merlinwwu/voltra-i-ref-3d/downloads/interference_report.md

# VOLTRA I 独立参考设计 — 干涉 / 运动 / 强度校核报告（CAD-v03，DOC-VER-05）

> 独立参考设计，非原厂数据；尺寸未经实测。设计载荷 F = 785 N（80 kgf），R = 25 mm，T = 19.62 N·m。

## 1. 静态干涉（网格预筛 + BRep 布尔求交）

- 零件 93，包围盒相交对 413，命中 0，其中意外 **0**。
- 螺钉杆部按底孔径建模，螺纹不计干涉；螺旋件（卷筒、绳、蜗杆）只做网格级，阈值 5 mm³。

## 2. 运动包络（摆座 + 导线臂 + 蜗轮扇形绕摆轴旋转；卷筒转角）

- 工况：摆座 θ=-41.9°、摆座 θ=-30.0°、摆座 θ=-15.0°、摆座 θ=+0.0°、摆座 θ=+15.0°、摆座 θ=+30.0°、摆座 θ=+41.9°、摆座越程 θ=-44.4°（限位触发后 1°）、摆座越程 θ=+44.4°（限位触发后 1°）、卷筒转角 60°、卷筒转角 120°、卷筒转角 180°、卷筒转角 240°、卷筒转角 300°
- 接触 2 处，意外 **0** 处。
  - 摆座越程 θ=-44.4°（限位触发后 1°）：EXIT-SWV-01 / LW-LIMIT-01 0.73 mm³ — 限位凸块压入开关（触发后再越程 1°，开关模型为含杠杆的包络）
  - 摆座越程 θ=+44.4°（限位触发后 1°）：EXIT-SWV-01 / LW-LIMIT-01 0.73 mm³ — 限位凸块压入开关（触发后再越程 1°，开关模型为含杠杆的包络）

## 3. 摆动排线运动学（lw_swing.json）

- 卷筒 R25，槽距 3.2，21 圈；工作 16.55 圈；摆轴 XO -2.82 / YO 46；臂长 Rs 38.98
- 传动 z35→z24（惰轮）→z21，i = 1.6667；蜗杆 m0.8 z1=1 d1=16（q=20）左旋，λ 2.862°；蜗轮 z120，a = 56；卷筒每转 5.000°；θ ±41.38°
- 同步误差最大 0.716 mm；偏角名义 1.15°，最坏 1.69°（恒定传动比下的正弦误差，不随行程累积；最坏值含对轮/绳间隙 0.3 mm）

| 卷筒圈 | 蜗杆圈 | θ (°) | 对轮 x | 槽 x | 误差 mm | 偏角 ° | 最坏 ° |
|---|---|---|---|---|---|---|---|
| 0 | 0.0 | -41.38 | -28.58 | -29.3 | 0.716 | 1.147 | 1.627 |
| 1 | 1.667 | -36.38 | -25.94 | -26.1 | 0.163 | 0.278 | 0.789 |
| 2 | 3.333 | -31.38 | -23.11 | -22.9 | -0.214 | 0.386 | 0.928 |
| 3 | 5.0 | -26.38 | -20.14 | -19.7 | -0.436 | 0.831 | 1.402 |
| 4 | 6.667 | -21.38 | -17.03 | -16.5 | -0.527 | 1.052 | 1.65 |
| 5 | 8.333 | -16.38 | -13.81 | -13.3 | -0.509 | 1.057 | 1.68 |
| 6 | 10.0 | -11.38 | -10.51 | -10.1 | -0.408 | 0.873 | 1.514 |
| 7 | 11.667 | -6.38 | -7.15 | -6.9 | -0.248 | 0.542 | 1.196 |
| 8 | 13.333 | -1.38 | -3.76 | -3.7 | -0.056 | 0.122 | 0.783 |
| 9 | 15.0 | 3.62 | -0.36 | -0.5 | 0.144 | 0.317 | 0.975 |
| 10 | 16.667 | 8.62 | 3.02 | 2.7 | 0.325 | 0.705 | 1.354 |
| 11 | 18.333 | 13.62 | 6.36 | 5.9 | 0.462 | 0.977 | 1.61 |
| 12 | 20.0 | 18.62 | 9.63 | 9.1 | 0.529 | 1.08 | 1.692 |
| 13 | 21.667 | 23.62 | 12.80 | 12.3 | 0.501 | 0.98 | 1.567 |
| 14 | 23.333 | 28.62 | 15.85 | 15.5 | 0.354 | 0.66 | 1.218 |
| 15 | 25.0 | 33.62 | 18.77 | 18.7 | 0.066 | 0.116 | 0.644 |
| 16 | 26.667 | 38.62 | 21.51 | 21.9 | -0.387 | 0.643 | 1.14 |
| 16.552 | 27.587 | 41.38 | 22.95 | 23.667 | -0.716 | 1.147 | 1.627 |

## 4. 强度 / 寿命 / 公差（strength.json）

FAIL = 0

| 组 | 项目 | 值 | 单位 | 许用 / 要求 | 结论 |
|---|---|---|---|---|---|
| 使用谱 | 卷筒平均转速 | 191.0 | rpm |  | — |
| 使用谱 | 10 年运动小时 | 1825.0 | h |  | — |
| 使用谱 | 10 年卷筒转数需求 | 20.913 | ×10⁶ 转 |  | — |
| 轴承 | BRG-01 最大径向力（出绳点 x=22.1） | 544.6 | N |  | — |
| 轴承 | BRG-03 最大径向力（出绳点 x=-30.9） | 624.7 | N |  | — |
| 轴承 | BRG-01 静载安全系数 s0 | 5.968 | - | ≥ 2 | ✅ |
| 轴承 | BRG-01 L10（P = 0.5·R01） | 12800.8 | ×10⁶ 转 | 需求 21×10⁶ | ✅ |
| 轴承 | 摆座下 6201 径向 Fr / 轴向 Fa=F | 847.2 | N |  | — |
| 轴承 | 摆座下 6201 s0 = C0/P0（C0 3.1 kN 按样本核对） | 3.441 | - | ≥ 2（摆动低速） | ✅ |
| 轴承 | 摆座上 6201 径向 Fr | 1529.9 | N |  | — |
| 轴承 | 摆座上 6201 s0 | 2.026 | - | ≥ 2 | ✅ |
| 轴承 | 蜗杆 626（固定端）轴向 Fa = Ft2 | 421.4 | N | ≤ 0.5·C0 = 475 | ✅ |
| 轴承 | 蜗杆 626 s0 = C0/(0.5·Fa)（C0 0.95 kN 按样本核对） | 4.509 | - | ≥ 2 | ✅ |
| 轴承 | 蜗杆 HK0608（浮动端）径向 | 103.6 | N | C0≈2.3 kN（按样本核对） | ✅ |
| 轴承 | 导向对轮 HK0608 径向 2F·sin(θm/2)；s0 | 4.146 | - | ≥ 1.5 | ✅ |
| 轴承 | 中心转向轮 HK0608 径向 √2·F；s0 | 2.072 | - | ≥ 1.5 | ✅ |
| 卷筒 | 单层缠绕接触压力 p = F/(R·p) | 9.812 | MPa |  | — |
| 卷筒 | 筒壁切向压应力（厚壁筒，Ø47/Ø36） | 47.483 | MPa | 6061-T6 σ0.2 240 → [σ] 120 | ✅ |
| 卷筒 | 卷筒弯曲应力（Ø47/Ø36） | 2.7 | MPa | < 80 | ✅ |
| 卷筒 | 锚固点残余张力 F·e^(−μ·2π·3)（μ=0.1） | 119.2 | N | 压线块 M3 预紧 ~2.6 kN × μ0.2 × 2 面 | ✅ |
| 轴 | MOT-SHAFT-01 花键根部等效应力 | 65.082 | MPa | 42CrMo4 调质 [σ]疲劳 120 | ✅ |
| 轴 | DIN 5480 W17×1.25×12 齿面压强（l 25，ψ 0.75） | 9.924 | MPa | [p] 30 | ✅ |
| 轴 | PIN-DRUM-01 剪切（4×Ø3，PCD32，全扭矩） | 43.381 | MPa | [τ] 80 | ✅ |
| 轴 | 转子毂 6×M4 摩擦传扭能力 | 64.26 | N·m | ≥ MF0095056 峰值 51 | ✅ |
| 排线 | 蜗杆导程角 λ（m0.8 z1 d1 16） | 2.862 | ° | < φ' 3.046°（μ0.05） | ✅ |
| 排线 | 静止自锁（μs ≥ 0.08）反驱效率 | -0.7 | - | < 0 自锁 | ✅ |
| 排线 | 蜗轮最大扭矩 T2（θ=θm，F 满载） | 20.228 | N·m |  | — |
| 排线 | 蜗轮齿根剪应力 τF ≈ Ft2/(b2·m)·0.75（DIN 3996 简化） | 39.507 | MPa | CuSn12 τFlim 92 / SF 1.5 = 61 | ✅ |
| 排线 | 蜗轮齿面 σHm（p*m=1，E_red 147 GPa） | 165.7 | MPa | CuSn12 σHlim 425 / SF 1.3 = 327 | ✅ |
| 排线 | 蜗杆驱动扭矩 | 0.349 | N·m |  | — |
| 排线 | 卷筒附加阻力矩（占 T） | 2.963 | % | < 8% | ✅ |
| 排线 | 正齿 m0.8 z35 Lewis（b4，Ft 42 N） | 35.078 | MPa | 40Cr 调质 [σF] 200 | ✅ |
| 排线 | 正齿 m0.8 z24 Lewis（b4，Ft 42 N） | 38.173 | MPa | 40Cr 调质 [σF] 200 | ✅ |
| 排线 | 正齿 m0.8 z21 Lewis（b4，Ft 42 N） | 39.33 | MPa | 40Cr 调质 [σF] 200 | ✅ |
| 排线 | 蜗杆挠度（等效 Ø10，跨 59.8） | 0.006 | mm | ≤ 0.01·m = 0.008 | ✅ |
| 排线 | 惰轮烧结铜套 pv（Ø5×4，1.2 kW 转速） | 0.926 | MPa·m/s | ≤ 1.8 | ✅ |
| 排线 | PIN-LWG-01 Ø1.5 弹性销双剪 | 34.635 | MPa | [τ] 300 | ✅ |
| 排线 | 同步误差（全行程最大） | 0.716 | mm | < 1.0 | ✅ |
| 排线 | 偏角（名义 / 最坏含 0.3 间隙） | 1.693 | ° | ≤ 2° | ✅ |
| 出线 | EXIT-PIN-01 Ø12 悬臂根部弯曲 | 115.9 | MPa | 42CrMo4 调质 [σ] 250 | ✅ |
| 出线 | LW-BRIDGE-01 7075 20×12 等效应力（外拉 F + 力矩） | 64.635 | MPa | 7075-T6 [σ] 150 | ✅ |
| 出线 | 桥架 Z 向挠度 | 0.079 | mm | < 0.2 | ✅ |
| 出线 | 蜗杆副中心距受载变化（桥架 + 销） | 0.036 | mm | < 侧隙 0.08 | ✅ |
| 出线 | LW-PIN-01 Ø6 悬臂弯曲（臂 4.5，2F·sin(θ/2)） | 117.7 | MPa | GCr15 淬硬 [σ] 400 | ✅ |
| 出线 | EXIT-AXL-01 Ø6 弯曲（跨 11.5，√2F） | 150.5 | MPa | GCr15 淬硬 [σ] 400 | ✅ |
| 出线 | 摆座毂底挡肩剪切（Ø27×0.8，外拉 F） | 11.568 | MPa | 7075-T6 [τ] 120 | ✅ |
| 出线 | 桥架 M4 ×2 + 销 单颗拉力（外拉 F 分配 0.6） | 471.0 | N | M4 10.9 保证载荷 7.8 kN | ✅ |
| 出线 | 蜗杆箱 2×M3 剪力（Ft2 轴向） | 210.7 | N | M3 8.8 + 定位销 | ✅ |
| 绳 | 卷筒 D/d | 16.667 | - |  | — |
| 绳 | 导向对轮 D/d | 4.333 | - |  | — |
| 绳 | 中心转向轮 D/d | 4.867 | - |  | — |
| 绳 | 安全系数（MBL 9 kN 典型 × 0.65 / F） | 7.452 | - | ≥ 5 | ✅ |
| 电机 | T = F·r（+20% 余量） | 23.55 | N·m | MF0095056 峰值降额 38.25 | ✅ |
| 电机 | 满力电流 / 铜损 | 57.721 | A |  | — |
| 电机 | 绕组温度（严格口径） | 98.292 | °C | ≤ 130（F 级降额） | ✅ |
| 电机 | 1 m/s / 1.2 kW 转速 | 382.0 | rpm |  | — |
| 公差 | 蜗杆副中心距 56 链（框架/MOT-HSG 销定位 ±0.02×2 + 桥架 ±0.02 + 箱 ±0.01） | 0.07 | mm | RSS ≈ 0.035；装配后测侧隙 0.05–0.12 | ✅ |
| 公差 | 卷筒+轴热伸长（ΔT 40 K） | 0.099 | mm | BRG-03 浮动 −1/+0.5 | ✅ |
