merlinwwu/voltra-i-ref-3d/downloads/docs/gap-list.md

# VOLTRA I 参考设计 CAD-v03 —— 可加工 / 可装配 / 可工作 缺口清单（gap-list）

版本：DOC-VER-05 / CAD-v03 · 2026-10-20（Asia/Shanghai）
用户决定更新：2026-10-23 · D2–D8 全收 A（见 §0）

状态说明：✅ 已在 v03 中解决 · ◐ 已按假设值处理，需要实测或供应商数据确认 · ⛔ 需要用户决定

数据来源：
- `site/downloads/strength.json`：58 项校核，FAIL 0；
- `out/interference.json`：93 个零件，包围盒相交 413 对，干涉 0（齿轮啮合、花键等设计接触都低于网格阈值）；
- `out/motion_check.json`：14 个工况（摆座 ±41.9°/±30°/±15°/0°、越程 ±44.4°、卷筒 5 个转角），接触 2 处（都是越程 1° 后压入限位开关，属预期），意外 0；
- `out/lw_swing.json`（摆动排线运动学）、`out/motor_check.json`（电机复核）、`docs/patent-review.md`。

标"假设"的数值都没有经过实测，不是原厂数据。v02 版本备份：`gap-list_v02.md`。

## §0 用户决定（D）和未知项（U）

| # | 事项 | 现状（v03） | 选项 / 状态 |
|---|---|---|---|
| **D1** | 排线方式 | ✅ **已定（用户，2026-10-20）**：自锁蜗杆 + 摆动蜗轮扇形，按 CN122233236A 摆动式。用户的理由是出线口到卷筒接触点的距离基本不变。卷筒 R20 → **R25** 单层，撤回滑动小车和 Tr10×2 丝杠。 | 已关闭 |
| **D2** | 出线罩凸出包络 4.5 mm | ✅ **已定（用户，2026-10-23）**：接受凸出 4.5 mm（EXIT-UNI-01 Ø23 罩环 + 喇叭口） | 已关闭 · A |
| **D3** | 机外出绳 | ✅ **已定（用户，2026-10-23）**：保持固定抛光不锈钢喇叭口 | 已关闭 · A |
| **D4** | 断电抱死 | ✅ **已定（用户，2026-10-23）**：不加失电制动器；蜗杆自锁只锁摆座，不锁卷筒 | 已关闭 · A |
| **D5** | 角度传感 | ✅ **已定（用户，2026-10-23）**：卷筒磁编码（单圈绝对 + 软件多圈）；摆座磁环 + 霍尔作冗余 | 已关闭 · A |
| **D6** | 电池电流 | ✅ **已定（用户，2026-10-23）**：按 1.2 kW / 每组 ≤ 60 s；1.2 kW 时约 46.7 A，BAT-CONN ≥ 50 A | 已关闭 · A |
| **D7** | 卷筒半径和电机组合 | ✅ **已定（用户，2026-10-23）**：保持 R25 + MF0095056（偏角最坏 1.69°，严格口径 98 °C；已建模）。不采用 R23 + 044 | 已关闭 · A |
| **D8** | 运行中的自锁 | ✅ **已定（用户，2026-10-23）**：接受 μ ≥ 0.05 自锁条件（λ 2.86°）；不因跑合后 μ 可能下降而改 d1 | 已关闭 · A |
| 转向轮 Ø26 | 中心转向轮 D/d 4.9 | 槽底 Ø14.6，**暂按现状** | ⛔ 待定：加大到 Ø26 时 D/d 为 8.7，摆座叉板要加大约 6 mm（v02 估算），与 D2 联动 |
| **U1** | 未公开的 US 19/xxx 申请 | 无法审查 | 公开后补审 |
| **U2** | 供应商数据 | 绳 MBL 9 kN 是典型值；HK0608 / 626 / 6201 的 C0 需按样本核对；MOD-UNK-01 的功能和尺寸未知（v03 为桥架让位，暂减薄到 z −31..−11） | 拿到样本后重新计算 |
| **U3** | Dock 立柱几何 | 假设值 | 需要实测 |
| **U4（新）** | 霍尔 IC 和微动开关型号 | LW-HALL-01、LW-LIMIT-01 都是占位 | 需要选型（超小型微动开关，行程 ≥ 1 mm） |

## §1 材料、工艺、配合、形位公差、粗糙度 ✅
- 自制件都有 A3 图纸：`site/downloads/drawings/<ID>.pdf/.dxf`，合订本 `VOLTRA-I-REF_工程图_合订_CAD-v03.pdf`（40 张）。v03 新增或重画的图：LW-WORM-01、LW-WHEEL-01、LW-ARM-01、LW-BOX-01、LW-BRIDGE-01、EXIT-SWV-01、EXIT-PIN-01、LW-GEAR-01、LW-IDL-01、LW-IDL-PIN-01、LW-ROL-01、LW-PIN-01、EXIT-SHV-01、EXIT-AXL-01、LW-SPC-01、EXIT-BASE-01、EXIT-GUIDE-01、EXIT-UNI-01、DRUM-01、DRUM-HUB-01、MOT-HSG-01。
- 新增主要配合（设计值）：

| 位置 | 配合 |
|---|---|
| 蜗杆副 | m0.8 z1/z120（扇形 ±47°），a = 56 ±0.03，8 级（DIN 3974），侧隙 0.05–0.12 |
| 蜗杆轴颈 | 左端 Ø6 h5（HK0608，淬硬 ≥ 58 HRC）；右端 Ø6 k5（626） |
| 626 座 | Ø19 通孔 H7，两侧 DIN 472-19 |
| 摆轴销 | Ø12 p6（桥架）/ k5（2×6201） |
| 摆座毂 | Ø32 K6，底部挡肩 Ø27 |
| 对轮销 | Ø6 p6（臂）/ h5（滚针） |
| 惰轮 | 销 Ø5 p6 压入电机壳；衬套 Ø5 F7 / Ø8 s7 |

- 材料：
  - 蜗杆：20CrMnTi 渗碳淬火 58–62 HRC，齿面磨削；
  - 蜗轮扇形：CuSn12；
  - 摆座 / 导线臂 / 桥架：7075-T6；
  - 蜗杆箱：6061-T6，两轴承孔一次装夹加工；
  - 对轮：440C；
  - 其余同 v02。

## §2 紧固件 ✅
v02 的条目保留（M5 中心螺钉、转子毂 6×M4、贯穿螺栓、BRG-03-HSG、底板、左端盖、压线块），v03 新增：

| 部位 | 规格 | 扭矩 | 备注 |
|---|---|---|---|
| 蜗杆箱 · 隔板侧 | 2×M3×12 ISO 10642 + Ø3 销 | 1.1 N·m | 旋合 6 |
| 蜗杆箱 · 电机壳侧 | 2×M3×8 ISO 4762 + 243 胶 | 1.1 N·m | ◐ 电机壳端壁 4 mm，钢丝螺套需要局部凸台 4.5 |
| 导线臂 → 摆座 | 4×M3 ISO 10642 + 243 胶 | 1.2 N·m | — |
| 蜗轮扇形 → 导线臂 | 4×M3×6 ISO 10642 + 243 胶 | 1.0 N·m | 钢丝螺套 |
| 桥架 | M4×14 + Ø3 销 / Ø6 止口销 | 2.6 N·m | 外拉 F 分配后单颗约 471 N ≪ 7.8 kN |
| 齿轮横销 | Ø1.5×10 ISO 8752 | — | τ 35 MPa |

清单见 `BOM_VOLTRA-I-REF_CAD-v03.csv`。

## §3 挡圈和密封 ✅
v03 新增的挡圈：
- DIN 472-19 ×2：626 外圈两侧；
- DIN 471-6：z21 齿轮；
- DIN 471-12：摆轴销顶；
- DIN 6799：对轮销和转向轮轴。

撤回的挡圈：丝杠 6000 的 472-26 / 471-10，以及 61804 的 471-20 / 472-32。密封同 v02。

## §4 绳路 ◐
- 绳路：卷筒顶点 z = R = 25 → 沿 +Y 进入两只导向对轮（Ø13，间隙 3.3）→ 在内侧对轮上转过 θ → 沿导线臂到中心转向轮（槽底 Ø14.6）→ 转 90° 沿摆轴上行 → 喇叭口 → 绳头。
- 出线口到卷筒接触点的距离基本不变：摆座绕出线口轴线转动。
- D/d：
  - 卷筒 16.7（v02 为 13.3）；
  - 导向对轮 4.3：包角 ≤ θ，最大 41°，满载径向 555 N；
  - 中心转向轮 4.9：包角 90°，满载。
  - 结论：能工作，但中心转向轮是主要疲劳点，绳定为可换件。可选项见 §0 的"转向轮 Ø26"。
- 喇叭口：喉部 Ø5，出口 R ≥ 6，Ra0.1。

## §5 排线同步、自锁、端部 ✅
- 运动链：卷筒 1 转 → z35 → z24（惰轮）→ z21 → 蜗杆 1.667 转 → 蜗轮 z120 → 摆角 5.000° → 对轮横向位置 x = XO + Rs·sin θ（Rs 38.98）。
- 行程：16.55 个工作圈，θ 从 −41.38° 到 +41.38°。全放出对应 −41.4°，全收绳对应 +41.4°。
- 同步误差：全行程最大 0.716 mm，为正弦误差，不累积。偏角名义 1.15°，最坏 1.69°（含 0.3 mm 间隙），满足 ≤ 2°。
- 自锁：λ 2.862° < φ'（μ0.05 时 3.046°），正向效率 0.48，静止时反驱效率 < 0。运行中的风险见 D8。
- 端部：
  - 两只限位开关在 ±43.4° 触发（工作 ±41.4°）；
  - 软件按卷筒编码器和霍尔摆角做双重限位；
  - 绳的两端（全收和全放）本身就限定了卷筒转角，所以正常情况下摆座不会超程。
- 侧隙和中心距：a = 56 由隔板、电机壳和桥架的销定位链保证，RSS 约 ±0.035。满载时桥架和摆轴销变形会让中心距变化约 0.036 mm，小于侧隙 0.08。

## §6 绳端锚固 ✅
同 v02。3 圈死圈，锚固点张力 119 N。

## §7 装配顺序和工具通道 ✅
详见 `docs/assembly-sequence.md`（v03）。要点：
- 惰轮销要在卷筒之前压入；
- 卷筒推入花键时，z35 沿轴向进入和惰轮的啮合；
- 定相：全放出 ↔ θ = −41.4°，蜗杆箱最后沿 −Z 落入，惰轮相位误差 ≤ 0.07°；
- 装好后测侧隙。

## §8 布线和散热 ◐
- 新增 LW-HALL-01 和 2×LW-LIMIT-01 的线束，沿桥架下表面走到 PCB 仓。
- 电机改为 MF0095056（叠长 55.2）后，铜损从 1744 W 降到 1070 W（满力），RMS 绕组温升按严格口径为 98 °C。
- 其余同 v02。◐ 没有做 CFD。

## §9 制动电阻、电池 Dock、把手和绳头 ◐
同 v02。

## §10 壳体分型和拔模 ✅
同 v02。v03 增加两处让位：
- 上下壳前壁内侧，626 座处有 R11.6 局部沉台，深 0.9；
- 电机壳端面有 Ø11 深 1.6 的蜗杆轴端沉孔。

## §11 公差链 ✅
- 卷筒挡边间隙、热伸长：同 v02。
- 蜗杆副中心距链：见 §5。
- 摆角定相：惰轮相位误差最多半齿，对应 ≤ 0.07°。

## §12 寿命和强度（摘自 strength.json）✅

| 项 | 结果 | 许用 / 要求 |
|---|---|---|
| BRG-01 | s0 5.97 | — |
| 摆座下 6201 | s0 3.44 | — |
| 摆座上 6201 | s0 2.03 | ≥ 2 |
| 626 | 轴向 421 N，s0 4.5 | — |
| 导向对轮 HK0608 | s0 4.1 | ◐ C0 待按样本核对 |
| 中心转向轮 HK0608 | s0 2.07 | ◐ C0 待按样本核对 |
| 蜗轮齿根 τF | 39.5 MPa | 61 |
| 蜗轮齿面 σHm | 166 MPa | 327 |
| 正齿轮 Lewis 应力 | 35–39 MPa | 200 |
| 蜗杆挠度 | 0.006 mm | 0.008 |
| 惰轮衬套 pv | 0.93 | 1.8 |
| 摆轴销 Ø12 | 116 MPa | 250 |
| 桥架 | 65 MPa | 150 |
| 桥架挠度 | 0.079 mm | — |
| 对轮销 | 118 MPa | — |
| 转向轮轴 | 151 MPa | 400 |
| 花键 | 9.9 MPa | — |
| 轴 | 65 MPa | — |
| 传扭销 Ø3 | 43 MPa | 80 |
| 卷筒筒壁 | 47 MPa | 120 |
| 绳 | SF 7.45 | ◐ MBL 待供应商确认 |
| 电机 MF0095056 | 23.55 N·m（+20%） | 峰值降额 38.25 |

## §13 质量
- 整机 6.41 kg，不含绳头；官方为 5.8 kg；v02 为 6.02 kg。
- 增加的部分：
  - 电机 044 → 056：+0.39 kg；
  - 卷筒加大到 R25；
  - 蜗杆箱、摆座、6201、蜗轮扇形等。
- 减重方向：
  - MOT-HSG 和 HSG-END-R 改为压铸，约 −0.2 kg；
  - 蜗轮扇形腹板进一步开窗；
  - D7-B（R23 + 044，约 −0.4 kg）已于 2026-10-23 否决，不采用。

## §14 v03 相对 v02 的修改
1. 排线：滑动小车 → 自锁蜗杆 + 摆动蜗轮扇形（D1）。删除 LW-SCREW / LW-NUT / LW-CAR / LW-ROD / LW-END-L 等零件，新增 LW-WORM / LW-WHEEL / LW-ARM / LW-BOX / LW-IDL / LW-HALL / LW-MAG 等。
2. 卷筒 R20 → R25，21 圈；传扭销 Ø4 → Ø3（PCD32，避让惰轮销头）。
3. 电机 MF0095044 → MF0095056（叠长 43.2 → 55.2），MOT-HSG 绕组腔加长。
4. 摆座：v02 的 61804 + 6000（经底板支承）改为桥架上的悬臂摆轴销 + 2×6201 紧贴。外拉力 F 不再经过底板。
5. 改为 6201：起初用的 2×6001 跨距只有 9，s0 只有 1.4，不满足。
6. 惰轮 z24：原本蜗杆轴齿轮会顶到前壁，所以加惰轮，并保证 z21 ≤ 21。
7. 蜗杆 d1 13 → 16：把自锁门槛从 μ 0.058 降到 μ 0.05。
8. 贯穿螺栓 (30, 40) → (57, 40)，为蜗轮扫掠让位。
9. 限位凸块改朝卷筒侧，桥架局部加宽，避开壳体内壁。
10. 壳体和电机壳增加局部让位（§10）。
11. 蜗轮扇形原来按实心扇形建模（165 g），改为齿圈 + 腹板 + 减重窗（约 47 g）。
12. 运动包络检查发现扇形扫到底板螺钉凸台：扇形 ±50° 改为 ±47°（在 ±43.4° 限位处，啮合区仍有约 1 齿余量），上面两颗底板螺钉外移到 (−52.5, 51) / (35.5, 51)。
13. 工程图：改用紧包围盒，修正非回转件高度尺寸显示错误（v02 图上非回转件的高度尺寸数值错误，例如 DOCK-HOOK-01 高 8 显示成 4000），所有图纸已重出。
