merlinwwu/voltra-i-ref-3d/downloads/docs/patent-review.md

# VOLTRA I 参考设计 · 相关专利逐份审查（DOC-VER-05 附件 A）

- 日期：2026-10-20（Asia/Shanghai）
- 范围：Google Patents 上申请人「深圳市齐昕动力科技有限公司 / Beyond Power」的公开文献，共 59 份（PDF/HTML 原文：`/workspace/pat/`；清洗后的全文：`docs/pattxt/*.txt`）。另查到 1 份 EP 分案，以及官网列出、但尚未公开的 US 申请（见 §3）。
- 证据优先级：拆机照片 > 官方规格 > 专利。专利只说明"原厂可能这样做"，不代表 VOLTRA I 量产件就是这样。
- 附图号、部件标号都取自专利说明书。本文不编造段落号：凡是没有核实到段落号的，只写「图 x / 部件 y」。
- "对照"一栏是和本参考设计 CAD-v03 的比较。✅ 表示已采纳或一致，◐ 表示部分采纳或有偏离，✖ 表示不采用（说明原因），— 表示与机械设计无关。

## 1. 机械相关专利：详细审查

### 1.1 排线（level-wind）—— CN220223097U（授权）、CN118529559A（待审）及其分案 CN122166625A / CN122233236A

| 项 | 内容 |
|---|---|
| 专利 | CN220223097U《排线绕线机构及出力设备》，公告日 2023-12-22，有效；CN118529559A 发明申请，公开日 2024-08-23，待审；分案 CN122166625A（滑动式，2026-06-09）、CN122233236A（摆动式，2026-06-19） |
| 子系统 | CAB / LW / EXIT |
| 关键机构 | **两种实施例。** 注：查原文权利要求，CN122166625A 的权利要求 1–9 要求的是滑座 + 光轴 + 自锁蜗杆（滑动式），CN122233236A 才是摆动式。v03 的摆动排线按 CN122233236A 设计，CN122166625A 中的「转动座 + 转向轮 + 沿转轴穿线通道」用于摆座内部。 ① 摆动式：摆座绕出线口摆动，带出线臂，用自锁蜗轮 510 + 蜗杆 530 驱动，摆角由霍尔/磁环检测，限位微动开关 102，出线处有导向对轮。CN122233236A 权利要求 2–5 写到：两根臂沿径向向外伸出，两臂间设导轮，并有限位框和对轮。② 滑动式（图 6–8）：滑座 321 在光轴 322 上经直线轴承 323 滑动，由自锁蜗杆螺母 520 驱动，滑座上有转动座 326 和转向轮 328/329，出线轮 710（其中一只带阻尼）。CN122166625A 的权利要求写到"转动座 + 第一/第二转向轮"。**同步关系：卷筒每转一圈，排线移动一个绳径。** |
| 对照（v03） | ✅ **采用摆动式（用户决定 D1，2026-10-20）**。用户的理由：摆动式的出线口到卷筒接触点的距离基本不变。对应关系如下：<br>• 摆座 EXIT-SWV-01 = 绕出线口轴线转动的摆座；导线臂 LW-ARM-01 + 导向对轮 LW-ROL-01 ×2 = 权利要求 2–5 的"臂 + 两臂间导轮 / 对轮"；<br>• 自锁蜗杆 LW-WORM-01（m0.8 z1 d1 16 左旋，λ 2.86°）= 蜗杆 530，蜗轮扇形 LW-WHEEL-01（CuSn12 z2 120，±47°）= 蜗轮 510，与摆座同心；<br>• 摆角检测用磁环 LW-MAG-01 + 线性霍尔板 LW-HALL-01；限位微动开关 LW-LIMIT-01 ×2 = 102；<br>• 绳经中心转向轮 EXIT-SHV-01 转 90° 后沿摆轴从出线口引出，所以出线口与卷筒的相对位置不随摆动变化。<br>**驱动链**：卷筒毂齿轮 z35 → 惰轮 z24 → 蜗杆轴齿轮 z21（i = 5/3）→ 蜗杆 → 蜗轮 z120。卷筒每转一圈，摆角变化 360°×(5/3)/120 = **5.000°**。<br>**行程**：卷筒 R25 单层缠绕，槽距 3.2，21 圈（16.55 个工作圈 + 3 圈死圈 + 余量），绳在卷筒上的轴向行程 53 mm。摆臂 Rs = 38.98，摆角 ±41.38°。<br>• 横向位置 x = XO + Rs·sin θ，是正弦关系，而绳槽是线性的，所以同步误差为正弦误差，**不随行程累积**：全行程最大 0.72 mm，偏角名义 1.15°，最坏 1.69°（计入 0.3 mm 对轮间隙）。<br>• ◐ 专利写"每转 1 个绳径"，本设计取 1.07d（3.2 mm）。<br>**为什么卷筒 R 从 20 加到 25**：在 139×100 截面内，摆轴位置 YO 受壳体内壁和卷筒挡边限制。扫描 R = 20–27（`cad/lw_swing.py`），最坏偏角分别为：R20 不可行，R21 2.36°，R22 2.14°，R23 1.97°，R24 1.80°，R25 1.68°，R26 1.57°，R27 在 YO 允许范围内不可行。R23 是 ≤2° 的最小值，但没有余量，所以取 **R25**。v02 的结论"摆动式不可行"是在 R20 单层前提下得出的，现在已不成立。<br>**自锁**：λ 2.862° < φ'（μ0.05 时 3.046°），所以 μ ≥ 0.05 时能自锁。静止时 μs ≈ 0.08–0.10，反驱效率 −0.70 ~ −1.12，能可靠自锁。◐ 运行中如果跑合良好、μ 降到 0.03，就不再自锁（反驱效率 +0.36）。这不影响同步，因为同步靠齿轮正传动，不依赖自锁。<br>**载荷**：满载时 T2 = 20.2 N·m，Ft2 = 421 N，蜗杆扭矩 0.35 N·m，卷筒附加阻力 2.96%。蜗轮齿根 τF 39.5 MPa（许用 61），齿面 σHm 166 MPa（许用 327）。 |
| 结论 | **摆动式可加工、可装配、可工作**，校核见 `strength.json`（FAIL 0）、`interference.json`、`motion_check.json`。代价：<br>• 卷筒加大到 R25 后扭矩增加 25%，电机从 MF0095044 改为 MF0095056（见设计文档 §4）；<br>• 整机变重，质量见 gap-list §13；<br>• 照片 01/02 中的"黑色摆环 + 白色蜗轮扇形"与本方案一致。 |

### 1.2 万向出线 —— CN220213802U（授权）

| 项 | 内容 |
|---|---|
| 专利 | CN220213802U《万向出线机构及出力设备》，公告日 2023-12-22，有效 |
| 子系统 | EXIT |
| 关键机构 | 底座 + 经轴承转动的旋转座 + 成对出线轮 + 条形抛光金属导线块（喇叭状张开），出线方向可以随拉绳方向转动。 |
| 对照 | ◐ 机内部分：旋转座 = EXIT-SWV-01。v03 中它同时是排线摆座：2×6201 紧贴装在桥架摆轴销 Ø12 上，绳在座内经中心转向轮 90° 转向后沿转轴引出。已采纳。◐ 机外部分：用整圈抛光不锈钢喇叭口 EXIT-GUIDE-01（R ≥ 6，Ra0.1）代替"旋转对轮 + 导线块"。原因：前板厚度和包络里放不下第二套旋转轴承。代价是侧拉时绳在喇叭口上滑动，磨损更大，所以把绳定为可换件（官方本来就支持换绳）。可以升级为专利式结构，见 D3。 |
| 结论 | 可工作；出线罩比包络凸出 4.5 mm（照片 05 中原机的白罩也是凸出的），见 D2。 |

### 1.3 卷筒散热结构 —— CN220327890U（授权）

| 项 | 内容 |
|---|---|
| 关键机构 | 绕线轮 = 塑料内芯 + 导热更高的金属外壳；两者用轴向筋/槽传扭；内芯与外壳之间留散热通道。 |
| 对照 | ◐ 本设计的卷筒整体用 6061-T6 铝，并做硬质阳极。理由：单层缠绕时箍压应力约 45 MPa，塑料内芯会蠕变。卷筒中段做了 Ø26 减重孔，可兼作风道。没有采用双材料结构，因为零件更少、同轴度更容易保证。 |
| 结论 | 一致性：部分一致。可加工（车削 + 螺纹车槽，或旋风铣槽）。 |

### 1.4 绳端锚固 —— CN220596688U（授权）、CN220906831U（授权）

| 项 | 内容 |
|---|---|
| CN220596688U | 卷筒端部设固线位，压线块装在里面；压线块有弧形压槽和交错压齿，用螺钉锁紧。 |
| CN220906831U | 弧形绕线盘上开多个穿线孔/通道，供绳端编织穿插，外加保护盖。 |
| 对照 | ✅ 左挡边外侧开 10×13.5×4.5 凹槽；绳经 Ø3.4 轴向孔从槽底进入凹槽，由 DRUM-CLAMP-01 压线块 + M3 沉头螺钉压紧。另留 3 圈死圈：按绞盘公式 e^(−μθ)，μ = 0.1、θ = 6π，锚固点只受约 15% 的绳力，约 120 N。✖ 编织穿孔方案（CN220906831U）没有采用，因为它更适合大直径盘。 |
| 结论 | 可加工、可装配（换绳时取下电池仓盖，从卷筒仓前窗口就能拧到压线块螺钉）。 |

### 1.5 绳头挂钩 —— CN220668264U（授权）

| 关键机构 | 绳钩绕线架带卡口，绳绕上后卡住，外有壳体。 |
|---|---|
| 对照 | ✅ CONN-01：Ø36 绕线架 + 4 个卡口 + 挂环（示意）。官方外形量级约 40.9×40.9×62。 |

### 1.6 制动电阻 —— CN220530583U（授权）

| 关键机构 | 电阻板经导热垫贴在壳板上，带温度传感器和快插接头。 |
|---|---|
| 对照 | ✅ BRK-R-01 经 1 mm 导热垫 BRK-PAD-01 贴在下壳底壁，2×M4 螺钉固定在底壁加厚凸台上；NTC 为 BRK-TEMP-01。阻值和功率在设计文档中按 60 V 母线计算。 |

### 1.7 电机 / 传感 / 连接排 —— CN222484497U、CN219893049U / CN118539645A / CN122437294A

| 专利 | 内容 | 对照 |
|---|---|---|
| CN222484497U（授权 2025-02-14） | 电感式双转子多圈角度传感器 | ◐ 本设计用磁环 ENC-MAG-01 + 磁编码读头 ENC-PCB-01，单圈绝对；多圈和出绳长度由软件累计并上电回零。可升级，见 D5。 |
| CN219893049U（授权）/ CN118539645A / CN122437294A | 电机连接排（汇流排）把三相引线引到驱动板 | ◐ 本设计用相线 + 硅胶护套 MOT-GROM-01，经电机壳 Ø8 孔进入卷筒仓，再到 PCB。没有做汇流排。是否做汇流排对机械可行性没有影响。 |

### 1.8 整机架构 —— WO2024175034A1 / CN220173005U / CN118539661A / CN122437301A / EP4672567A1（含 EP 分案）

| 项 | 内容 |
|---|---|
| 关键机构 | 线盒居中，电机和电池分别固定在线盒两侧；线盒后侧通过连接结构接基座（Dock），绳从前侧引出；解锁要同时满足电机侧和电池侧两个触发条件；有 PCB 和快插接头。WO 说明书还写到：塑料内芯 + 花键 573、转子环腔内的被动风扇、转子轴上的磁环 570、子电机可串联（花键串轴）、圆柱电芯 + 支撑杆 + 弹性导热垫的电池、电阻结构，以及断电抱死（抱死臂 + 自锁蜗杆）。 |
| 对照 | ✅ 布局一致：电池（左）| 隔板 | 卷筒仓 | 电机（右）；前面出绳，背面 Dock，PCB 在背侧。✅ 转子毂腹板上集成 8 叶被动风扇（ROT-HUB-01）。✅ 磁环在转子轴上。✅ 用花键传扭（DIN 5480）。◐ **没有做断电抱死**。制动由电机短接 + 制动电阻完成；断电时丝杠能自锁，但卷筒不能自锁。见 D4。◐ 串联子电机不适用（单电机）。 |

### 1.9 Dock 接口 —— CN219733908U（授权）/ CN118532387A / CN122407665A

| 关键机构 | 插槽外侧设枢转卡钩，卡入立柱上的限位槽；设备相对立柱转动时，导向斜面把卡钩推开，从而解锁。 |
|---|---|
| 对照 | ✅ DOCK-IF-01：插槽 Ø40 H8。DOCK-HOOK-01：卡钩在 Ø3 销上枢转，扭簧复位，钩舌伸进插槽 1.4 mm。SMART-LOCK-01：执行器占位。法兰 Ø94×4 贴在壳体内壁上承压，785 N 由法兰压壳传递，不靠螺钉受拉。◐ 立柱侧的几何、导向斜面角度、扭簧参数都没有公开数据，列为未知项 U3。 |

### 1.10 电池 / 底板 —— CN220086216U、CN220778963U

| 专利 | 内容 | 对照 |
|---|---|---|
| CN220086216U（授权） | 电池壳卡扣 + 弹性导热垫 | ◐ 电池包按官方外形 94×94×89 做外购定制件，内部结构不建模；接口为 BAT-CONN-01 + 4×M4 沉头端盖。 |
| CN220778963U（授权） | 健身底板 + 快拆底座 | — 属于配件，不在主机 CAD 范围内。 |

## 2. 全部 59 份公开文献：逐份一行结论

| # | 公开号 | 名称（中译） | 公开/公告日 | 状态 | 子系统 | 一行结论 |
|---|---|---|---|---|---|---|
| 1 | CN220223097U | 排线绕线机构及出力设备 | 2023-12-22 | 有效 | LW | ✅ v03 采用摆动式实施例（自锁蜗杆 + 蜗轮 + 摆座）；滑动式为 v02 方案，已撤回 |
| 2 | CN118529559A | 排线绕线机构及出力设备 | 2024-08-23 | 待审 | LW | ✅ 同上，发明申请版 |
| 3 | CN122166625A | 排线绕线机构及出力设备（分案） | 2026-06-09 | 待审 | LW | ✅ 转动座 + 转向轮：v03 用于摆座内的中心转向轮 |
| 4 | CN122233236A | 排线绕线机构及出力设备（分案·摆动式） | 2026-06-19 | 待审 | LW | ✅ v03 采用（D1 已决定）：R25 单层，摆角 ±41.4°，偏角 ≤1.69° |
| 5 | CN220213802U | 万向出线机构及出力设备 | 2023-12-22 | 有效 | EXIT | ◐ 机内旋转座已采纳；机外改为固定喇叭口 → D3 |
| 6 | CN220327890U | 绕线轮及出力设备 | 2024-01-12 | 有效 | CAB | ◐ 金属卷筒导热已采纳；不做塑料内芯 |
| 7 | CN220596688U | 固线绕线轮及出力设备 | 2024-03-15 | 有效 | CAB | ✅ 压线块锚固已采纳 |
| 8 | CN220906831U | 绕线装置及健身设备 | 2024-05-07 | 有效 | CAB | ✖ 编织穿孔方案不用（压线块已足够） |
| 9 | CN220668264U | 绳钩连接结构及绳类健身设备 | 2024-03-26 | 有效 | CAB | ✅ 绳头接头参考 |
| 10 | CN220530583U | 电阻结构、健身设备及固定架 | 2024-02-27 | 有效 | PWR | ✅ 导热垫 + NTC 已采纳 |
| 11 | CN222484497U | 电机及健身设备（电感式多圈角度传感器） | 2025-02-14 | 有效 | MOT/ELEC | ◐ 用磁编码代替 → D5 |
| 12 | CN219893049U | 连接排及电机 | 2023-10-24 | 有效 | MOT | ◐ 用相线代替汇流排，可选 |
| 13 | CN118539645A | 连接排及电机 | 2024-08-23 | 待审 | MOT | ◐ 同上 |
| 14 | CN122437294A | 连接排及电机（分案） | 2026-07-21 | 待审 | MOT | ◐ 同上 |
| 15 | WO2024175034A1 | 出力设备及出力组件（总架构，161 项权利要求） | 2024-08-29 | PCT 已进入国家阶段 | TOP | ✅ 布局、内置风扇、磁环、花键已采纳；◐ 断电抱死未做 → D4 |
| 16 | CN220173005U | 出力设备及出力组件 | 2023-12-12 | 有效 | TOP | ✅ 后侧连 Dock、前侧出绳 |
| 17 | CN118539661A | 出力设备及出力组件 | 2024-08-23 | 待审 | TOP | ✅ 同上 |
| 18 | CN122437301A | 出力设备及出力组件（分案） | 2026-07-21 | 待审 | TOP | ✅ 电机/电池分置线盒两侧 |
| 19 | EP4672567A1 | 出力设备及出力组件（EP） | 2025-12-31 | 待审 | TOP | ✅ 同 WO；EP 分案见 §3 |
| 20 | CN219733908U | 连接组件及出力设备（Dock） | 2023-09-22 | 有效 | DOCK | ✅ 枢转卡钩已采纳 |
| 21 | CN118532387A | 连接组件及出力设备 | 2024-08-23 | 待审 | DOCK | ✅ 同上 |
| 22 | CN122407665A | 出力设备（Dock 卡钩分案） | 2026-07-17 | 待审 | DOCK | ✅ 卡钩在插槽外侧枢转、转动解锁 |
| 23 | CN220086216U | 电池 | 2023-11-24 | 有效 | PWR | ◐ 电池包外购，内部不建模 |
| 24 | CN220778963U | 健身底板及健身设备 | 2024-04-16 | 有效 | 配件 | — 不在主机范围 |
| 25 | CN118949382A | 一种固定件 | 2024-11-15 | 待审 | 配件 | — 安装配件 |
| 26 | CN119825798A | 固定件 | 2025-04-15 | 待审 | 配件 | — |
| 27 | CN122055188A | 固定套组 | 2026-05-15 | 待审 | 配件 | — |
| 28 | CN122216209A | 一种紧固件 | 2026-06-16 | 待审 | 配件 | — |
| 29 | CN122328435A | 一种紧固件 | 2026-07-03 | 待审 | 配件 | — |
| 30 | CN220816143U | 抱箍结构 | 2024-04-19 | 有效 | 配件 | — |
| 31 | CN222208552U | 一种简易固定件 | 2024-12-20 | 有效 | 配件 | — |
| 32 | CN222436774U | 一种紧固夹 | 2025-02-07 | 有效 | 配件 | — |
| 33 | CN222488804U | 健身设备用固定件 | 2025-02-18 | 有效 | 配件 | — |
| 34 | CN223227641U | 连接杆 | 2025-08-15 | 有效 | 配件 | — |
| 35 | CN223578427U | 抱箍支架 | 2025-11-21 | 有效 | 配件 | — |
| 36 | WO2026158487A1 | 抱箍支架（PCT） | 2026-07-30 | 待审 | 配件 | — |
| 37 | CN223649034U | 固定底座 | 2025-12-09 | 有效 | 配件 | — |
| 38 | CN224326516U | 一种柔性固定装置 | 2026-06-05 | 有效 | 配件 | — |
| 39 | WO2024235356A1 | 固定套组（PCT） | 2024-11-21 | PCT 已进入国家阶段 | 配件 | — |
| 40 | EP4714509A1 | 固定套组（EP） | 2026-03-25 | 待审 | 配件 | — |
| 41 | CN119174898A | 运动设备控制方法、系统及运动设备 | 2024-12-24 | 待审 | 控制 | — 软件，不影响机械 |
| 42 | WO2024260447A1 | 同上（PCT） | 2024-12-26 | PCT 已进入国家阶段 | 控制 | — |
| 43 | EP4748458A1 | 同上（EP） | 2026-05-27 | 待审 | 控制 | — |
| 44 | CN120437558A | 定制阻力输出控制方法 | 2025-08-08 | 已授权 | 控制 | — |
| 45 | CN120437558B | 同上（授权） | 2025-08-08 | 有效 | 控制 | — |
| 46 | CN120437559A | 出力设备休眠控制方法 | 2025-08-08 | 已授权 | 控制 | — |
| 47 | CN120437559B | 同上（授权） | 2025-08-08 | 有效 | 控制 | — |
| 48 | CN120437560A | 绳索阻力控制方法 | 2025-08-08 | 已授权 | 控制 | — 电机张力闭环依据之一 |
| 49 | CN120437560B | 同上（授权） | 2025-08-08 | 有效 | 控制 | — |
| 50 | CN120437561A | 出力控制方法 | 2025-08-08 | 已授权 | 控制 | — |
| 51 | CN120437561B | 同上（授权） | 2025-08-08 | 有效 | 控制 | — |
| 52 | US20260224933A1 | 出力设备控制方法 | 2026-08-06 | 待审 | 控制 | — |
| 53 | WO2025168165A2 | 出力设备控制方法（PCT） | 2025-08-14 | 待审 | 控制 | — |
| 54 | CN308227494S | 力量训练器（外观） | 2023-09-15 | 外观 | 外观 | ✅ 外形比例参考 |
| 55 | CN308793997S | 主界面 GUI | 2024-08-20 | 外观 | GUI | — |
| 56 | CN309004146S | 弹力带训练 GUI | 2024-12-13 | 外观 | GUI | — |
| 57 | CN309004147S | 力量训练 GUI | 2024-12-13 | 外观 | GUI | — |
| 58 | CN309012317S | 阻力训练 GUI | 2024-12-17 | 外观 | GUI | — |
| 59 | CN309028563S | 参数调节 GUI | 2024-12-24 | 外观 | GUI | — |

（状态取自 Google Patents 页面。"已授权"的 A 文本表示已有对应的 B 授权文本。另外用申请人检索时还命中 4 份光伏/水下相关文献：CN112865684B、CN213847180U、CN211320184U、CN215219457U，经核对与 VOLTRA 无关，已排除。）

## 3. 未公开 / 未能核对的文献
- EP4672567A1 的分案 EP4825454、EP4821570：权利要求方向与 WO2024175034A1 的子方案一致，内容已包含在 §1.8 的审查中。EP25751774.8 已登记，但尚未公开。
- 官网列出的 US 19/158,453、19/718,069、19/718,084、19/718,094、19/717,969、19/719,284、19/718,035、19/718,018、19/718,119、19/718,001、19/576,570 等申请，目前在公开渠道查不到全文，**无法审查**。这些申请可能包含量产件的细节，列为未知项 U1。

## 4. 对 CAD-v03 的影响汇总
1. 排线：v03 按用户决定 D1 改为自锁蜗杆 + 摆动蜗轮扇形（专利 1–4），卷筒 R20 → R25，电机改为 MF0095056；撤回 v02 的滑动小车和 Tr10×2 丝杠。
2. 出线：双支承旋转座 + 转向轮（专利 5），机外改为固定喇叭口。
3. 卷筒：槽距 3.2，25 圈，左旋；压线块锚固（专利 7）；铝卷筒（专利 6 部分采纳）。
4. 转子毂内置风扇、磁环、花键（专利 15）。
5. 制动电阻导热垫 + NTC（专利 10）；Dock 枢转卡钩 + 法兰承压（专利 20–22）。
6. D1 已决定；D2–D6 和 Ø26 转向轮仍待定（暂按推荐的 A 选项），未知项 U1–U3 见 `gap-list.md` §0。
