merlinwwu/voltra-i-ref-3d/downloads/drawings/ASSY-01-A.png

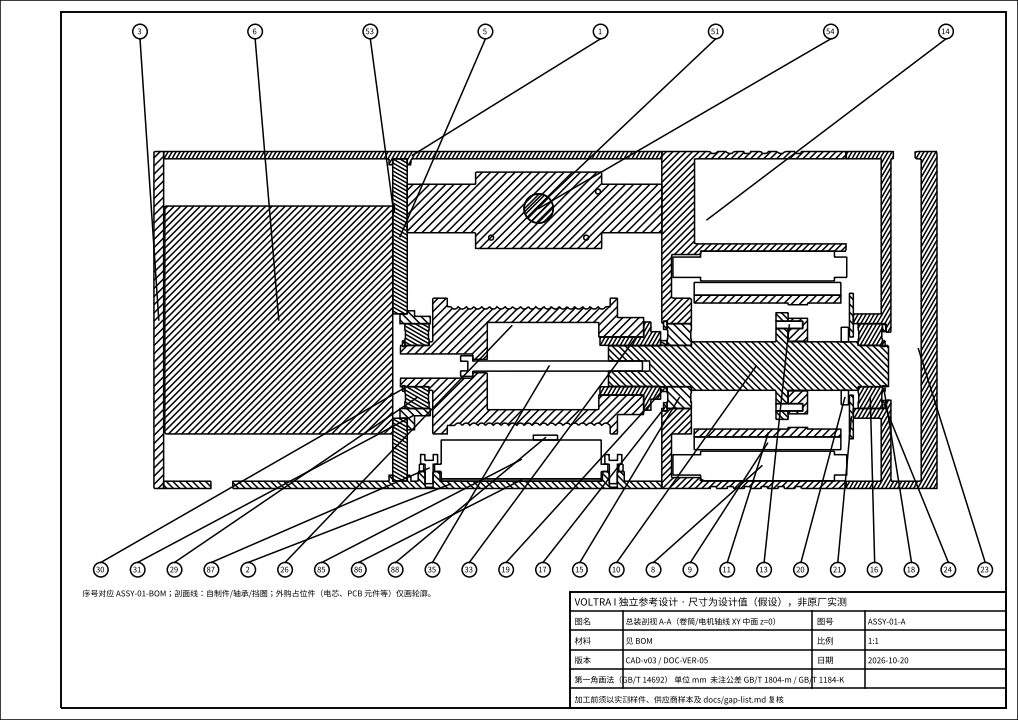
downloads/drawings/ASSY-01-A.png
