merlinwwu/voltra-i-ref-3d/downloads/drawings/ASSY-01-B.png

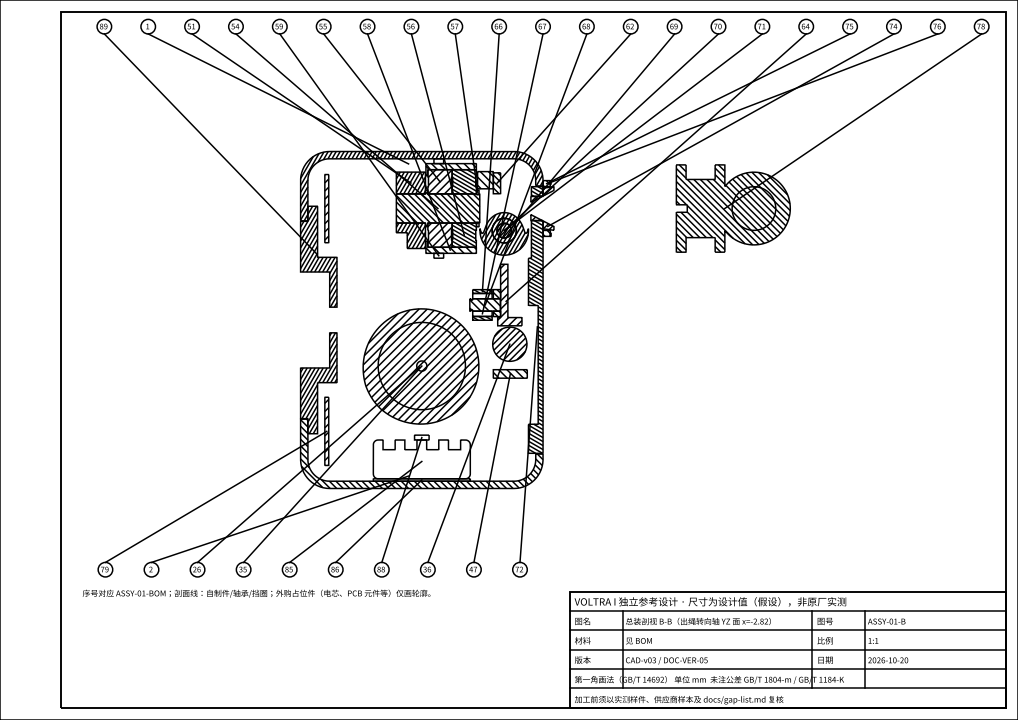
downloads/drawings/ASSY-01-B.png
