merlinwwu/voltra-i-ref-3d/downloads/drawings/BRG-03-HSG.png

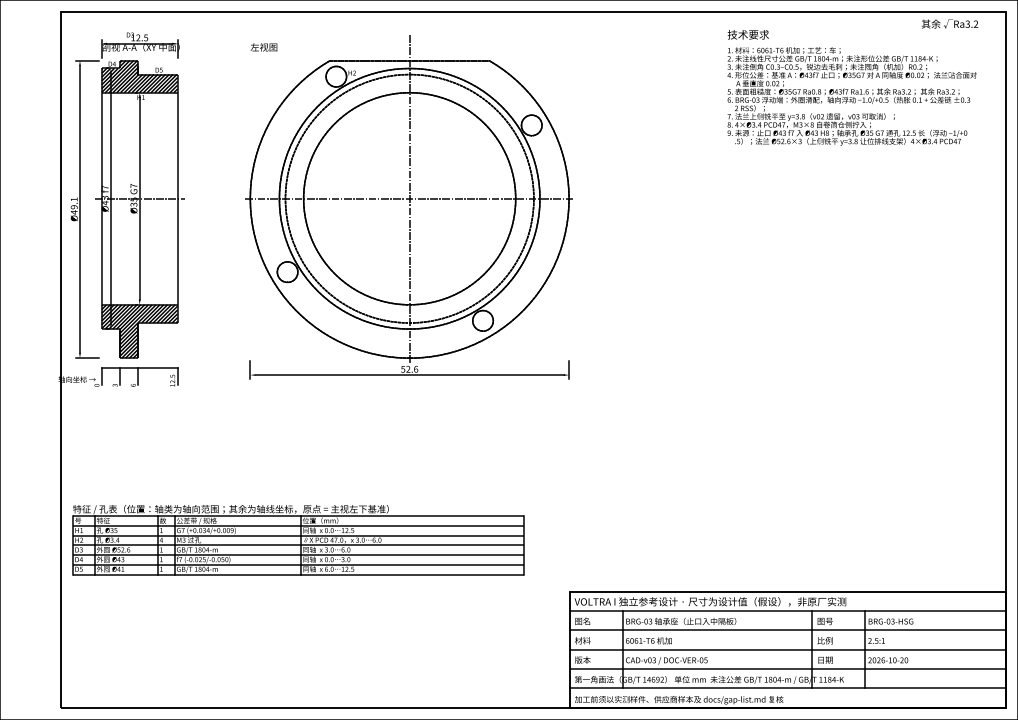
downloads/drawings/BRG-03-HSG.png
