merlinwwu/voltra-i-ref-3d/downloads/drawings/CONN-01.png

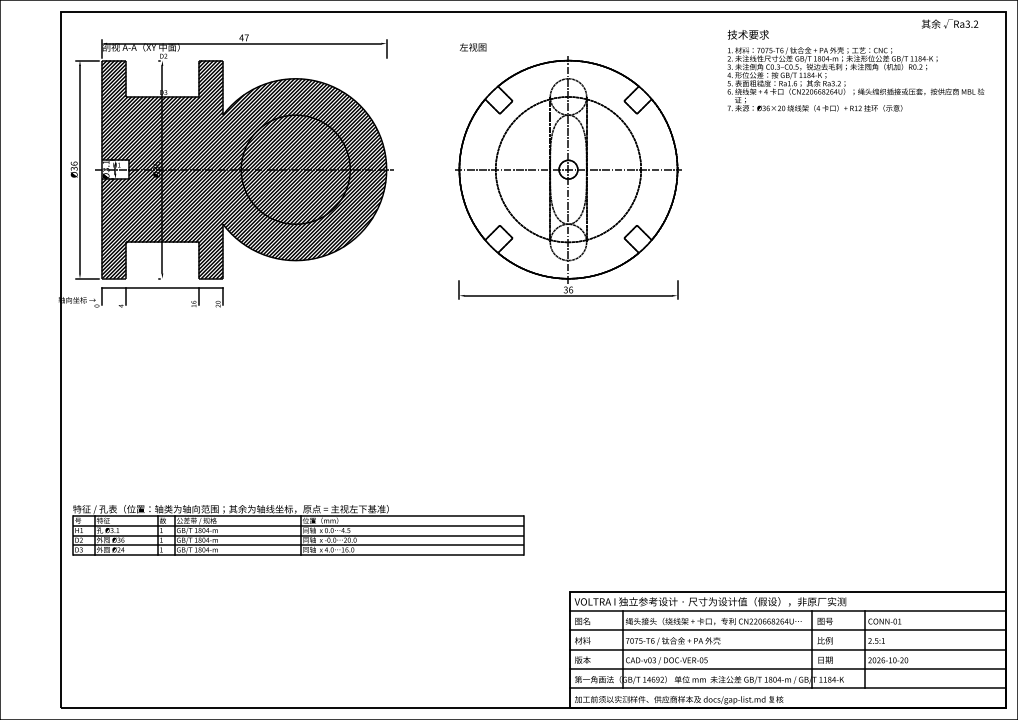
downloads/drawings/CONN-01.png
