merlinwwu/voltra-i-ref-3d/downloads/drawings/DOCK-HOOK-01.png

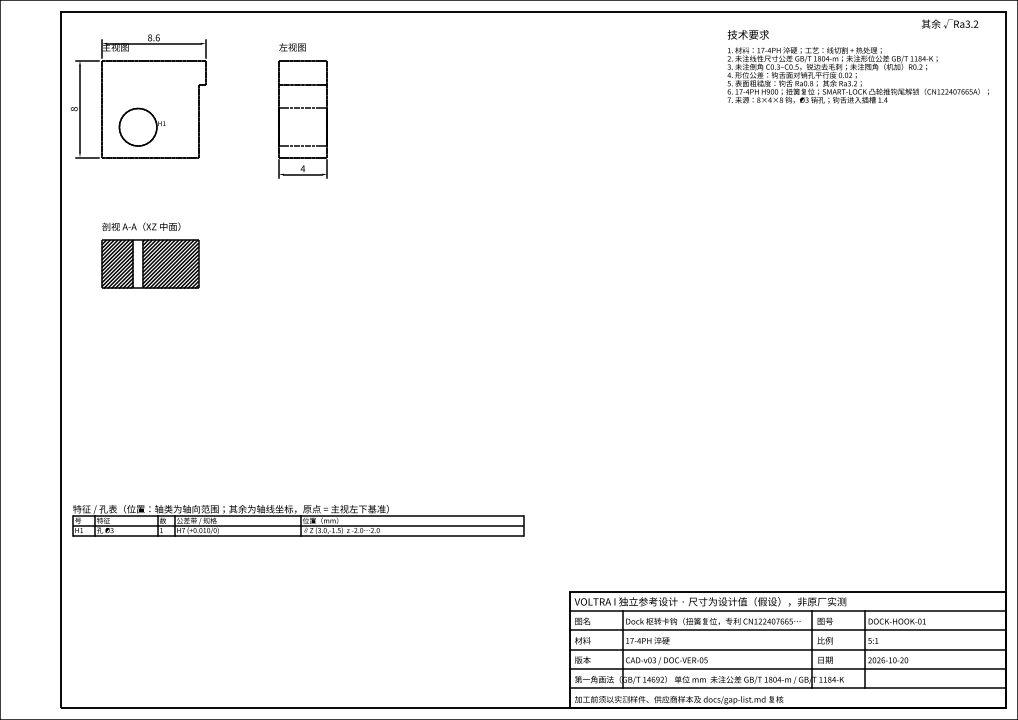
downloads/drawings/DOCK-HOOK-01.png
