merlinwwu/voltra-i-ref-3d/downloads/drawings/DOCK-IF-01.png

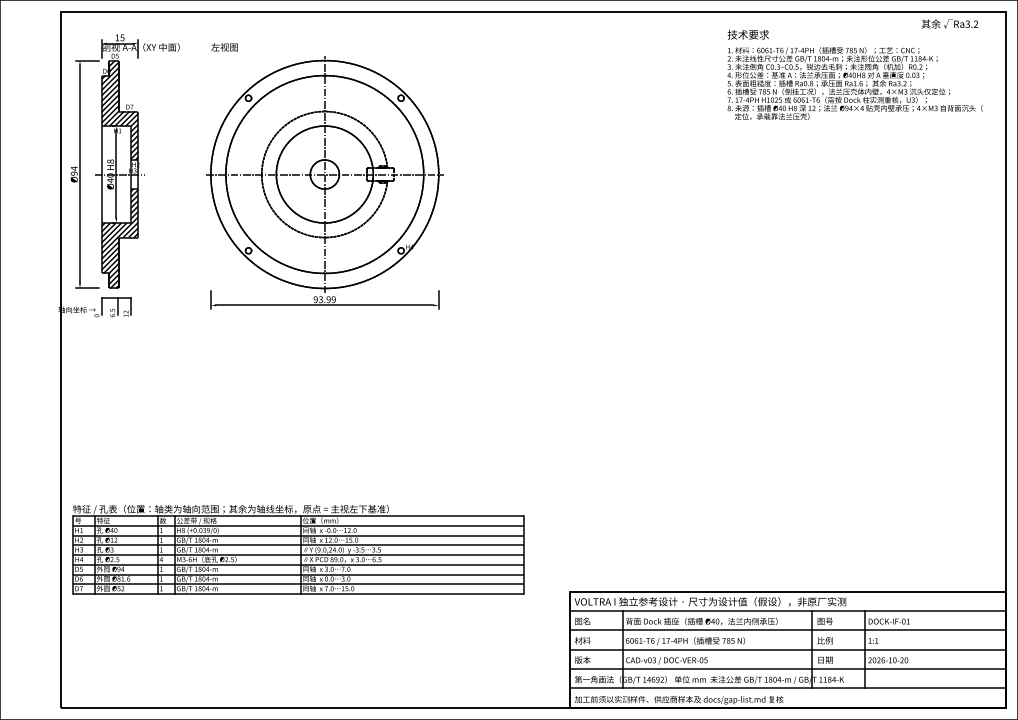
downloads/drawings/DOCK-IF-01.png
