merlinwwu/voltra-i-ref-3d/downloads/drawings/DRUM-01.png

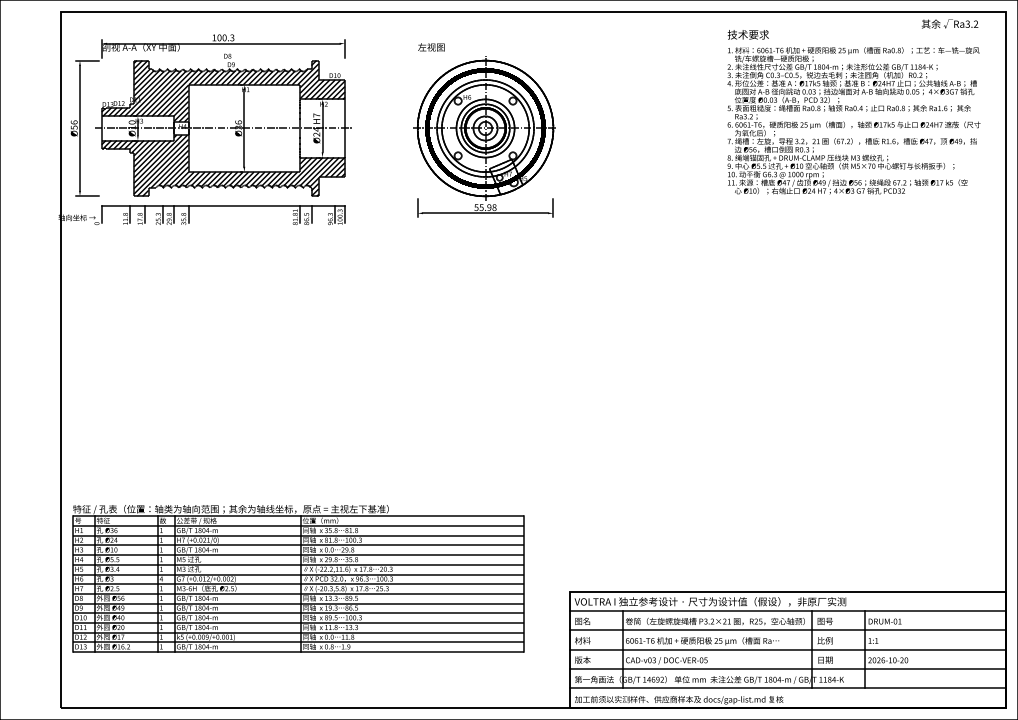
downloads/drawings/DRUM-01.png
