merlinwwu/voltra-i-ref-3d/downloads/drawings/DRUM-CLAMP-01.png

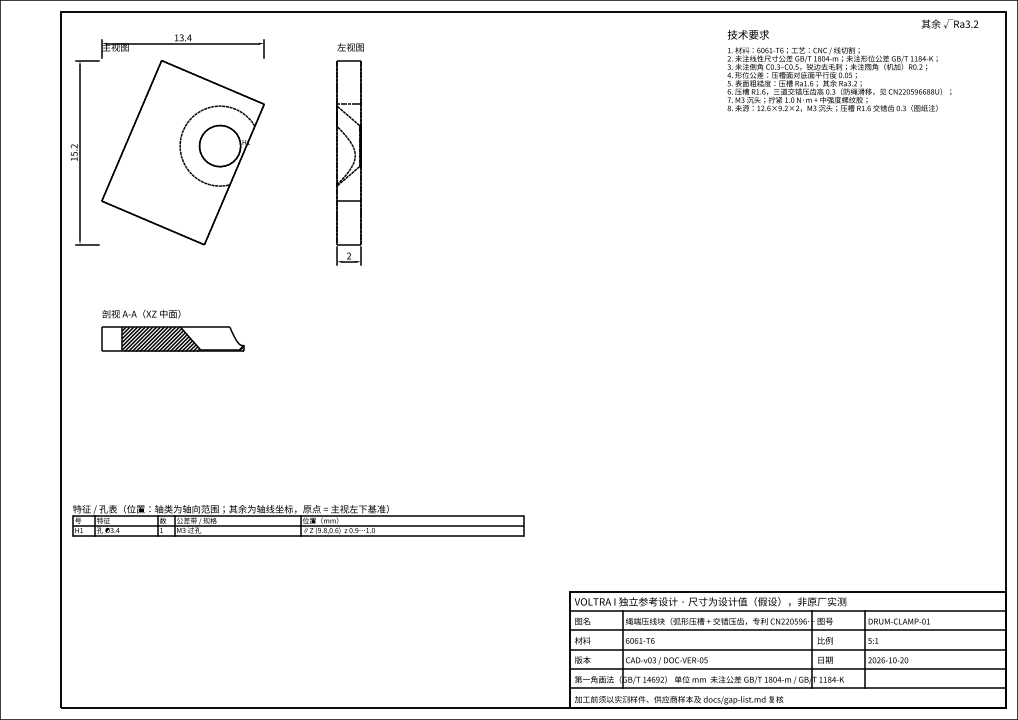
downloads/drawings/DRUM-CLAMP-01.png
