merlinwwu/voltra-i-ref-3d/downloads/drawings/DRUM-HUB-01.png

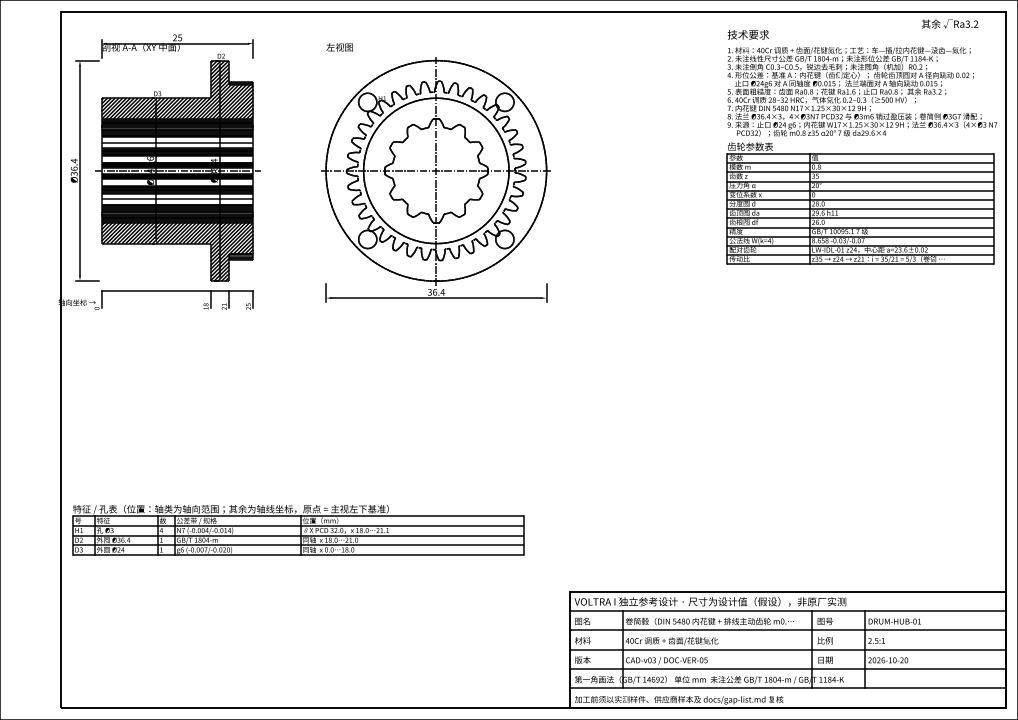
downloads/drawings/DRUM-HUB-01.png
