merlinwwu/voltra-i-ref-3d/downloads/drawings/EXIT-AXL-01.png

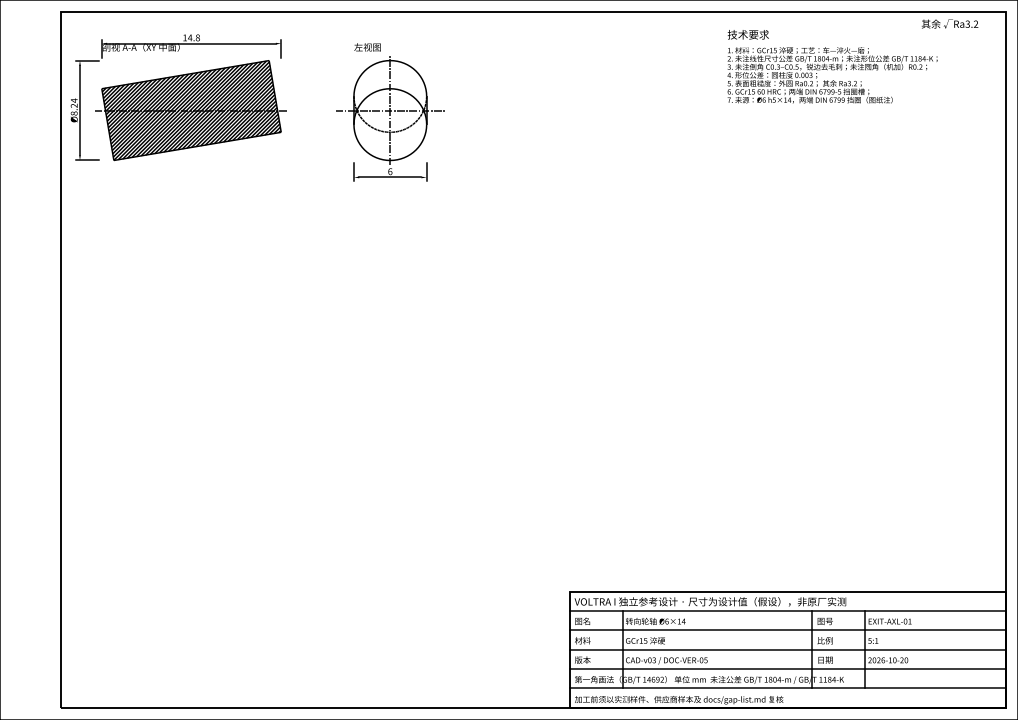
downloads/drawings/EXIT-AXL-01.png
