merlinwwu/voltra-i-ref-3d/downloads/drawings/EXIT-BASE-01.png

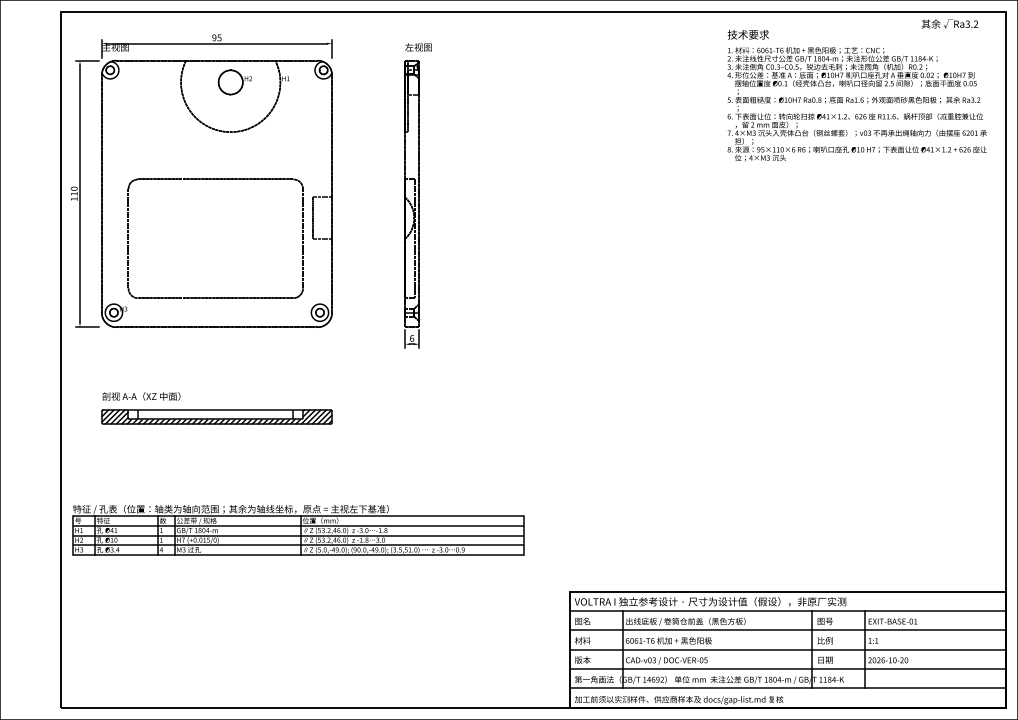
downloads/drawings/EXIT-BASE-01.png
