merlinwwu/voltra-i-ref-3d/downloads/drawings/EXIT-PIN-01.png

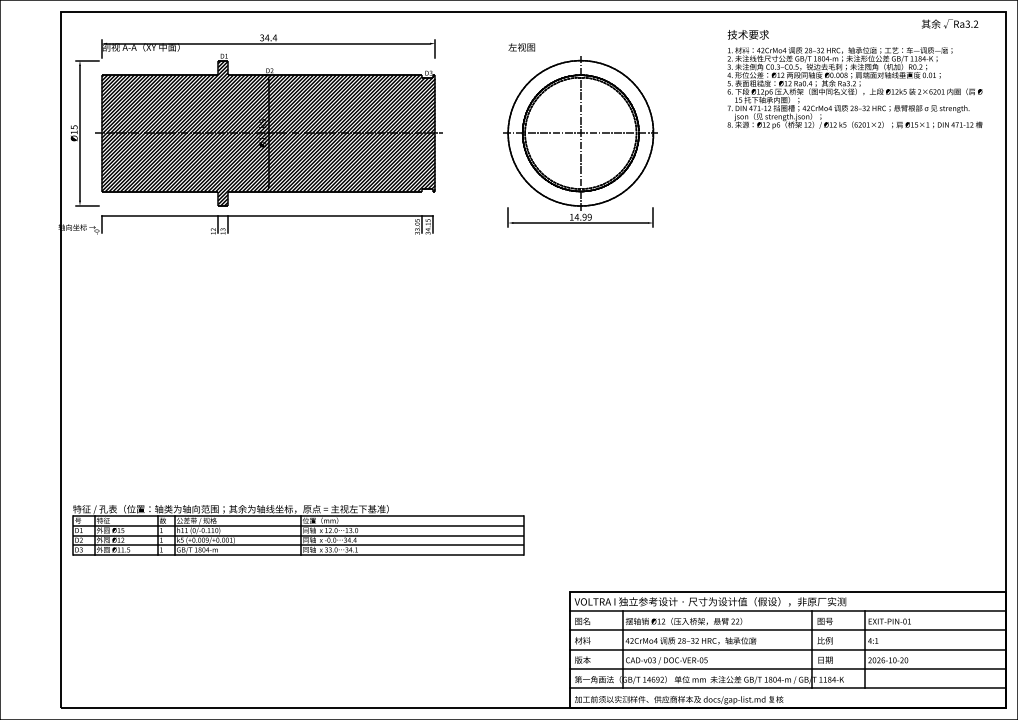
downloads/drawings/EXIT-PIN-01.png
