merlinwwu/voltra-i-ref-3d/downloads/drawings/EXIT-SHV-01.png

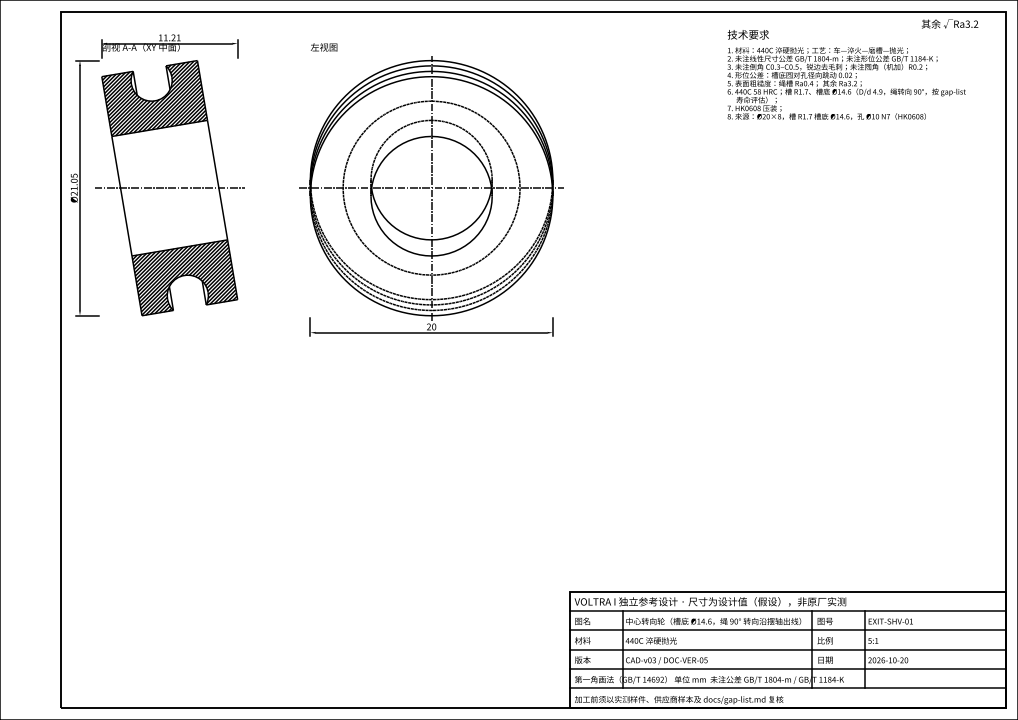
downloads/drawings/EXIT-SHV-01.png
