merlinwwu/voltra-i-ref-3d/downloads/drawings/EXIT-SWV-01.png

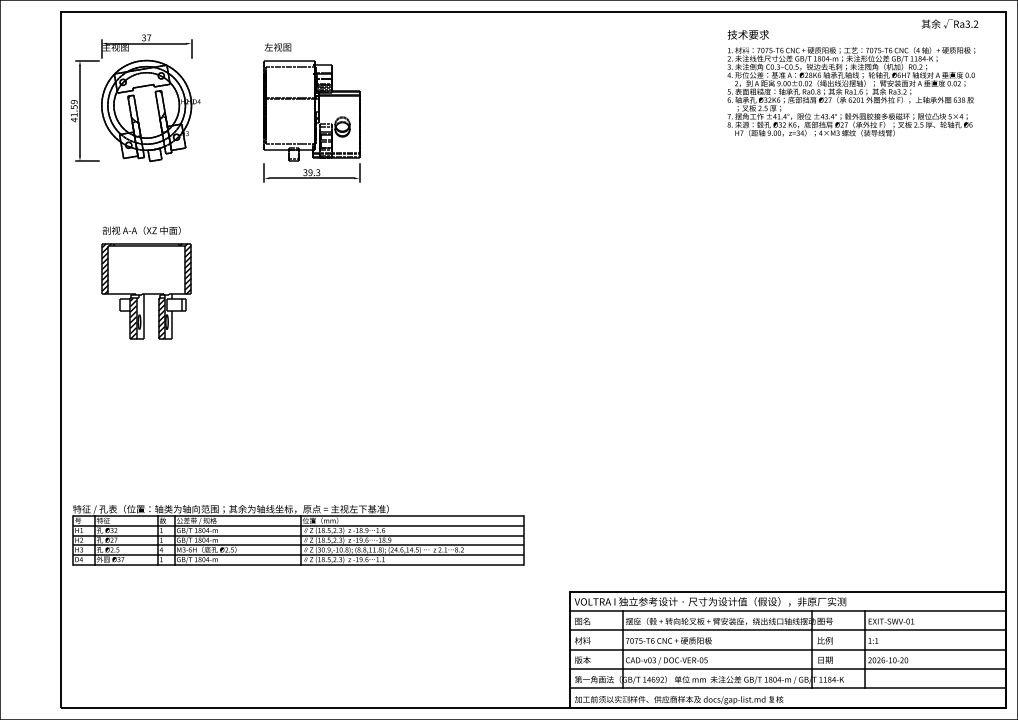
downloads/drawings/EXIT-SWV-01.png
