merlinwwu/voltra-i-ref-3d/downloads/drawings/EXIT-UNI-01.png

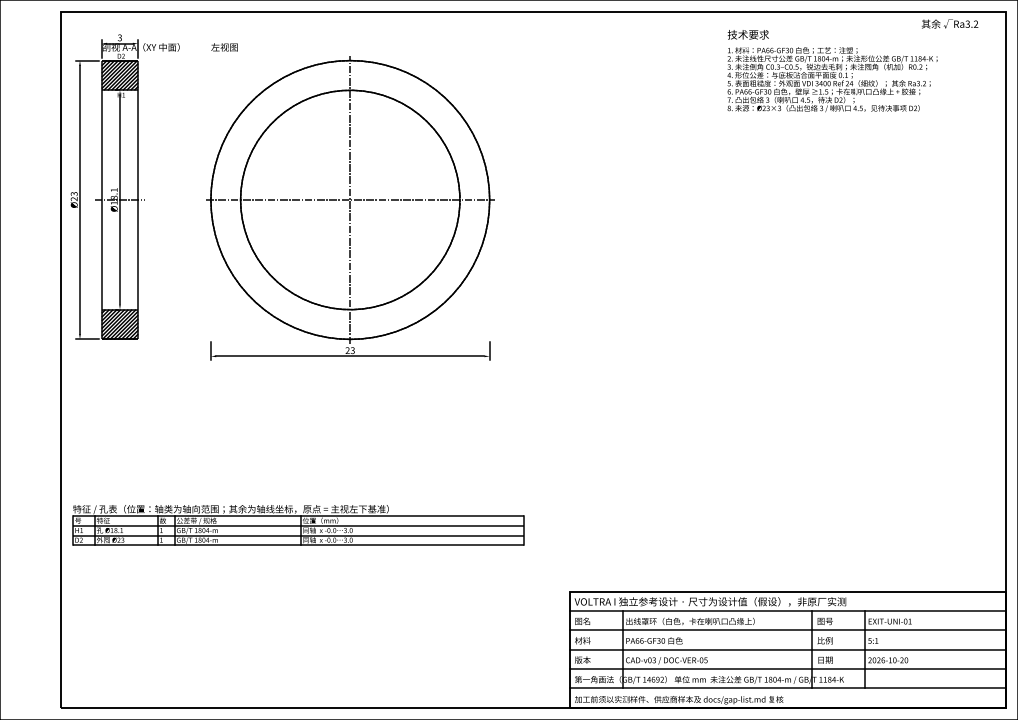
downloads/drawings/EXIT-UNI-01.png
