merlinwwu/voltra-i-ref-3d/downloads/drawings/HSG-END-L-01.png

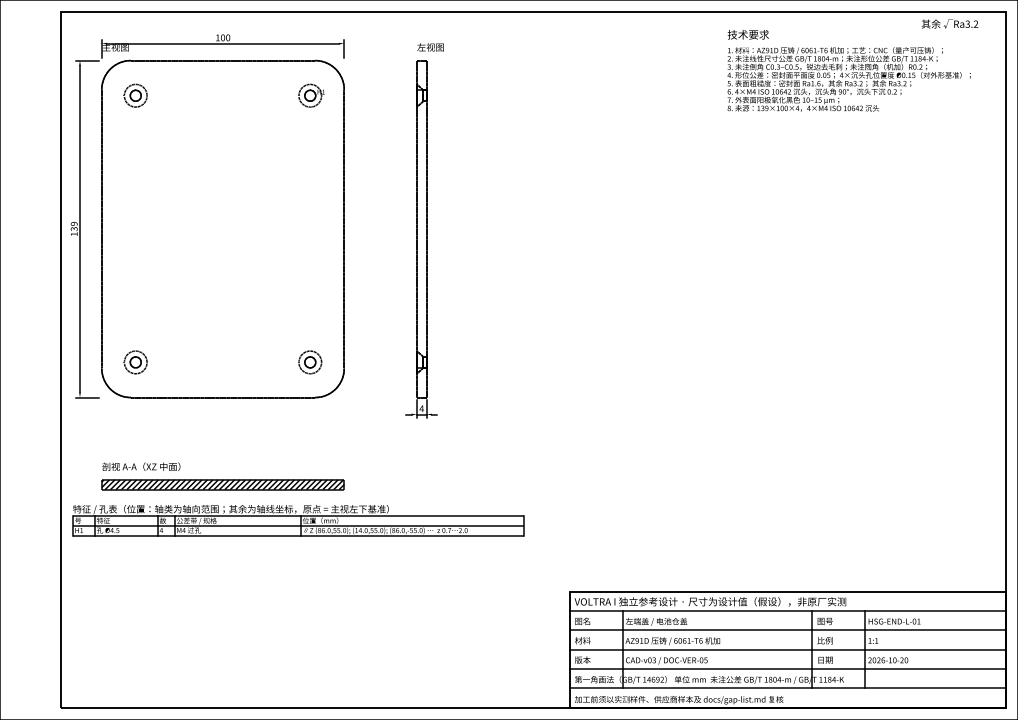
downloads/drawings/HSG-END-L-01.png
