merlinwwu/voltra-i-ref-3d/downloads/drawings/HSG-FRAME-01.png

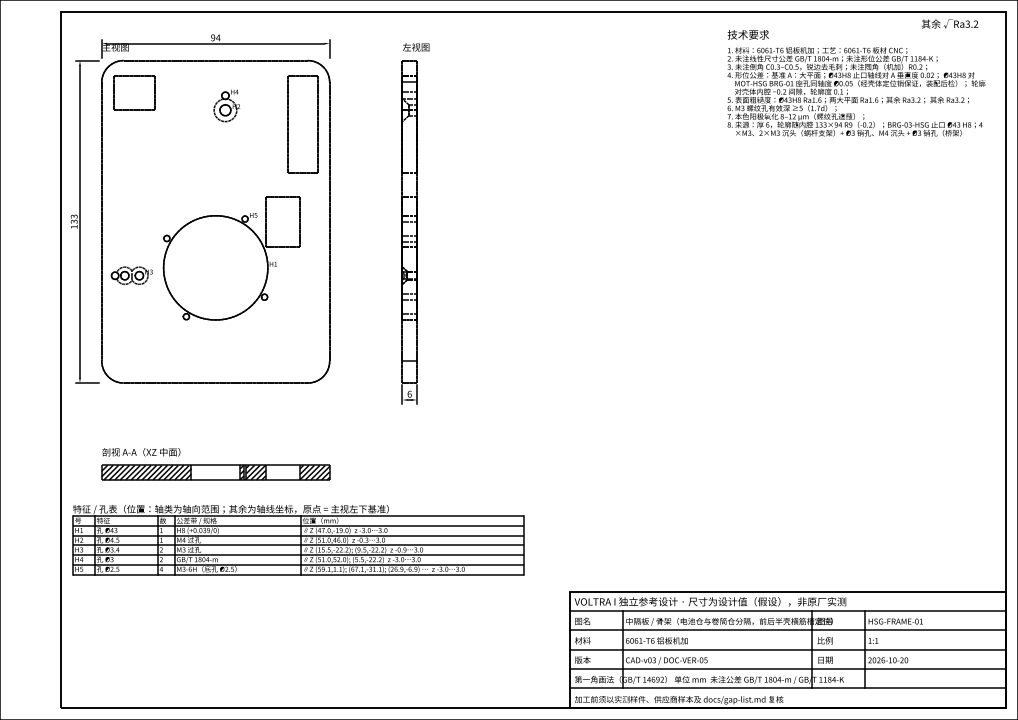
downloads/drawings/HSG-FRAME-01.png
