merlinwwu/voltra-i-ref-3d/downloads/drawings/HSG-MAIN-01-LWR.png

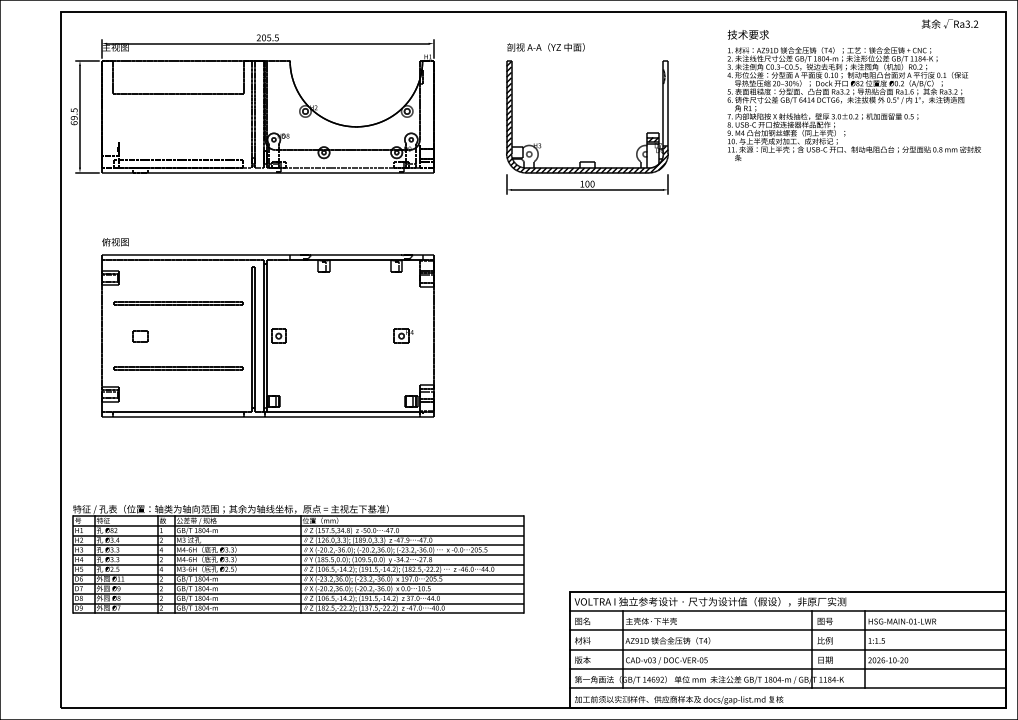
downloads/drawings/HSG-MAIN-01-LWR.png
