merlinwwu/voltra-i-ref-3d/downloads/drawings/HSG-MAIN-01-UPR.png

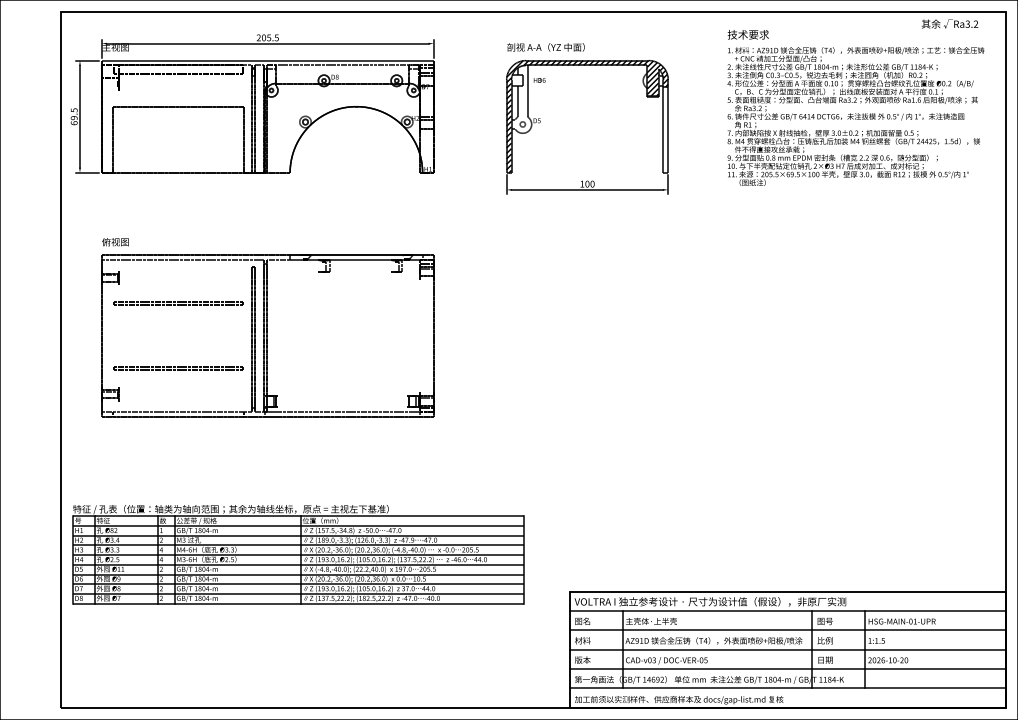
downloads/drawings/HSG-MAIN-01-UPR.png
