merlinwwu/voltra-i-ref-3d/downloads/drawings/LW-ARM-01.png

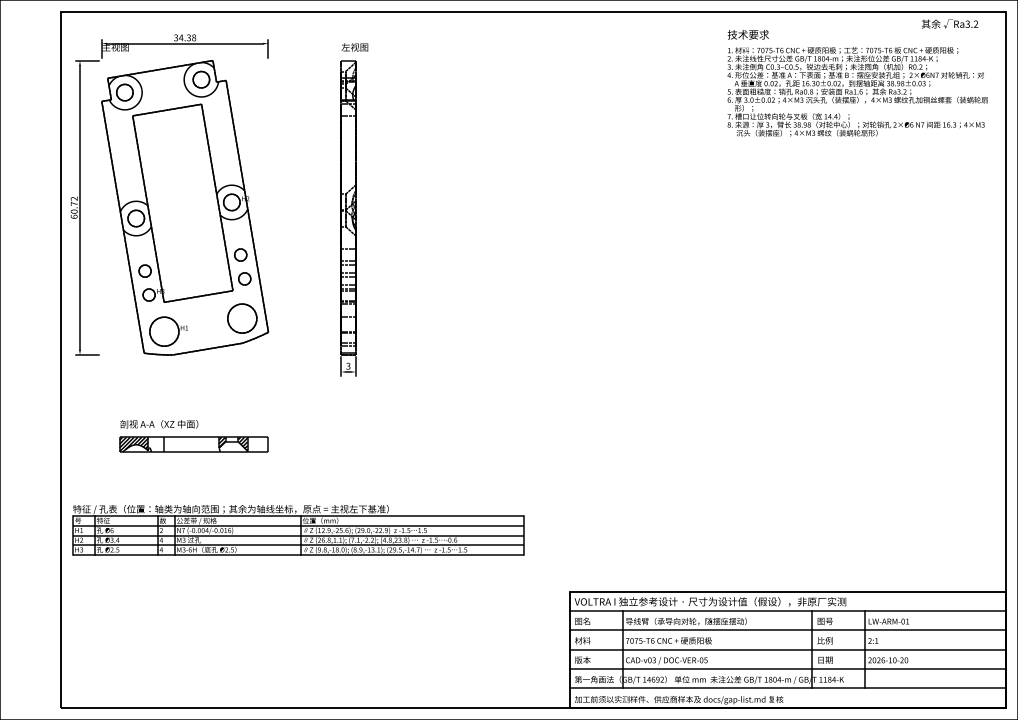
downloads/drawings/LW-ARM-01.png
