merlinwwu/voltra-i-ref-3d/downloads/drawings/LW-BOX-01.png

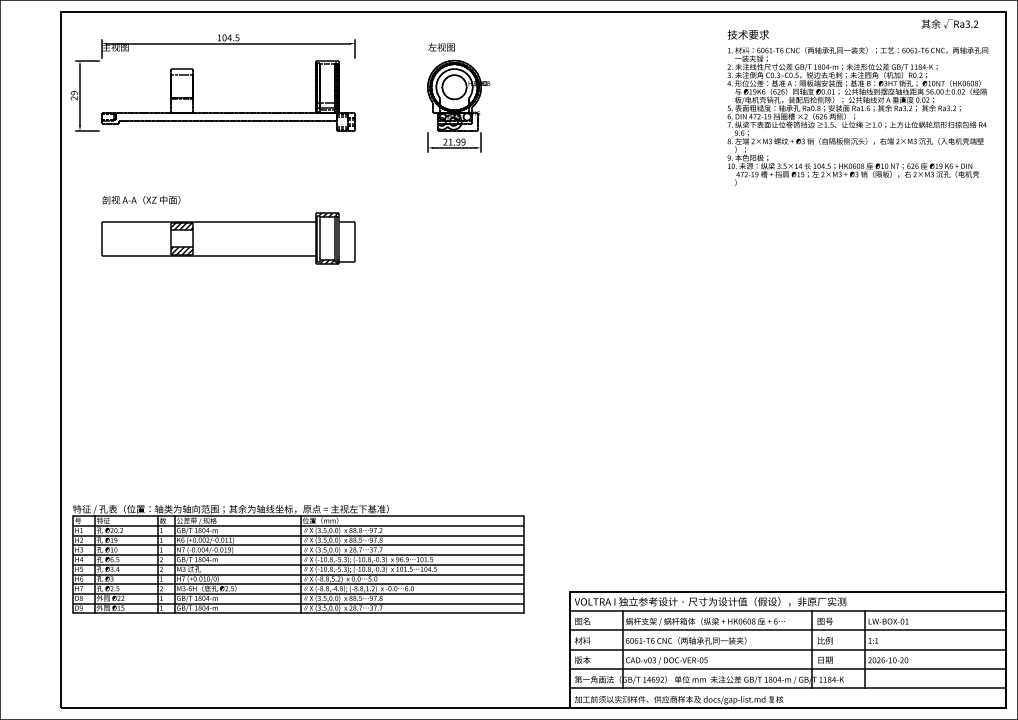
downloads/drawings/LW-BOX-01.png
