merlinwwu/voltra-i-ref-3d/downloads/drawings/LW-BRIDGE-01.png

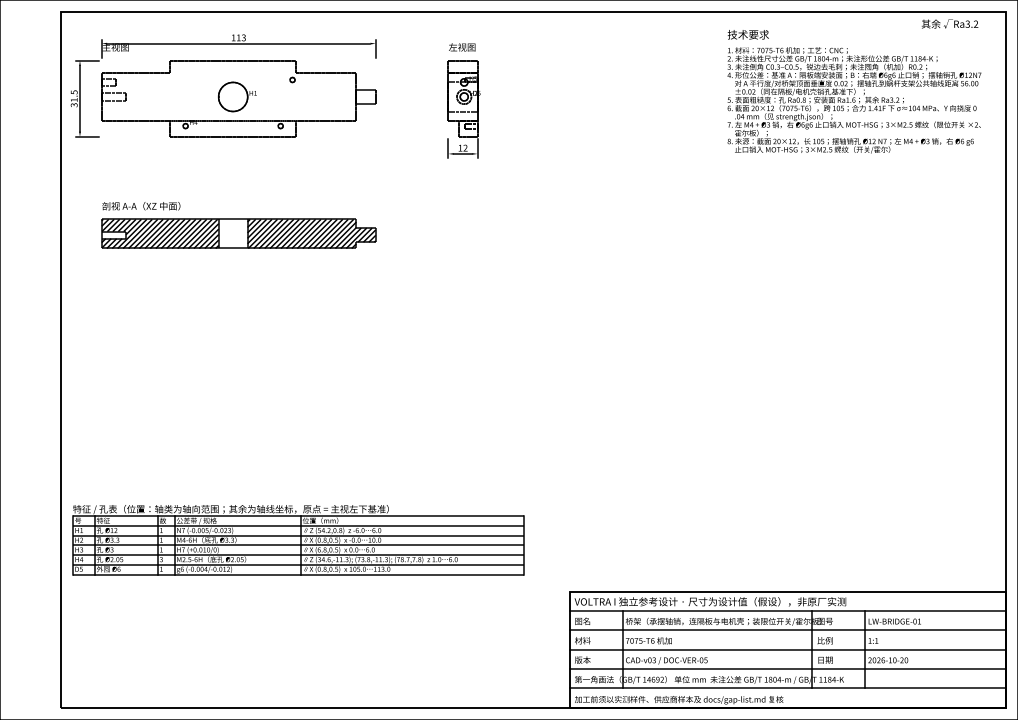
downloads/drawings/LW-BRIDGE-01.png
