merlinwwu/voltra-i-ref-3d/downloads/drawings/LW-GEAR-01.png

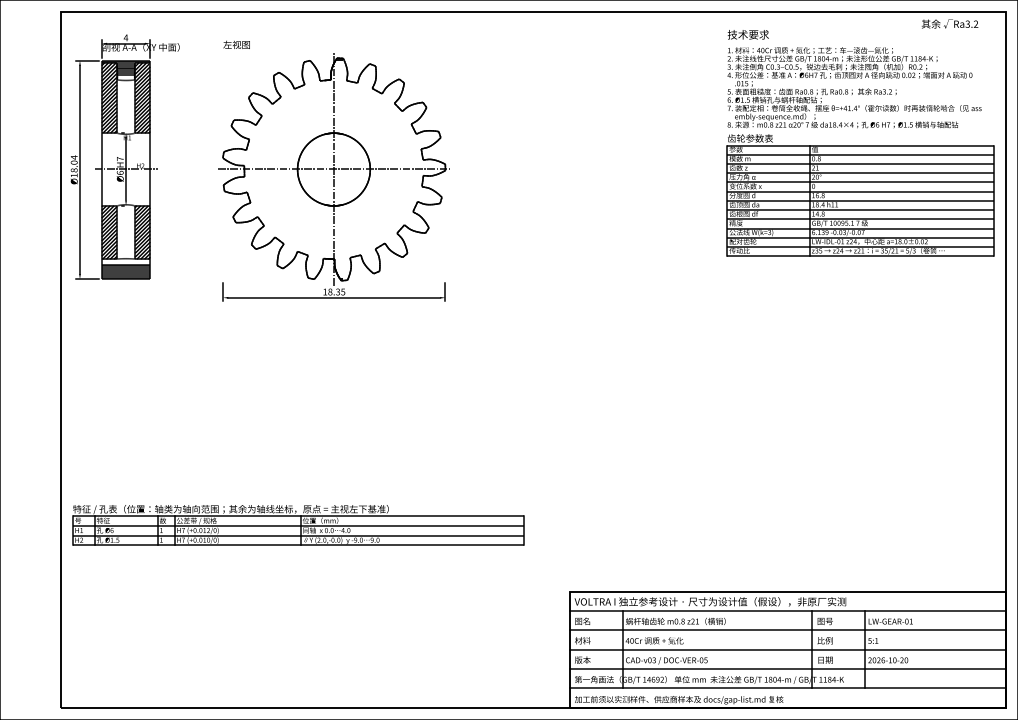
downloads/drawings/LW-GEAR-01.png
