merlinwwu/voltra-i-ref-3d/downloads/drawings/LW-IDL-PIN-01.png

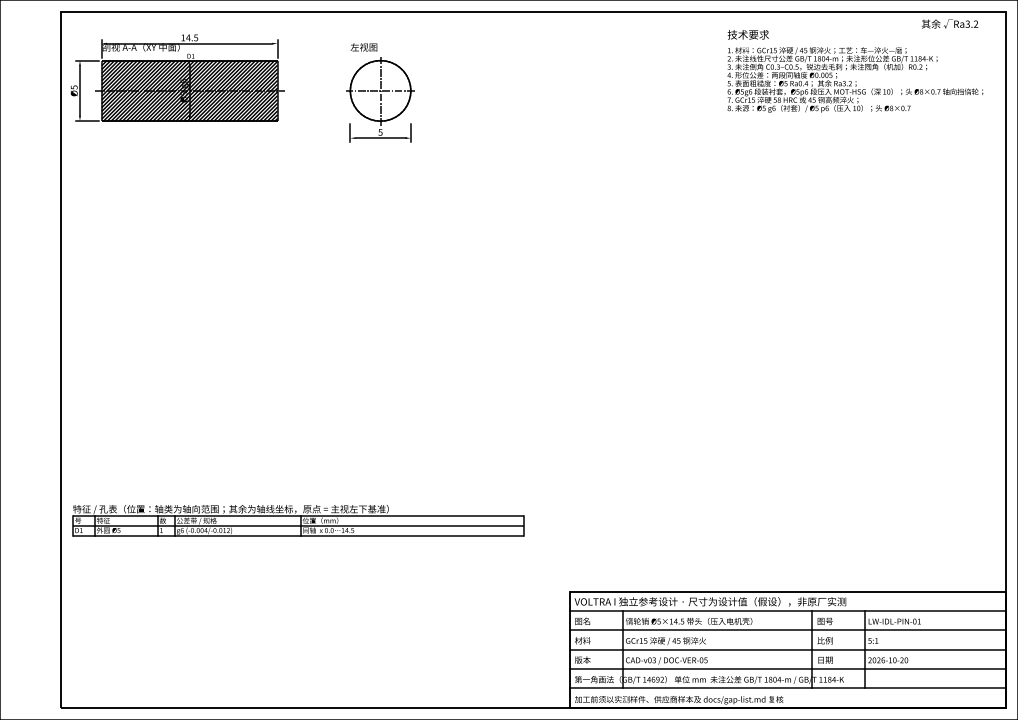
downloads/drawings/LW-IDL-PIN-01.png
