merlinwwu/voltra-i-ref-3d/downloads/drawings/LW-PIN-01.png

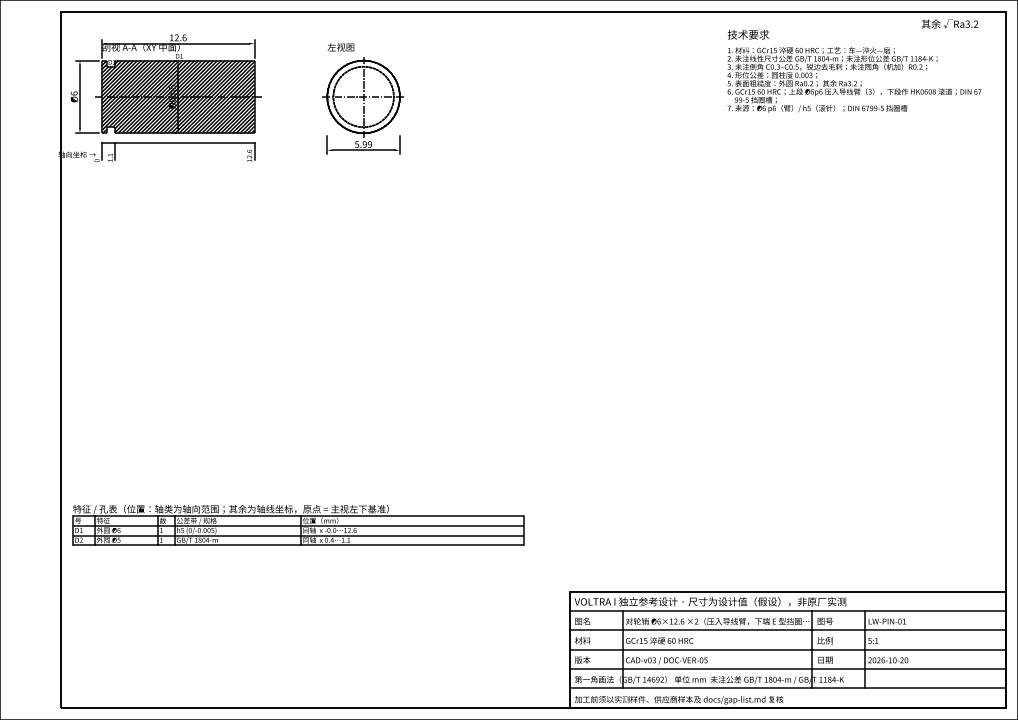
downloads/drawings/LW-PIN-01.png
