merlinwwu/voltra-i-ref-3d/downloads/drawings/LW-ROL-01.png

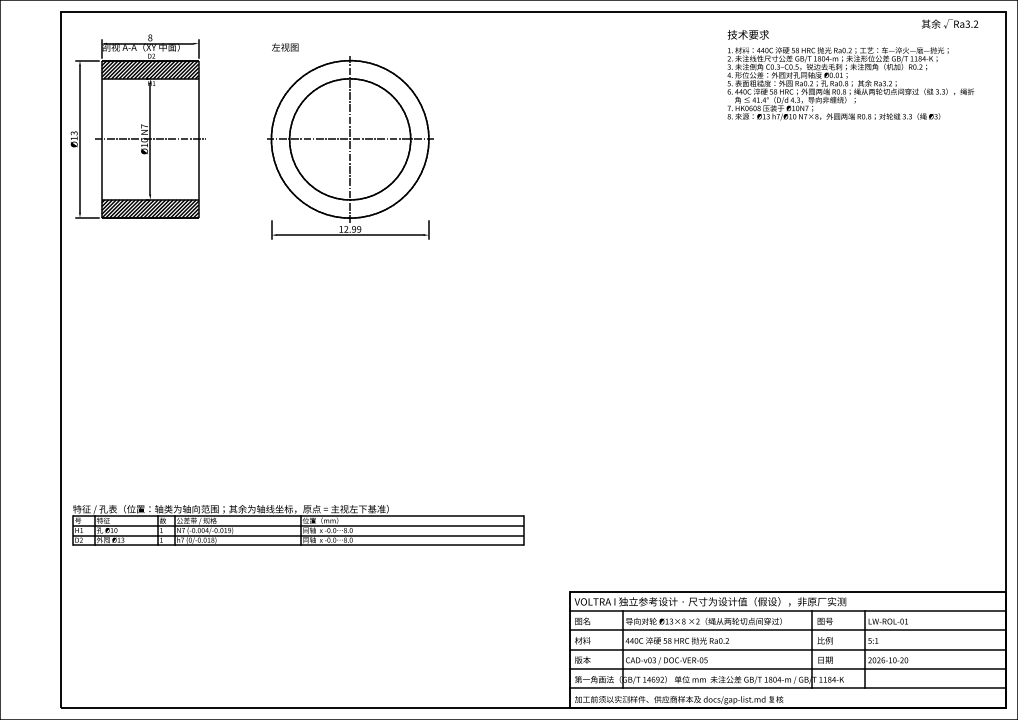
downloads/drawings/LW-ROL-01.png
