merlinwwu/voltra-i-ref-3d/downloads/drawings/LW-SPC-01.png

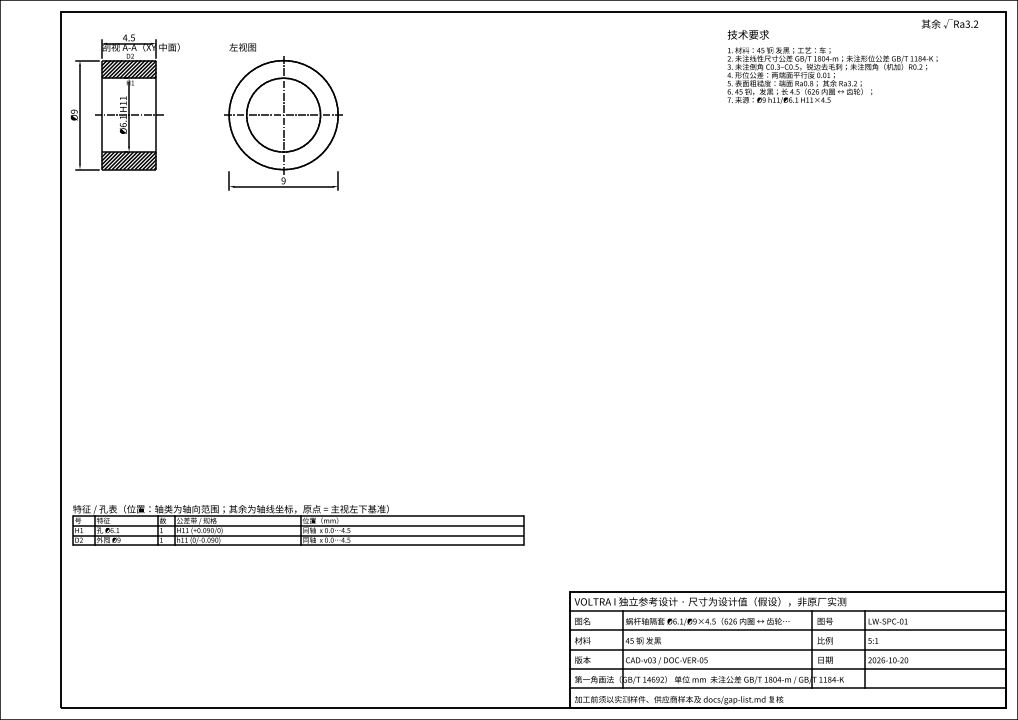
downloads/drawings/LW-SPC-01.png
