merlinwwu/voltra-i-ref-3d/downloads/drawings/LW-WHEEL-01.png

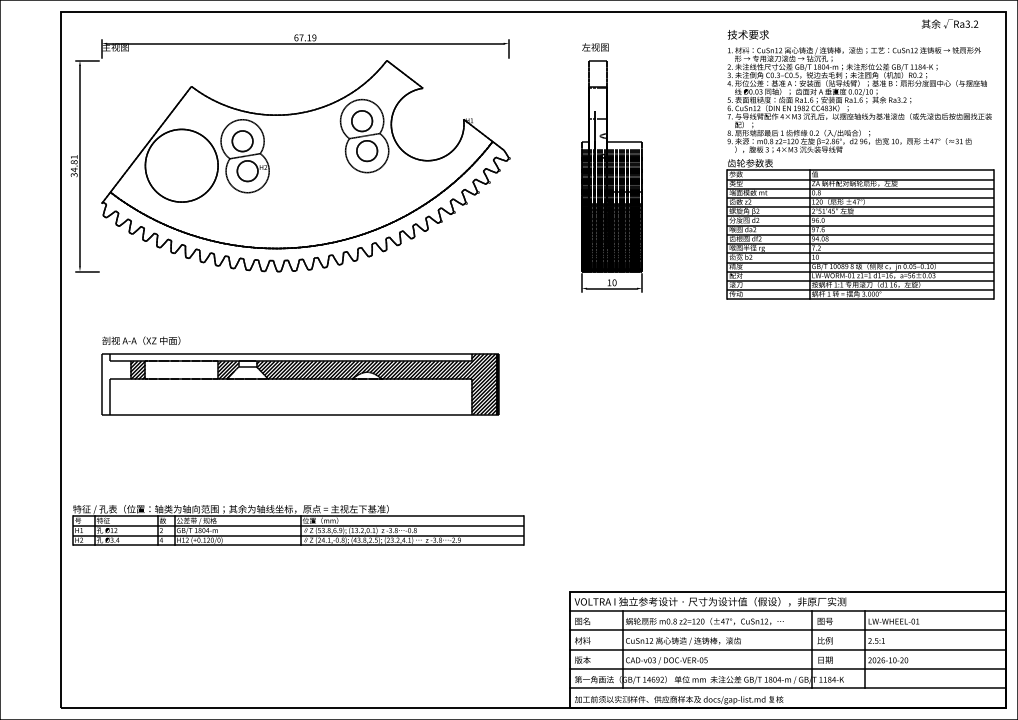
downloads/drawings/LW-WHEEL-01.png
