merlinwwu/voltra-i-ref-3d/downloads/drawings/LW-WORM-01.png

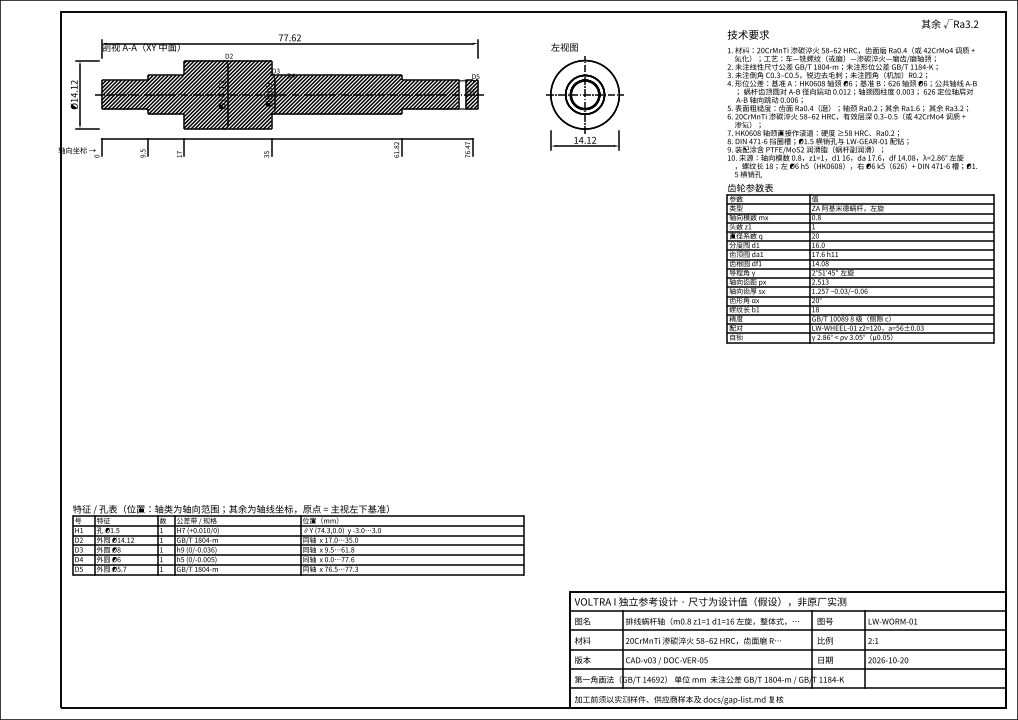
downloads/drawings/LW-WORM-01.png
