merlinwwu/voltra-i-ref-3d/downloads/drawings/MOT-HSG-01.png

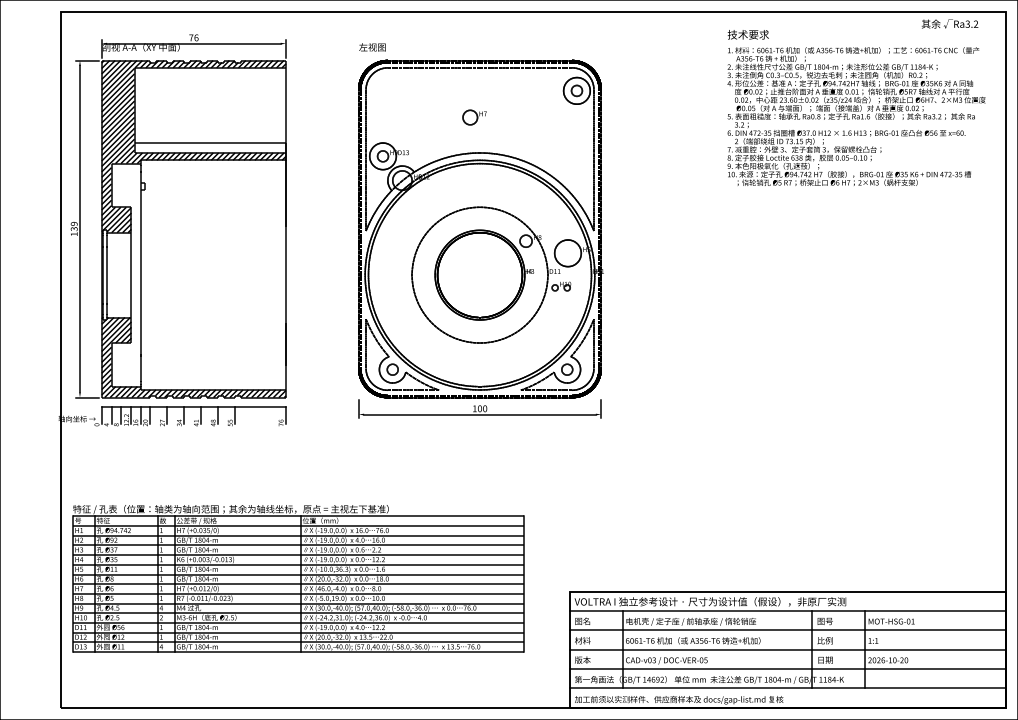
downloads/drawings/MOT-HSG-01.png
