merlinwwu/voltra-i-ref-3d/downloads/drawings/MOT-SHAFT-01.png

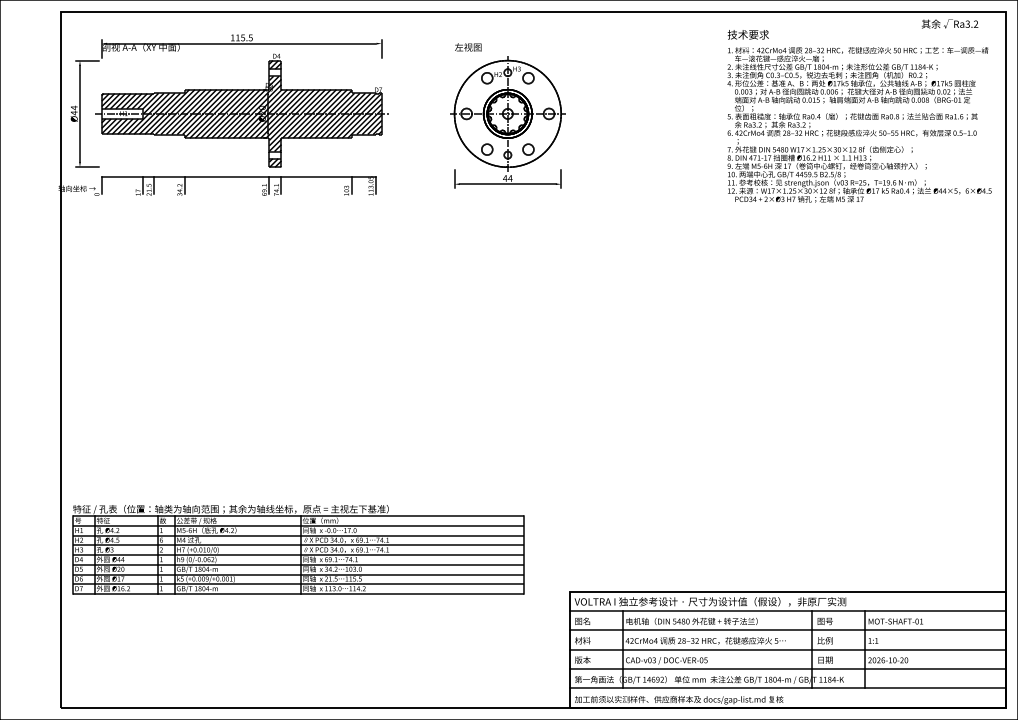
downloads/drawings/MOT-SHAFT-01.png
