merlinwwu/voltra-i-ref-3d/downloads/drawings/PCB-HS-01.png

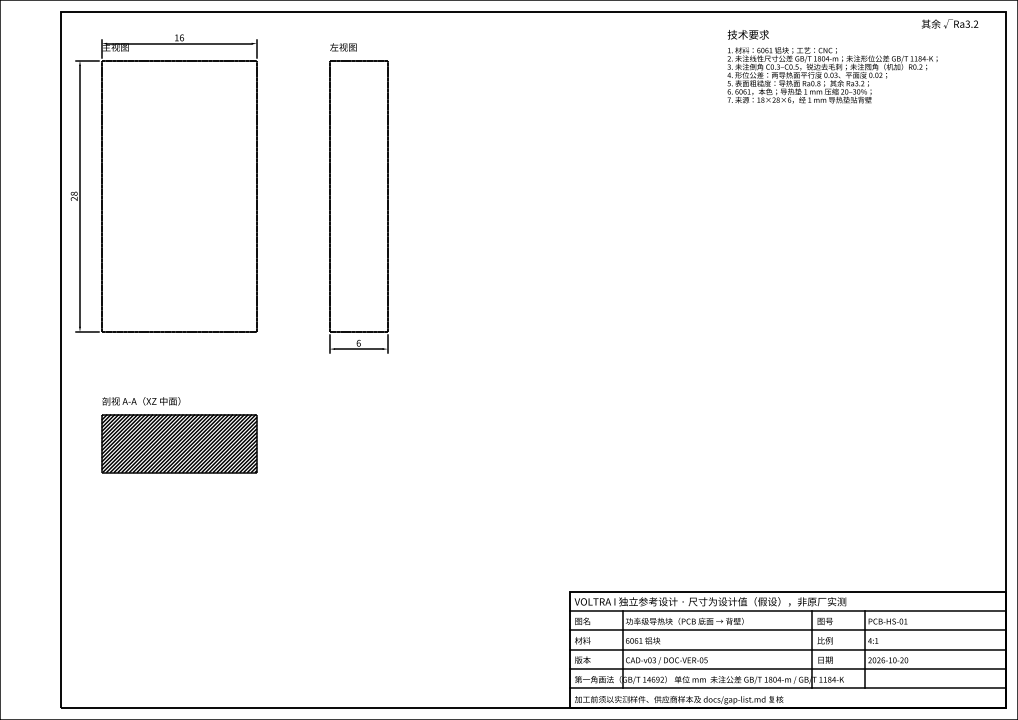
downloads/drawings/PCB-HS-01.png
