merlinwwu/voltra-i-ref-3d/downloads/drawings/ROT-HUB-01.png

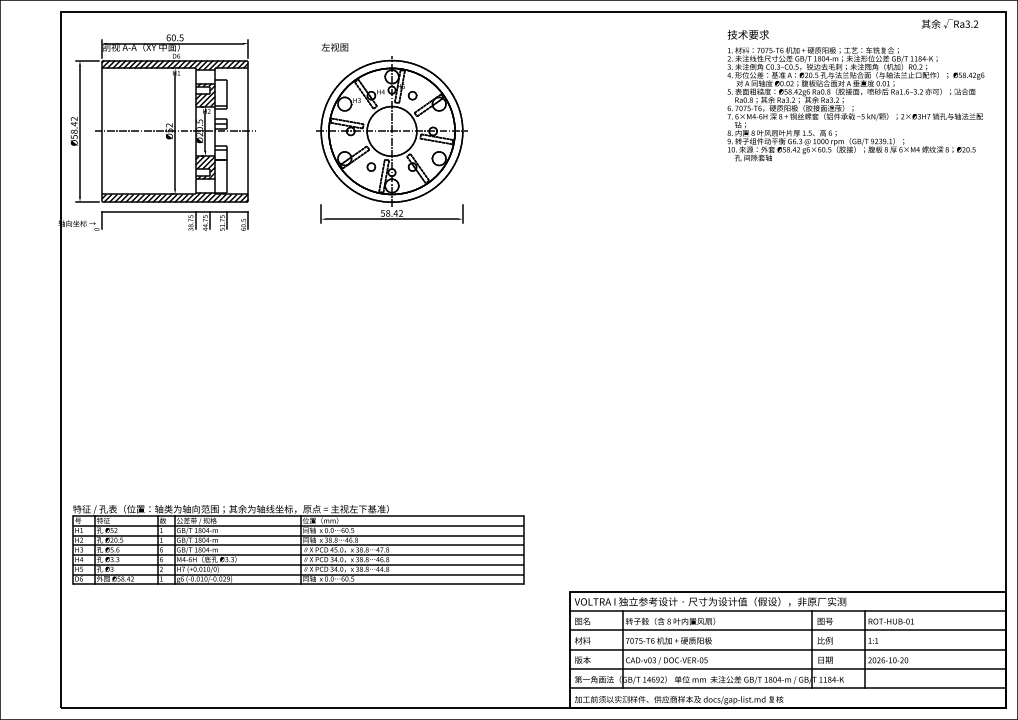
downloads/drawings/ROT-HUB-01.png
