merlinwwu/voltra-i-ref-3d/downloads/drawings/SPC-BRG01.png

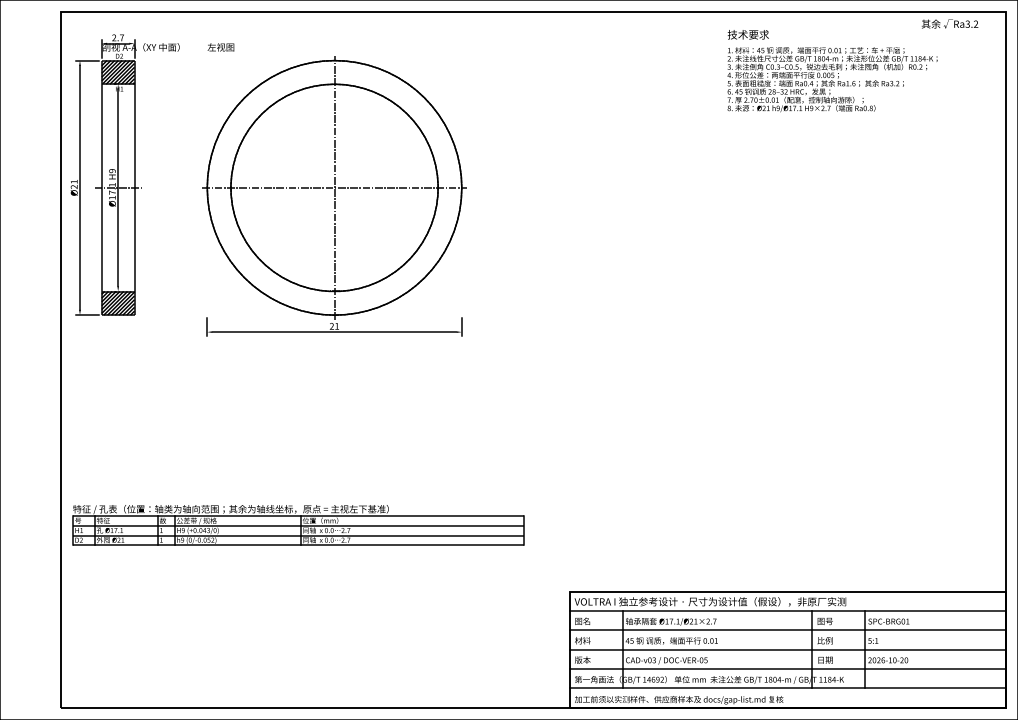
downloads/drawings/SPC-BRG01.png
