merlinwwu/voltra-i-ref-3d/downloads/BOM_VOLTRA-I-REF_CAD-v03.csv

ID | 名称 | 数量 | 上级装配 | 子系统 | 材料建议 | 自制/外购 | 来源等级 | 标准/规格 | 关键尺寸 | 估算质量 g（单件合计） | 质量来源
HSG-MAIN-01-UPR | 主壳体·上半壳 | 1 | HSG-MAIN-01 | 壳体 | AZ91D 镁合金压铸（T4），外表面喷砂+阳极/喷涂 | 自制 | 官方外形+假设 |  | 205.5×69.5×100 半壳，壁厚 3.0，截面 R12；拔模 外 0.5°/内 1°（图纸注） | 207.5 | 体积×密度
HSG-MAIN-01-LWR | 主壳体·下半壳 | 1 | HSG-MAIN-01 | 壳体 | AZ91D 镁合金压铸（T4） | 自制 | 官方外形+假设 |  | 同上半壳；含 USB-C 开口、制动电阻凸台；分型面贴 0.8 mm 密封胶条 | 215.3 | 体积×密度
HSG-END-L-01 | 左端盖 / 电池仓盖 | 1 | TOP-ASSY-01 | 壳体 | AZ91D 压铸 / 6061-T6 机加 | 自制 | 视频（4 颗内六角）+假设 |  | 139×100×4，4×M4 ISO 10642 沉头 | 98.8 | 体积×密度
SCR-END-L-01 | 电池仓盖螺钉 M4×12 ISO 10642 沉头内六角 ×4 | 4 | HSG-END-L-01 | 紧固件/挡圈/销 | 10.9 级钢 镀锌镍 | 外购 | 标准件 | ISO 10642 | M4×12，拧紧 2.6 N·m（Mg 螺纹，限扭），旋合 8 = 2d | 5.3 | 体积×密度
HSG-FRAME-01 | 中隔板 / 骨架（电池仓与卷筒仓分隔，前后半壳横筋槽定位） | 1 | TOP-ASSY-01 | 壳体 | 6061-T6 铝板机加 | 自制 | 假设 |  | 厚 6，轮廓随内腔 133×94 R9（-0.2）；BRG-03-HSG 止口 Ø43 H8；4×M3、2×M3 沉头（蜗杆支架）+ Ø3 销孔、M4 沉头 + Ø3 销孔（桥架） | 160.1 | 体积×密度
BAT-MOD-01 | 可换电池包（57.6 V / 1.7 Ah / 97.9 Wh） | 1 | TOP-ASSY-01 | 电源 | 圆柱电芯 16S1P + PC/ABS 外壳 + 支撑杆 + 弹性导热垫（专利 WO2024175034A1） | 外购（定制） | 官方 |  | 94×94×89（官方外形）；电芯型号未定 | 800.0 | 假设（16 颗圆柱电芯 + 外壳）
BAT-CONN-01 | 电池快插连接器（主机侧） | 1 | HSG-FRAME-01 | 电源 | PA66-GF + 铜合金镀银 | 外购 | 官方（快插）+假设（型号） |  | 20×13.5 外形占位，≥50 A 连续（按 47 A 峰值） | 4.9 | 体积×密度
MOT-STAT-01 | 无框定子（基准：Allied MF0095056，48 V 绕组） | 1 | MOT-ASSY-01 | 电机 | 硅钢叠片 + 铜绕组 | 外购 | 官方（Allied 数据表） |  | Ø94.742×55.2，端部绕组 Ø89.92/Ø73.15、高 11.43/5.08；胶接于 MOT-HSG（Loctite 638 类） | 1350.1 | 官方（MF0095056 套件 1.76 kg 按体积分摊）
ROT-01 | 内转子（SPM 磁钢 + 轭） | 1 | MOT-ASSY-01 | 电机 | 钕铁硼 + 钢轭 | 外购 | 官方（长度/内径） |  | Ø58.42 内孔 ×60.5 | 409.9 | 官方（MF0095056 套件 1.76 kg 按体积分摊）
MOT-SHAFT-01 | 电机轴（DIN 5480 外花键 + 转子法兰） | 1 | MOT-ASSY-01 | 电机 | 42CrMo4 调质 28–32 HRC，花键感应淬火 50 HRC | 自制 | 假设 |  | W17×1.25×30×12 8f；轴承位 Ø17 k5 Ra0.4；法兰 Ø44×5，6×Ø4.5 PCD34 + 2×Ø3 H7 销孔；左端 M5 深 17 | 287.5 | 体积×密度
ROT-HUB-01 | 转子毂（含 8 叶内置风扇） | 1 | MOT-ASSY-01 | 电机 | 7075-T6 机加 + 硬质阳极 | 自制 | 官方（转子内孔）+专利（内置风扇）+假设 |  | 外套 Ø58.42 g6×60.5（胶接）；腹板 8 厚 6×M4 螺纹深 8；Ø20.5 孔 间隙套轴 | 127.8 | 体积×密度
SCR-HUB-01 | 转子毂螺钉 M4×12 ISO 4762 ×6 | 6 | MOT-ASSY-01 | 紧固件/挡圈/销 | 12.9 级 + 螺纹胶 243 | 外购 | 标准件 | ISO 4762 | M4×12，3.0 N·m（铝内螺纹限扭），预紧 ~5 kN/颗 | 11.2 | 体积×密度
PIN-HUB-01 | 定位销 Ø3 m6×11 ISO 8734 ×2 | 2 | MOT-ASSY-01 | 紧固件/挡圈/销 | 淬硬钢 | 外购 | 标准件 | ISO 8734 | Ø3 m6×11 | 1.2 | 体积×密度
MOT-HSG-01 | 电机壳 / 定子座 / 前轴承座 / 惰轮销座 | 1 | MOT-ASSY-01 | 电机 | 6061-T6 机加（或 A356-T6 铸造+机加） | 自制 | 假设 |  | 定子孔 Ø94.742 H7（胶接），BRG-01 座 Ø35 K6 + DIN 472-35 槽；惰轮销孔 Ø5 R7；桥架止口 Ø6 H7；2×M3（蜗杆支架） | 728.7 | 体积×密度
BRG-01 | 电机前轴承 6003-2RSH（固定端） | 1 | MOT-ASSY-01 | 电机 | GCr15 | 外购 | 标准件 | ISO 15 | 17×35×10，C 6.37 kN，C0 3.25 kN | 42.4 | 体积×密度
BRG-02 | 电机后轴承 6003-2RSH（浮动端，波形弹簧预紧） | 1 | MOT-ASSY-01 | 电机 | GCr15 | 外购 | 标准件 | ISO 15 | 17×35×10，外圈 Ø35 H7 滑动 | 42.4 | 体积×密度
CLP-BRG01 | 孔用挡圈 DIN 472-35×1.5 | 1 | MOT-ASSY-01 | 紧固件/挡圈/销 | 弹簧钢 | 外购 | 标准件 | DIN 472 | DIN 472 35×1.5 | 4.2 | 体积×密度
CLP-BRG02 | 轴用挡圈 DIN 471-17×1 | 1 | MOT-ASSY-01 | 紧固件/挡圈/销 | 弹簧钢 | 外购 | 标准件 | DIN 471 | DIN 471 17×1 | 1.0 | 体积×密度
SPC-BRG01 | 轴承隔套 Ø17.1/Ø21×2.7 | 1 | MOT-ASSY-01 | 电机 | 45 钢 调质，端面平行 0.01 | 自制 | 假设 |  | Ø21 h9/Ø17.1 H9×2.7（端面 Ra0.8） | 2.5 | 体积×密度
ENC-MAG-01 | 编码器磁环（径向充磁，轴上胶接） | 1 | MOT-ASSY-01 | 电子 | NdFeB 粘结 | 外购 | 专利（WO2024175034A1 磁环 570） |  | Ø32/Ø20×3 | 8.8 | 体积×密度
ENC-PCB-01 | 编码器读头板（磁编码 IC） | 1 | MOT-ASSY-01 | 电子 | FR-4 | 自制 | 假设 |  | Ø60/Ø24×1.6，3×M2 固定于端盖腹板 | 7.0 | 体积×密度
MOT-GROM-01 | 相线护套（硅胶） | 1 | MOT-ASSY-01 | 电子 | VMQ 60A | 外购 | 假设 |  | Ø8/Ø5×4 | 0.1 | 体积×密度
HSG-END-R-01 | 右端盖（BRG-02 座、U 型把手、出风格栅） | 1 | TOP-ASSY-01 | 壳体 | 6061-T6 机加（或 A356 铸造） | 自制 | 视频+假设 |  | BRG-02 座 Ø35 H7 + 波形弹簧腔，把手开口 12.5×97（贯穿），4×Ø4.5 贯穿螺栓孔 | 490.2 | 体积×密度
WSPR-BRG02 | 波形弹簧 Ø35×Ø28（预载 40–80 N） | 1 | MOT-ASSY-01 | 电机 | 弹簧钢 / 不锈钢 | 外购 | 标准件（规格待定） |  | 外径 ≤34.8，自由高 ~2，工作高 1.4 | 3.5 | 体积×密度
BOLT-TIE-01 | 贯穿螺栓 M4×102 ×4（定制长度，ISO 4762 头型） | 4 | HSG-END-R-01 | 紧固件/挡圈/销 | 10.9 级 镀锌镍 | 外购（定制） | 视频（数量）+假设 | ISO 4762 头型/定制长度 | M4×102，端盖把手开口内 L 型扳手操作；旋入主壳凸台 7.5（1.9d）；2.5 N·m | 31.6 | 体积×密度
DRUM-01 | 卷筒（左旋螺旋绳槽 P3.2×21 圈，R25，空心轴颈） | 1 | CAB-ASSY-01 | 卷筒与绳 | 6061-T6 机加 + 硬质阳极 25 µm（槽面 Ra0.8） | 自制 | 假设+专利（CN220327890U 金属外壳导热） |  | 槽底 Ø47 / 齿顶 Ø49 / 挡边 Ø56；绕绳段 67.2；轴颈 Ø17 k5（空心 Ø10）；右端止口 Ø24 H7；4×Ø3 G7 销孔 PCD32 | 272.0 | 体积×密度
DRUM-CLAMP-01 | 绳端压线块（弧形压槽 + 交错压齿，专利 CN220596688U） | 1 | DRUM-01 | 卷筒与绳 | 6061-T6 | 自制 | 专利 CN220596688U |  | 12.6×9.2×2，M3 沉头；压槽 R1.6 交错齿 0.3（图纸注） | 0.5 | 体积×密度
SCR-CLAMP-01 | 压线块螺钉 M3×10 ISO 10642 | 1 | DRUM-01 | 紧固件/挡圈/销 | 10.9 级 + 螺纹胶 243 | 外购 | 标准件 | ISO 10642 | M3×10，1.0 N·m | 0.6 | 体积×密度
BRG-03 | 卷筒远端轴承 6003-2RSH（浮动端 −1/+0.5） | 1 | CAB-ASSY-01 | 卷筒与绳 | GCr15 | 外购 | 标准件 | ISO 15 | 17×35×10，外圈 Ø35 G7 滑动 | 42.4 | 体积×密度
CLP-BRG03 | 轴用挡圈 DIN 471-17×1（卷筒轴颈） | 1 | CAB-ASSY-01 | 紧固件/挡圈/销 | 弹簧钢 | 外购 | 标准件 | DIN 471 | DIN 471 17×1 | 1.0 | 体积×密度
BRG-03-HSG | BRG-03 轴承座（止口入中隔板） | 1 | CAB-ASSY-01 | 卷筒与绳 | 6061-T6 机加 | 自制 | 假设 |  | 止口 Ø43 f7 入 Ø43 H8；轴承孔 Ø35 G7 通孔 12.5 长（浮动 −1/+0.5）；法兰 Ø52.6×3（上侧铣平 y=3.8 让位排线支架）4×Ø3.4 PCD47 | 19.3 | 体积×密度
SCR-BRG03-01 | BRG-03-HSG 螺钉 M3×8 ISO 4762 ×4 | 4 | CAB-ASSY-01 | 紧固件/挡圈/销 | 8.8 级 镀锌 | 外购 | 标准件 | ISO 4762 | M3×8，旋入隔板 5（1.7d），1.1 N·m | 3.2 | 体积×密度
DRUM-HUB-01 | 卷筒毂（DIN 5480 内花键 + 排线主动齿轮 m0.8 z35） | 1 | CAB-ASSY-01 | 卷筒与绳 | 40Cr 调质 + 齿面/花键氮化 | 自制 | 假设 |  | 止口 Ø24 g6；内花键 W17×1.25×30×12 9H；法兰 Ø36.4×3（4×Ø3 N7 PCD32）；齿轮 m0.8 z35 α20° 7 级 da29.6×4 | 68.5 | 体积×密度
PIN-DRUM-01 | 传扭销 Ø3 m6×7 ISO 8734 ×4 | 4 | CAB-ASSY-01 | 紧固件/挡圈/销 | 淬硬钢 | 外购 | 标准件 | ISO 8734 | Ø3 m6×7（毂法兰过盈 / 卷筒 G7 滑配） | 1.6 | 体积×密度
SCR-DRUM-01 | 卷筒中心螺钉 M5×70 ISO 4762 | 1 | CAB-ASSY-01 | 紧固件/挡圈/销 | 12.9 级 + 螺纹胶 243 | 外购 | 标准件 | ISO 4762 | M5×70 + ISO 7092 小垫圈 Ø9（未建模），5.5 N·m，预紧 ~7.9 kN（铝支承面压强 ≤200 MPa）；经空心轴颈 Ø10 用 4 mm 长柄扳手 | 9.5 | 体积×密度
LW-WORM-01 | 排线蜗杆轴（m0.8 z1=1 d1=16 左旋，整体式，自锁） | 1 | LW-01 | 排线 | 20CrMnTi 渗碳淬火 58–62 HRC，齿面磨 Ra0.4（或 42CrMo4 调质 + 氮化） | 自制 | 专利 CN122233236A（蜗杆由卷筒驱动）+假设 |  | 轴向模数 0.8，z1=1，d1 16，da 17.6，df 14.08，λ=2.86° 左旋，螺纹长 18；左 Ø6 h5（HK0608），右 Ø6 k5（626）+ DIN 471-6 槽；Ø1.5 横销孔 | 41.2 | 体积×密度
LW-GEAR-01 | 蜗杆轴齿轮 m0.8 z21（横销） | 1 | LW-01 | 排线 | 40Cr 调质 + 氮化 | 自制 | 假设 |  | m0.8 z21 α20° 7 级 da18.4×4；孔 Ø6 H7；Ø1.5 横销与轴配钻 | 5.7 | 体积×密度
PIN-LWG-01 | 齿轮横销 Ø1.5×10 ISO 8752 弹性销 | 1 | LW-01 | 紧固件/挡圈/销 | 弹簧钢 | 外购 | 标准件 | ISO 8752 | Ø1.5×10 | 0.1 | 体积×密度
CLP-LW-02 | 轴用挡圈 DIN 471-6×0.7（蜗杆轴右端） | 1 | LW-01 | 紧固件/挡圈/销 | 弹簧钢 | 外购 | 标准件 | DIN 471 | DIN 471 6 | 0.2 | 体积×密度
LW-SPC-01 | 蜗杆轴隔套 Ø6.1/Ø9×4.5（626 内圈 ↔ 齿轮） | 1 | LW-01 | 排线 | 45 钢 发黑 | 自制 | 假设 |  | Ø9 h11/Ø6.1 H11×4.5 | 1.2 | 体积×密度
LW-BRG-01 | 蜗杆固定端轴承 626-2RS（承蜗杆轴向力） | 1 | LW-01 | 排线 | GCr15 | 外购 | 标准件 | ISO 15 | 6×19×6，C 2.34 / C0 0.95 kN（按样本核对） | 8.7 | 体积×密度
CLP-LW-01 | 孔用挡圈 DIN 472-19×1 ×2（626 外圈两侧） | 2 | LW-01 | 紧固件/挡圈/销 | 弹簧钢 | 外购 | 标准件 | DIN 472 | DIN 472 19 ×2 | 2.1 | 体积×密度
LW-NDL-01 | 蜗杆浮动端滚针轴承 HK0608 | 1 | LW-01 | 排线 | GCr15 | 外购 | 标准件 | ISO 3245 | 6×10×8（轴颈 Ø6 h5 淬硬 ≥58 HRC） | 1.9 | 体积×密度
LW-IDL-01 | 惰轮 m0.8 z24（压装含油衬套） | 1 | LW-01 | 排线 | 40Cr 调质 + 氮化（或 POM-C 降噪，待试验） | 自制 | 假设 |  | m0.8 z24 α20° 7 级 da20.8×4；孔 Ø8 H7 压装衬套 | 7.3 | 体积×密度
LW-IDL-BUSH-01 | 惰轮衬套 Ø5/Ø8×4（烧结青铜含油） | 1 | LW-01 | 排线 | 烧结青铜含油 CuSn10 | 外购 | 标准件（规格） |  | Ø5 F7/Ø8 s7 ×4 | 0.9 | 体积×密度
LW-IDL-PIN-01 | 惰轮销 Ø5×14.5 带头（压入电机壳） | 1 | LW-01 | 排线 | GCr15 淬硬 / 45 钢淬火 | 自制 | 假设 |  | Ø5 g6（衬套）/ Ø5 p6（压入 10）；头 Ø8×0.7 | 2.5 | 体积×密度
LW-BOX-01 | 蜗杆支架 / 蜗杆箱体（纵梁 + HK0608 座 + 626 座，隔板 ↔ 电机壳） | 1 | LW-01 | 排线 | 6061-T6 CNC（两轴承孔同一装夹） | 自制 | 假设 |  | 纵梁 3.5×14 长 104.5；HK0608 座 Ø10 N7；626 座 Ø19 K6 + DIN 472-19 槽 + 挡肩 Ø15；左 2×M3 + Ø3 销（隔板），右 2×M3 沉孔（电机壳） | 20.5 | 体积×密度
SCR-LWB-01 | 蜗杆支架螺钉（隔板侧）M3×12 ISO 10642 ×2 | 2 | LW-01 | 紧固件/挡圈/销 | 8.8 级 | 外购 | 标准件 | ISO 10642 | M3×12，旋合 6（2d），1.1 N·m | 1.3 | 体积×密度
SCR-LWB-02 | 蜗杆支架螺钉（电机壳侧）M3×8 ISO 4762 ×2 | 2 | LW-01 | 紧固件/挡圈/销 | 8.8 级 + 螺纹胶 243 | 外购 | 标准件 | ISO 4762 | M3×8，旋入电机壳端壁 4（钢丝螺套 1.5d 需壁厚 4.5 → 端壁局部凸台，见图） | 1.6 | 体积×密度
PIN-LWB-01 | Ø3×8 定位销（蜗杆支架 ↔ 隔板） | 1 | LW-01 | 紧固件/挡圈/销 | 淬硬钢 | 外购 | 标准件 | ISO 8734 | Ø3 m6×8 | 0.4 | 体积×密度
LW-BRIDGE-01 | 桥架（承摆轴销，连隔板与电机壳；装限位开关/霍尔板） | 1 | LW-01 | 排线 | 7075-T6 机加 | 自制 | 假设 |  | 截面 20×12，长 105；摆轴销孔 Ø12 N7；左 M4 + Ø3 销，右 Ø6 g6 止口销入 MOT-HSG；3×M2.5 螺纹（开关/霍尔） | 79.8 | 体积×密度
PIN-BRG-01 | Ø3×10 定位销（桥架 ↔ 隔板） | 1 | LW-01 | 紧固件/挡圈/销 | 淬硬钢 | 外购 | 标准件 | ISO 8734 | Ø3 m6×10 | 0.5 | 体积×密度
SCR-BRIDGE-01 | 桥架螺钉 M4×14 ISO 10642 | 1 | LW-01 | 紧固件/挡圈/销 | 10.9 级 | 外购 | 标准件 | ISO 10642 | M4×14，2.6 N·m | 1.4 | 体积×密度
EXIT-PIN-01 | 摆轴销 Ø12（压入桥架，悬臂 22） | 1 | LW-01 | 排线 | 42CrMo4 调质 28–32 HRC，轴承位磨 | 自制 | 假设 |  | Ø12 p6（桥架 12）/ Ø12 k5（6201×2）；肩 Ø15×1；DIN 471-12 槽 | 31.0 | 体积×密度
EXIT-BRG-02 | 摆座下轴承 6201-2RS（承外拉轴向力 F + 径向） | 1 | LW-01 | 排线 | GCr15 | 外购 | 标准件 | ISO 15 | 12×32×10，C 6.89 / C0 3.1 kN（按样本核对）；Fa = F | 39.9 | 体积×密度
EXIT-BRG-01 | 摆座上轴承 6201-2RS（径向） | 1 | LW-01 | 排线 | GCr15 | 外购 | 标准件 | ISO 15 | 12×32×10；外圈 K6 + 638 胶 | 39.9 | 体积×密度
CLP-EXIT-01 | 轴用挡圈 DIN 471-12×1（摆轴销顶） | 1 | LW-01 | 紧固件/挡圈/销 | 弹簧钢 | 外购 | 标准件 | DIN 471 | DIN 471 12 | 0.6 | 体积×密度
EXIT-SWV-01 | 摆座（毂 + 转向轮叉板 + 臂安装座，绕出线口轴线摆动 ±41.4°） | 1 | LW-01 | 排线 | 7075-T6 CNC + 硬质阳极 | 自制 | 专利 CN122233236A（摆座绕出线口转动）+假设 |  | 毂孔 Ø32 K6，底部挡肩 Ø27（承外拉 F）；叉板 2.5 厚、轮轴孔 Ø6 H7（距轴 9.00，z=34）；4×M3 螺纹（装导线臂） | 26.1 | 体积×密度
LW-MAG-01 | 摆角磁环（多极，胶接于摆座毂外圆） | 1 | EXIT-SWV-01 | 电子 | 粘结 NdFeB 多极充磁 | 外购 | 专利 CN122233236A（霍尔 + 磁环检测摆角） |  | Ø41/Ø37×4 | 5.9 | 体积×密度
LW-HALL-01 | 摆角霍尔传感器板（线性霍尔 ×2，正交，型号待定） | 1 | LW-BRIDGE-01 | 电子 | FR-4 + 霍尔 IC | 自制 | 专利 CN122233236A |  | 12×9×1.6 立装 + 支脚，M2.5 固定于桥架 | 0.4 | 体积×密度
LW-LIMIT-01 | 摆角极限微动开关 ×2（含支架，限位凸块触发） | 2 | LW-BRIDGE-01 | 排线 | 外购 | 外购 | 专利 CN122233236A（限位开关） |  | 超小型微动 + 支架 6×4×15 占位；触发 |θ| = 43.4°（工作 ±41.4°） | 1.5 | 体积×密度
LW-ARM-01 | 导线臂（承导向对轮，随摆座摆动） | 1 | EXIT-SWV-01 | 排线 | 7075-T6 CNC + 硬质阳极 | 自制 | 专利 CN122233236A（导线臂 + 导向对轮） |  | 厚 3，臂长 38.98（对轮中心）；对轮销孔 2×Ø6 N7 间距 16.3；4×M3 沉头（装摆座）；4×M3 螺纹（装蜗轮扇形） | 6.4 | 体积×密度
SCR-LWA-01 | 导线臂螺钉 M3 ISO 10642 ×4（M3×8 ×2 + M3×6 ×2） | 4 | EXIT-SWV-01 | 紧固件/挡圈/销 | 10.9 级 + 螺纹胶 243 | 外购 | 标准件 | ISO 10642 | M3，1.2 N·m | 1.9 | 体积×密度
LW-WHEEL-01 | 蜗轮扇形 m0.8 z2=120（±47°，CuSn12，与摆座同心） | 1 | EXIT-SWV-01 | 排线 | CuSn12 离心铸造 / 连铸棒，滚齿 | 自制 | 专利 CN122233236A（自锁蜗轮与摆座同心）+假设 |  | m0.8 z2=120 左旋 β=2.86°，d2 96，齿宽 10，扇形 ±47°（≈31 齿），腹板 3；4×M3 沉头装导线臂 | 41.7 | 体积×密度
SCR-LWW-01 | 蜗轮扇形螺钉 M3×6 ISO 10642 ×4 | 4 | EXIT-SWV-01 | 紧固件/挡圈/销 | 10.9 级 + 螺纹胶 243 | 外购 | 标准件 | ISO 10642 | M3×6，1.0 N·m（旋入导线臂 3 + 钢丝螺套） | 1.7 | 体积×密度
LW-ROL-01 | 导向对轮 Ø13×8 ×2（绳从两轮切点间穿过） | 2 | LW-ARM-01 | 排线 | 440C 淬硬 58 HRC 抛光 Ra0.2 | 自制 | 专利 CN122233236A（导向对轮） |  | Ø13 h7/Ø10 N7×8，外圆两端 R0.8；对轮缝 3.3（绳 Ø3） | 6.8 | 体积×密度
LW-NDL-02 | 对轮滚针轴承 HK0608 ×2 | 2 | LW-ARM-01 | 排线 | GCr15 | 外购 | 标准件 | ISO 3245 | 6×10×8 | 3.8 | 体积×密度
LW-PIN-01 | 对轮销 Ø6×12.6 ×2（压入导线臂，下端 E 型挡圈） | 2 | LW-ARM-01 | 排线 | GCr15 淬硬 60 HRC | 自制 | 假设 |  | Ø6 p6（臂）/ h5（滚针）；DIN 6799-5 挡圈槽 | 5.5 | 体积×密度
EXIT-SHV-01 | 中心转向轮（槽底 Ø14.6，绳 90° 转向沿摆轴出线） | 1 | EXIT-SWV-01 | 排线 | 440C 淬硬抛光 | 自制 | 专利 CN122233236A（绳沿出线口轴线引出）+假设 |  | Ø20×8，槽 R1.7 槽底 Ø14.6，孔 Ø10 N7（HK0608） | 11.5 | 体积×密度
EXIT-NDL-01 | 转向轮滚针轴承 HK0608 | 1 | EXIT-SWV-01 | 排线 | GCr15 | 外购 | 标准件 | ISO 3245 | 6×10×8 | 1.9 | 体积×密度
EXIT-AXL-01 | 转向轮轴 Ø6×14 | 1 | EXIT-SWV-01 | 排线 | GCr15 淬硬 | 自制 | 假设 |  | Ø6 h5×14，两端 DIN 6799 挡圈（图纸注） | 3.1 | 体积×密度
EXIT-BASE-01 | 出线底板 / 卷筒仓前盖（黑色方板） | 1 | EXIT-ASSY-01 | 出线口 | 6061-T6 机加 + 黑色阳极 | 自制 | 照片（黑色方板 4 螺钉）+假设 |  | 95×110×6 R6；喇叭口座孔 Ø10 H7；下表面让位 Ø41×1.2 + 626 座让位；4×M3 沉头 | 124.7 | 体积×密度
SCR-EXIT-01 | 底板螺钉 M3×10 ISO 10642 ×4（入壳体凸台钢丝螺套） | 4 | EXIT-ASSY-01 | 紧固件/挡圈/销 | 10.9 级 黑色 | 外购 | 标准件（照片为十字盘头，此处改沉头以不超包络） | ISO 10642 | M3×10，1.1 N·m | 2.4 | 体积×密度
EXIT-GUIDE-01 | 抛光喇叭口导绳嘴（压入底板，360° 出绳） | 1 | EXIT-ASSY-01 | 出线口 | 304 不锈钢 抛光 Ra0.1 | 自制 | 专利 CN220213802U（抛光金属导线块）改为整圈喇叭口 |  | 喉部 Ø5，出口 Ø15，凸缘 Ø17；Ø10 p6 压入底板 | 5.2 | 体积×密度
EXIT-UNI-01 | 出线罩环（白色，卡在喇叭口凸缘上） | 1 | EXIT-ASSY-01 | 出线口 | PA66-GF30 白色 | 自制 | 照片（白色罩） |  | Ø23×3（凸出包络 3 / 喇叭口 4.5，见待决事项 D2） | 0.6 | 体积×密度
LBL-SAFETY-01 | 橙色安全提示环 | 1 | EXIT-UNI-01 | 出线口 | PET 标签 | 外购 | 照片 |  | 环形标签 Ø23/Ø20×0.3 | 0.0 | 体积×密度
CABLE-01 | 训练绳 Ø3×2.6 m（图示出绳 1.0 m） | 1 | CAB-ASSY-01 | 卷筒与绳 | UHMWPE（SK78）12 股编织 + 涂层（材质未确认） | 外购（可换件） | 官方（可换）+照片 |  | Ø3.0；图示缠绕 13.19 圈（含死圈 3），摆角 θ=9.55°；MBL 典型 ~9 kN（按供应商核对） | 14.1 | 体积×密度
CONN-01 | 绳头接头（绕线架 + 卡口，专利 CN220668264U） | 1 | CABLE-01 | 卷筒与绳 | 7075-T6 / 钛合金 + PA 外壳 | 自制 | 专利 CN220668264U+官方外形量级 |  | Ø36×20 绕线架（4 卡口）+ R12 挂环（示意） | 41.4 | 体积×密度
PCB-MAIN-01 | 主控/驱动板（三相逆变 + 斩波 + MCU；元件示意） | 1 | HSG-MAIN-01 | 电子 | FR-4 4 层 2 oz | 自制 | 推测 |  | 88×120×1.6，Dock 让位孔 Ø64；MOSFET 下表面经 TIM 贴背壁 | 35.6 | 体积×密度
PCB-HS-01 | 功率级导热块（PCB 底面 → 背壁） | 1 | PCB-MAIN-01 | 电子 | 6061 铝块 | 自制 | 专利（导热传热）+假设 |  | 18×28×6，经 1 mm 导热垫贴背壁 | 7.3 | 体积×密度
PCB-TIM-01 | 导热垫 1 mm | 1 | PCB-MAIN-01 | 电子 | 硅胶导热垫 6 W/m·K | 外购 | 假设 |  | 18×28×1 | 1.3 | 体积×密度
SCR-PCB-01 | PCB 螺钉 M3×6 ISO 7380 ×4 | 4 | PCB-MAIN-01 | 紧固件/挡圈/销 | 8.8 级 | 外购 | 标准件 | ISO 7380 | M3×6，0.6 N·m | 2.1 | 体积×密度
LCD-01 | 4 寸 LCD 显示屏模组 | 1 | HSG-MAIN-01 | 电子 | TFT + 盖板玻璃 | 外购 | 视频+照片 |  | 86.5×67×4（外形假设） | 58.0 | 体积×密度
MOD-UNK-01 | 卷筒旁黑色模块（照片「SES2」，用途未知，占位） | 1 | HSG-MAIN-01 | 电子 | 未知 | — | 照片·待确认 |  | 30×30×20 占位（v03 为桥架让位减薄，尺寸待实测） | 21.6 | 体积×密度
BRK-R-01 | 制动电阻（铝壳，经导热垫贴下壳，专利 CN220530583U） | 1 | HSG-MAIN-01 | 电源 | 铝壳厚膜 / 绕线电阻 | 外购 | 专利 CN220530583U+推测 |  | 66×16×40 外形占位；阻值按母线 60 V 斩波计算（见设计文档） | 130.1 | 体积×密度
BRK-PAD-01 | 制动电阻导热垫 1 mm | 1 | BRK-R-01 | 电源 | 硅胶导热垫 | 外购 | 专利 CN220530583U |  | 70×40×1 | 7.9 | 体积×密度
SCR-BRK-01 | 制动电阻螺钉 M4×8 ISO 4762 ×2 | 2 | BRK-R-01 | 紧固件/挡圈/销 | 8.8 级 | 外购 | 标准件 | ISO 4762 | M4×8，2.0 N·m | 3.2 | 体积×密度
BRK-TEMP-01 | 制动电阻 NTC | 1 | BRK-R-01 | 电源 | NTC 10k | 外购 | 专利 CN220530583U（温度传感器） |  | 10×2×6 占位 | 0.6 | 体积×密度
DOCK-IF-01 | 背面 Dock 插座（插槽 Ø40，法兰内侧承压） | 1 | HSG-MAIN-01 | 对接 | 6061-T6 / 17-4PH（插槽受 785 N） | 自制 | 专利 CN122407665A + 视频 |  | 插槽 Ø40 H8 深 12；法兰 Ø94×4 贴壳内壁承压；4×M3 自背面沉头（定位，承载靠法兰压壳） | 120.1 | 体积×密度
DOCK-HOOK-01 | Dock 枢转卡钩（扭簧复位，专利 CN122407665A） | 1 | DOCK-IF-01 | 对接 | 17-4PH 淬硬 | 自制 | 专利 CN122407665A |  | 8×4×8 钩，Ø3 销孔；钩舌进入插槽 1.4 | 1.8 | 体积×密度
DOCK-PIN-01 | 卡钩销 Ø3×6 | 1 | DOCK-IF-01 | 紧固件/挡圈/销 | 淬硬钢 | 外购 | 标准件 | ISO 8734 | Ø3×6（法兰槽内） | 0.3 | 体积×密度
SMART-LOCK-01 | Dock 自动锁止执行器（N20 电机 + 凸轮，占位） | 1 | DOCK-IF-01 | 对接 | 外购 | 外购 | 官方（功能）+假设 |  | 11×16×8.4 占位；凸轮推卡钩尾 | 4.4 | 体积×密度
SCR-DOCK-01 | Dock 法兰螺钉 M3×6 ISO 10642 ×4 | 4 | DOCK-IF-01 | 紧固件/挡圈/销 | 10.9 级 黑色 | 外购 | 标准件 | ISO 10642 | M3×6，1.0 N·m | 1.8 | 体积×密度
（装配体/功能组，不单独建模）
TOP-ASSY-01 | 装配体 / 功能组
HSG-MAIN-01（= -UPR + -LWR） | 装配体 / 功能组
MOT-ASSY-01 | 装配体 / 功能组
CAB-ASSY-01 | 装配体 / 功能组
LW-01 | 装配体 / 功能组
EXIT-ASSY-01 | 装配体 / 功能组
DOCK-ASSY-01 | 装配体 / 功能组
BMS-01 | 电池管理板（在 BAT-MOD-01 内，未建模） | 1 | BAT-MOD-01 | 电源 | — | 外购（定制） | 推测
注：独立参考设计，非原厂数据；尺寸未经实测；标准件为本参考设计选型，不是原机零件型号。
