merlinwwu/voltra-i-ref-3d/downloads/drawings/ASSY-01-BOM-2.png

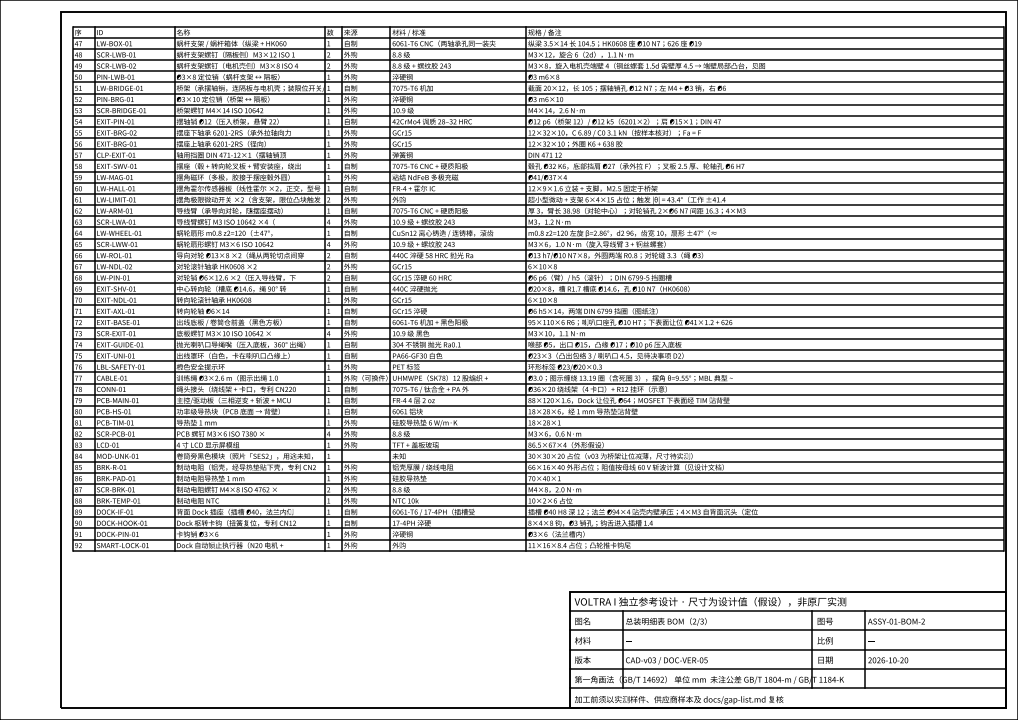
downloads/drawings/ASSY-01-BOM-2.png
