merlinwwu/voltra-i-ref-3d/downloads/drawings/ASSY-01-BOM-3.png

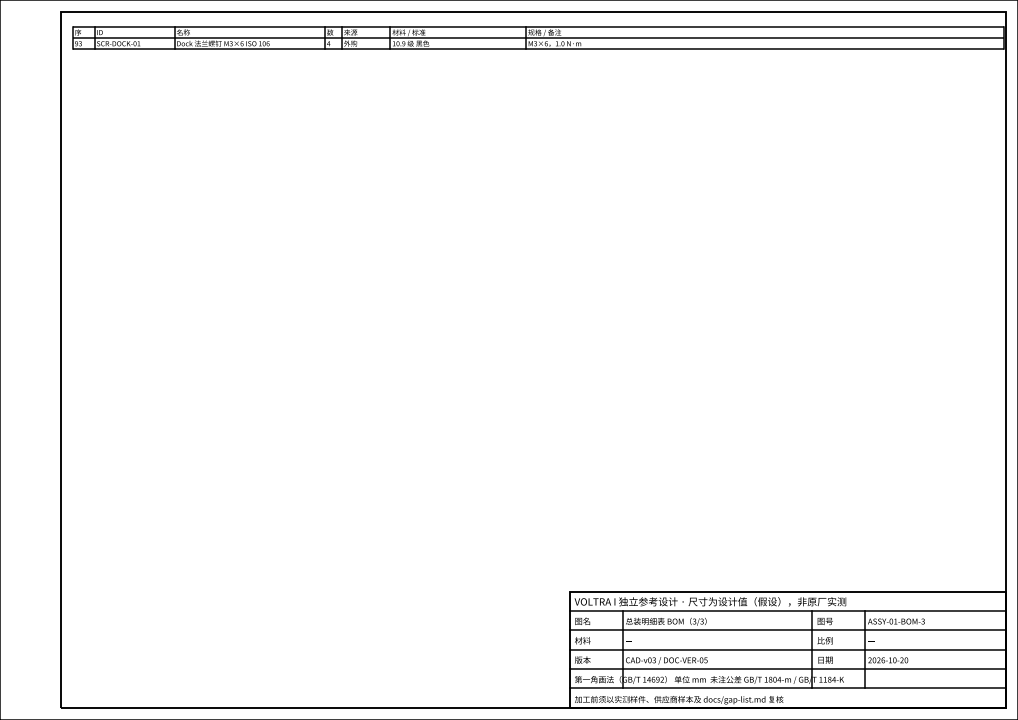
downloads/drawings/ASSY-01-BOM-3.png
