merlinwwu/voltra-i-ref-3d/downloads/step/TOP-ASSY-01.step

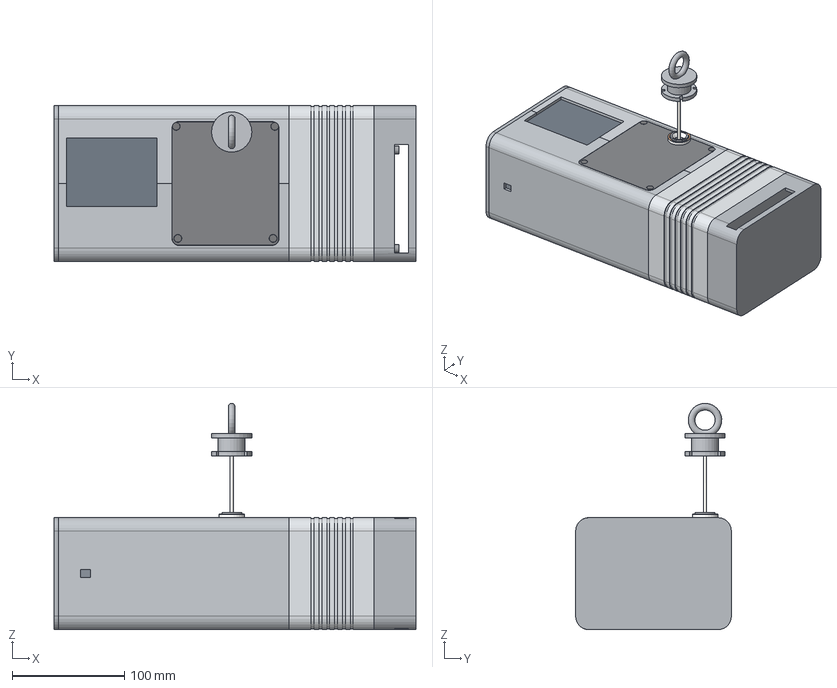
[picture p41: CAD file, 2026-10-20]
downloads/step/TOP-ASSY-01.step
323.0 x 139.0 x 202.0 mm
HSG-END-L-01
SCR-END-L-01
HSG-FRAME-01
BAT-MOD-01
HSG-END-R-01
BOLT-TIE-01
DRUM-01
DRUM-CLAMP-01
SCR-CLAMP-01
BRG-03
CLP-BRG03
BRG-03-HSG
SCR-BRG03-01
DRUM-HUB-01
PIN-DRUM-01
SCR-DRUM-01
CABLE-01
CONN-01
EXIT-BASE-01
SCR-EXIT-01
EXIT-GUIDE-01
EXIT-UNI-01
LBL-SAFETY-01
LW-WORM-01
LW-GEAR-01
PIN-LWG-01
CLP-LW-02
LW-SPC-01
LW-BRG-01
CLP-LW-01
LW-NDL-01
LW-IDL-01
LW-IDL-BUSH-01
LW-IDL-PIN-01
LW-BOX-01
SCR-LWB-01
SCR-LWB-02
PIN-LWB-01
LW-BRIDGE-01
PIN-BRG-01
SCR-BRIDGE-01
EXIT-PIN-01
EXIT-BRG-02
EXIT-BRG-01
CLP-EXIT-01
EXIT-SWV-01
LW-MAG-01
LW-HALL-01
LW-LIMIT-01
LW-ARM-01
SCR-LWA-01
LW-WHEEL-01
SCR-LWW-01
LW-ROL-01
LW-NDL-02
LW-PIN-01
EXIT-SHV-01
EXIT-NDL-01
EXIT-AXL-01
MOT-STAT-01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
