merlinwwu/voltra-i-ref-3d/downloads/drawings/ASSY-01-B.dxf

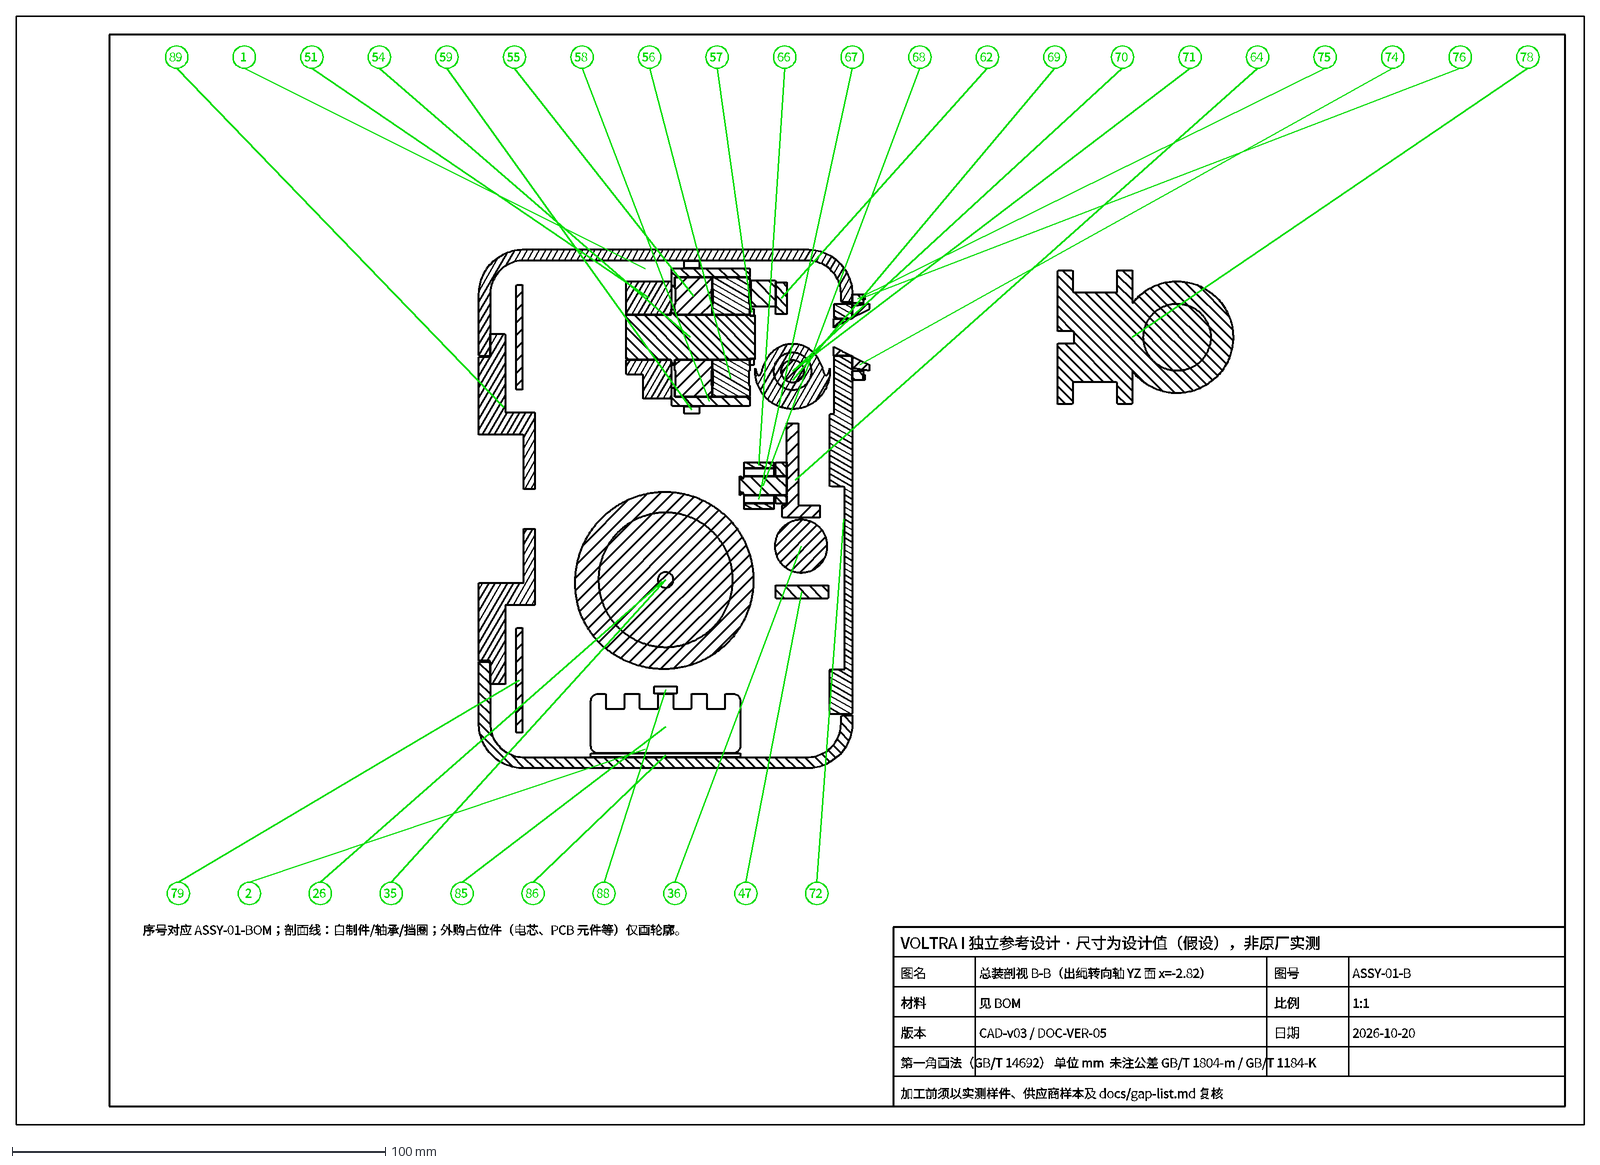
[picture p42: CAD file, 2026-10-20]
downloads/drawings/ASSY-01-B.dxf
89
1
51
54
59
55
58
56
57
66
67
68
62
69
70
71
64
75
74
76
78
79
2
26
35
85
86
88
36
47
72
序号对应 ASSY-01-BOM；剖面线：自制件/轴承/挡圈；外购占位件（电芯、PCB 元件等）仅画轮廓。
VOLTRA I 独立参考设计 · 尺寸为设计值（假设），非原厂实测
图名
总装剖视 B-B（出绳转向轴 YZ 面 x=-2.82）
图号
ASSY-01-B
材料
见 BOM
比例
1:1
版本
CAD-v03 / DOC-VER-05
日期
2026-10-20
第一角画法（GB/T 14692） 单位 mm 未注公差 GB/T 1804-m / GB/T 1184-K
加工前须以实测样件、供应商样本及 docs/gap-list.md 复核
