merlinwwu/voltra-i-ref-3d/downloads/drawings/ASSY-01-A.dxf

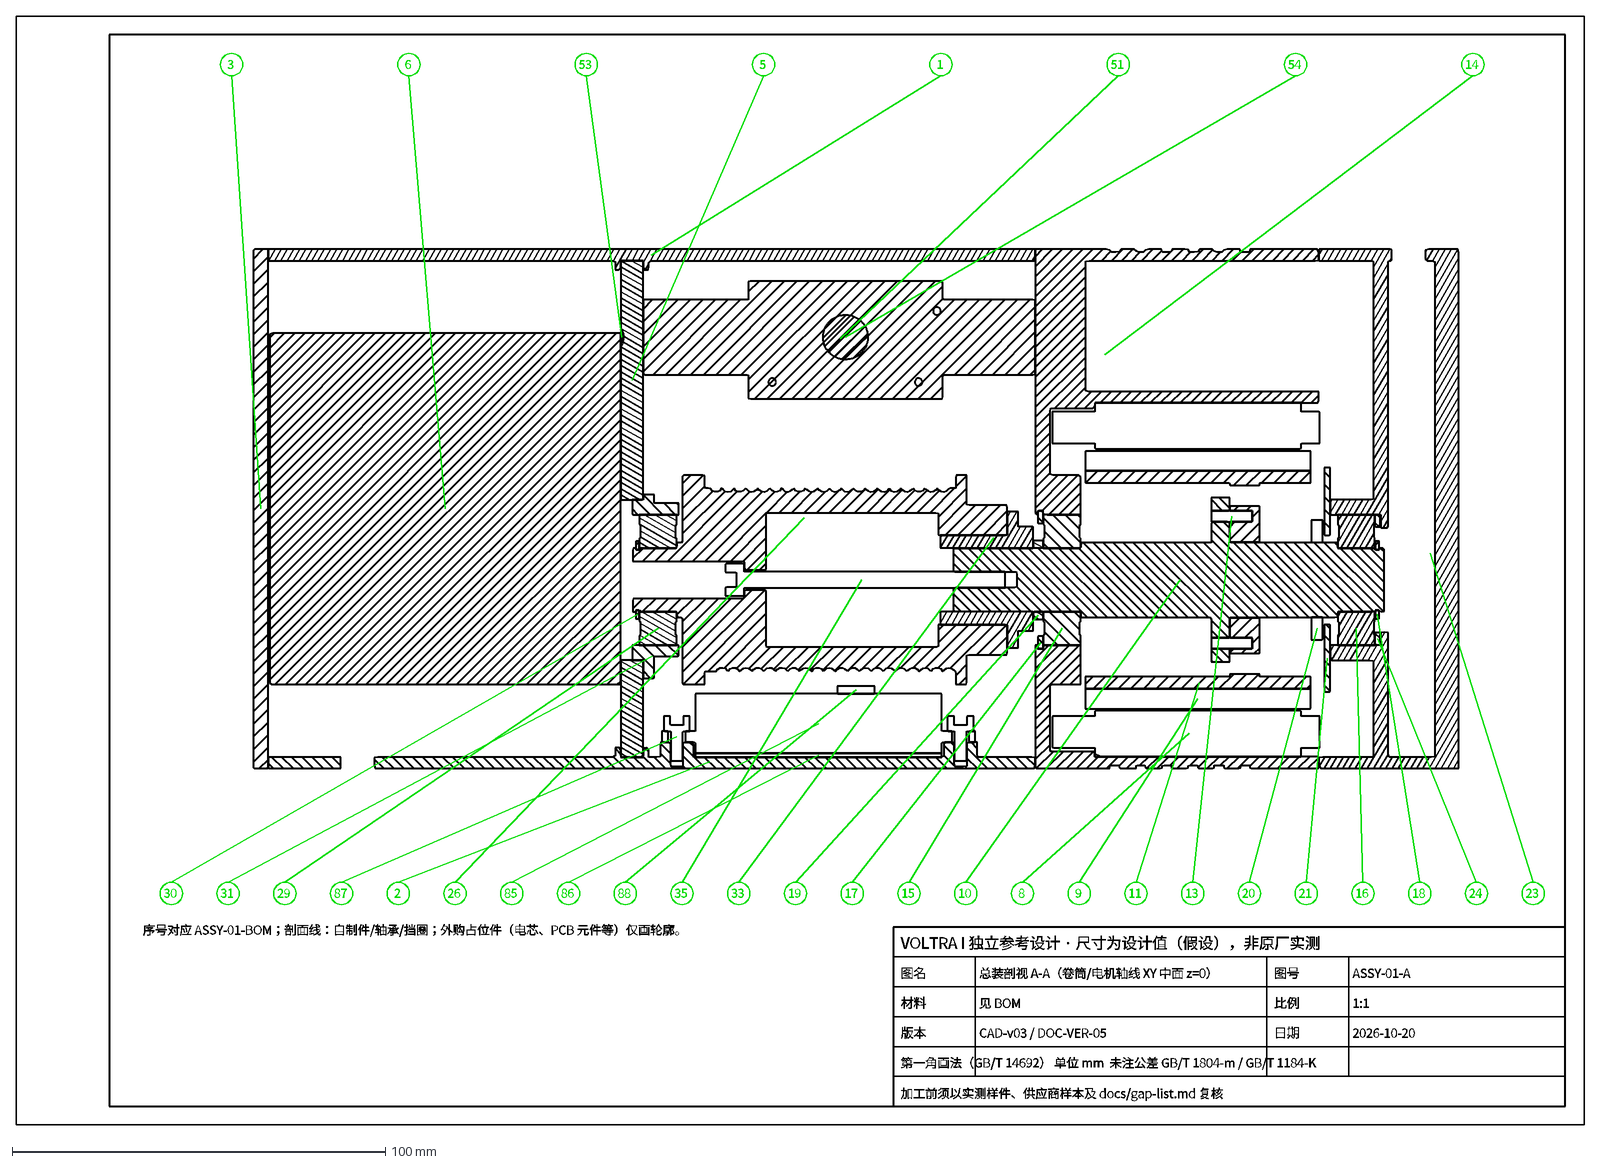
[picture p43: CAD file, 2026-10-20]
downloads/drawings/ASSY-01-A.dxf
3
6
53
5
1
51
54
14
30
31
29
87
2
26
85
86
88
35
33
19
17
15
10
8
9
11
13
20
21
16
18
24
23
序号对应 ASSY-01-BOM；剖面线：自制件/轴承/挡圈；外购占位件（电芯、PCB 元件等）仅画轮廓。
VOLTRA I 独立参考设计 · 尺寸为设计值（假设），非原厂实测
图名
总装剖视 A-A（卷筒/电机轴线 XY 中面 z=0）
图号
ASSY-01-A
材料
见 BOM
比例
1:1
版本
CAD-v03 / DOC-VER-05
日期
2026-10-20
第一角画法（GB/T 14692） 单位 mm 未注公差 GB/T 1804-m / GB/T 1184-K
加工前须以实测样件、供应商样本及 docs/gap-list.md 复核
