merlinwwu/voltra-i-ref-3d/downloads/drawings/ASSY-01-BOM-1.dxf

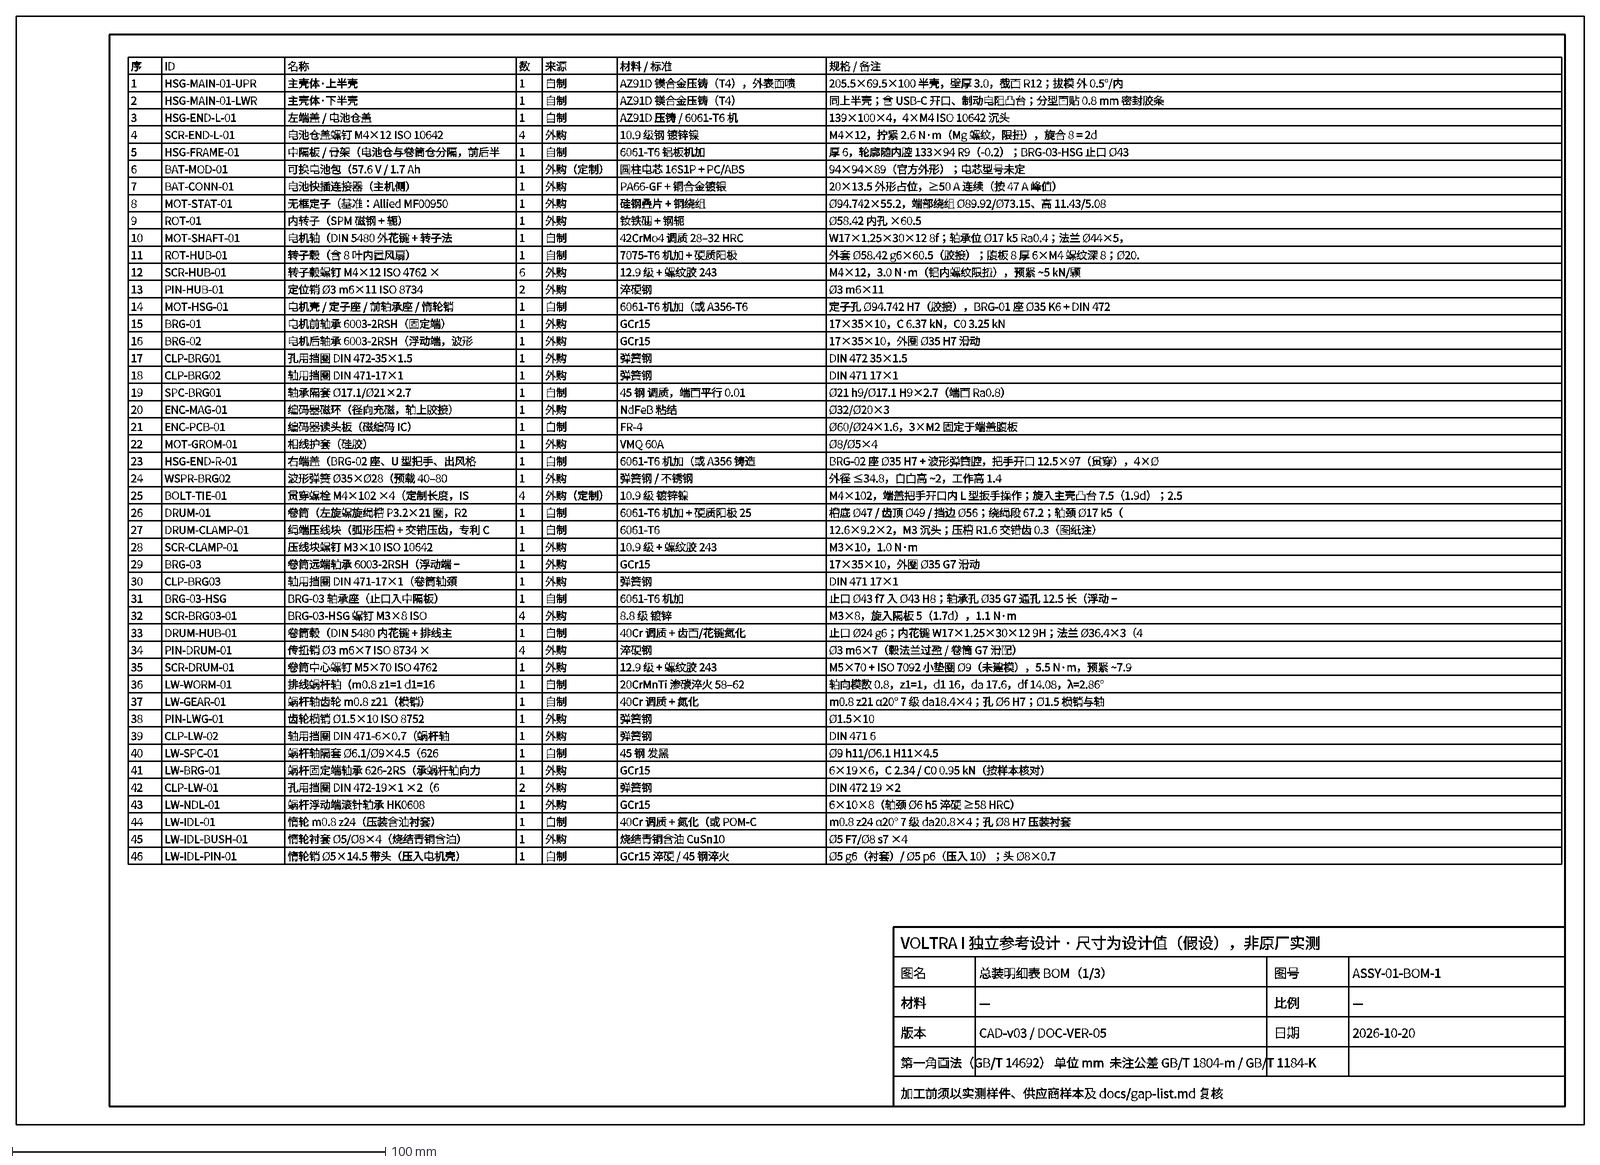
[picture p44: CAD file, 2026-10-20]
downloads/drawings/ASSY-01-BOM-1.dxf
序
ID
名称
数
来源
材料 / 标准
规格 / 备注
1
HSG-MAIN-01-UPR
主壳体·上半壳
自制
AZ91D 镁合金压铸（T4），外表面喷
205.5×69.5×100 半壳，壁厚 3.0，截面 R12；拔模 外 0.5°/内
2
HSG-MAIN-01-LWR
主壳体·下半壳
AZ91D 镁合金压铸（T4）
同上半壳；含 USB-C 开口、制动电阻凸台；分型面贴 0.8 mm 密封胶条
3
HSG-END-L-01
左端盖 / 电池仓盖
AZ91D 压铸 / 6061-T6 机
139×100×4，4×M4 ISO 10642 沉头
4
SCR-END-L-01
电池仓盖螺钉 M4×12 ISO 10642
外购
10.9 级钢 镀锌镍
M4×12，拧紧 2.6 N·m（Mg 螺纹，限扭），旋合 8 = 2d
5
HSG-FRAME-01
中隔板 / 骨架（电池仓与卷筒仓分隔，前后半
6061-T6 铝板机加
厚 6，轮廓随内腔 133×94 R9（-0.2）；BRG-03-HSG 止口 Ø43
6
BAT-MOD-01
可换电池包（57.6 V / 1.7 Ah
外购（定制）
圆柱电芯 16S1P + PC/ABS
94×94×89（官方外形）；电芯型号未定
7
BAT-CONN-01
电池快插连接器（主机侧）
PA66-GF + 铜合金镀银
20×13.5 外形占位，≥50 A 连续（按 47 A 峰值）
8
MOT-STAT-01
无框定子（基准：Allied MF00950
硅钢叠片 + 铜绕组
Ø94.742×55.2，端部绕组 Ø89.92/Ø73.15、高 11.43/5.08
9
ROT-01
内转子（SPM 磁钢 + 轭）
钕铁硼 + 钢轭
Ø58.42 内孔 ×60.5
10
MOT-SHAFT-01
电机轴（DIN 5480 外花键 + 转子法
42CrMo4 调质 28–32 HRC
W17×1.25×30×12 8f；轴承位 Ø17 k5 Ra0.4；法兰 Ø44×5，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
