merlinwwu/voltra-i-ref-3d/downloads/drawings/ASSY-01-BOM-2.dxf

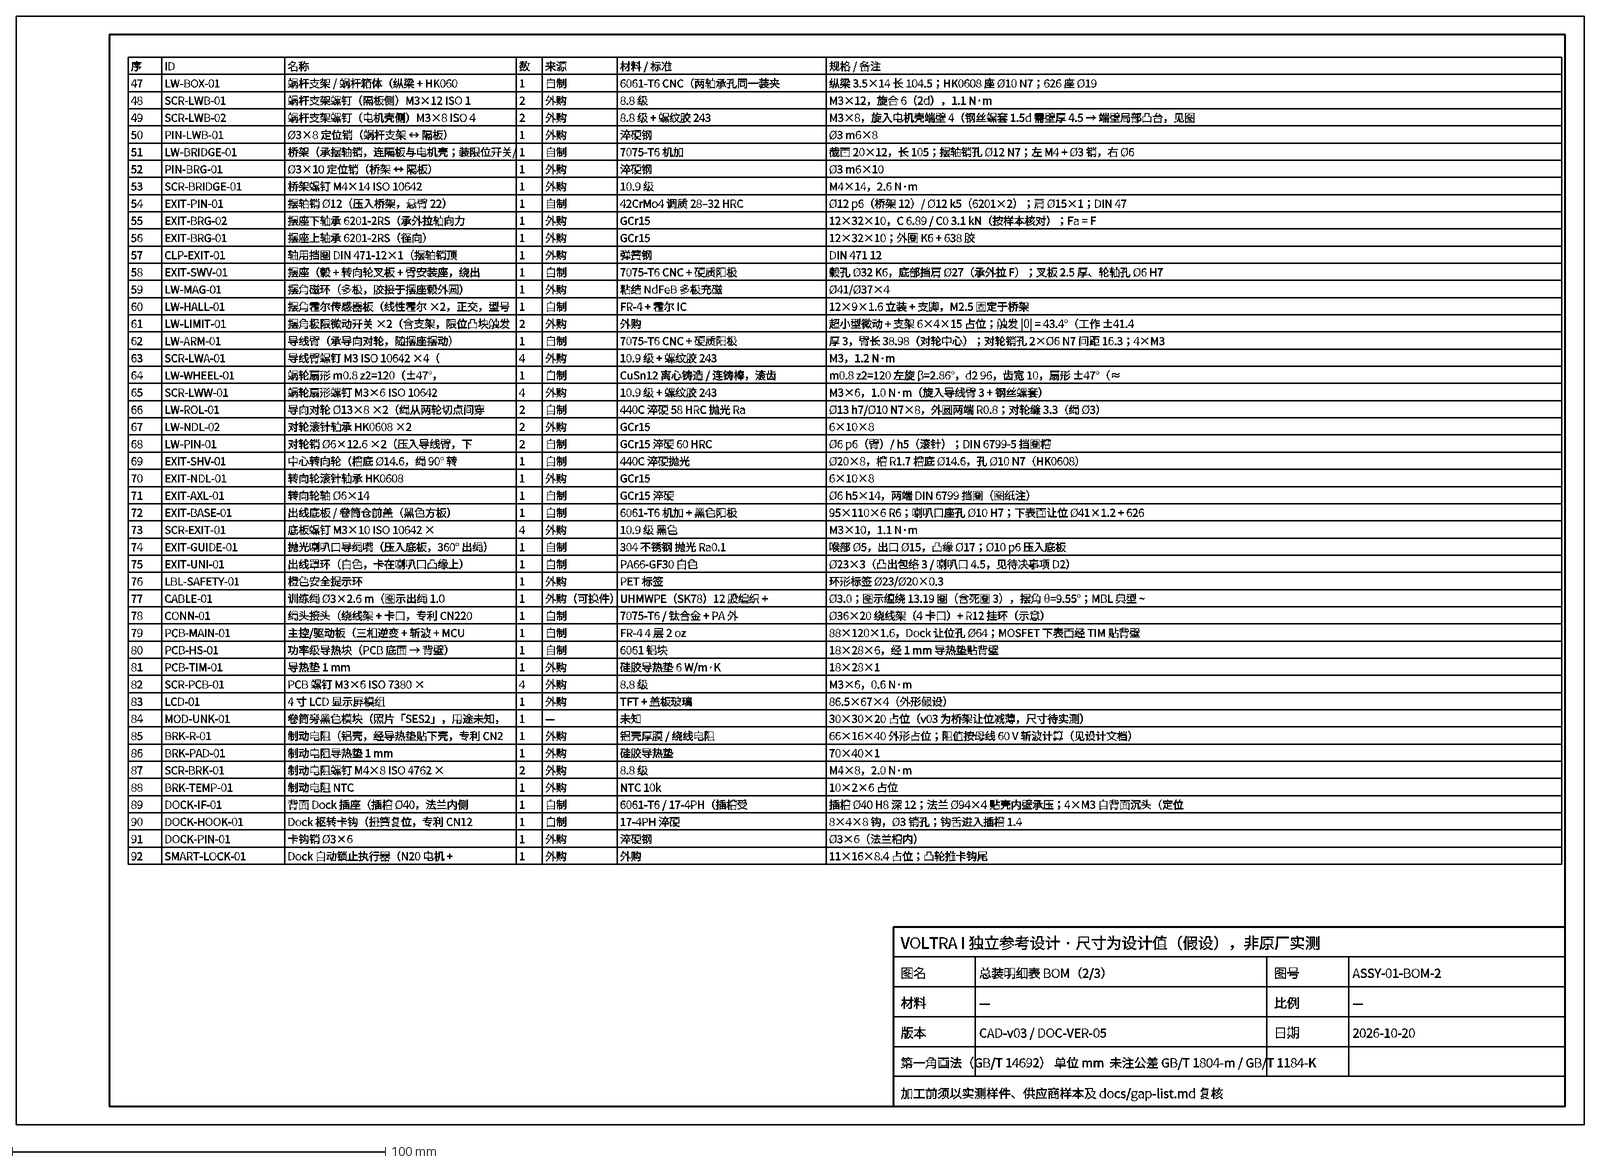
[picture p45: CAD file, 2026-10-20]
downloads/drawings/ASSY-01-BOM-2.dxf
序
ID
名称
数
来源
材料 / 标准
规格 / 备注
47
LW-BOX-01
蜗杆支架 / 蜗杆箱体（纵梁 + HK060
1
自制
6061-T6 CNC（两轴承孔同一装夹
纵梁 3.5×14 长 104.5；HK0608 座 Ø10 N7；626 座 Ø19
48
SCR-LWB-01
蜗杆支架螺钉（隔板侧）M3×12 ISO 1
2
外购
8.8 级
M3×12，旋合 6（2d），1.1 N·m
49
SCR-LWB-02
蜗杆支架螺钉（电机壳侧）M3×8 ISO 4
8.8 级 + 螺纹胶 243
M3×8，旋入电机壳端壁 4（钢丝螺套 1.5d 需壁厚 4.5 → 端壁局部凸台，见图
50
PIN-LWB-01
Ø3×8 定位销（蜗杆支架 ↔ 隔板）
淬硬钢
Ø3 m6×8
51
LW-BRIDGE-01
桥架（承摆轴销，连隔板与电机壳；装限位开关/
7075-T6 机加
截面 20×12，长 105；摆轴销孔 Ø12 N7；左 M4 + Ø3 销，右 Ø6
52
PIN-BRG-01
Ø3×10 定位销（桥架 ↔ 隔板）
Ø3 m6×10
53
SCR-BRIDGE-01
桥架螺钉 M4×14 ISO 10642
10.9 级
M4×14，2.6 N·m
54
EXIT-PIN-01
摆轴销 Ø12（压入桥架，悬臂 22）
42CrMo4 调质 28–32 HRC
Ø12 p6（桥架 12）/ Ø12 k5（6201×2）；肩 Ø15×1；DIN 47
55
EXIT-BRG-02
摆座下轴承 6201-2RS（承外拉轴向力
GCr15
12×32×10，C 6.89 / C0 3.1 kN（按样本核对）；Fa = F
56
EXIT-BRG-01
摆座上轴承 6201-2RS（径向）
12×32×10；外圈 K6 + 638 胶
57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
