merlinwwu/voltra-i-ref-3d/downloads/drawings/HSG-MAIN-01-LWR.dxf

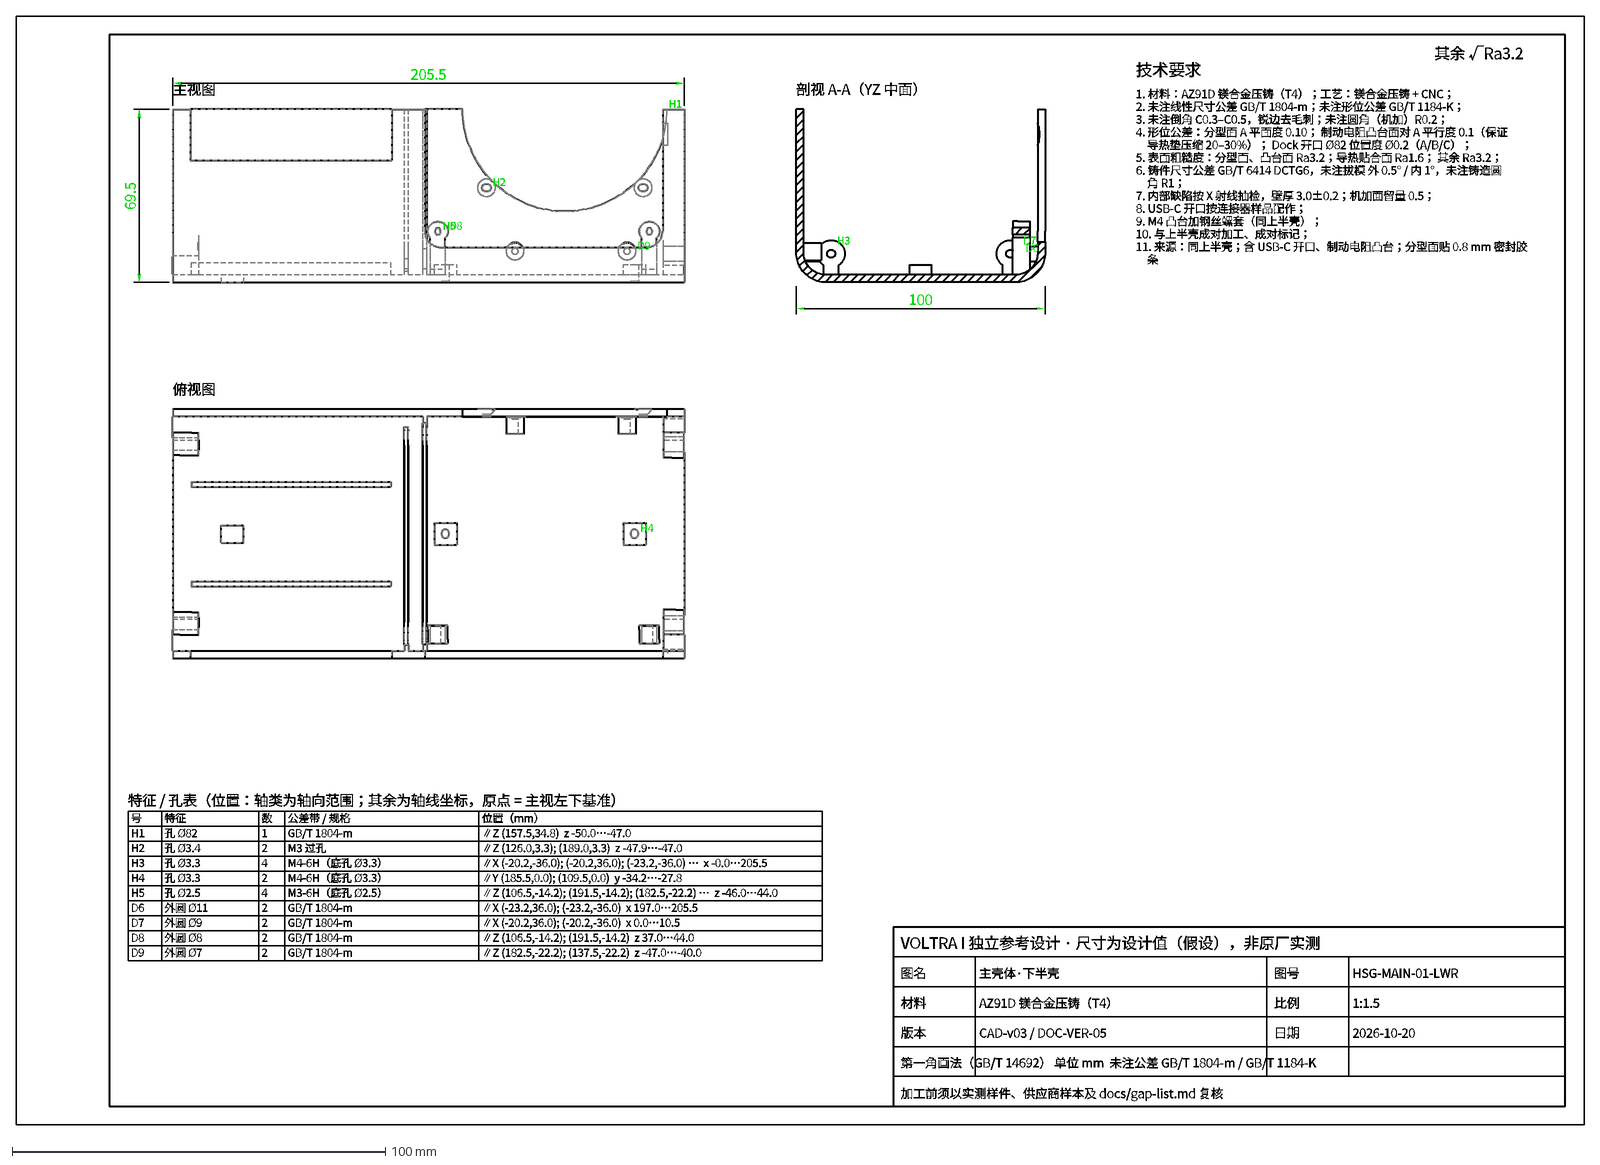
[picture p46: CAD file, 2026-10-20]
downloads/drawings/HSG-MAIN-01-LWR.dxf
主视图
剖视 A-A（YZ 中面）
俯视图
205.5
69.5
100
H1
H2
H3
H4
H5
D6
D7
D8
D9
特征 / 孔表（位置：轴类为轴向范围；其余为轴线坐标，原点 = 主视左下基准）
号
特征
数
公差带 / 规格
位置（mm）
孔 Ø82
1
GB/T 1804-m
∥Z (157.5,34.8) z -50.0…-47.0
孔 Ø3.4
2
M3 过孔
∥Z (126.0,3.3); (189.0,3.3) z -47.9…-47.0
孔 Ø3.3
4
M4-6H（底孔 Ø3.3）
∥X (-20.2,-36.0); (-20.2,36.0); (-23.2,-36.0) … x -0.0…205.5
∥Y (185.5,0.0); (109.5,0.0) y -34.2…-27.8
孔 Ø2.5
M3-6H（底孔 Ø2.5）
∥Z (106.5,-14.2); (191.5,-14.2); (182.5,-22.2) … z -46.0…44.0
外圆 Ø11
∥X (-23.2,36.0); (-23.2,-36.0) x 197.0…205.5
外圆 Ø9
∥X (-20.2,36.0); (-20.2,-36.0) x 0.0…10.5
外圆 Ø8
∥Z (106.5,-14.2); (191.5,-14.2) z 37.0…44.0
外圆 Ø7
∥Z (182.5,-22.2); (137.5,-22.2) z -47.0…-40.0
技术要求
1. 材料：AZ91D 镁合金压铸（T4）；工艺：镁合金压铸 + CNC；
2. 未注线性尺寸公差 GB/T 1804-m；未注形位公差 GB/T 1184-K；
3. 未注倒角 C0.3–C0.5，锐边去毛刺；未注圆角（机加）R0.2；
4. 形位公差：分型面 A 平面度 0.10； 制动电阻凸台面对 A 平行度 0.1（保证
导热垫压缩 20–30%）； Dock 开口 Ø82 位置度 Ø0.2（A/B/C）；
5. 表面粗糙度：分型面、凸台面 Ra3.2；导热贴合面 Ra1.6； 其余 Ra3.2；
6. 铸件尺寸公差 GB/T 6414 DCTG6，未注拔模 外 0.5° / 内 1°，未注铸造圆
角 R1；
7. 内部缺陷按 X 射线抽检，壁厚 3.0±0.2；机加面留量 0.5；
8. USB-C 开口按连接器样品配作；
9. M4 凸台加钢丝螺套（同上半壳）；
10. 与上半壳成对加工、成对标记；
11. 来源：同上半壳；含 USB-C 开口、制动电阻凸台；分型面贴 0.8 mm 密封胶
条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
