merlinwwu/voltra-i-ref-3d/downloads/drawings/ASSY-01-BOM-3.dxf

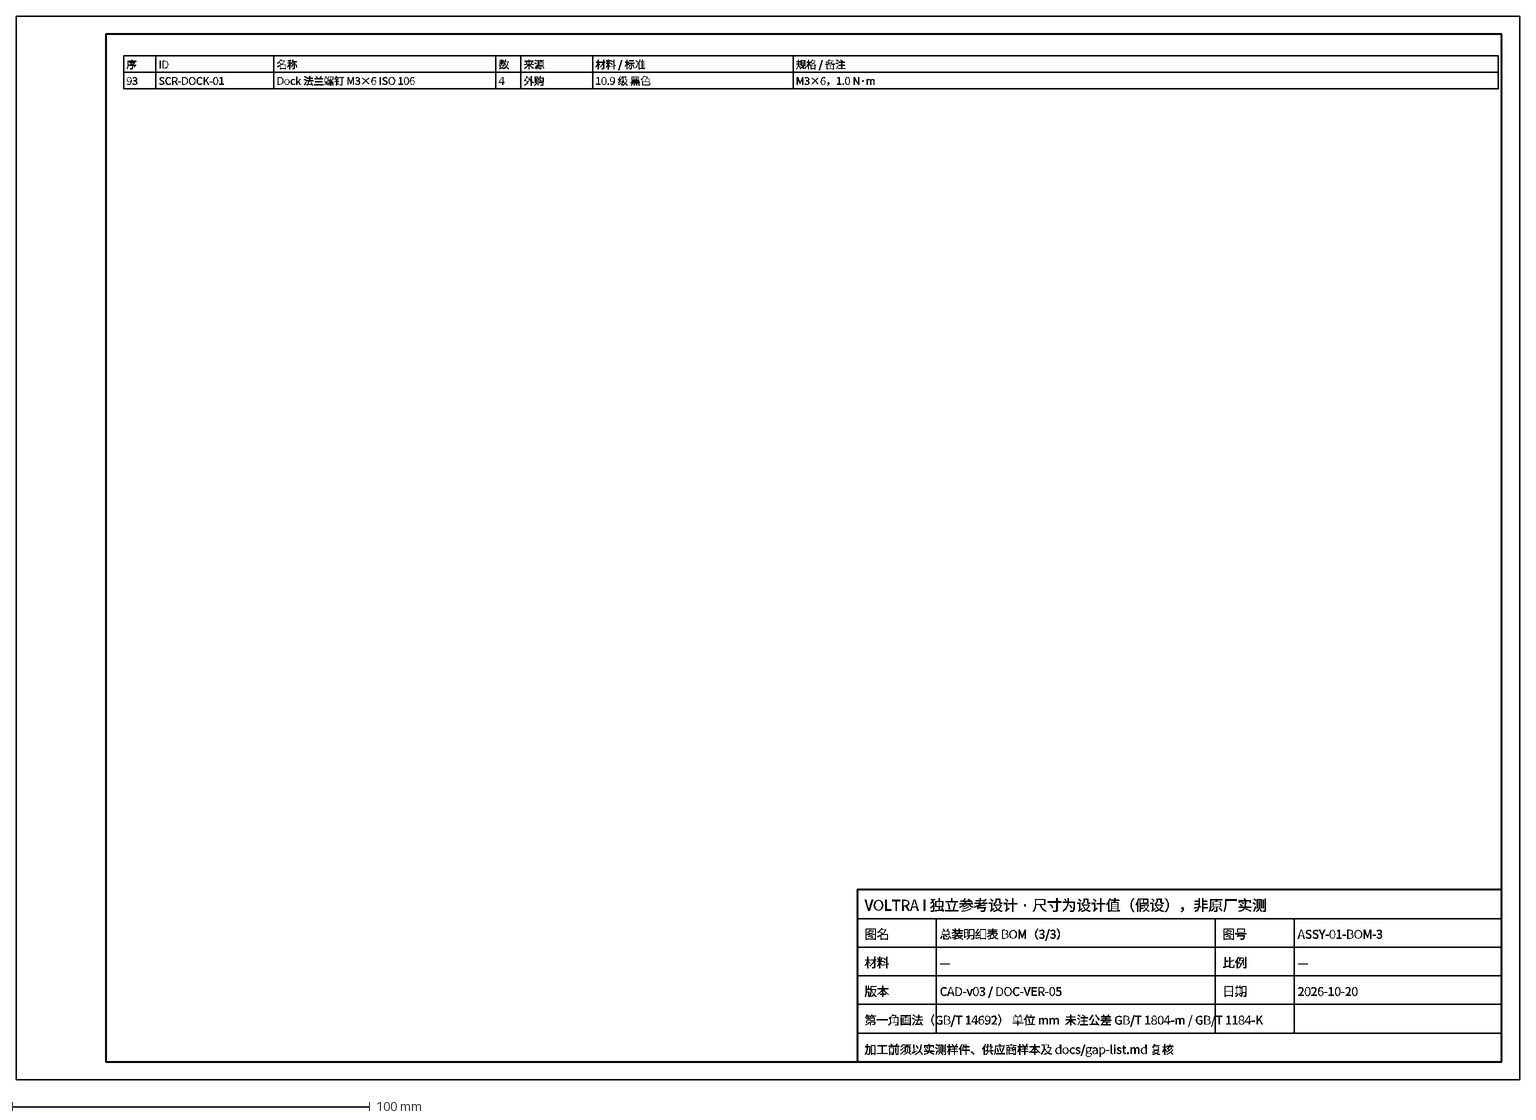
[picture p47: CAD file, 2026-10-20]
downloads/drawings/ASSY-01-BOM-3.dxf
序
ID
名称
数
来源
材料 / 标准
规格 / 备注
93
SCR-DOCK-01
Dock 法兰螺钉 M3×6 ISO 106
4
外购
10.9 级 黑色
M3×6，1.0 N·m
VOLTRA I 独立参考设计 · 尺寸为设计值（假设），非原厂实测
图名
总装明细表 BOM（3/3）
图号
ASSY-01-BOM-3
材料
—
比例
版本
CAD-v03 / DOC-VER-05
日期
2026-10-20
第一角画法（GB/T 14692） 单位 mm 未注公差 GB/T 1804-m / GB/T 1184-K
加工前须以实测样件、供应商样本及 docs/gap-list.md 复核
