merlinwwu/voltra-i-ref-3d/downloads/step/HSG-MAIN-01-UPR.step

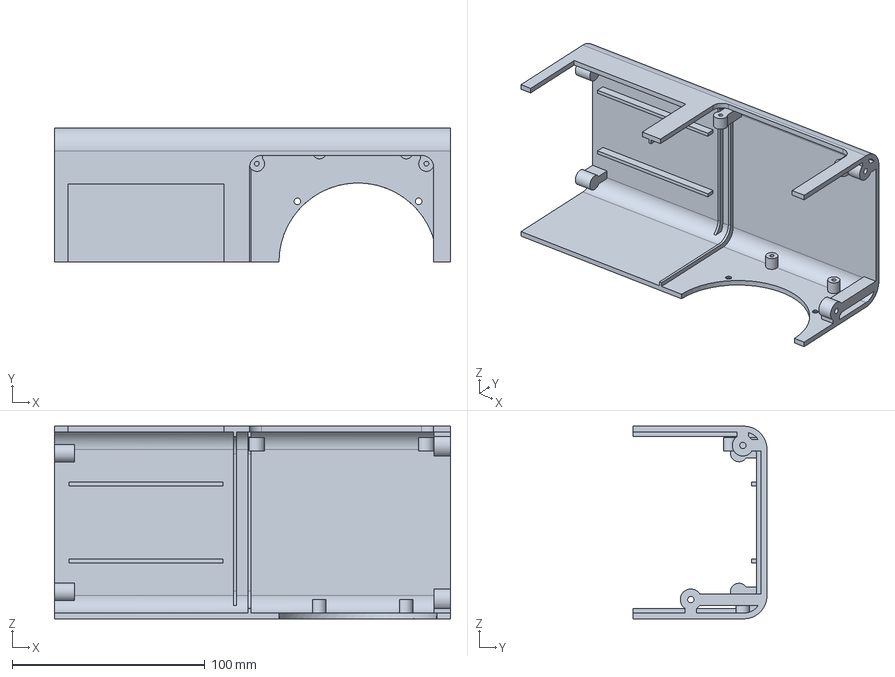
[picture p48: CAD file, 2026-10-20]
downloads/step/HSG-MAIN-01-UPR.step
205.5 x 69.5 x 100.0 mm
