merlinwwu/voltra-i-ref-3d/downloads/step/PCB-MAIN-01.step

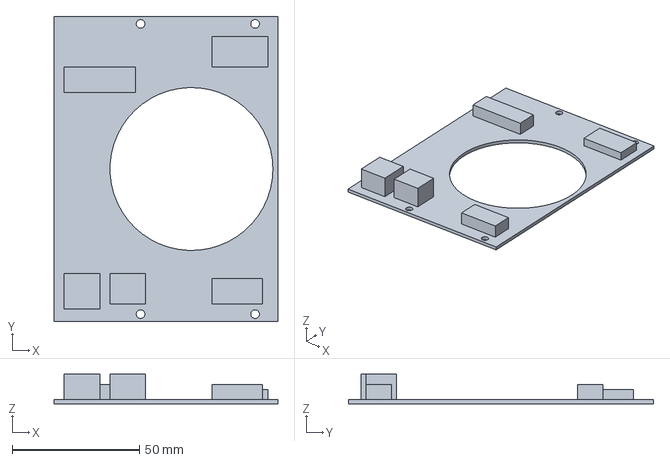
[picture p49: CAD file, 2026-10-20]
downloads/step/PCB-MAIN-01.step
88.0 x 120.0 x 11.6 mm
