merlinwwu/voltra-i-ref-3d/downloads/step/HSG-MAIN-01-LWR.step

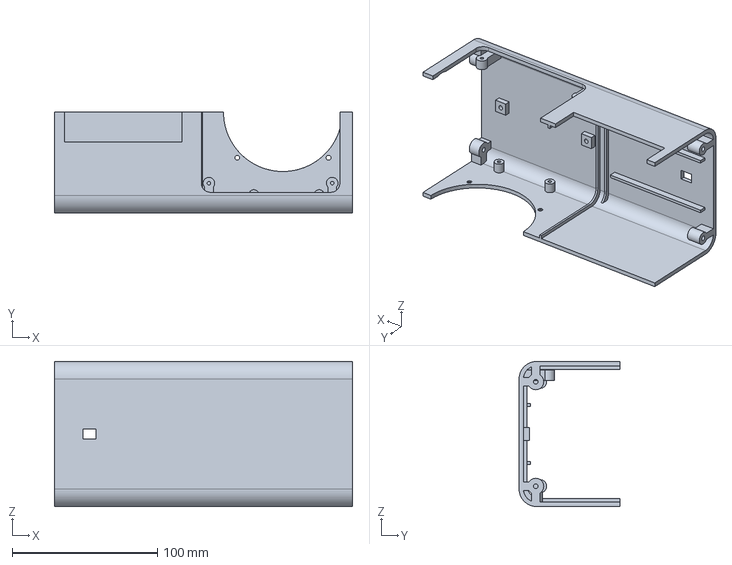
[picture p50: CAD file, 2026-10-20]
downloads/step/HSG-MAIN-01-LWR.step
205.5 x 69.5 x 100.0 mm
