merlinwwu/voltra-i-ref-3d/downloads/drawings/DOCK-IF-01.dxf

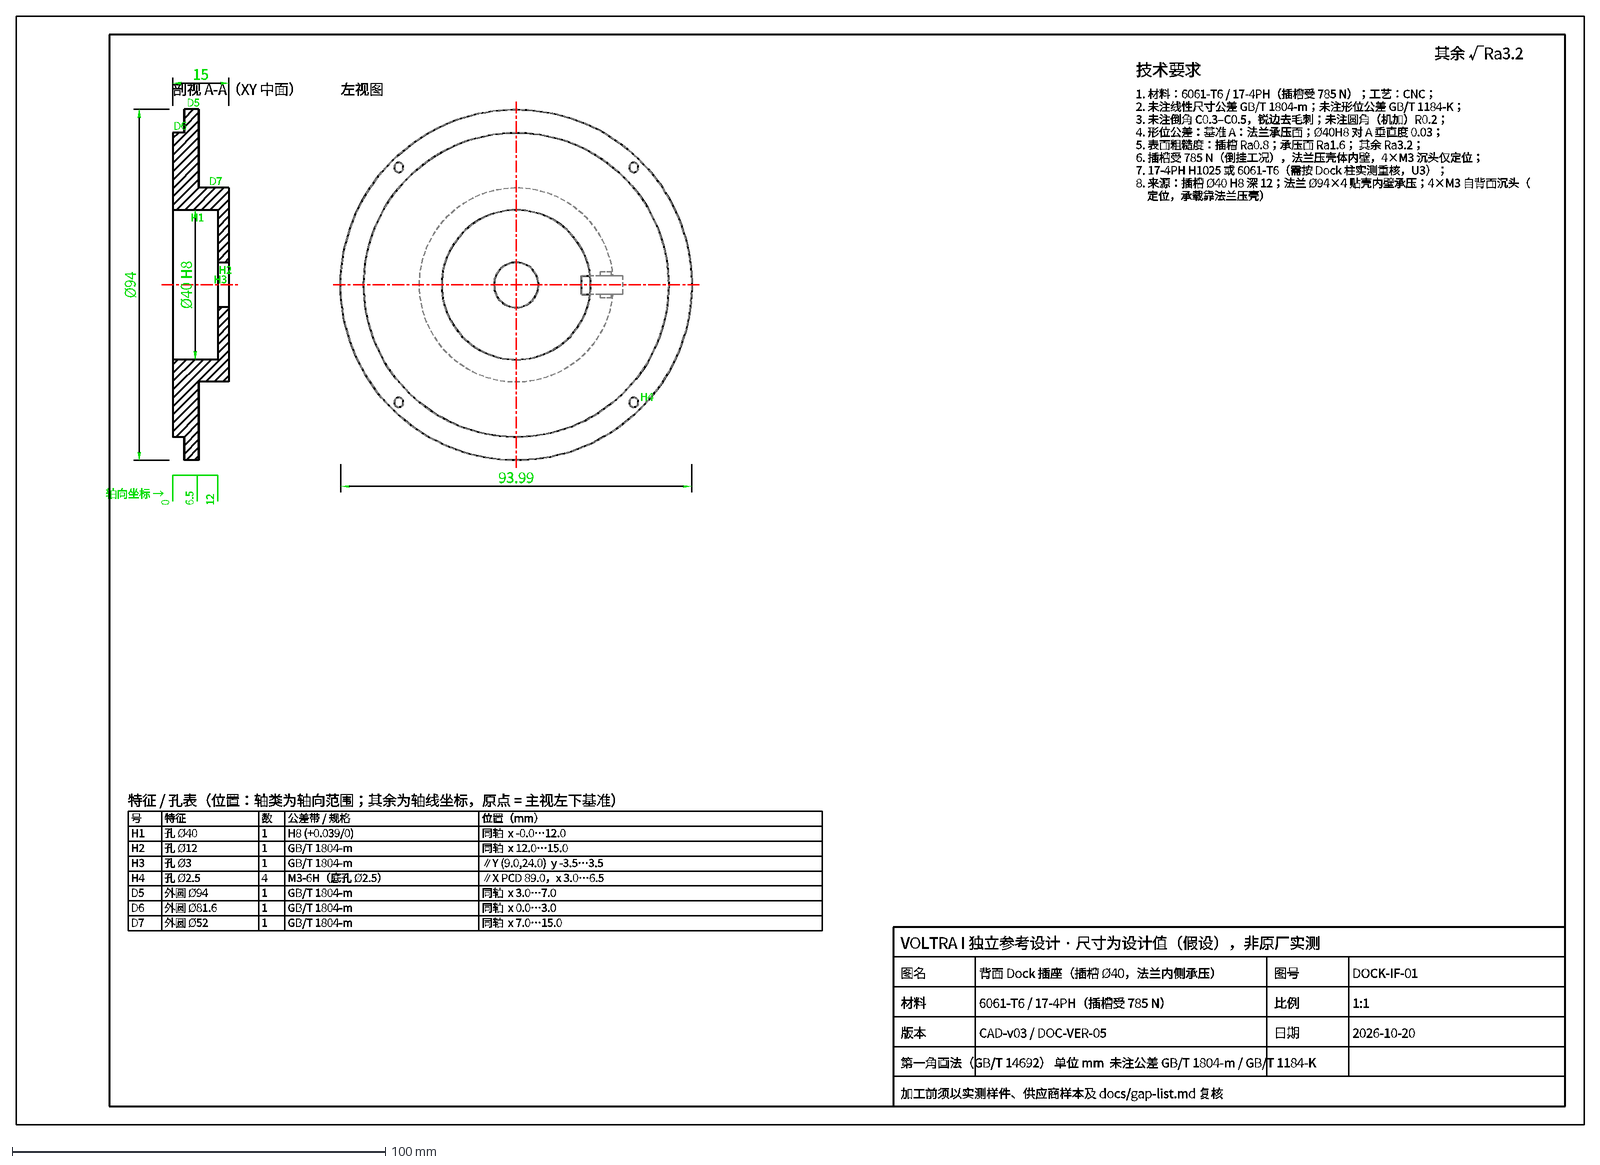
[picture p51: CAD file, 2026-10-20]
downloads/drawings/DOCK-IF-01.dxf
剖视 A-A（XY 中面）
左视图
15
Ø94
93.99
0
6.5
12
轴向坐标 →
H1
Ø40 H8
H2
H3
H4
D5
D6
D7
特征 / 孔表（位置：轴类为轴向范围；其余为轴线坐标，原点 = 主视左下基准）
号
特征
数
公差带 / 规格
位置（mm）
孔 Ø40
1
H8 (+0.039/0)
同轴 x -0.0…12.0
孔 Ø12
GB/T 1804-m
同轴 x 12.0…15.0
孔 Ø3
∥Y (9.0,24.0) y -3.5…3.5
孔 Ø2.5
4
M3-6H（底孔 Ø2.5）
∥X PCD 89.0，x 3.0…6.5
外圆 Ø94
同轴 x 3.0…7.0
外圆 Ø81.6
同轴 x 0.0…3.0
外圆 Ø52
同轴 x 7.0…15.0
技术要求
1. 材料：6061-T6 / 17-4PH（插槽受 785 N）；工艺：CNC；
2. 未注线性尺寸公差 GB/T 1804-m；未注形位公差 GB/T 1184-K；
3. 未注倒角 C0.3–C0.5，锐边去毛刺；未注圆角（机加）R0.2；
4. 形位公差：基准 A：法兰承压面；Ø40H8 对 A 垂直度 0.03；
5. 表面粗糙度：插槽 Ra0.8；承压面 Ra1.6； 其余 Ra3.2；
6. 插槽受 785 N（倒挂工况），法兰压壳体内壁，4×M3 沉头仅定位；
7. 17-4PH H1025 或 6061-T6（需按 Dock 柱实测重核，U3）；
8. 来源：插槽 Ø40 H8 深 12；法兰 Ø94×4 贴壳内壁承压；4×M3 自背面沉头（
定位，承载靠法兰压壳）
其余 √Ra3.2
VOLTRA I 独立参考设计 · 尺寸为设计值（假设），非原厂实测
图名
背面 Dock 插座（插槽 Ø40，法兰内侧承压）
图号
DOCK-IF-01
材料
6061-T6 / 17-4PH（插槽受 785 N）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
