merlinwwu/voltra-i-ref-3d/downloads/step/MOD-UNK-01.step

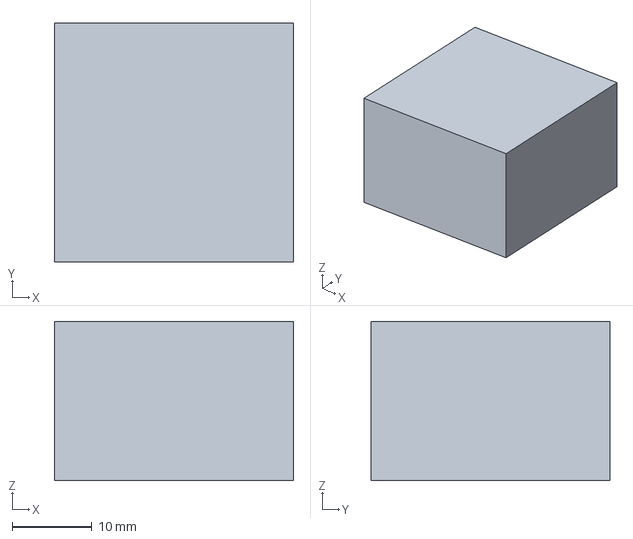
[picture p52: CAD file, 2026-10-20]
downloads/step/MOD-UNK-01.step
30.0 x 30.0 x 20.0 mm
