merlinwwu/voltra-i-ref-3d/downloads/drawings/HSG-END-R-01.dxf

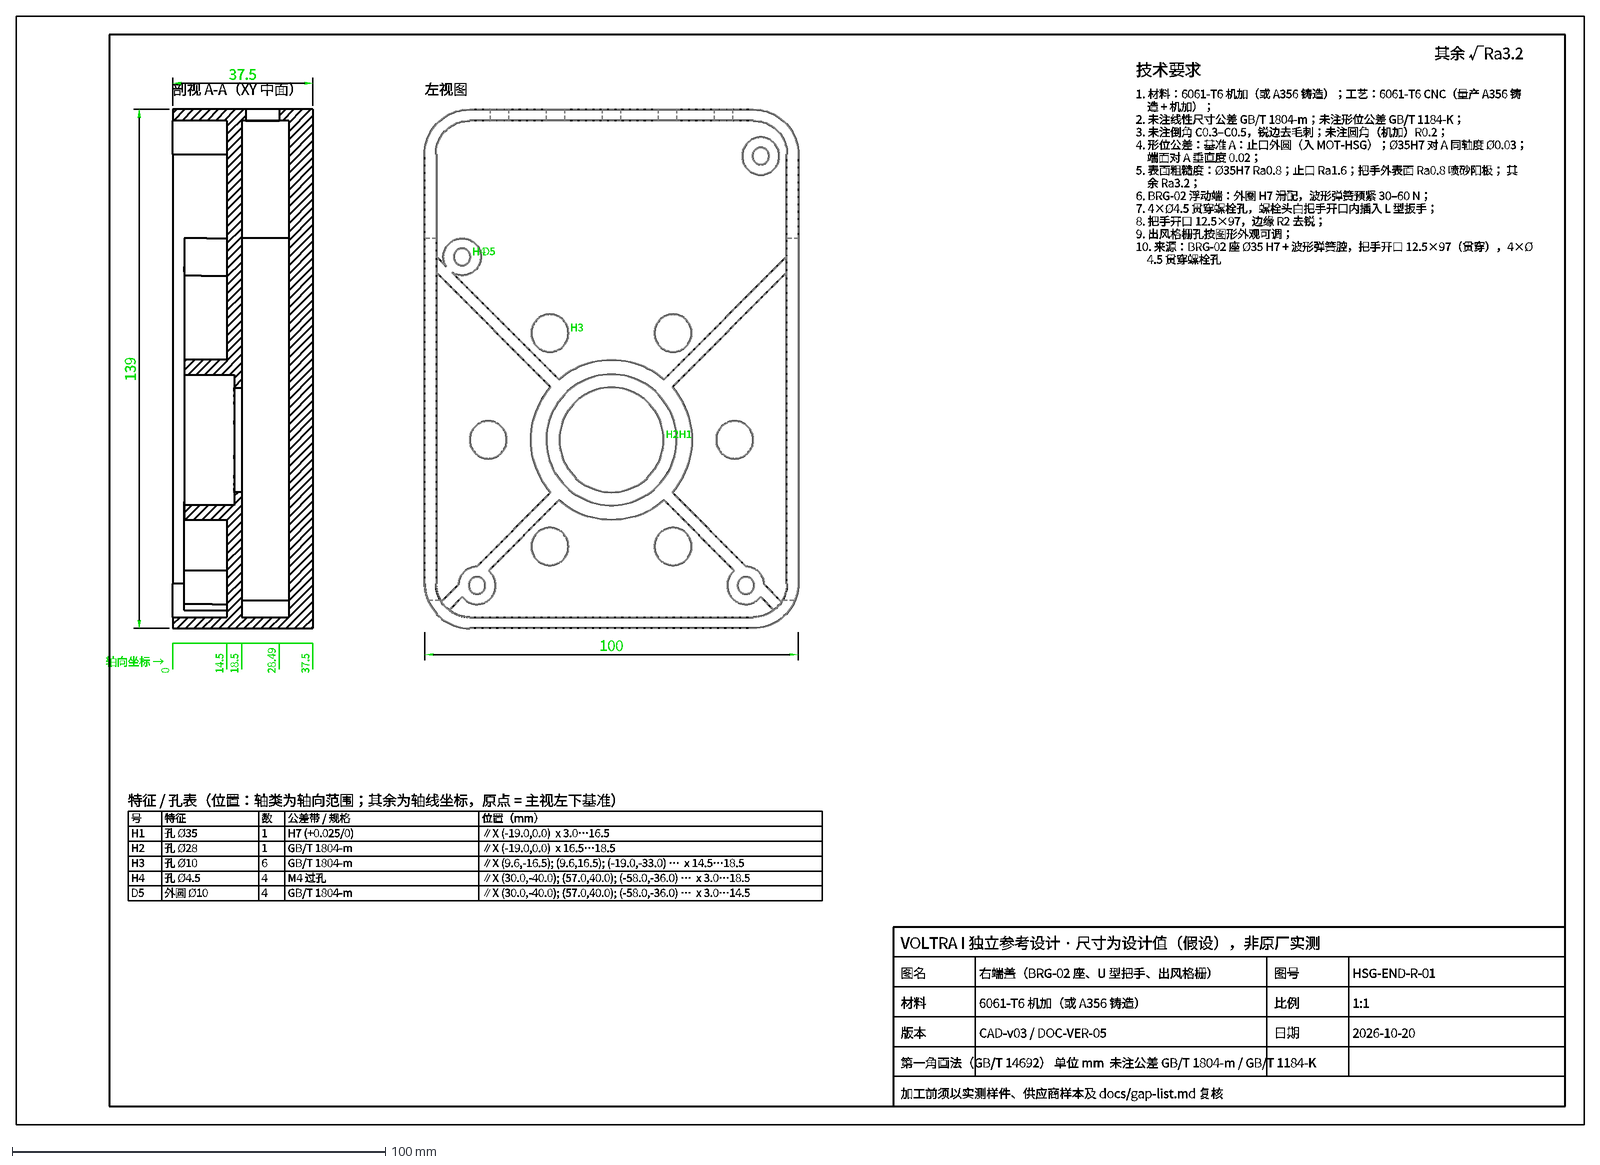
[picture p53: CAD file, 2026-10-20]
downloads/drawings/HSG-END-R-01.dxf
剖视 A-A（XY 中面）
左视图
37.5
139
100
0
14.5
18.5
28.49
轴向坐标 →
H1
H2
H3
H4
D5
特征 / 孔表（位置：轴类为轴向范围；其余为轴线坐标，原点 = 主视左下基准）
号
特征
数
公差带 / 规格
位置（mm）
孔 Ø35
1
H7 (+0.025/0)
∥X (-19.0,0.0) x 3.0…16.5
孔 Ø28
GB/T 1804-m
∥X (-19.0,0.0) x 16.5…18.5
孔 Ø10
6
∥X (9.6,-16.5); (9.6,16.5); (-19.0,-33.0) … x 14.5…18.5
孔 Ø4.5
4
M4 过孔
∥X (30.0,-40.0); (57.0,40.0); (-58.0,-36.0) … x 3.0…18.5
外圆 Ø10
∥X (30.0,-40.0); (57.0,40.0); (-58.0,-36.0) … x 3.0…14.5
技术要求
1. 材料：6061-T6 机加（或 A356 铸造）；工艺：6061-T6 CNC（量产 A356 铸
造 + 机加）；
2. 未注线性尺寸公差 GB/T 1804-m；未注形位公差 GB/T 1184-K；
3. 未注倒角 C0.3–C0.5，锐边去毛刺；未注圆角（机加）R0.2；
4. 形位公差：基准 A：止口外圆（入 MOT-HSG）；Ø35H7 对 A 同轴度 Ø0.03；
端面对 A 垂直度 0.02；
5. 表面粗糙度：Ø35H7 Ra0.8；止口 Ra1.6；把手外表面 Ra0.8 喷砂阳极； 其
余 Ra3.2；
6. BRG-02 浮动端：外圈 H7 滑配，波形弹簧预紧 30–60 N；
7. 4×Ø4.5 贯穿螺栓孔，螺栓头由把手开口内插入 L 型扳手；
8. 把手开口 12.5×97，边缘 R2 去锐；
9. 出风格栅孔按图形外观可调；
10. 来源：BRG-02 座 Ø35 H7 + 波形弹簧腔，把手开口 12.5×97（贯穿），4×Ø
4.5 贯穿螺栓孔
其余 √Ra3.2
VOLTRA I 独立参考设计 · 尺寸为设计值（假设），非原厂实测
图名
右端盖（BRG-02 座、U 型把手、出风格栅）
图号
HSG-END-R-01
材料
6061-T6 机加（或 A356 铸造）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
