merlinwwu/voltra-i-ref-3d/downloads/step/BRG-01.step

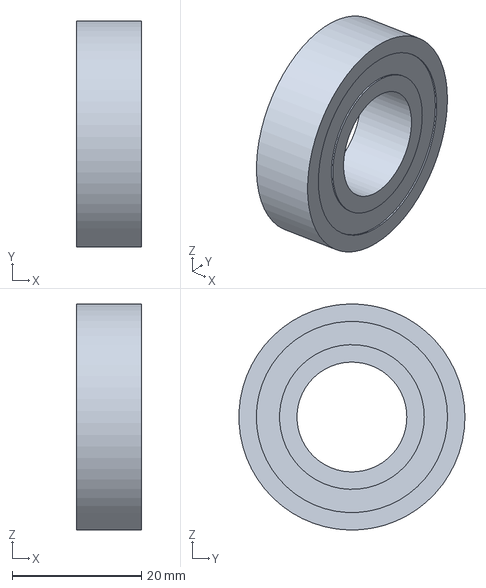
[picture p54: CAD file, 2026-10-20]
downloads/step/BRG-01.step
10.0 x 35.0 x 35.0 mm
