merlinwwu/voltra-i-ref-3d/downloads/step/LW-LIMIT-01.step

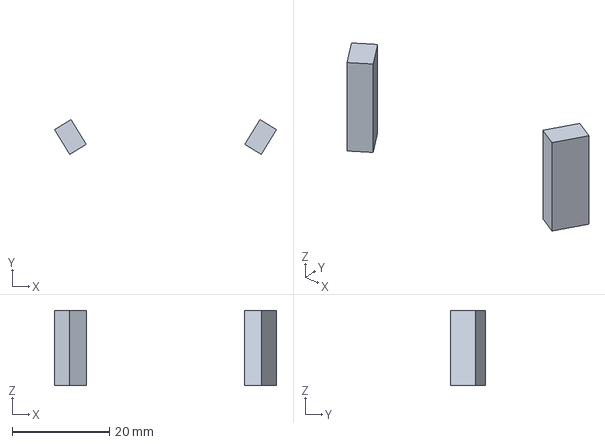
[picture p55: CAD file, 2026-10-20]
downloads/step/LW-LIMIT-01.step
45.8 x 7.21 x 15.5 mm
