merlinwwu/voltra-i-ref-3d/downloads/drawings/SPC-BRG01.dxf

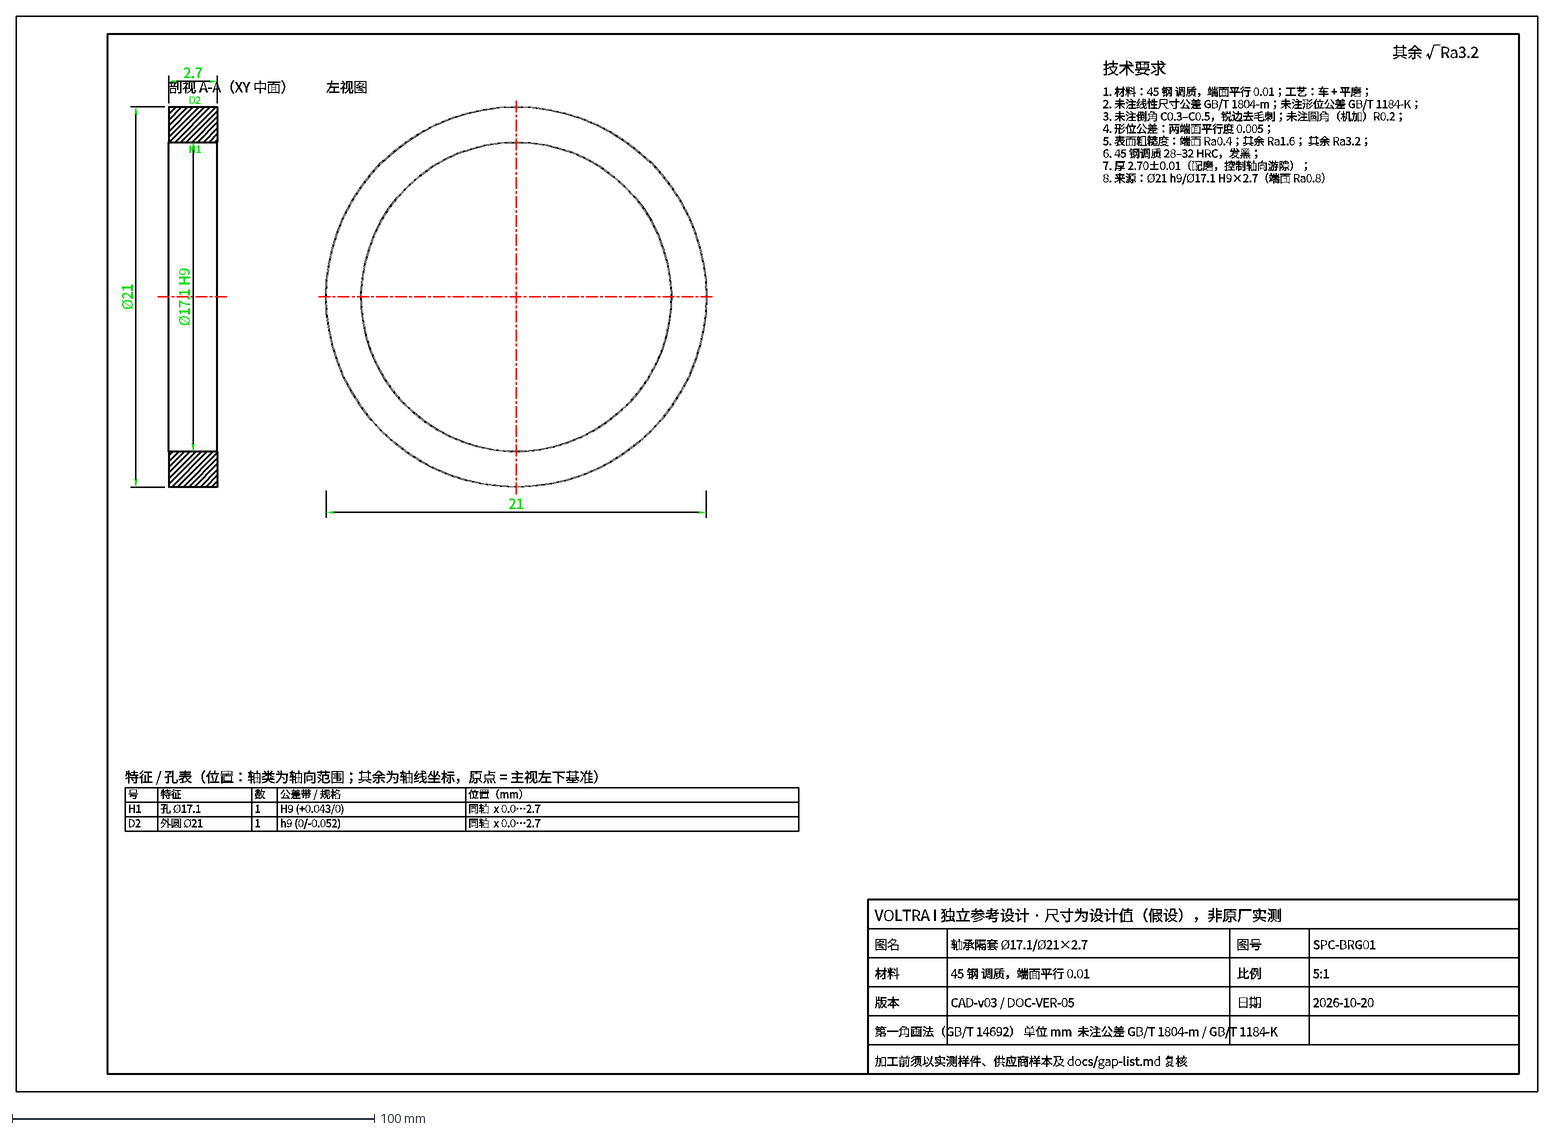
[picture p56: CAD file, 2026-10-20]
downloads/drawings/SPC-BRG01.dxf
剖视 A-A（XY 中面）
左视图
2.7
Ø21
21
H1
Ø17.1 H9
D2
特征 / 孔表（位置：轴类为轴向范围；其余为轴线坐标，原点 = 主视左下基准）
号
特征
数
公差带 / 规格
位置（mm）
孔 Ø17.1
1
H9 (+0.043/0)
同轴 x 0.0…2.7
外圆 Ø21
h9 (0/-0.052)
技术要求
1. 材料：45 钢 调质，端面平行 0.01；工艺：车 + 平磨；
2. 未注线性尺寸公差 GB/T 1804-m；未注形位公差 GB/T 1184-K；
3. 未注倒角 C0.3–C0.5，锐边去毛刺；未注圆角（机加）R0.2；
4. 形位公差：两端面平行度 0.005；
5. 表面粗糙度：端面 Ra0.4；其余 Ra1.6； 其余 Ra3.2；
6. 45 钢调质 28–32 HRC，发黑；
7. 厚 2.70±0.01（配磨，控制轴向游隙）；
8. 来源：Ø21 h9/Ø17.1 H9×2.7（端面 Ra0.8）
其余 √Ra3.2
VOLTRA I 独立参考设计 · 尺寸为设计值（假设），非原厂实测
图名
轴承隔套 Ø17.1/Ø21×2.7
图号
SPC-BRG01
材料
45 钢 调质，端面平行 0.01
比例
5:1
版本
CAD-v03 / DOC-VER-05
日期
2026-10-20
第一角画法（GB/T 14692） 单位 mm 未注公差 GB/T 1804-m / GB/T 1184-K
加工前须以实测样件、供应商样本及 docs/gap-list.md 复核
