merlinwwu/voltra-i-ref-3d/downloads/step/EXIT-BRG-01.step

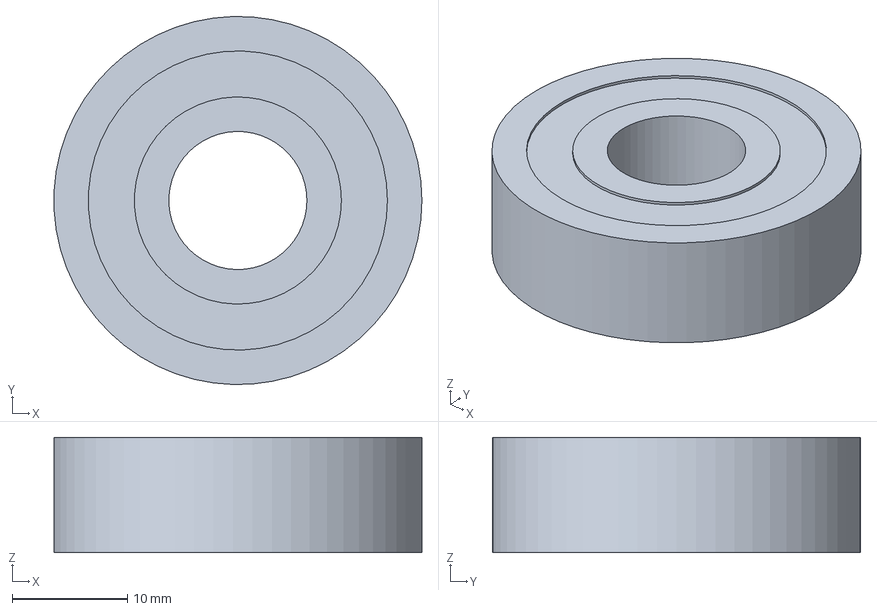
[picture p57: CAD file, 2026-10-20]
downloads/step/EXIT-BRG-01.step
32.0 x 32.0 x 10.0 mm
