merlinwwu/voltra-i-ref-3d/downloads/drawings/ROT-HUB-01.dxf

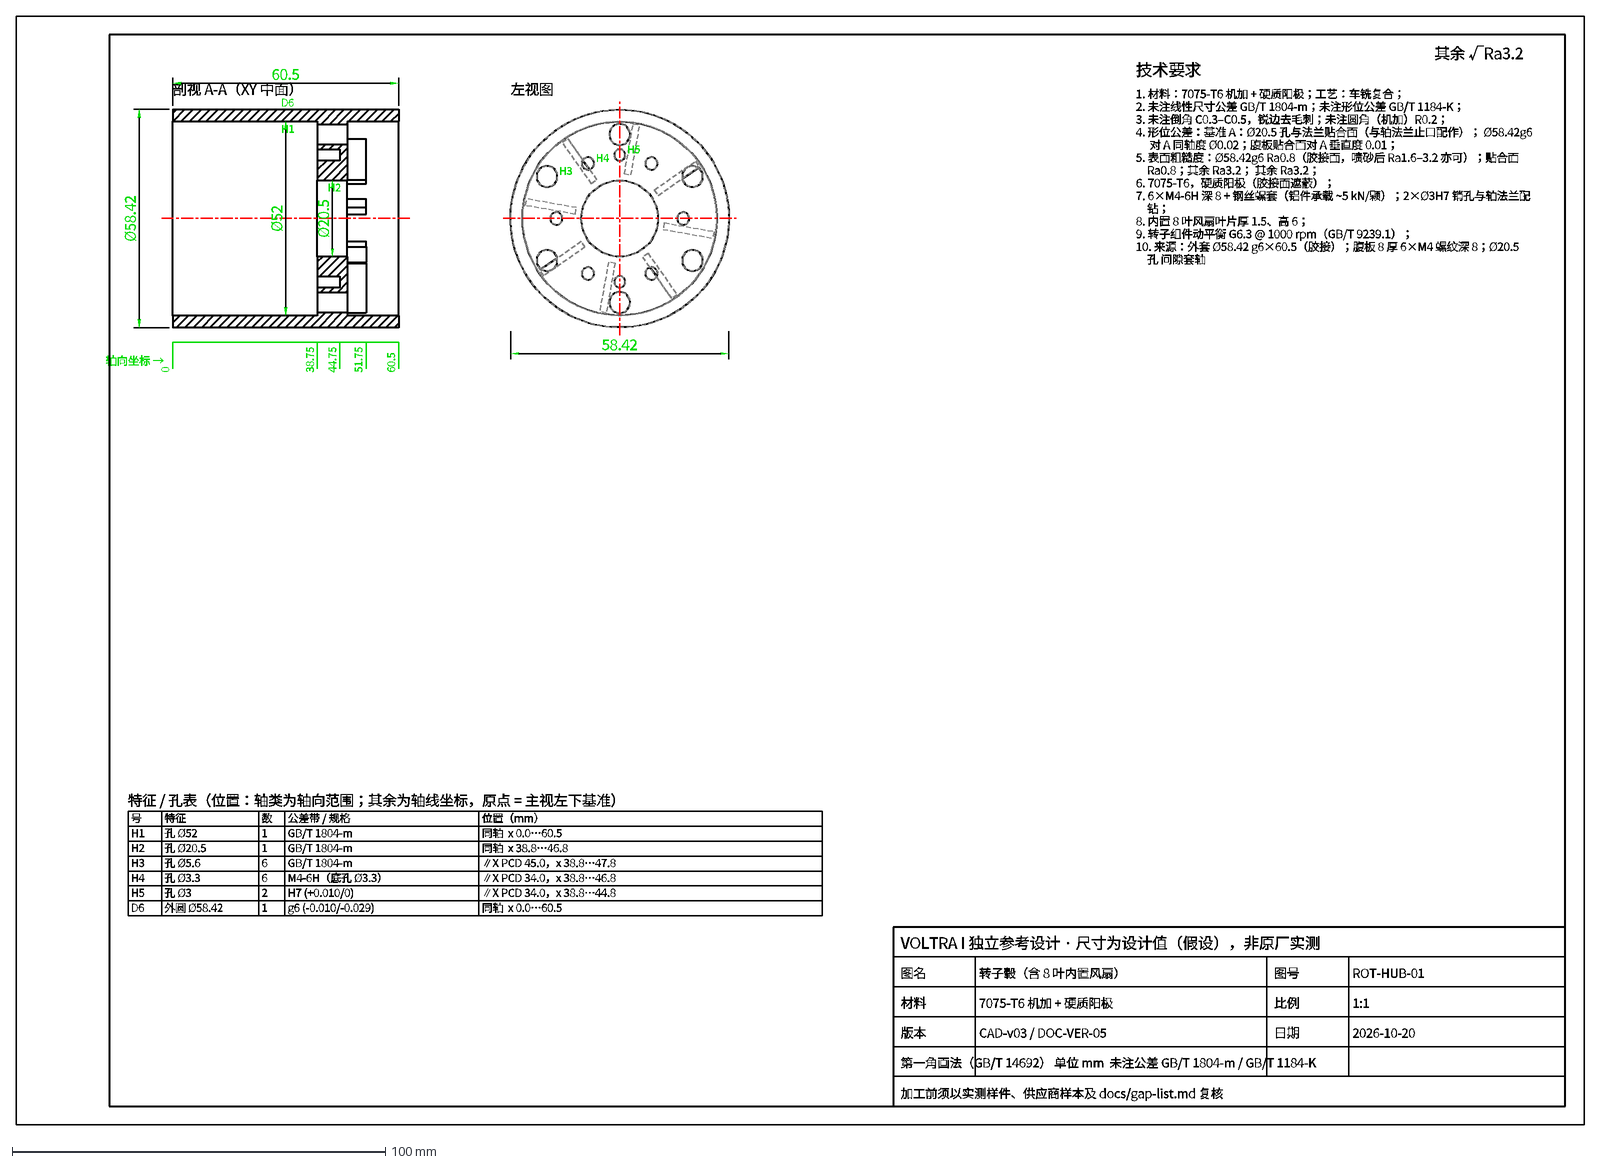
[picture p58: CAD file, 2026-10-20]
downloads/drawings/ROT-HUB-01.dxf
剖视 A-A（XY 中面）
左视图
60.5
Ø58.42
58.42
0
38.75
44.75
51.75
轴向坐标 →
H1
Ø52
H2
Ø20.5
H3
H4
H5
D6
特征 / 孔表（位置：轴类为轴向范围；其余为轴线坐标，原点 = 主视左下基准）
号
特征
数
公差带 / 规格
位置（mm）
孔 Ø52
1
GB/T 1804-m
同轴 x 0.0…60.5
孔 Ø20.5
同轴 x 38.8…46.8
孔 Ø5.6
6
∥X PCD 45.0，x 38.8…47.8
孔 Ø3.3
M4-6H（底孔 Ø3.3）
∥X PCD 34.0，x 38.8…46.8
孔 Ø3
2
H7 (+0.010/0)
∥X PCD 34.0，x 38.8…44.8
外圆 Ø58.42
g6 (-0.010/-0.029)
技术要求
1. 材料：7075-T6 机加 + 硬质阳极；工艺：车铣复合；
2. 未注线性尺寸公差 GB/T 1804-m；未注形位公差 GB/T 1184-K；
3. 未注倒角 C0.3–C0.5，锐边去毛刺；未注圆角（机加）R0.2；
4. 形位公差：基准 A：Ø20.5 孔与法兰贴合面（与轴法兰止口配作）； Ø58.42g6
对 A 同轴度 Ø0.02；腹板贴合面对 A 垂直度 0.01；
5. 表面粗糙度：Ø58.42g6 Ra0.8（胶接面，喷砂后 Ra1.6–3.2 亦可）；贴合面
Ra0.8；其余 Ra3.2； 其余 Ra3.2；
6. 7075-T6，硬质阳极（胶接面遮蔽）；
7. 6×M4-6H 深 8 + 钢丝螺套（铝件承载 ~5 kN/颗）；2×Ø3H7 销孔与轴法兰配
钻；
8. 内置 8 叶风扇叶片厚 1.5、高 6；
9. 转子组件动平衡 G6.3 @ 1000 rpm（GB/T 9239.1）；
10. 来源：外套 Ø58.42 g6×60.5（胶接）；腹板 8 厚 6×M4 螺纹深 8；Ø20.5
孔 间隙套轴
其余 √Ra3.2
VOLTRA I 独立参考设计 · 尺寸为设计值（假设），非原厂实测
图名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
