merlinwwu/voltra-i-ref-3d/downloads/step/EXIT-NDL-01.step

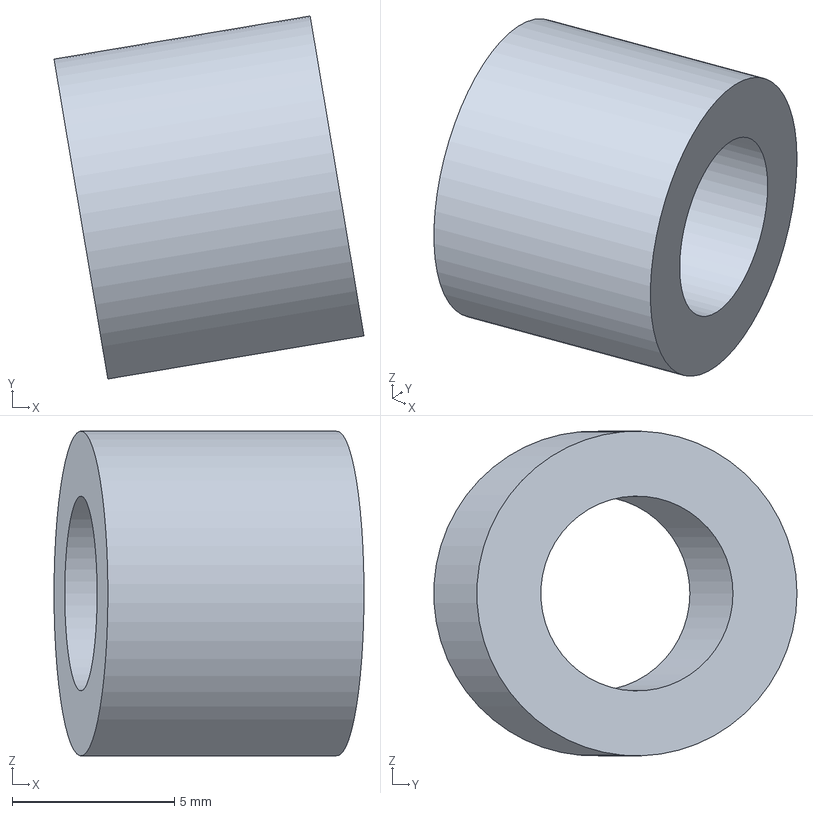
[picture p59: CAD file, 2026-10-20]
downloads/step/EXIT-NDL-01.step
9.55 x 11.2 x 10.00 mm
