merlinwwu/voltra-i-ref-3d/downloads/drawings/DRUM-01.dxf

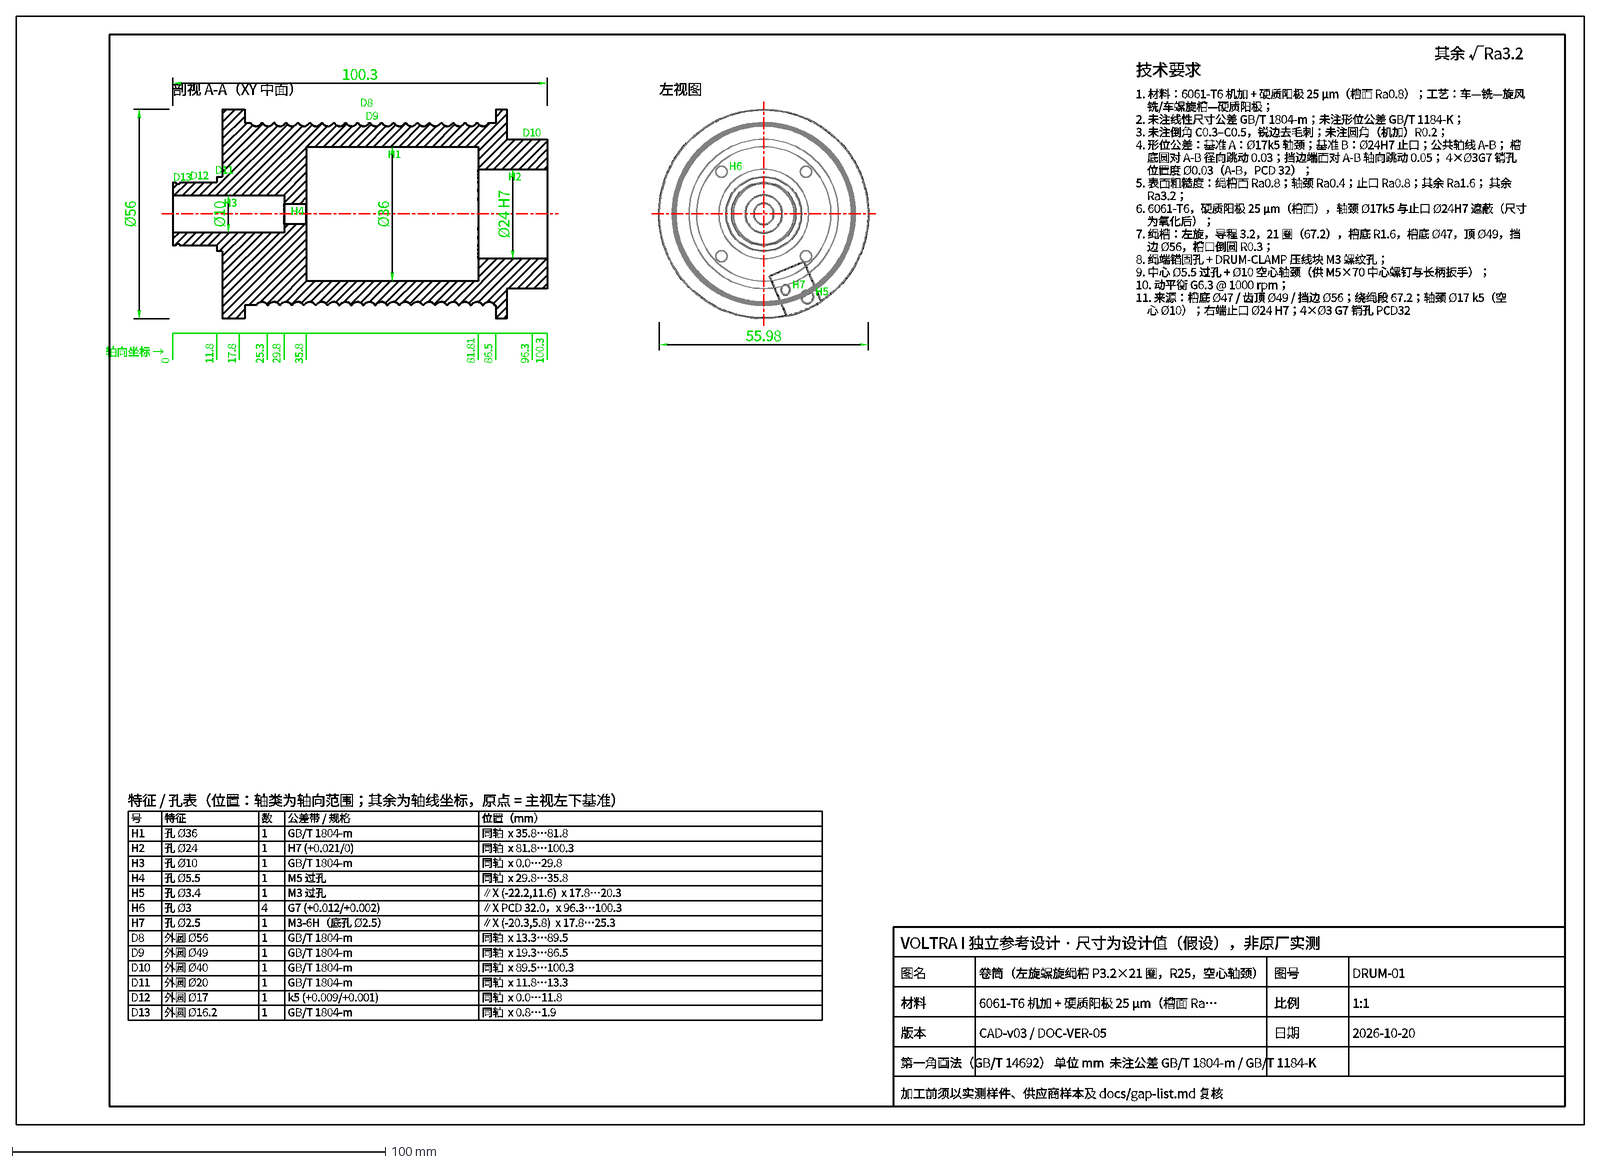
[picture p60: CAD file, 2026-10-20]
downloads/drawings/DRUM-01.dxf
剖视 A-A（XY 中面）
左视图
100.3
Ø56
55.98
0
11.8
17.8
25.3
29.8
35.8
81.81
86.5
96.3
轴向坐标 →
H1
Ø36
H2
Ø24 H7
H3
Ø10
H4
H5
H6
H7
D8
D9
D10
D11
D12
D13
特征 / 孔表（位置：轴类为轴向范围；其余为轴线坐标，原点 = 主视左下基准）
号
特征
数
公差带 / 规格
位置（mm）
孔 Ø36
1
GB/T 1804-m
同轴 x 35.8…81.8
孔 Ø24
H7 (+0.021/0)
同轴 x 81.8…100.3
孔 Ø10
同轴 x 0.0…29.8
孔 Ø5.5
M5 过孔
同轴 x 29.8…35.8
孔 Ø3.4
M3 过孔
∥X (-22.2,11.6) x 17.8…20.3
孔 Ø3
4
G7 (+0.012/+0.002)
∥X PCD 32.0，x 96.3…100.3
孔 Ø2.5
M3-6H（底孔 Ø2.5）
∥X (-20.3,5.8) x 17.8…25.3
外圆 Ø56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
