merlinwwu/voltra-i-ref-3d/downloads/step/HSG-FRAME-01.step

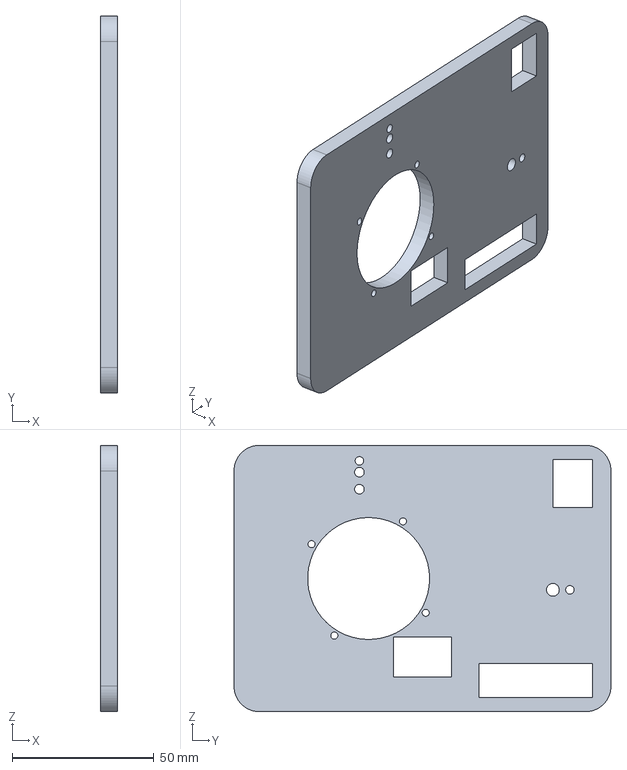
[picture p61: CAD file, 2026-10-20]
downloads/step/HSG-FRAME-01.step
6.00 x 133.0 x 94.0 mm
