merlinwwu/voltra-i-ref-3d/downloads/drawings/LW-BOX-01.dxf

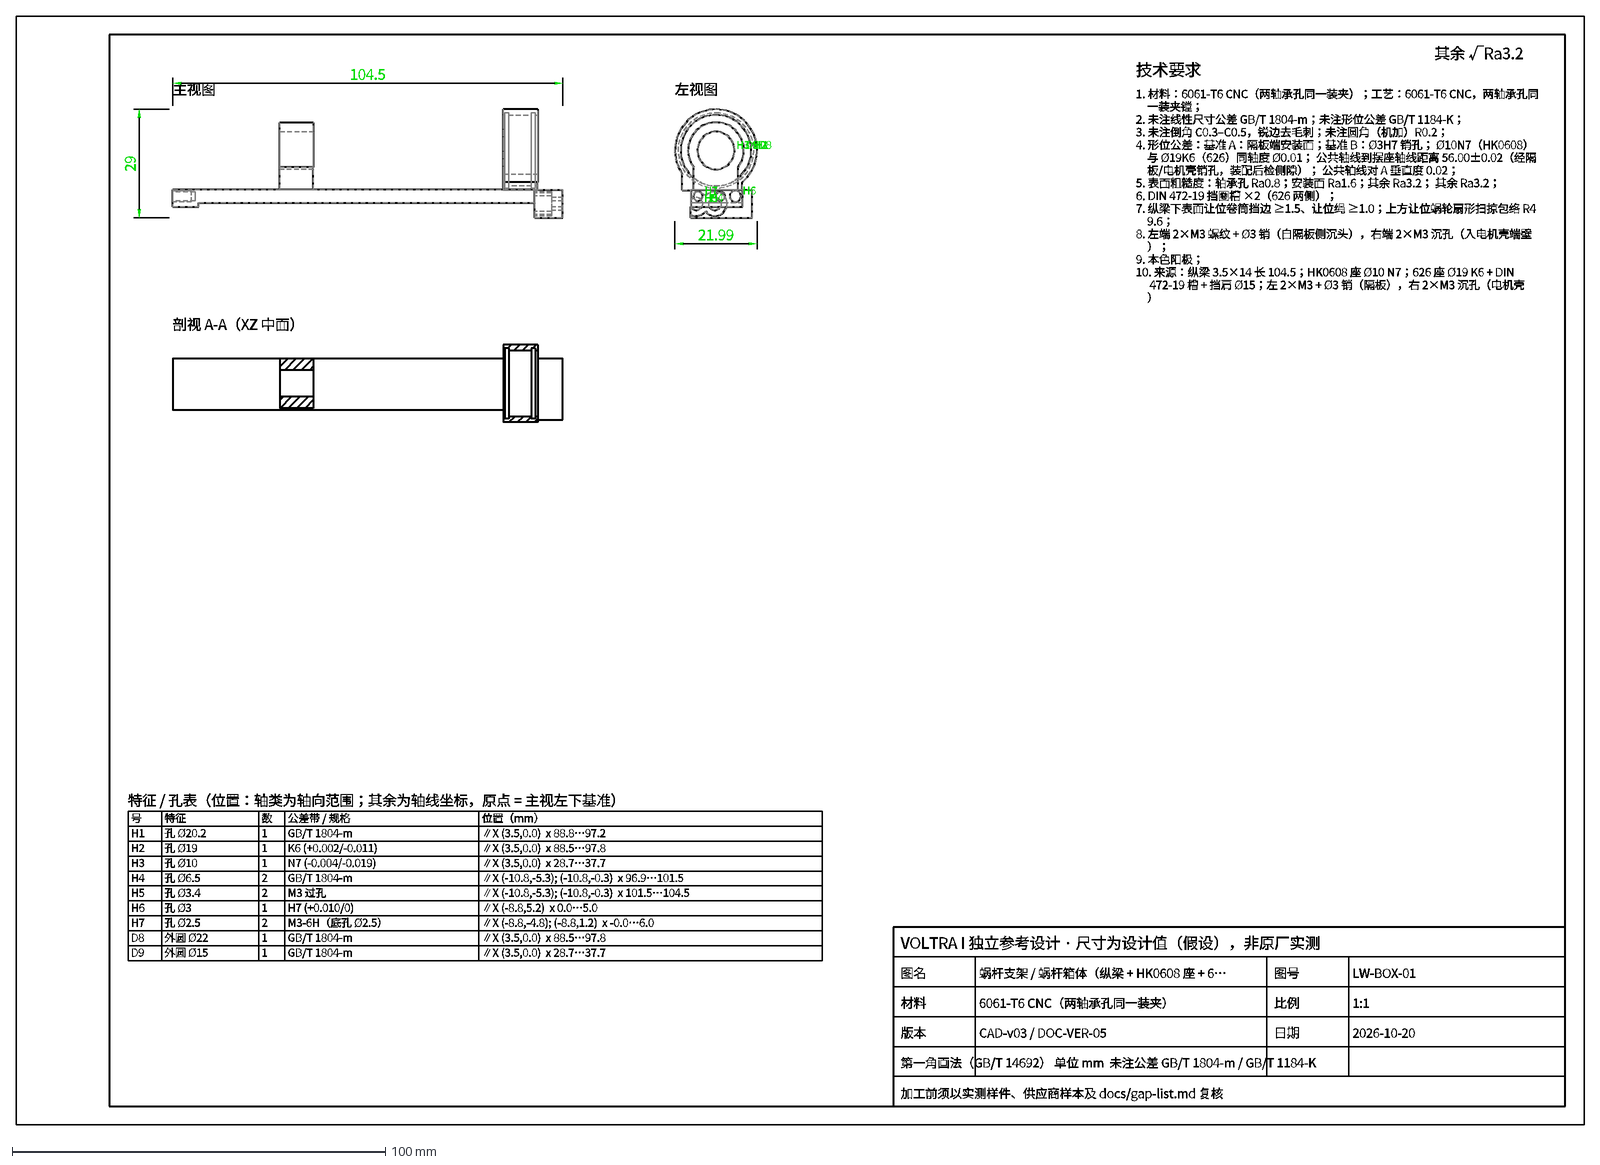
[picture p62: CAD file, 2026-10-20]
downloads/drawings/LW-BOX-01.dxf
主视图
左视图
剖视 A-A（XZ 中面）
104.5
29
21.99
H1
H2
H3
H4
H5
H6
H7
D8
D9
特征 / 孔表（位置：轴类为轴向范围；其余为轴线坐标，原点 = 主视左下基准）
号
特征
数
公差带 / 规格
位置（mm）
孔 Ø20.2
1
GB/T 1804-m
∥X (3.5,0.0) x 88.8…97.2
孔 Ø19
K6 (+0.002/-0.011)
∥X (3.5,0.0) x 88.5…97.8
孔 Ø10
N7 (-0.004/-0.019)
∥X (3.5,0.0) x 28.7…37.7
孔 Ø6.5
2
∥X (-10.8,-5.3); (-10.8,-0.3) x 96.9…101.5
孔 Ø3.4
M3 过孔
∥X (-10.8,-5.3); (-10.8,-0.3) x 101.5…104.5
孔 Ø3
H7 (+0.010/0)
∥X (-8.8,5.2) x 0.0…5.0
孔 Ø2.5
M3-6H（底孔 Ø2.5）
∥X (-8.8,-4.8); (-8.8,1.2) x -0.0…6.0
外圆 Ø22
外圆 Ø15
技术要求
1. 材料：6061-T6 CNC（两轴承孔同一装夹）；工艺：6061-T6 CNC，两轴承孔同
一装夹镗；
2. 未注线性尺寸公差 GB/T 1804-m；未注形位公差 GB/T 1184-K；
3. 未注倒角 C0.3–C0.5，锐边去毛刺；未注圆角（机加）R0.2；
4. 形位公差：基准 A：隔板端安装面；基准 B：Ø3H7 销孔； Ø10N7（HK0608）
与 Ø19K6（626）同轴度 Ø0.01； 公共轴线到摆座轴线距离 56.00±0.02（经隔
板/电机壳销孔，装配后检侧隙）； 公共轴线对 A 垂直度 0.02；
5. 表面粗糙度：轴承孔 Ra0.8；安装面 Ra1.6；其余 Ra3.2； 其余 Ra3.2；
6. DIN 472-19 挡圈槽 ×2（626 两侧）；
7. 纵梁下表面让位卷筒挡边 ≥1.5、让位绳 ≥1.0；上方让位蜗轮扇形扫掠包络 R4
9.6；
8. 左端 2×M3 螺纹 + Ø3 销（自隔板侧沉头），右端 2×M3 沉孔（入电机壳端壁
）；
9. 本色阳极；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
