merlinwwu/voltra-i-ref-3d/downloads/drawings/LW-WHEEL-01.dxf

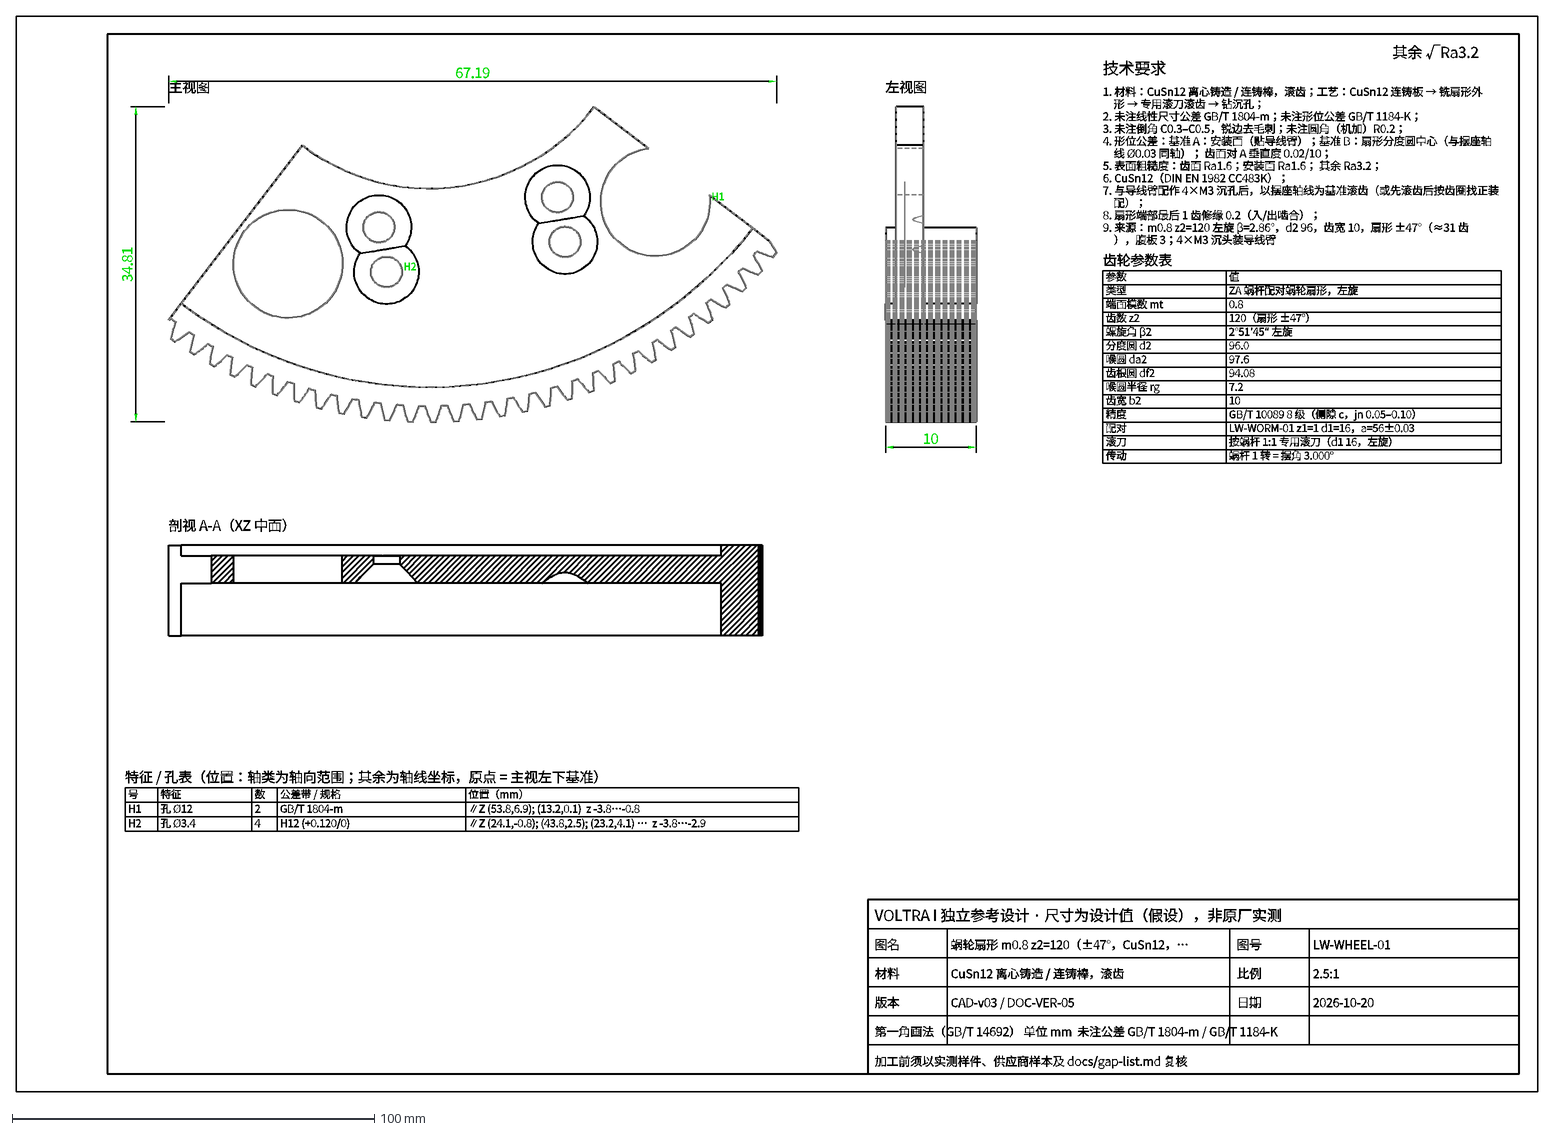
[picture p63: CAD file, 2026-10-20]
downloads/drawings/LW-WHEEL-01.dxf
主视图
左视图
剖视 A-A（XZ 中面）
67.19
34.81
10
H1
H2
特征 / 孔表（位置：轴类为轴向范围；其余为轴线坐标，原点 = 主视左下基准）
号
特征
数
公差带 / 规格
位置（mm）
孔 Ø12
2
GB/T 1804-m
∥Z (53.8,6.9); (13.2,0.1) z -3.8…-0.8
孔 Ø3.4
4
H12 (+0.120/0)
∥Z (24.1,-0.8); (43.8,2.5); (23.2,4.1) … z -3.8…-2.9
技术要求
1. 材料：CuSn12 离心铸造 / 连铸棒，滚齿；工艺：CuSn12 连铸板 → 铣扇形外
形 → 专用滚刀滚齿 → 钻沉孔；
2. 未注线性尺寸公差 GB/T 1804-m；未注形位公差 GB/T 1184-K；
3. 未注倒角 C0.3–C0.5，锐边去毛刺；未注圆角（机加）R0.2；
4. 形位公差：基准 A：安装面（贴导线臂）；基准 B：扇形分度圆中心（与摆座轴
线 Ø0.03 同轴）； 齿面对 A 垂直度 0.02/10；
5. 表面粗糙度：齿面 Ra1.6；安装面 Ra1.6； 其余 Ra3.2；
6. CuSn12（DIN EN 1982 CC483K）；
7. 与导线臂配作 4×M3 沉孔后，以摆座轴线为基准滚齿（或先滚齿后按齿圈找正装
配）；
8. 扇形端部最后 1 齿修缘 0.2（入/出啮合）；
9. 来源：m0.8 z2=120 左旋 β=2.86°，d2 96，齿宽 10，扇形 ±47°（≈31 齿
），腹板 3；4×M3 沉头装导线臂
齿轮参数表
参数
值
类型
ZA 蜗杆配对蜗轮扇形，左旋
端面模数 mt
0.8
齿数 z2
120（扇形 ±47°）
螺旋角 β2
2°51′45″ 左旋
分度圆 d2
96.0
喉圆 da2
97.6
齿根圆 df2
94.08
喉圆半径 rg
7.2
齿宽 b2
精度
GB/T 10089 8 级（侧隙 c，jn 0.05–0.10）
配对
LW-WORM-01 z1=1 d1=16，a=56±0.03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
