merlinwwu/voltra-i-ref-3d/downloads/step/WSPR-BRG02.step

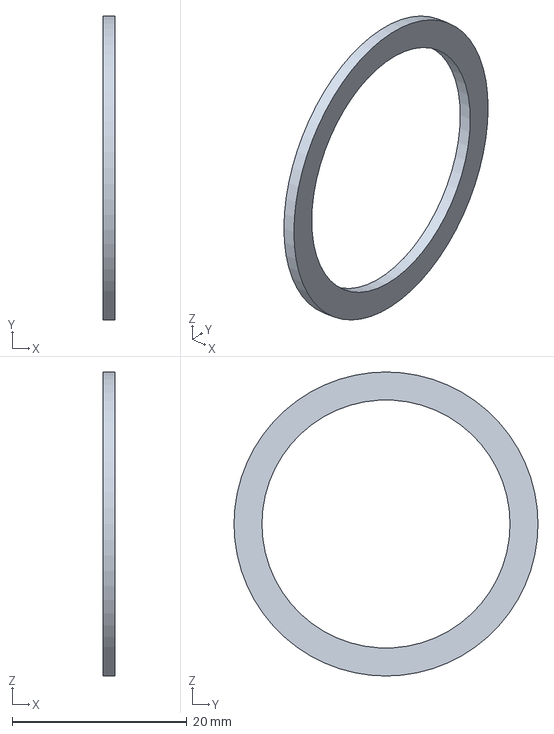
[picture p64: CAD file, 2026-10-20]
downloads/step/WSPR-BRG02.step
1.40 x 34.8 x 34.8 mm
