merlinwwu/voltra-i-ref-3d/downloads/drawings/LW-IDL-01.dxf

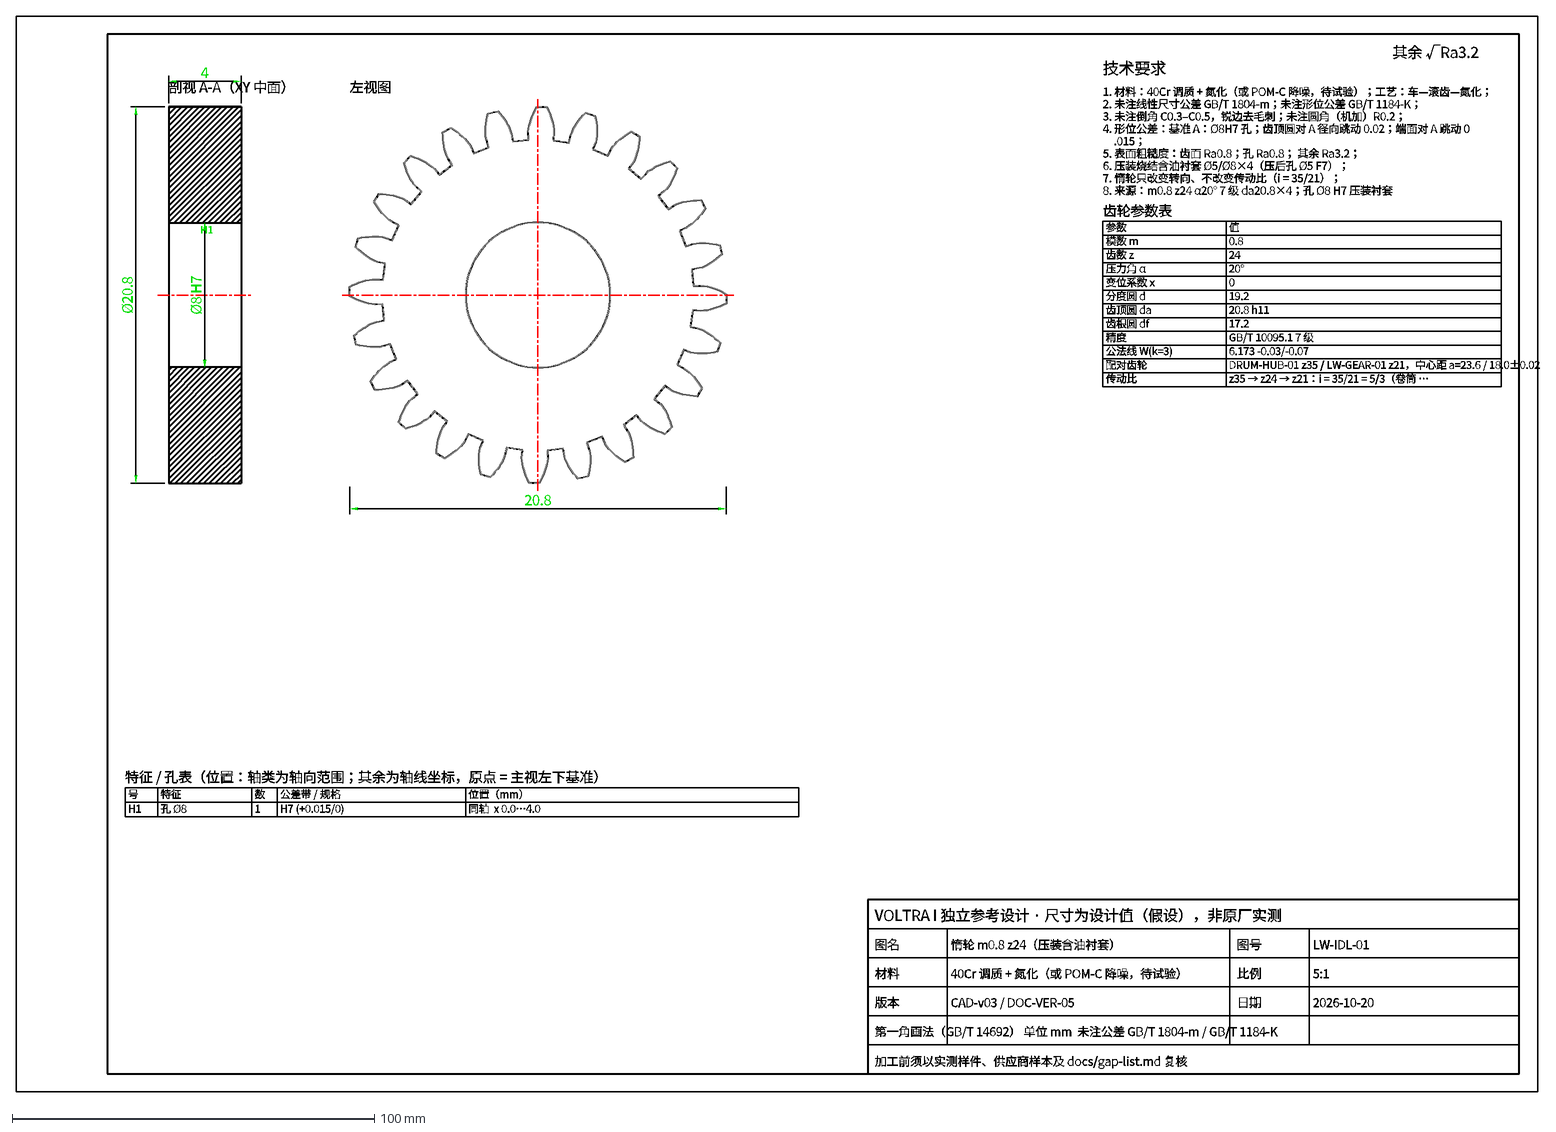
[picture p65: CAD file, 2026-10-20]
downloads/drawings/LW-IDL-01.dxf
剖视 A-A（XY 中面）
左视图
4
Ø20.8
20.8
H1
Ø8 H7
特征 / 孔表（位置：轴类为轴向范围；其余为轴线坐标，原点 = 主视左下基准）
号
特征
数
公差带 / 规格
位置（mm）
孔 Ø8
1
H7 (+0.015/0)
同轴 x 0.0…4.0
技术要求
1. 材料：40Cr 调质 + 氮化（或 POM-C 降噪，待试验）；工艺：车—滚齿—氮化；
2. 未注线性尺寸公差 GB/T 1804-m；未注形位公差 GB/T 1184-K；
3. 未注倒角 C0.3–C0.5，锐边去毛刺；未注圆角（机加）R0.2；
4. 形位公差：基准 A：Ø8H7 孔；齿顶圆对 A 径向跳动 0.02；端面对 A 跳动 0
.015；
5. 表面粗糙度：齿面 Ra0.8；孔 Ra0.8； 其余 Ra3.2；
6. 压装烧结含油衬套 Ø5/Ø8×4（压后孔 Ø5 F7）；
7. 惰轮只改变转向、不改变传动比（i = 35/21）；
8. 来源：m0.8 z24 α20° 7 级 da20.8×4；孔 Ø8 H7 压装衬套
齿轮参数表
参数
值
模数 m
0.8
齿数 z
24
压力角 α
20°
变位系数 x
0
分度圆 d
19.2
齿顶圆 da
20.8 h11
齿根圆 df
17.2
精度
GB/T 10095.1 7 级
公法线 W(k=3)
6.173 -0.03/-0.07
配对齿轮
DRUM-HUB-01 z35 / LW-GEAR-01 z21，中心距 a=23.6 / 18.0±0.02
传动比
z35 → z24 → z21：i = 35/21 = 5/3（卷筒 …
其余 √Ra3.2
VOLTRA I 独立参考设计 · 尺寸为设计值（假设），非原厂实测
图名
惰轮 m0.8 z24（压装含油衬套）
图号
LW-IDL-01
材料
40Cr 调质 + 氮化（或 POM-C 降噪，待试验）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
