merlinwwu/voltra-i-ref-3d/downloads/step/SCR-DOCK-01.step

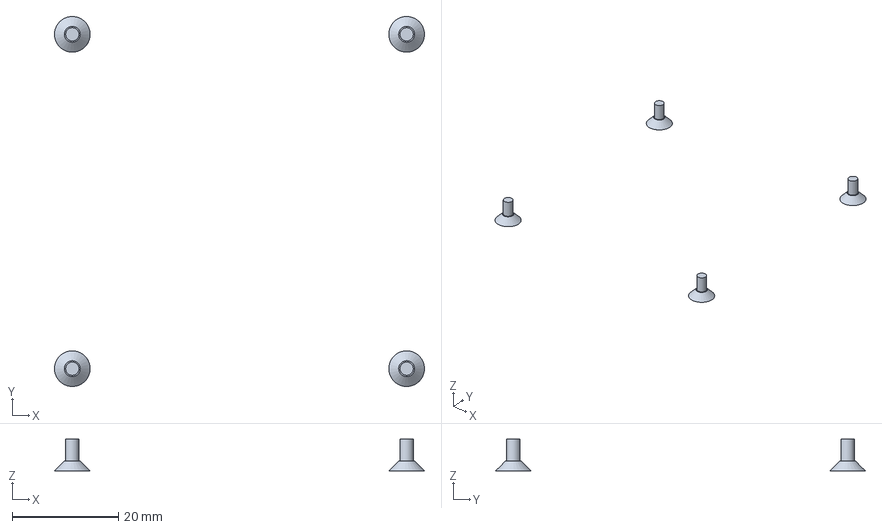
[picture p66: CAD file, 2026-10-20]
downloads/step/SCR-DOCK-01.step
69.6 x 69.6 x 6.00 mm
