merlinwwu/voltra-i-ref-3d/downloads/drawings/EXIT-UNI-01.dxf

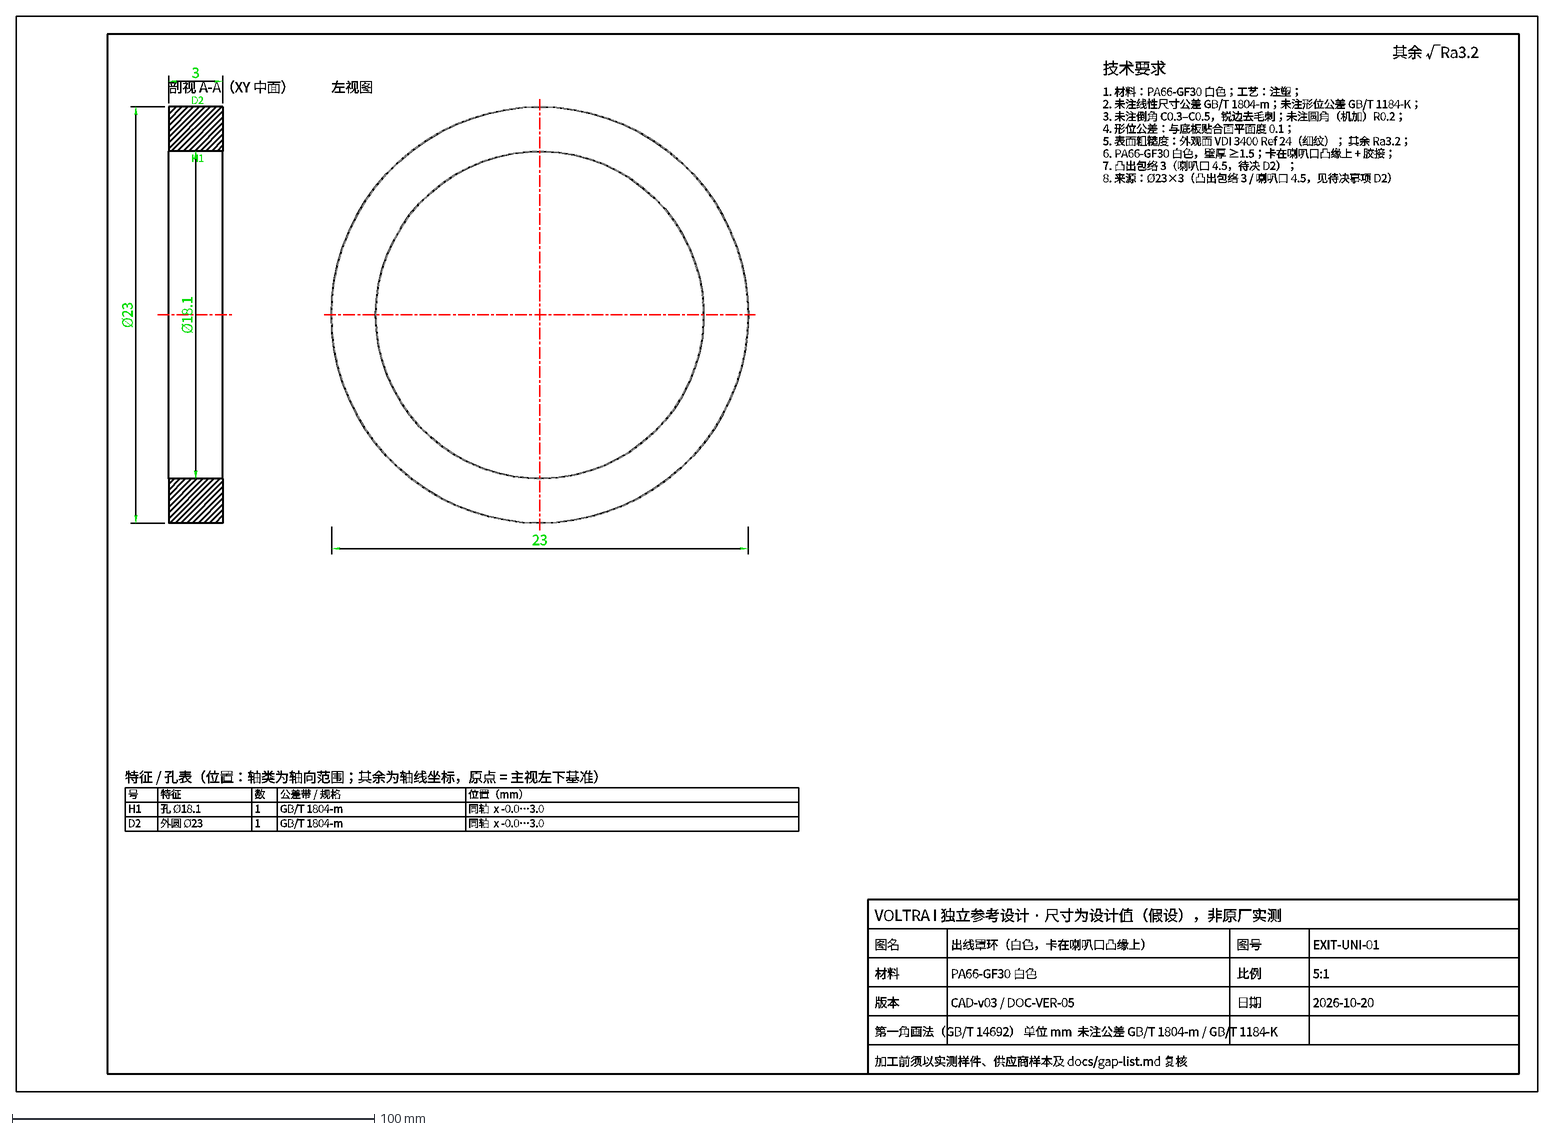
[picture p67: CAD file, 2026-10-20]
downloads/drawings/EXIT-UNI-01.dxf
剖视 A-A（XY 中面）
左视图
3
Ø23
23
H1
Ø18.1
D2
特征 / 孔表（位置：轴类为轴向范围；其余为轴线坐标，原点 = 主视左下基准）
号
特征
数
公差带 / 规格
位置（mm）
孔 Ø18.1
1
GB/T 1804-m
同轴 x -0.0…3.0
外圆 Ø23
技术要求
1. 材料：PA66-GF30 白色；工艺：注塑；
2. 未注线性尺寸公差 GB/T 1804-m；未注形位公差 GB/T 1184-K；
3. 未注倒角 C0.3–C0.5，锐边去毛刺；未注圆角（机加）R0.2；
4. 形位公差：与底板贴合面平面度 0.1；
5. 表面粗糙度：外观面 VDI 3400 Ref 24（细纹）； 其余 Ra3.2；
6. PA66-GF30 白色，壁厚 ≥1.5；卡在喇叭口凸缘上 + 胶接；
7. 凸出包络 3（喇叭口 4.5，待决 D2）；
8. 来源：Ø23×3（凸出包络 3 / 喇叭口 4.5，见待决事项 D2）
其余 √Ra3.2
VOLTRA I 独立参考设计 · 尺寸为设计值（假设），非原厂实测
图名
出线罩环（白色，卡在喇叭口凸缘上）
图号
EXIT-UNI-01
材料
PA66-GF30 白色
比例
5:1
版本
CAD-v03 / DOC-VER-05
日期
2026-10-20
第一角画法（GB/T 14692） 单位 mm 未注公差 GB/T 1804-m / GB/T 1184-K
加工前须以实测样件、供应商样本及 docs/gap-list.md 复核
