merlinwwu/voltra-i-ref-3d/downloads/step/SCR-LWA-01.step

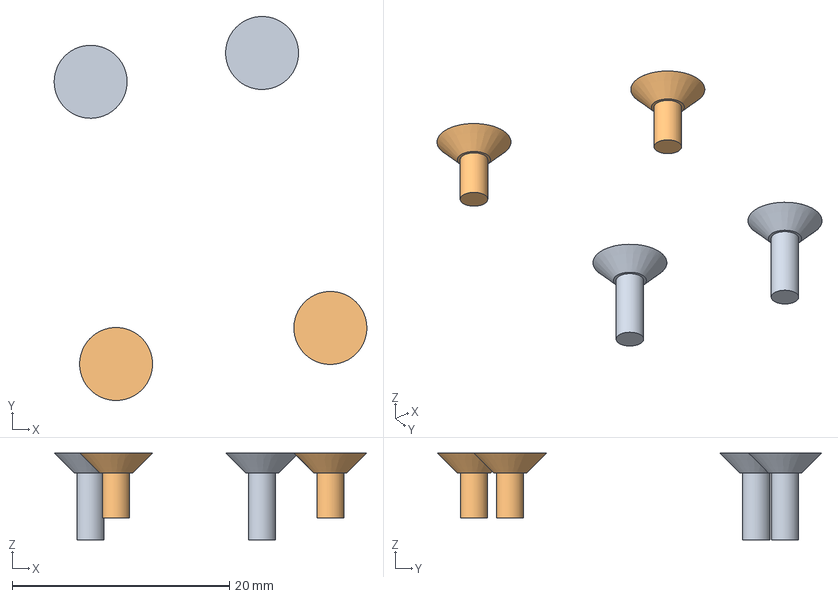
[picture p68: CAD file, 2026-10-20]
downloads/step/SCR-LWA-01.step
28.8 x 35.3 x 8.00 mm
