merlinwwu/voltra-i-ref-3d/downloads/step/ENC-PCB-01.step

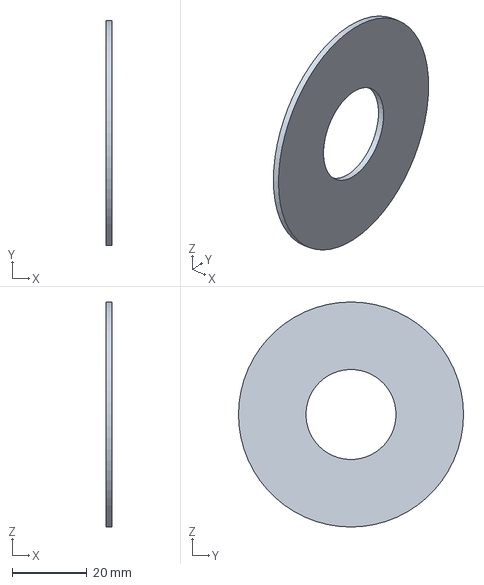
[picture p69: CAD file, 2026-10-20]
downloads/step/ENC-PCB-01.step
1.60 x 60.0 x 60.0 mm
