merlinwwu/voltra-i-ref-3d/downloads/drawings/BRG-03-HSG.dxf

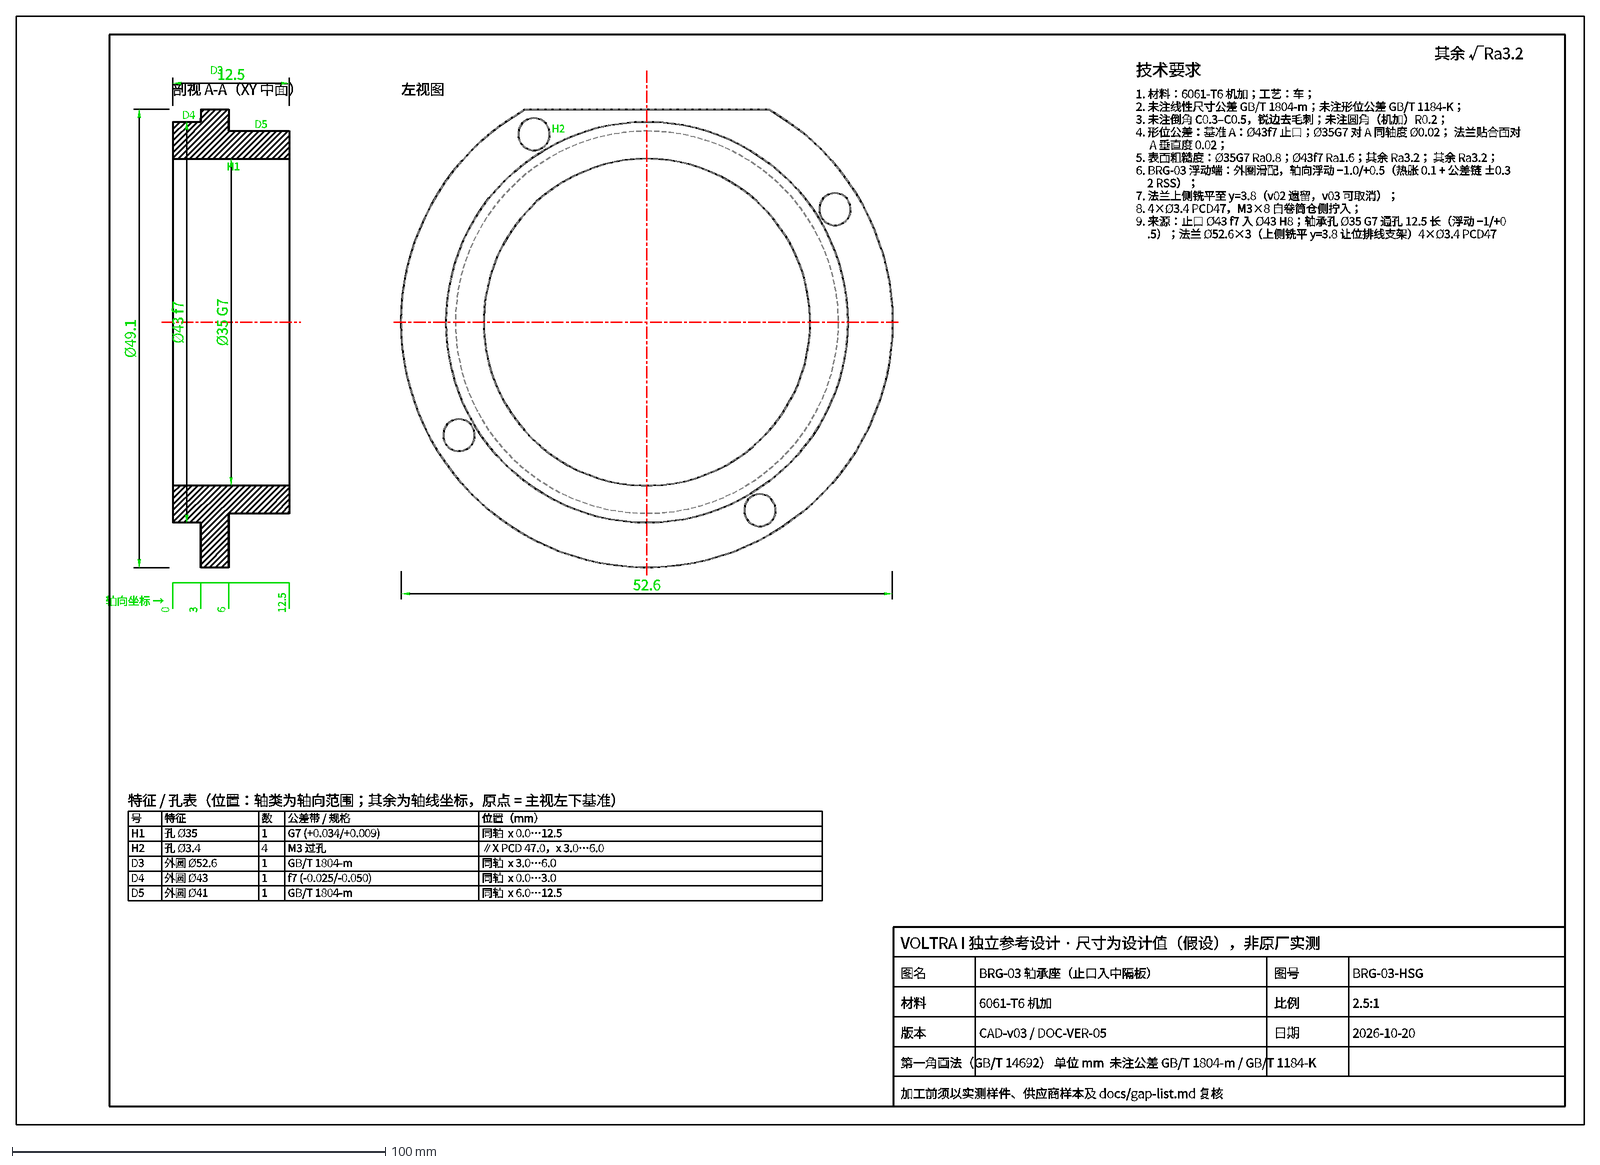
[picture p70: CAD file, 2026-10-20]
downloads/drawings/BRG-03-HSG.dxf
剖视 A-A（XY 中面）
左视图
12.5
Ø49.1
52.6
0
3
6
轴向坐标 →
H1
Ø35 G7
H2
D3
D4
Ø43 f7
D5
特征 / 孔表（位置：轴类为轴向范围；其余为轴线坐标，原点 = 主视左下基准）
号
特征
数
公差带 / 规格
位置（mm）
孔 Ø35
1
G7 (+0.034/+0.009)
同轴 x 0.0…12.5
孔 Ø3.4
4
M3 过孔
∥X PCD 47.0，x 3.0…6.0
外圆 Ø52.6
GB/T 1804-m
同轴 x 3.0…6.0
外圆 Ø43
f7 (-0.025/-0.050)
同轴 x 0.0…3.0
外圆 Ø41
同轴 x 6.0…12.5
技术要求
1. 材料：6061-T6 机加；工艺：车；
2. 未注线性尺寸公差 GB/T 1804-m；未注形位公差 GB/T 1184-K；
3. 未注倒角 C0.3–C0.5，锐边去毛刺；未注圆角（机加）R0.2；
4. 形位公差：基准 A：Ø43f7 止口；Ø35G7 对 A 同轴度 Ø0.02； 法兰贴合面对
A 垂直度 0.02；
5. 表面粗糙度：Ø35G7 Ra0.8；Ø43f7 Ra1.6；其余 Ra3.2； 其余 Ra3.2；
6. BRG-03 浮动端：外圈滑配，轴向浮动 −1.0/+0.5（热胀 0.1 + 公差链 ±0.3
2 RSS）；
7. 法兰上侧铣平至 y=3.8（v02 遗留，v03 可取消）；
8. 4×Ø3.4 PCD47，M3×8 自卷筒仓侧拧入；
9. 来源：止口 Ø43 f7 入 Ø43 H8；轴承孔 Ø35 G7 通孔 12.5 长（浮动 −1/+0
.5）；法兰 Ø52.6×3（上侧铣平 y=3.8 让位排线支架）4×Ø3.4 PCD47
其余 √Ra3.2
VOLTRA I 独立参考设计 · 尺寸为设计值（假设），非原厂实测
图名
BRG-03 轴承座（止口入中隔板）
图号
BRG-03-HSG
材料
6061-T6 机加
比例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
