merlinwwu/voltra-i-ref-3d/downloads/step/LCD-01.step

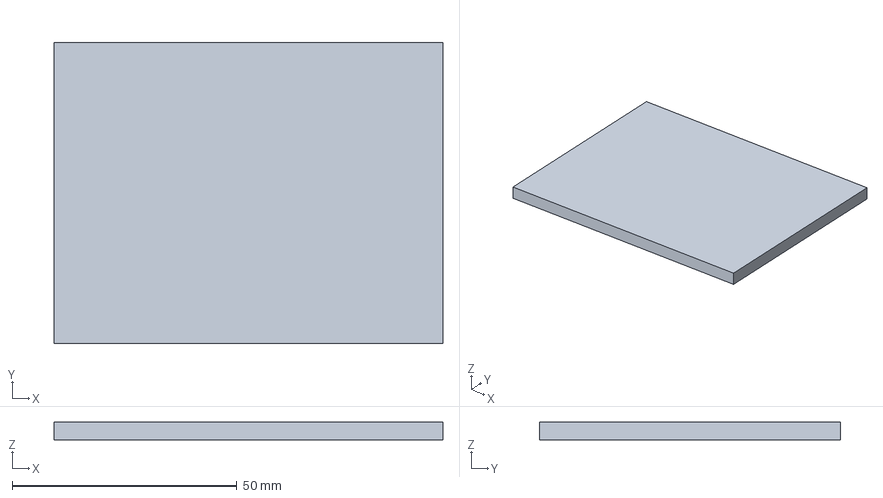
[picture p71: CAD file, 2026-10-20]
downloads/step/LCD-01.step
86.5 x 67.0 x 4.00 mm
