merlinwwu/voltra-i-ref-3d/downloads/drawings/HSG-FRAME-01.dxf

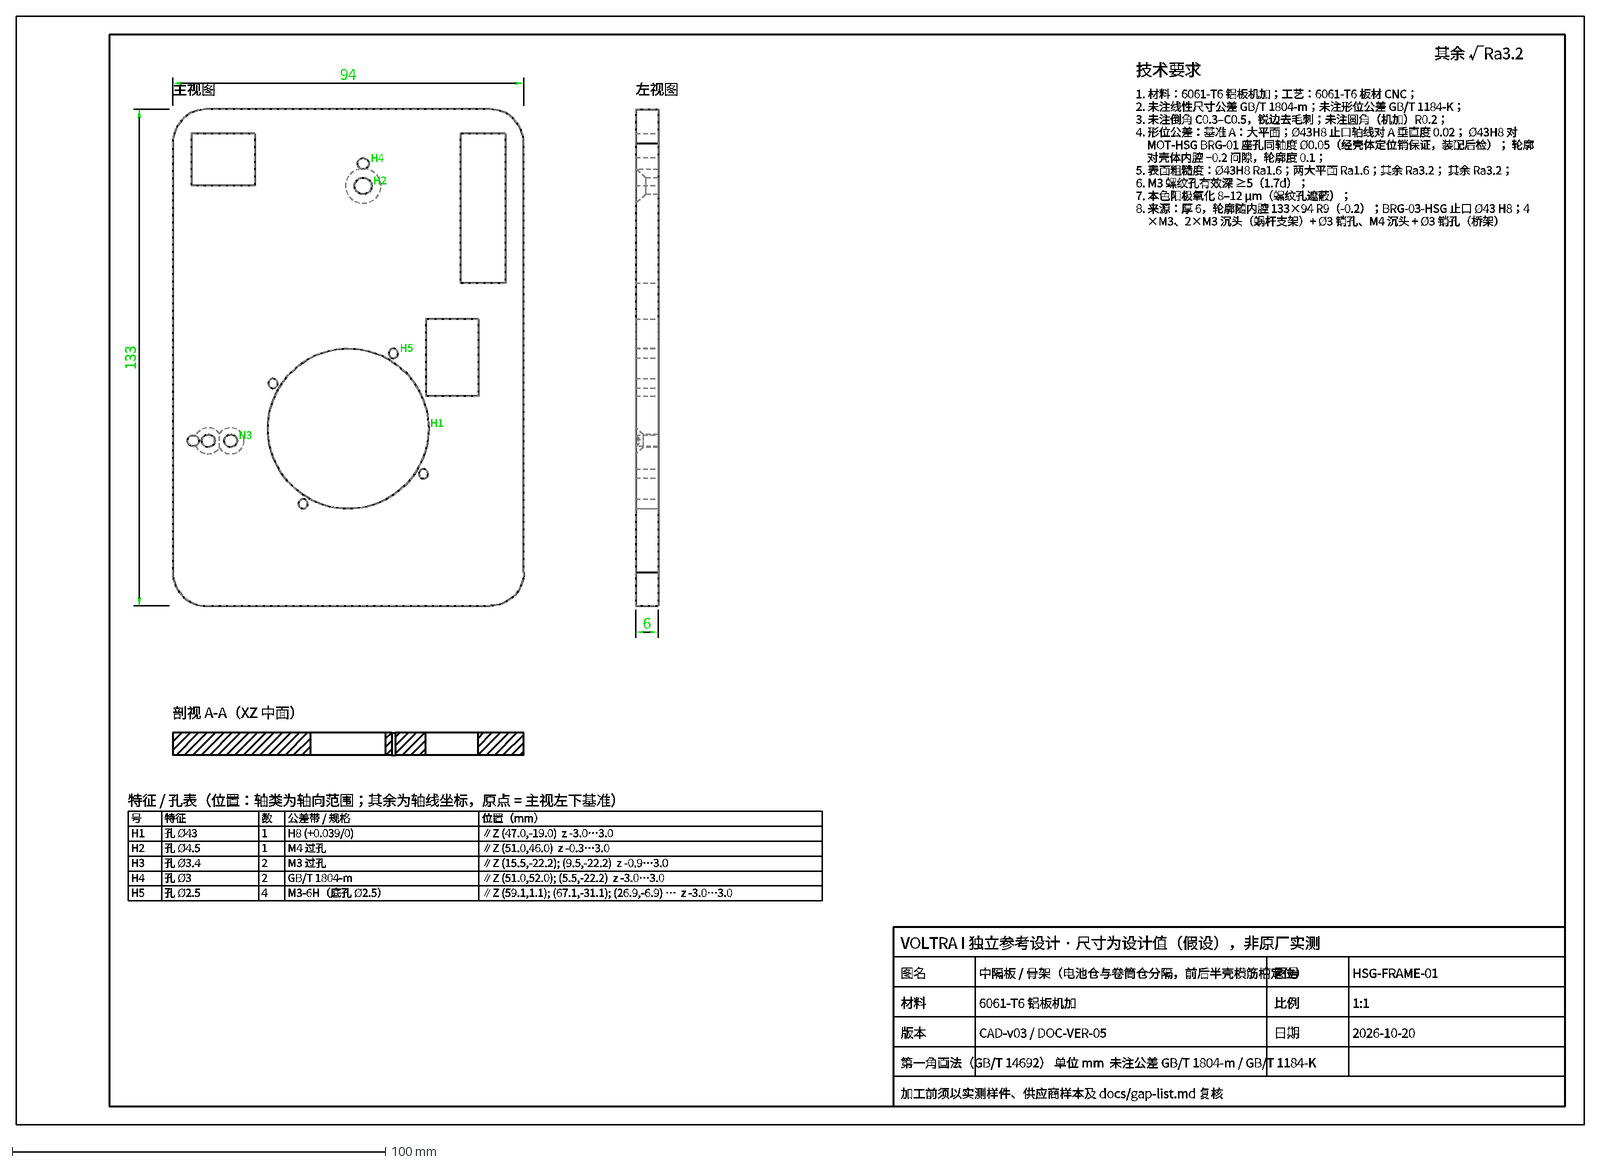
[picture p72: CAD file, 2026-10-20]
downloads/drawings/HSG-FRAME-01.dxf
主视图
左视图
剖视 A-A（XZ 中面）
94
133
6
H1
H2
H3
H4
H5
特征 / 孔表（位置：轴类为轴向范围；其余为轴线坐标，原点 = 主视左下基准）
号
特征
数
公差带 / 规格
位置（mm）
孔 Ø43
1
H8 (+0.039/0)
∥Z (47.0,-19.0) z -3.0…3.0
孔 Ø4.5
M4 过孔
∥Z (51.0,46.0) z -0.3…3.0
孔 Ø3.4
2
M3 过孔
∥Z (15.5,-22.2); (9.5,-22.2) z -0.9…3.0
孔 Ø3
GB/T 1804-m
∥Z (51.0,52.0); (5.5,-22.2) z -3.0…3.0
孔 Ø2.5
4
M3-6H（底孔 Ø2.5）
∥Z (59.1,1.1); (67.1,-31.1); (26.9,-6.9) … z -3.0…3.0
技术要求
1. 材料：6061-T6 铝板机加；工艺：6061-T6 板材 CNC；
2. 未注线性尺寸公差 GB/T 1804-m；未注形位公差 GB/T 1184-K；
3. 未注倒角 C0.3–C0.5，锐边去毛刺；未注圆角（机加）R0.2；
4. 形位公差：基准 A：大平面；Ø43H8 止口轴线对 A 垂直度 0.02； Ø43H8 对
MOT-HSG BRG-01 座孔同轴度 Ø0.05（经壳体定位销保证，装配后检）； 轮廓
对壳体内腔 −0.2 间隙，轮廓度 0.1；
5. 表面粗糙度：Ø43H8 Ra1.6；两大平面 Ra1.6；其余 Ra3.2； 其余 Ra3.2；
6. M3 螺纹孔有效深 ≥5（1.7d）；
7. 本色阳极氧化 8–12 µm（螺纹孔遮蔽）；
8. 来源：厚 6，轮廓随内腔 133×94 R9（-0.2）；BRG-03-HSG 止口 Ø43 H8；4
×M3、2×M3 沉头（蜗杆支架）+ Ø3 销孔、M4 沉头 + Ø3 销孔（桥架）
其余 √Ra3.2
VOLTRA I 独立参考设计 · 尺寸为设计值（假设），非原厂实测
图名
中隔板 / 骨架（电池仓与卷筒仓分隔，前后半壳横筋槽定位）
图号
HSG-FRAME-01
材料
6061-T6 铝板机加
比例
1:1
版本
CAD-v03 / DOC-VER-05
日期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
