merlinwwu/voltra-i-ref-3d/downloads/step/ROT-01.step

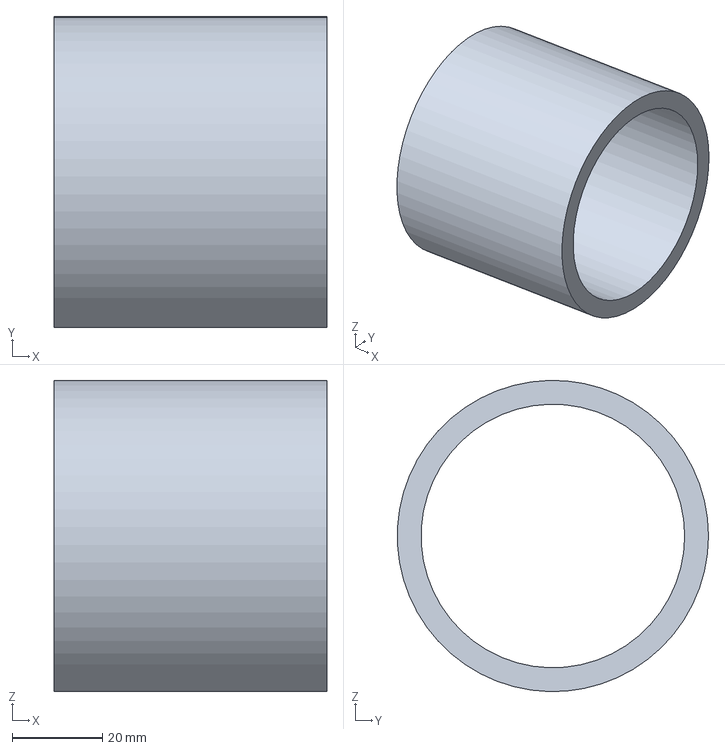
[picture p73: CAD file, 2026-10-20]
downloads/step/ROT-01.step
60.5 x 68.9 x 69.0 mm
