merlinwwu/voltra-i-ref-3d/downloads/step/DRUM-01.step

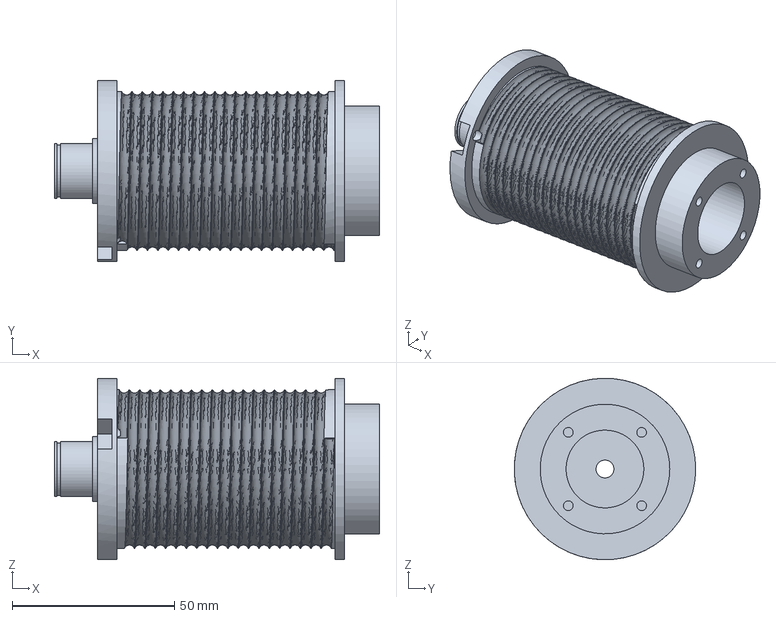
[picture p74: CAD file, 2026-10-20]
downloads/step/DRUM-01.step
100.3 x 56.0 x 56.0 mm
