merlinwwu/voltra-i-ref-3d/downloads/drawings/DRUM-HUB-01.dxf

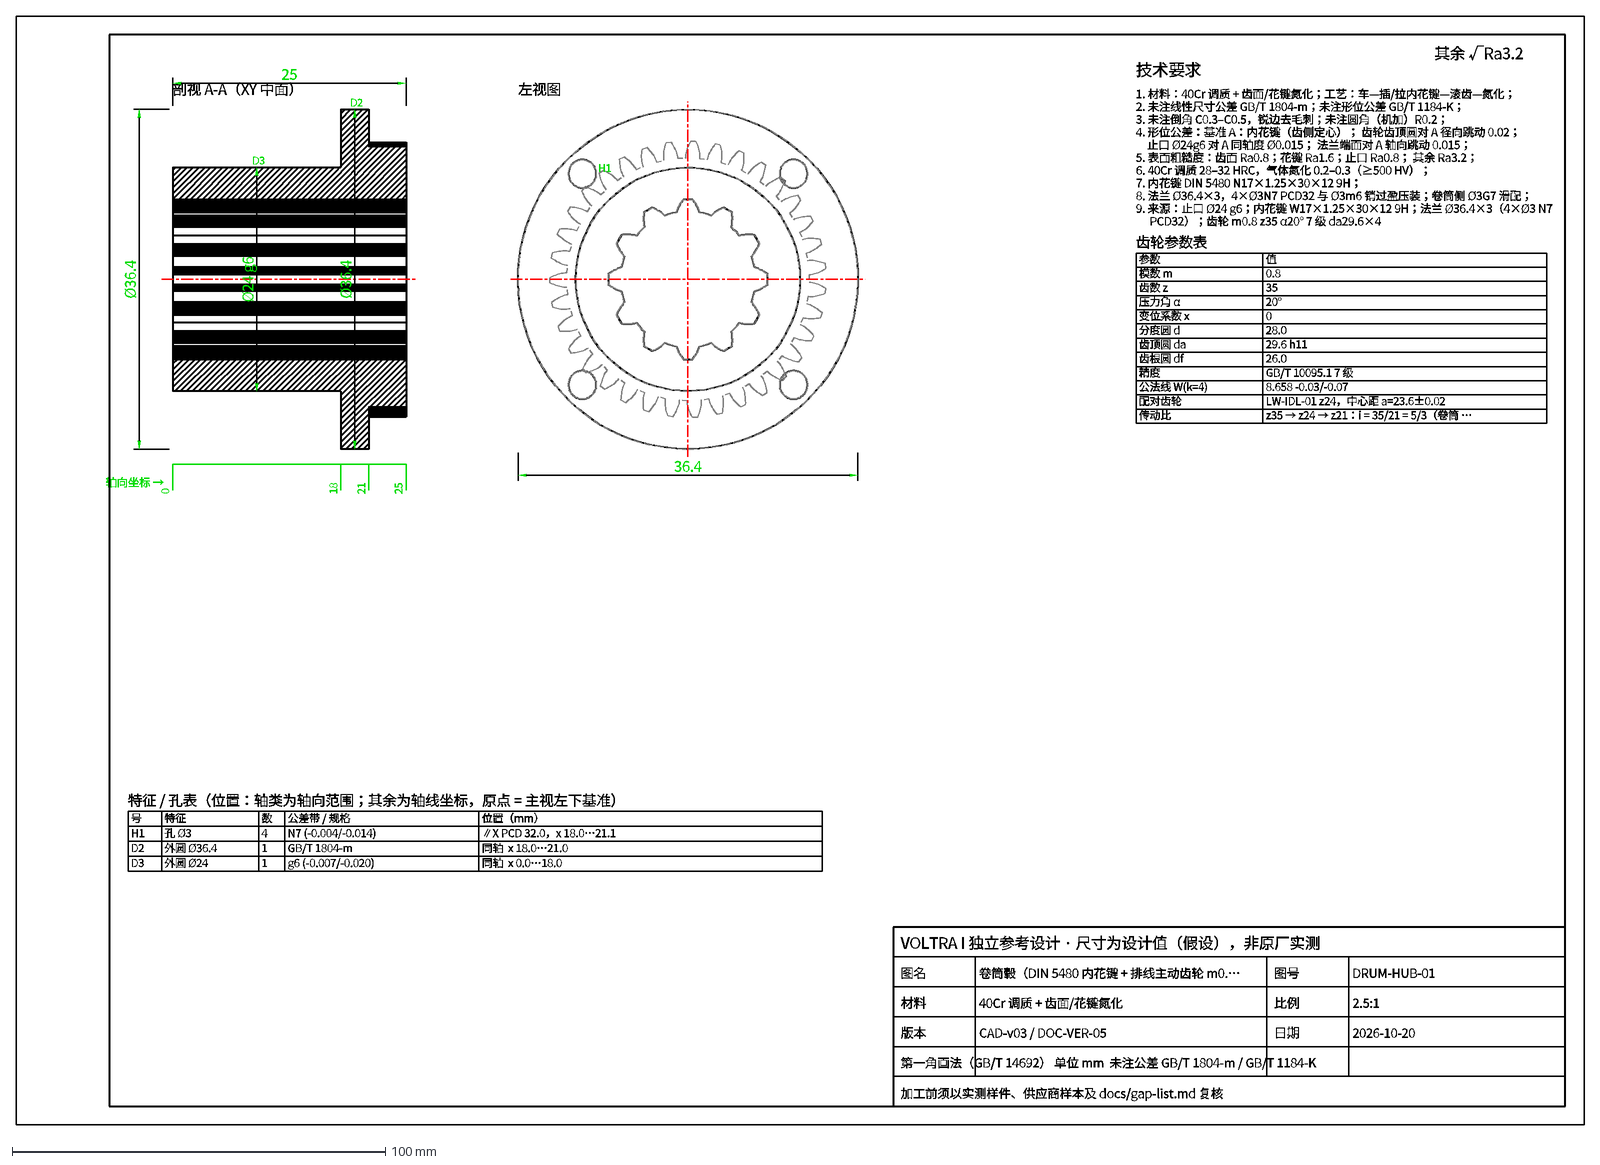
[picture p75: CAD file, 2026-10-20]
downloads/drawings/DRUM-HUB-01.dxf
剖视 A-A（XY 中面）
左视图
25
Ø36.4
36.4
0
18
21
轴向坐标 →
H1
D2
D3
Ø24 g6
特征 / 孔表（位置：轴类为轴向范围；其余为轴线坐标，原点 = 主视左下基准）
号
特征
数
公差带 / 规格
位置（mm）
孔 Ø3
4
N7 (-0.004/-0.014)
∥X PCD 32.0，x 18.0…21.1
外圆 Ø36.4
1
GB/T 1804-m
同轴 x 18.0…21.0
外圆 Ø24
g6 (-0.007/-0.020)
同轴 x 0.0…18.0
技术要求
1. 材料：40Cr 调质 + 齿面/花键氮化；工艺：车—插/拉内花键—滚齿—氮化；
2. 未注线性尺寸公差 GB/T 1804-m；未注形位公差 GB/T 1184-K；
3. 未注倒角 C0.3–C0.5，锐边去毛刺；未注圆角（机加）R0.2；
4. 形位公差：基准 A：内花键（齿侧定心）； 齿轮齿顶圆对 A 径向跳动 0.02；
止口 Ø24g6 对 A 同轴度 Ø0.015； 法兰端面对 A 轴向跳动 0.015；
5. 表面粗糙度：齿面 Ra0.8；花键 Ra1.6；止口 Ra0.8； 其余 Ra3.2；
6. 40Cr 调质 28–32 HRC，气体氮化 0.2–0.3（≥500 HV）；
7. 内花键 DIN 5480 N17×1.25×30×12 9H；
8. 法兰 Ø36.4×3，4×Ø3N7 PCD32 与 Ø3m6 销过盈压装；卷筒侧 Ø3G7 滑配；
9. 来源：止口 Ø24 g6；内花键 W17×1.25×30×12 9H；法兰 Ø36.4×3（4×Ø3 N7
PCD32）；齿轮 m0.8 z35 α20° 7 级 da29.6×4
齿轮参数表
参数
值
模数 m
0.8
齿数 z
35
压力角 α
20°
变位系数 x
分度圆 d
28.0
齿顶圆 da
29.6 h11
齿根圆 df
26.0
精度
GB/T 10095.1 7 级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
