merlinwwu/voltra-i-ref-3d/downloads/step/EXIT-GUIDE-01.step

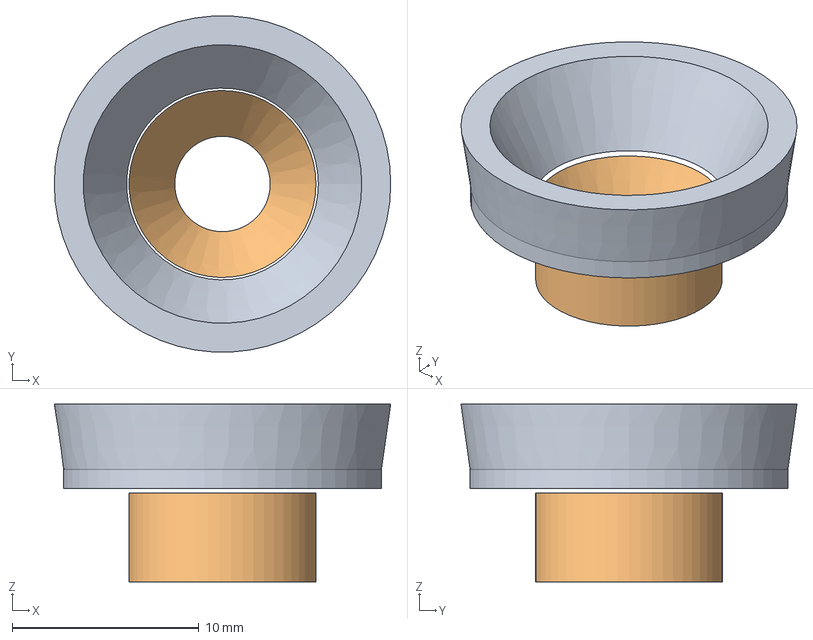
[picture p76: CAD file, 2026-10-20]
downloads/step/EXIT-GUIDE-01.step
18.0 x 18.0 x 9.50 mm
