merlinwwu/voltra-i-ref-3d/downloads/step/PIN-LWB-01.step

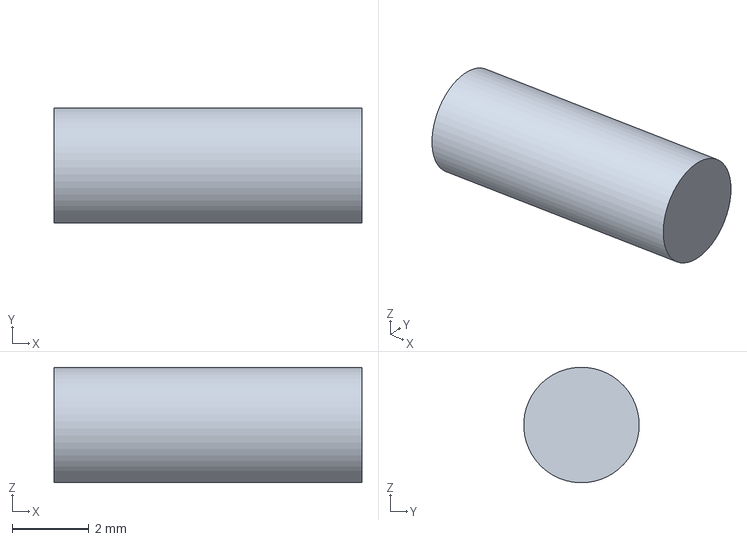
[picture p77: CAD file, 2026-10-20]
downloads/step/PIN-LWB-01.step
8.00 x 3.00 x 3.00 mm
