merlinwwu/voltra-i-ref-3d/downloads/drawings/MOT-SHAFT-01.dxf

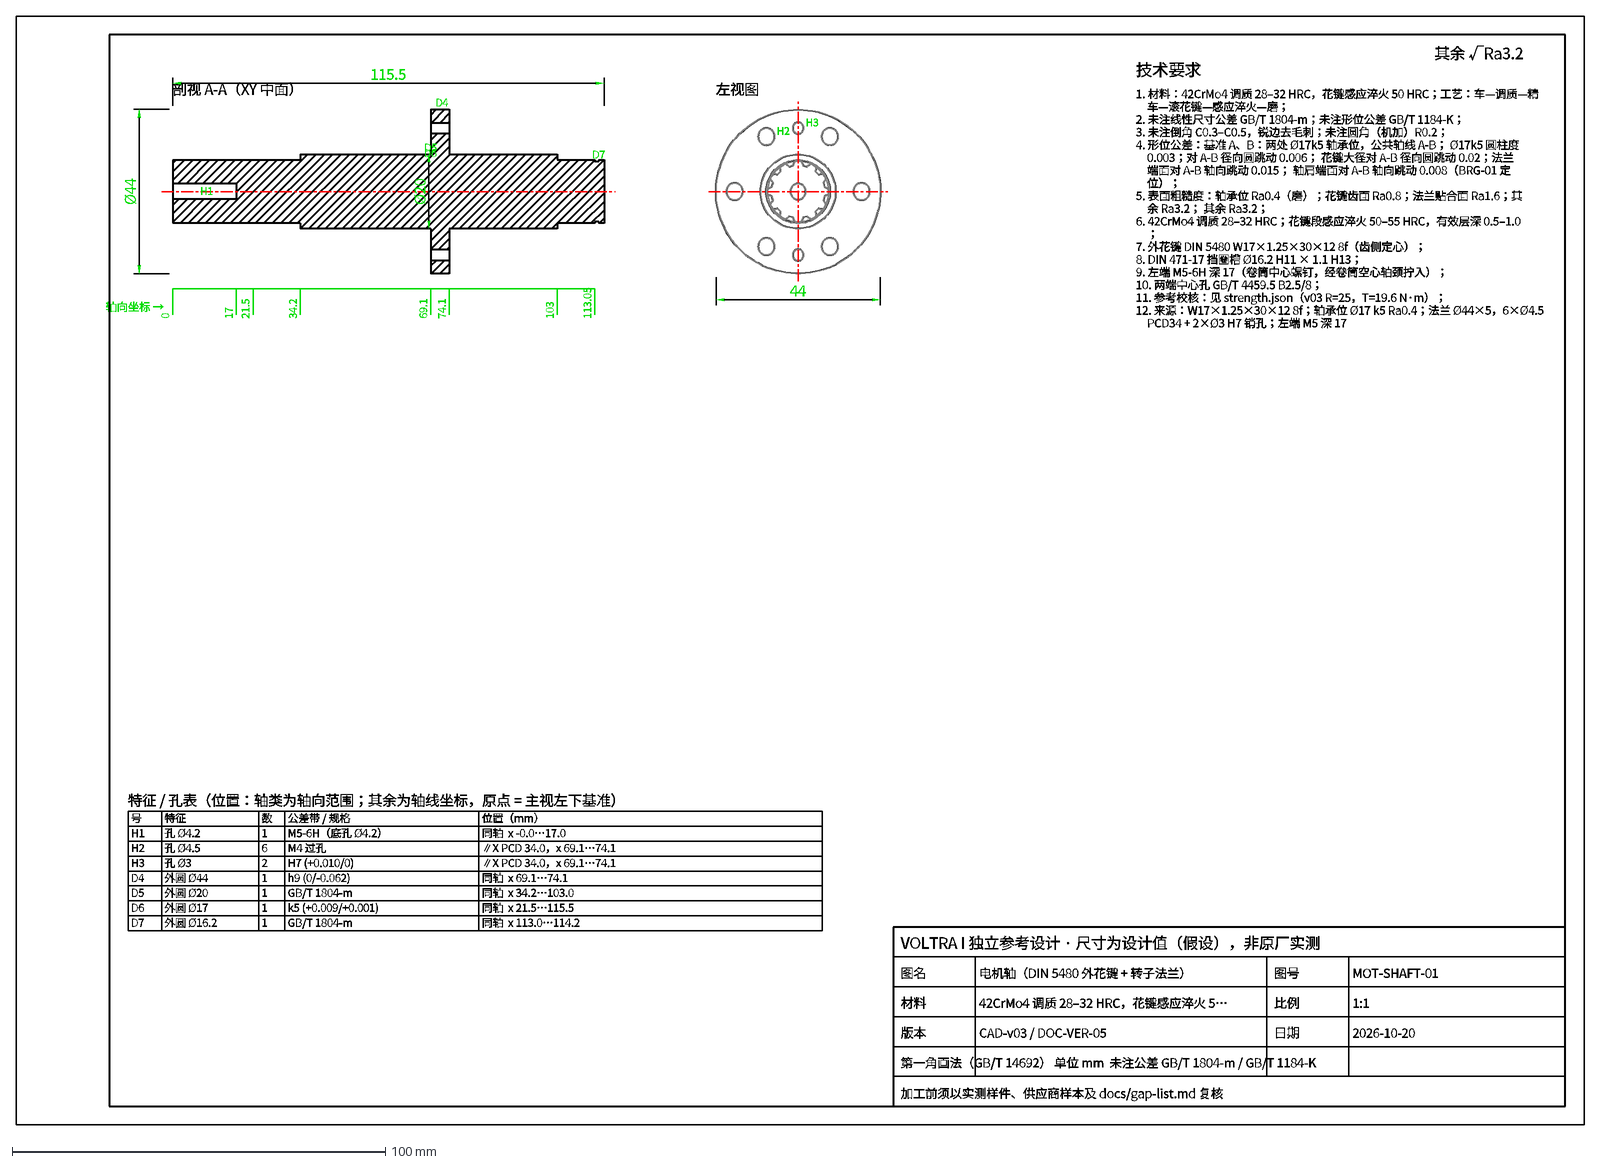
[picture p78: CAD file, 2026-10-20]
downloads/drawings/MOT-SHAFT-01.dxf
剖视 A-A（XY 中面）
左视图
115.5
Ø44
44
0
17
21.5
34.2
69.1
74.1
103
113.05
轴向坐标 →
H1
H2
H3
D4
D5
Ø20
D6
D7
特征 / 孔表（位置：轴类为轴向范围；其余为轴线坐标，原点 = 主视左下基准）
号
特征
数
公差带 / 规格
位置（mm）
孔 Ø4.2
1
M5-6H（底孔 Ø4.2）
同轴 x -0.0…17.0
孔 Ø4.5
6
M4 过孔
∥X PCD 34.0，x 69.1…74.1
孔 Ø3
2
H7 (+0.010/0)
外圆 Ø44
h9 (0/-0.062)
同轴 x 69.1…74.1
外圆 Ø20
GB/T 1804-m
同轴 x 34.2…103.0
外圆 Ø17
k5 (+0.009/+0.001)
同轴 x 21.5…115.5
外圆 Ø16.2
同轴 x 113.0…114.2
技术要求
1. 材料：42CrMo4 调质 28–32 HRC，花键感应淬火 50 HRC；工艺：车—调质—精
车—滚花键—感应淬火—磨；
2. 未注线性尺寸公差 GB/T 1804-m；未注形位公差 GB/T 1184-K；
3. 未注倒角 C0.3–C0.5，锐边去毛刺；未注圆角（机加）R0.2；
4. 形位公差：基准 A、B：两处 Ø17k5 轴承位，公共轴线 A-B； Ø17k5 圆柱度
0.003；对 A-B 径向圆跳动 0.006； 花键大径对 A-B 径向圆跳动 0.02；法兰
端面对 A-B 轴向跳动 0.015； 轴肩端面对 A-B 轴向跳动 0.008（BRG-01 定
位）；
5. 表面粗糙度：轴承位 Ra0.4（磨）；花键齿面 Ra0.8；法兰贴合面 Ra1.6；其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
