merlinwwu/voltra-i-ref-3d/downloads/step/SCR-BRIDGE-01.step

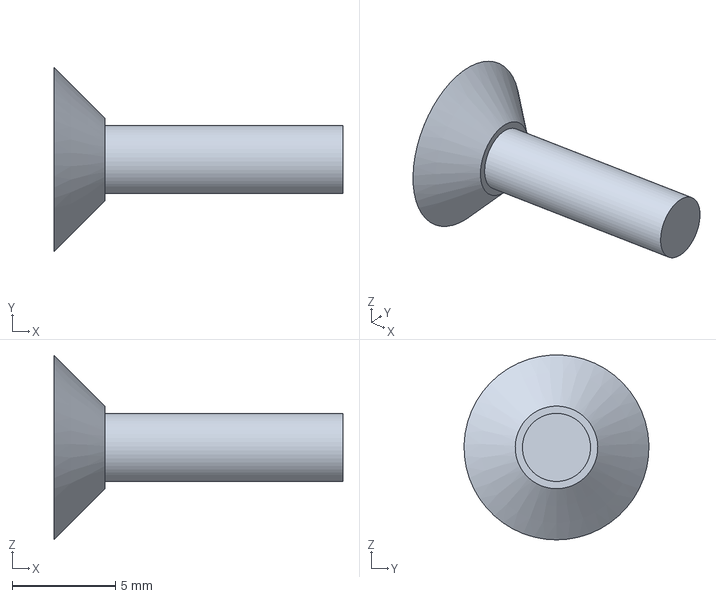
[picture p79: CAD file, 2026-10-20]
downloads/step/SCR-BRIDGE-01.step
14.0 x 8.96 x 8.95 mm
