merlinwwu/voltra-i-ref-3d/downloads/drawings/EXIT-AXL-01.dxf

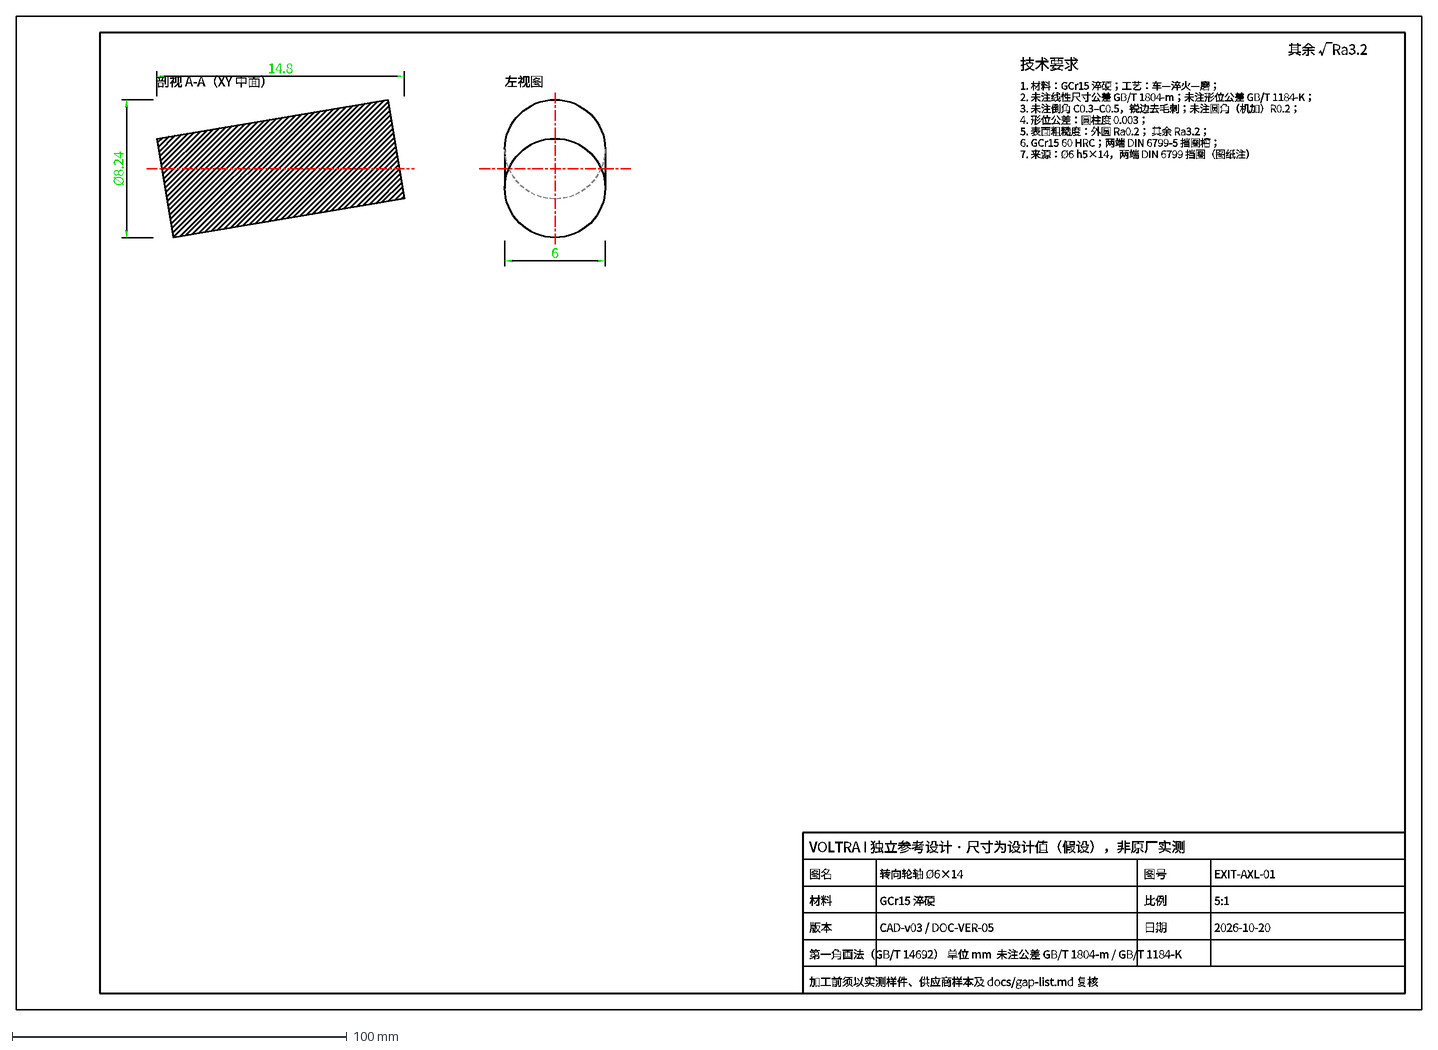
[picture p80: CAD file, 2026-10-20]
downloads/drawings/EXIT-AXL-01.dxf
剖视 A-A（XY 中面）
左视图
14.8
Ø8.24
6
技术要求
1. 材料：GCr15 淬硬；工艺：车—淬火—磨；
2. 未注线性尺寸公差 GB/T 1804-m；未注形位公差 GB/T 1184-K；
3. 未注倒角 C0.3–C0.5，锐边去毛刺；未注圆角（机加）R0.2；
4. 形位公差：圆柱度 0.003；
5. 表面粗糙度：外圆 Ra0.2； 其余 Ra3.2；
6. GCr15 60 HRC；两端 DIN 6799-5 挡圈槽；
7. 来源：Ø6 h5×14，两端 DIN 6799 挡圈（图纸注）
其余 √Ra3.2
VOLTRA I 独立参考设计 · 尺寸为设计值（假设），非原厂实测
图名
转向轮轴 Ø6×14
图号
EXIT-AXL-01
材料
GCr15 淬硬
比例
5:1
版本
CAD-v03 / DOC-VER-05
日期
2026-10-20
第一角画法（GB/T 14692） 单位 mm 未注公差 GB/T 1804-m / GB/T 1184-K
加工前须以实测样件、供应商样本及 docs/gap-list.md 复核
