merlinwwu/voltra-i-ref-3d/downloads/drawings/CONN-01.dxf

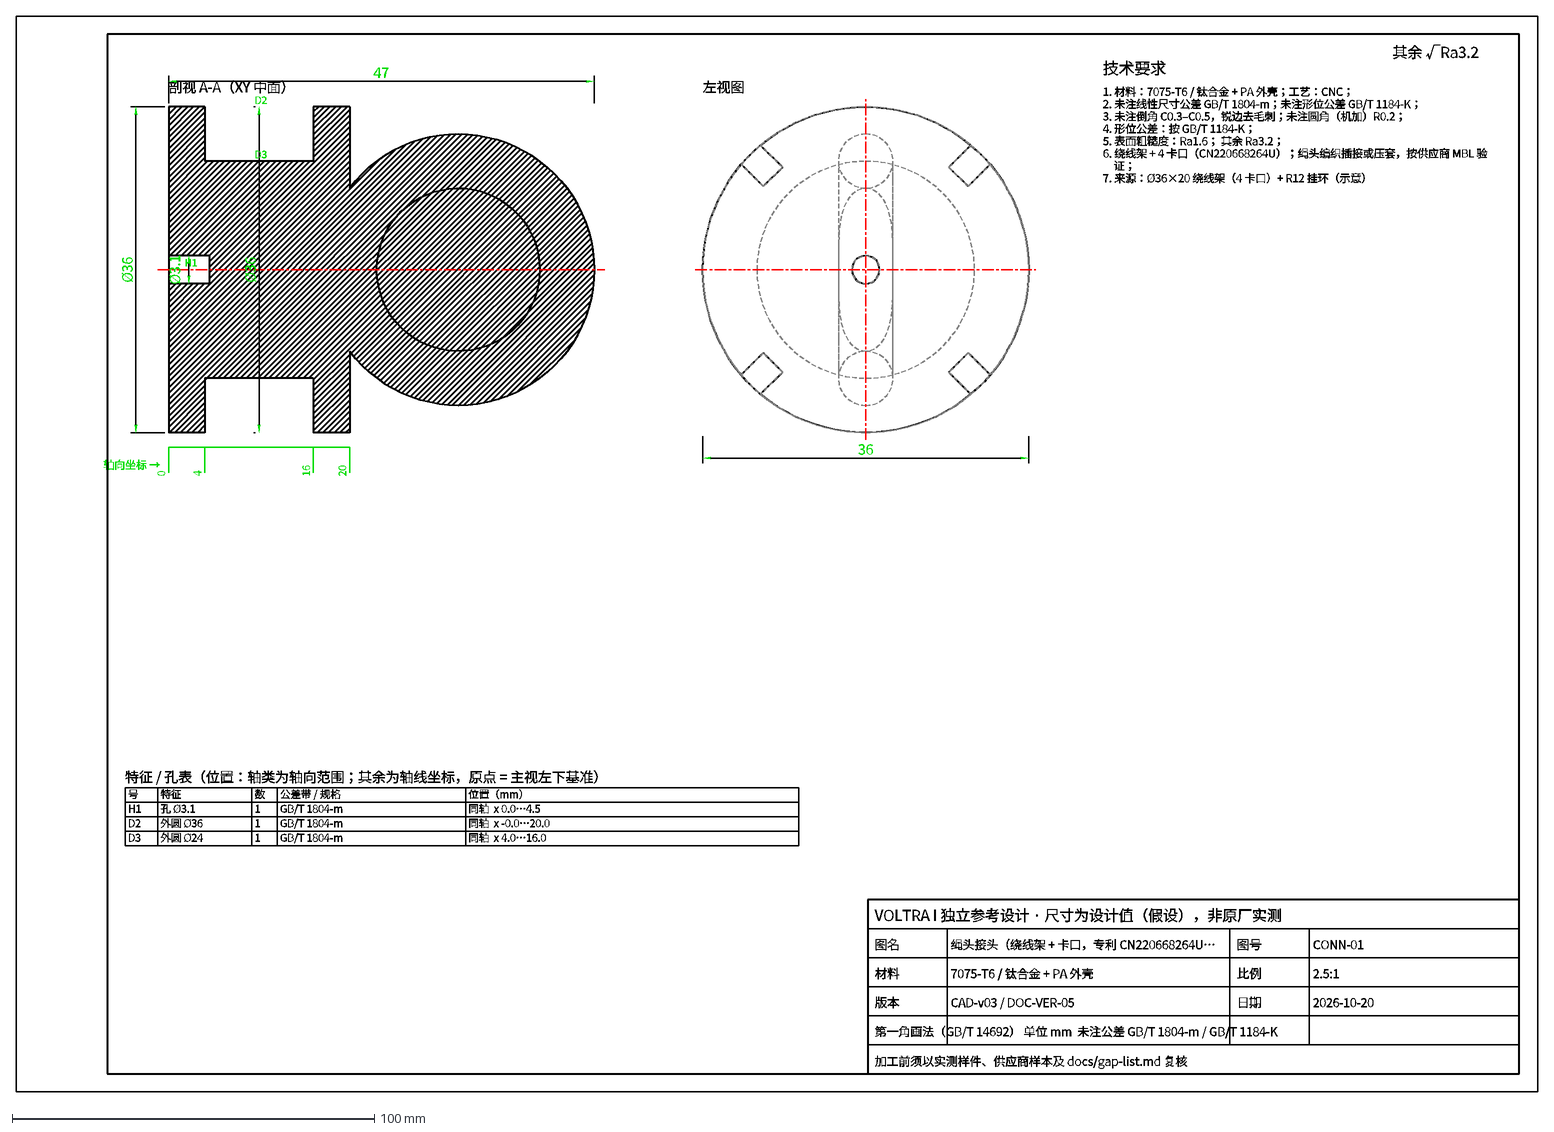
[picture p81: CAD file, 2026-10-20]
downloads/drawings/CONN-01.dxf
剖视 A-A（XY 中面）
左视图
47
Ø36
36
0
4
16
20
轴向坐标 →
H1
Ø3.1
D2
D3
特征 / 孔表（位置：轴类为轴向范围；其余为轴线坐标，原点 = 主视左下基准）
号
特征
数
公差带 / 规格
位置（mm）
孔 Ø3.1
1
GB/T 1804-m
同轴 x 0.0…4.5
外圆 Ø36
同轴 x -0.0…20.0
外圆 Ø24
同轴 x 4.0…16.0
技术要求
1. 材料：7075-T6 / 钛合金 + PA 外壳；工艺：CNC；
2. 未注线性尺寸公差 GB/T 1804-m；未注形位公差 GB/T 1184-K；
3. 未注倒角 C0.3–C0.5，锐边去毛刺；未注圆角（机加）R0.2；
4. 形位公差：按 GB/T 1184-K；
5. 表面粗糙度：Ra1.6； 其余 Ra3.2；
6. 绕线架 + 4 卡口（CN220668264U）；绳头编织插接或压套，按供应商 MBL 验
证；
7. 来源：Ø36×20 绕线架（4 卡口）+ R12 挂环（示意）
其余 √Ra3.2
VOLTRA I 独立参考设计 · 尺寸为设计值（假设），非原厂实测
图名
绳头接头（绕线架 + 卡口，专利 CN220668264U…
图号
CONN-01
材料
7075-T6 / 钛合金 + PA 外壳
比例
2.5:1
版本
CAD-v03 / DOC-VER-05
日期
2026-10-20
第一角画法（GB/T 14692） 单位 mm 未注公差 GB/T 1804-m / GB/T 1184-K
加工前须以实测样件、供应商样本及 docs/gap-list.md 复核
