merlinwwu/voltra-i-ref-3d/downloads/step/SCR-EXIT-01.step

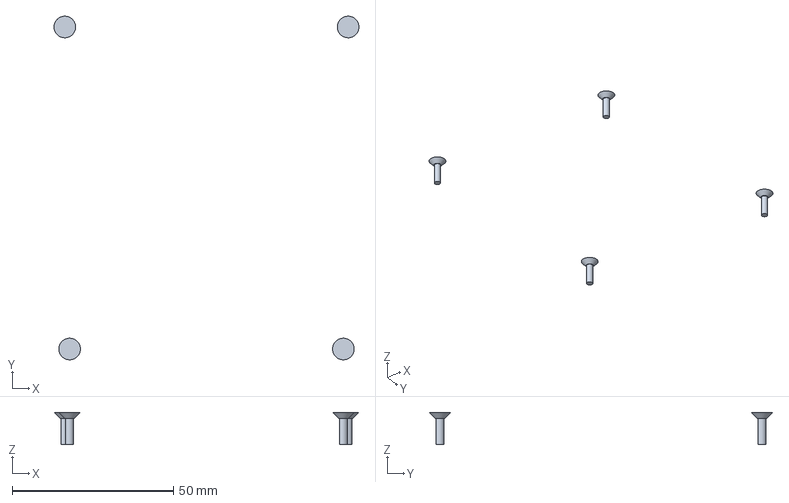
[picture p82: CAD file, 2026-10-20]
downloads/step/SCR-EXIT-01.step
94.7 x 106.7 x 10.0 mm
