merlinwwu/voltra-i-ref-3d/downloads/drawings/MOT-HSG-01.dxf

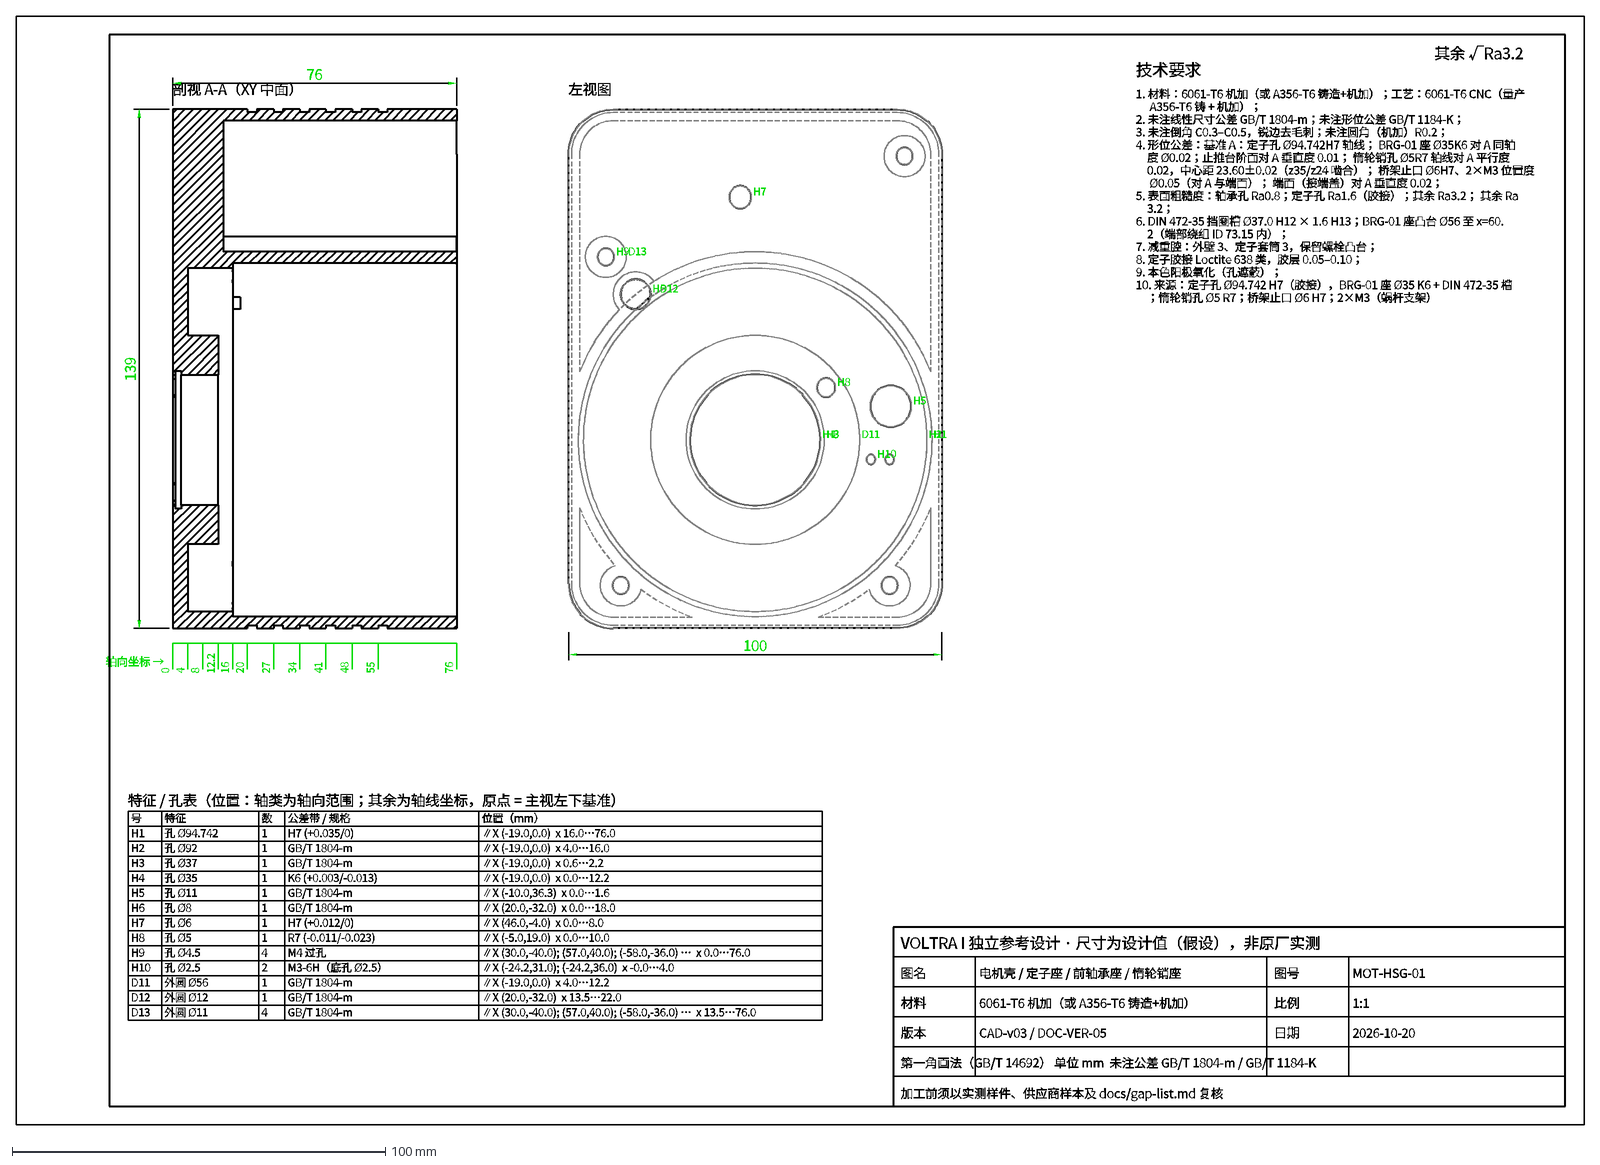
[picture p83: CAD file, 2026-10-20]
downloads/drawings/MOT-HSG-01.dxf
剖视 A-A（XY 中面）
左视图
76
139
100
0
4
8
12.2
16
20
27
34
41
48
55
轴向坐标 →
H1
H2
H3
H4
H5
H6
H7
H8
H9
H10
D11
D12
D13
特征 / 孔表（位置：轴类为轴向范围；其余为轴线坐标，原点 = 主视左下基准）
号
特征
数
公差带 / 规格
位置（mm）
孔 Ø94.742
1
H7 (+0.035/0)
∥X (-19.0,0.0) x 16.0…76.0
孔 Ø92
GB/T 1804-m
∥X (-19.0,0.0) x 4.0…16.0
孔 Ø37
∥X (-19.0,0.0) x 0.6…2.2
孔 Ø35
K6 (+0.003/-0.013)
∥X (-19.0,0.0) x 0.0…12.2
孔 Ø11
∥X (-10.0,36.3) x 0.0…1.6
孔 Ø8
∥X (20.0,-32.0) x 0.0…18.0
孔 Ø6
H7 (+0.012/0)
∥X (46.0,-4.0) x 0.0…8.0
孔 Ø5
R7 (-0.011/-0.023)
∥X (-5.0,19.0) x 0.0…10.0
孔 Ø4.5
M4 过孔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
