merlinwwu/voltra-i-ref-3d/downloads/step/MOT-SHAFT-01.step

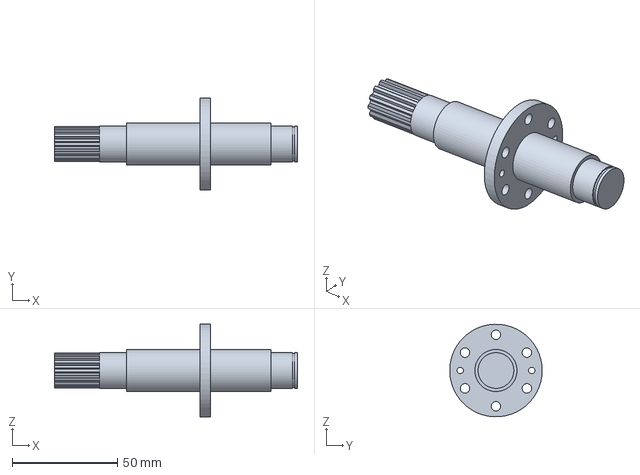
[picture p84: CAD file, 2026-10-20]
downloads/step/MOT-SHAFT-01.step
115.5 x 44.0 x 44.0 mm
