merlinwwu/voltra-i-ref-3d/downloads/drawings/LW-SPC-01.dxf

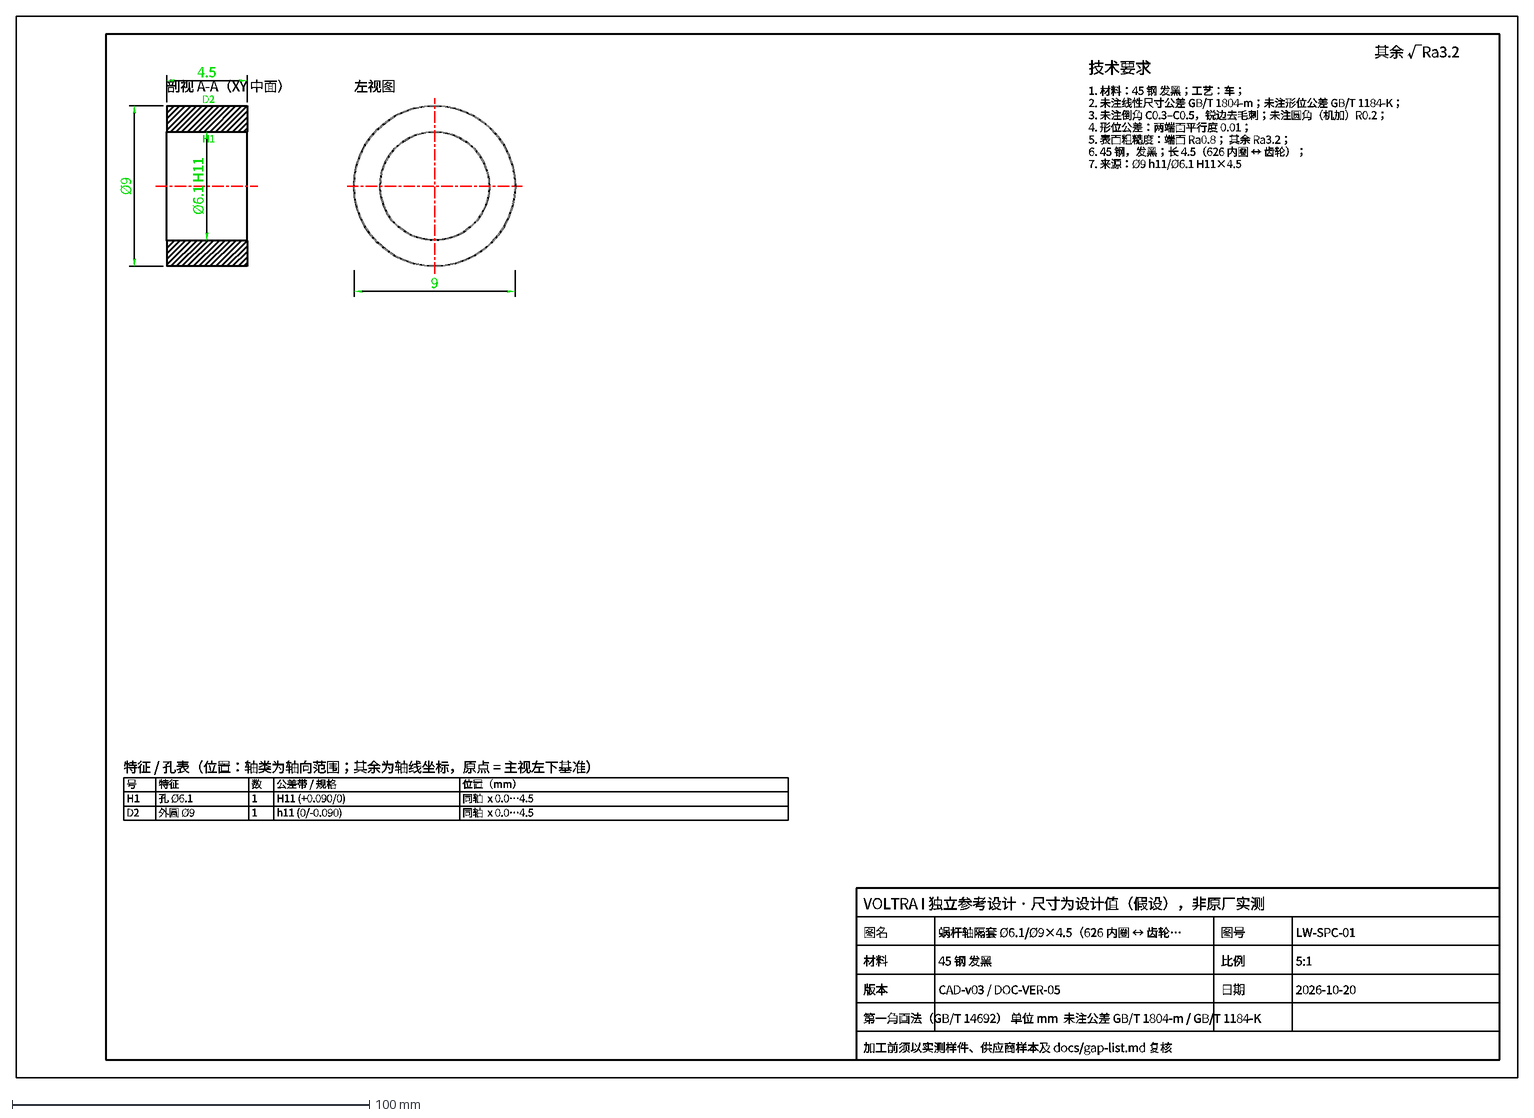
[picture p85: CAD file, 2026-10-20]
downloads/drawings/LW-SPC-01.dxf
剖视 A-A（XY 中面）
左视图
4.5
Ø9
9
H1
Ø6.1 H11
D2
特征 / 孔表（位置：轴类为轴向范围；其余为轴线坐标，原点 = 主视左下基准）
号
特征
数
公差带 / 规格
位置（mm）
孔 Ø6.1
1
H11 (+0.090/0)
同轴 x 0.0…4.5
外圆 Ø9
h11 (0/-0.090)
技术要求
1. 材料：45 钢 发黑；工艺：车；
2. 未注线性尺寸公差 GB/T 1804-m；未注形位公差 GB/T 1184-K；
3. 未注倒角 C0.3–C0.5，锐边去毛刺；未注圆角（机加）R0.2；
4. 形位公差：两端面平行度 0.01；
5. 表面粗糙度：端面 Ra0.8； 其余 Ra3.2；
6. 45 钢，发黑；长 4.5（626 内圈 ↔ 齿轮）；
7. 来源：Ø9 h11/Ø6.1 H11×4.5
其余 √Ra3.2
VOLTRA I 独立参考设计 · 尺寸为设计值（假设），非原厂实测
图名
蜗杆轴隔套 Ø6.1/Ø9×4.5（626 内圈 ↔ 齿轮…
图号
LW-SPC-01
材料
45 钢 发黑
比例
5:1
版本
CAD-v03 / DOC-VER-05
日期
2026-10-20
第一角画法（GB/T 14692） 单位 mm 未注公差 GB/T 1804-m / GB/T 1184-K
加工前须以实测样件、供应商样本及 docs/gap-list.md 复核
