merlinwwu/voltra-i-ref-3d/downloads/step/LBL-SAFETY-01.step

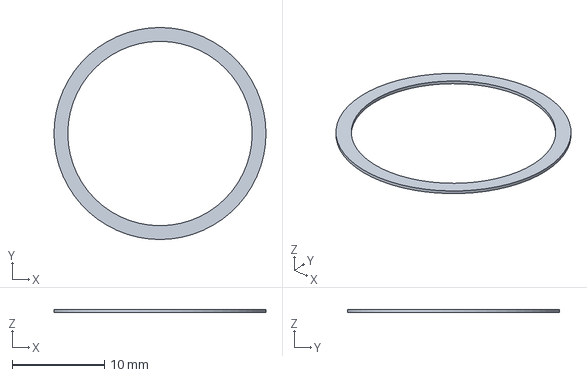
[picture p86: CAD file, 2026-10-20]
downloads/step/LBL-SAFETY-01.step
23.0 x 23.0 x 0.3 mm
