merlinwwu/voltra-i-ref-3d/downloads/drawings/LW-WORM-01.dxf

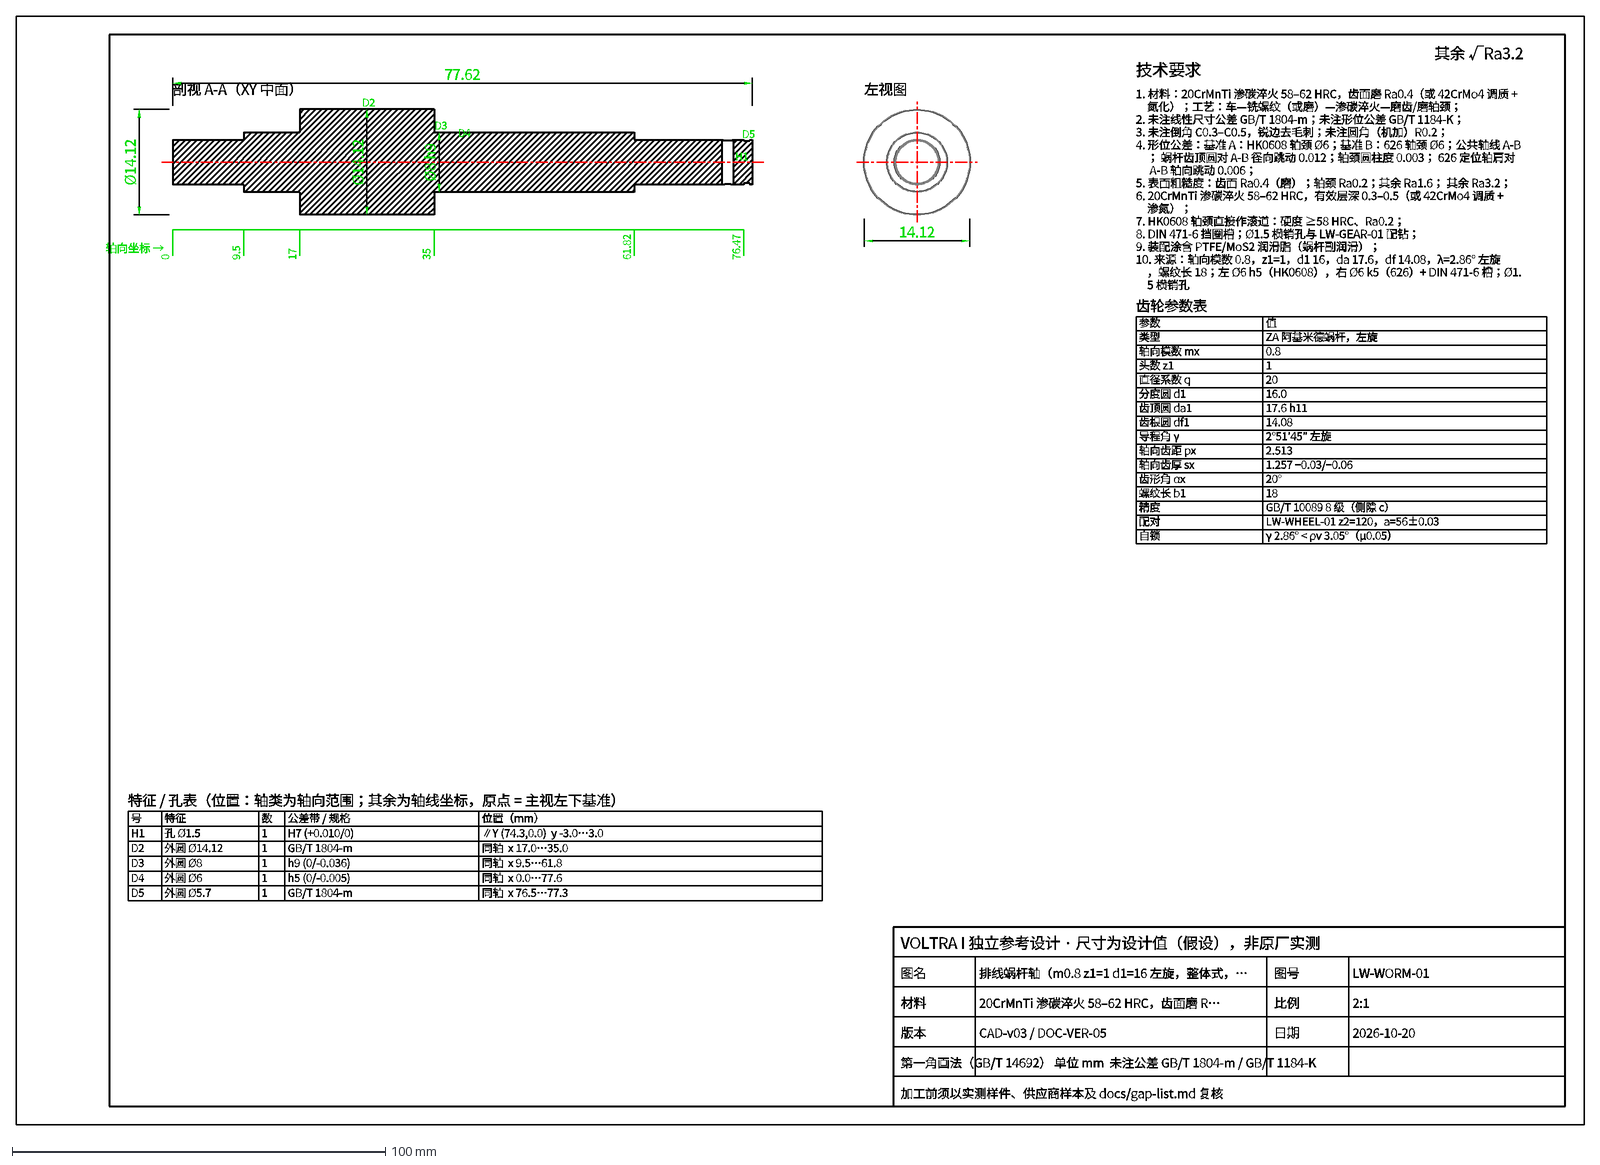
[picture p87: CAD file, 2026-10-20]
downloads/drawings/LW-WORM-01.dxf
剖视 A-A（XY 中面）
左视图
77.62
Ø14.12
14.12
0
9.5
17
35
61.82
76.47
轴向坐标 →
H1
D2
D3
Ø8 h9
D4
D5
特征 / 孔表（位置：轴类为轴向范围；其余为轴线坐标，原点 = 主视左下基准）
号
特征
数
公差带 / 规格
位置（mm）
孔 Ø1.5
1
H7 (+0.010/0)
∥Y (74.3,0.0) y -3.0…3.0
外圆 Ø14.12
GB/T 1804-m
同轴 x 17.0…35.0
外圆 Ø8
h9 (0/-0.036)
同轴 x 9.5…61.8
外圆 Ø6
h5 (0/-0.005)
同轴 x 0.0…77.6
外圆 Ø5.7
同轴 x 76.5…77.3
技术要求
1. 材料：20CrMnTi 渗碳淬火 58–62 HRC，齿面磨 Ra0.4（或 42CrMo4 调质 +
氮化）；工艺：车—铣螺纹（或磨）—渗碳淬火—磨齿/磨轴颈；
2. 未注线性尺寸公差 GB/T 1804-m；未注形位公差 GB/T 1184-K；
3. 未注倒角 C0.3–C0.5，锐边去毛刺；未注圆角（机加）R0.2；
4. 形位公差：基准 A：HK0608 轴颈 Ø6；基准 B：626 轴颈 Ø6；公共轴线 A-B
； 蜗杆齿顶圆对 A-B 径向跳动 0.012；轴颈圆柱度 0.003； 626 定位轴肩对
A-B 轴向跳动 0.006；
5. 表面粗糙度：齿面 Ra0.4（磨）；轴颈 Ra0.2；其余 Ra1.6； 其余 Ra3.2；
6. 20CrMnTi 渗碳淬火 58–62 HRC，有效层深 0.3–0.5（或 42CrMo4 调质 +
渗氮）；
7. HK0608 轴颈直接作滚道：硬度 ≥58 HRC、Ra0.2；
8. DIN 471-6 挡圈槽；Ø1.5 横销孔与 LW-GEAR-01 配钻；
9. 装配涂含 PTFE/MoS2 润滑脂（蜗杆副润滑）；
10. 来源：轴向模数 0.8，z1=1，d1 16，da 17.6，df 14.08，λ=2.86° 左旋
，螺纹长 18；左 Ø6 h5（HK0608），右 Ø6 k5（626）+ DIN 471-6 槽；Ø1.
5 横销孔
齿轮参数表
参数
值
类型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
