merlinwwu/voltra-i-ref-3d/downloads/step/SCR-BRG03-01.step

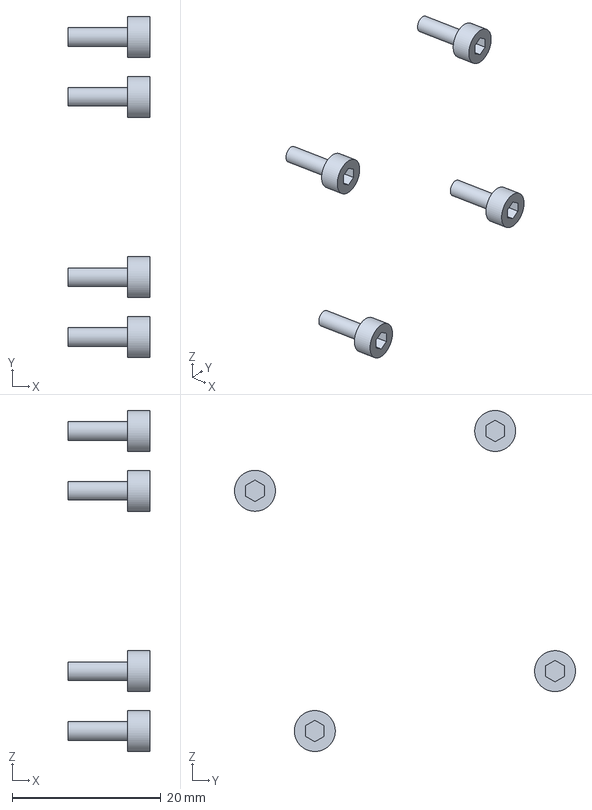
[picture p88: CAD file, 2026-10-20]
downloads/step/SCR-BRG03-01.step
11.0 x 45.8 x 45.8 mm
