merlinwwu/voltra-i-ref-3d/downloads/drawings/LW-ARM-01.dxf

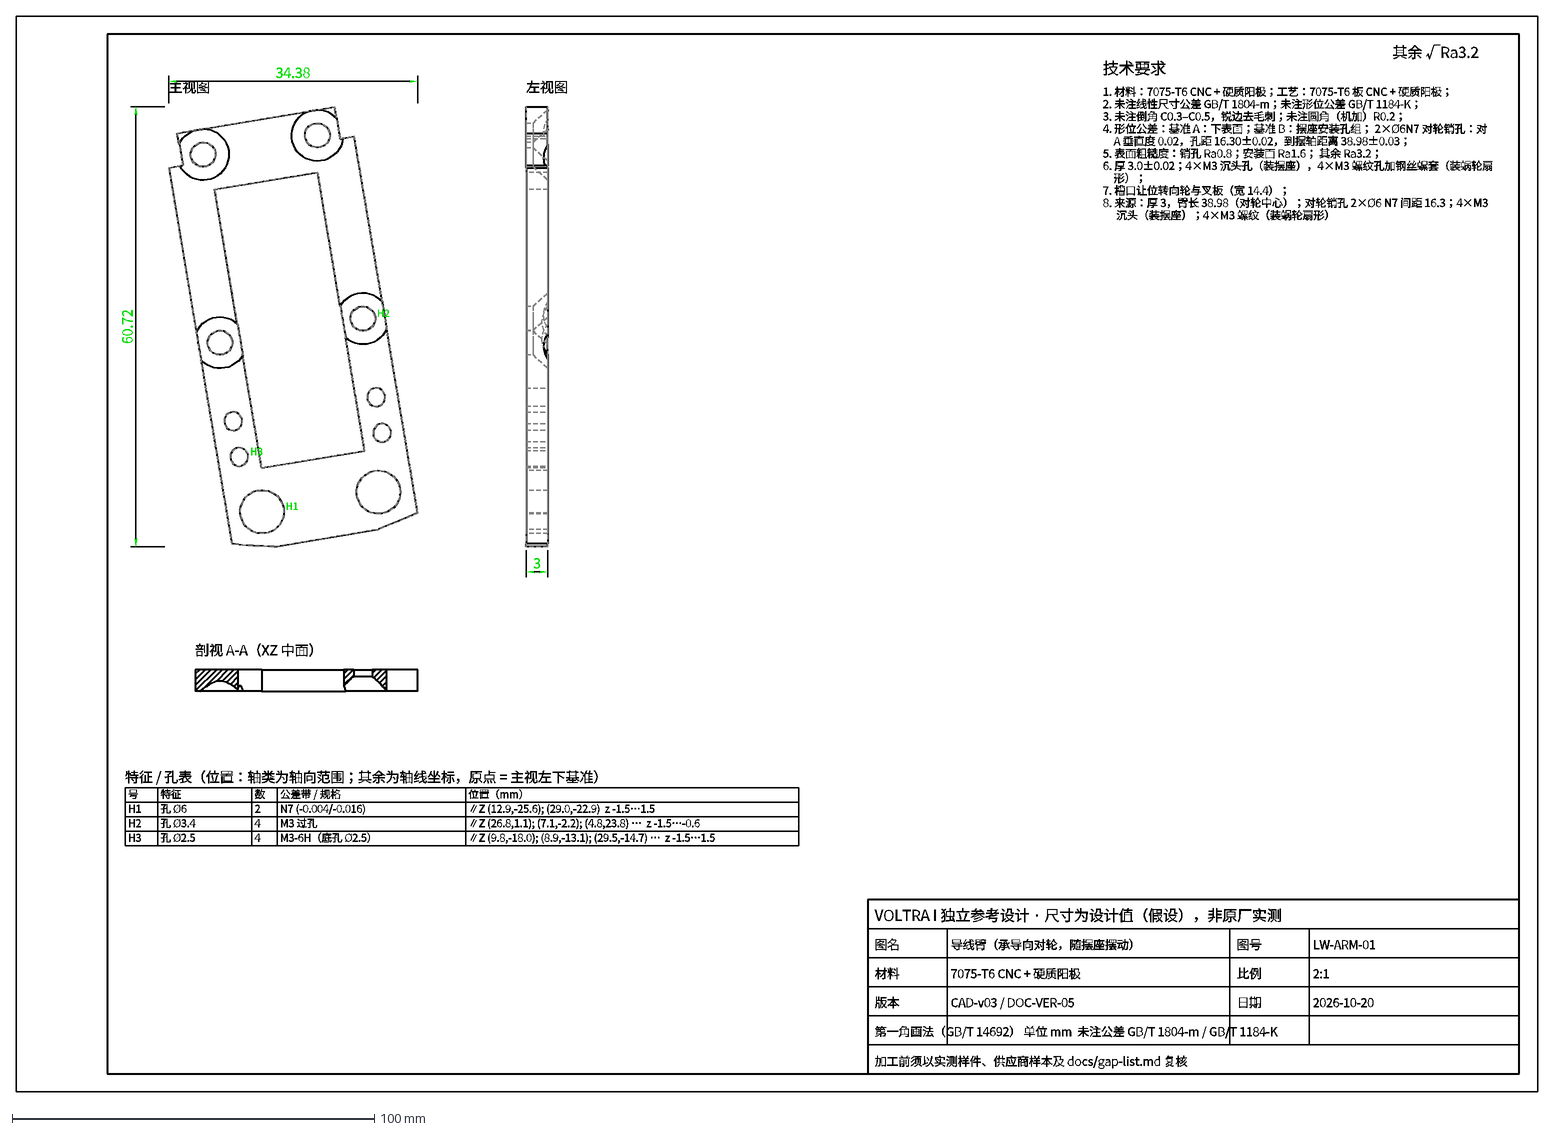
[picture p89: CAD file, 2026-10-20]
downloads/drawings/LW-ARM-01.dxf
主视图
左视图
剖视 A-A（XZ 中面）
34.38
60.72
3
H1
H2
H3
特征 / 孔表（位置：轴类为轴向范围；其余为轴线坐标，原点 = 主视左下基准）
号
特征
数
公差带 / 规格
位置（mm）
孔 Ø6
2
N7 (-0.004/-0.016)
∥Z (12.9,-25.6); (29.0,-22.9) z -1.5…1.5
孔 Ø3.4
4
M3 过孔
∥Z (26.8,1.1); (7.1,-2.2); (4.8,23.8) … z -1.5…-0.6
孔 Ø2.5
M3-6H（底孔 Ø2.5）
∥Z (9.8,-18.0); (8.9,-13.1); (29.5,-14.7) … z -1.5…1.5
技术要求
1. 材料：7075-T6 CNC + 硬质阳极；工艺：7075-T6 板 CNC + 硬质阳极；
2. 未注线性尺寸公差 GB/T 1804-m；未注形位公差 GB/T 1184-K；
3. 未注倒角 C0.3–C0.5，锐边去毛刺；未注圆角（机加）R0.2；
4. 形位公差：基准 A：下表面；基准 B：摆座安装孔组； 2×Ø6N7 对轮销孔：对
A 垂直度 0.02，孔距 16.30±0.02，到摆轴距离 38.98±0.03；
5. 表面粗糙度：销孔 Ra0.8；安装面 Ra1.6； 其余 Ra3.2；
6. 厚 3.0±0.02；4×M3 沉头孔（装摆座），4×M3 螺纹孔加钢丝螺套（装蜗轮扇
形）；
7. 槽口让位转向轮与叉板（宽 14.4）；
8. 来源：厚 3，臂长 38.98（对轮中心）；对轮销孔 2×Ø6 N7 间距 16.3；4×M3
沉头（装摆座）；4×M3 螺纹（装蜗轮扇形）
其余 √Ra3.2
VOLTRA I 独立参考设计 · 尺寸为设计值（假设），非原厂实测
图名
导线臂（承导向对轮，随摆座摆动）
图号
LW-ARM-01
材料
7075-T6 CNC + 硬质阳极
比例
2:1
版本
CAD-v03 / DOC-VER-05
日期
2026-10-20
第一角画法（GB/T 14692） 单位 mm 未注公差 GB/T 1804-m / GB/T 1184-K
加工前须以实测样件、供应商样本及 docs/gap-list.md 复核
