merlinwwu/voltra-i-ref-3d/downloads/step/SCR-LWB-02.step

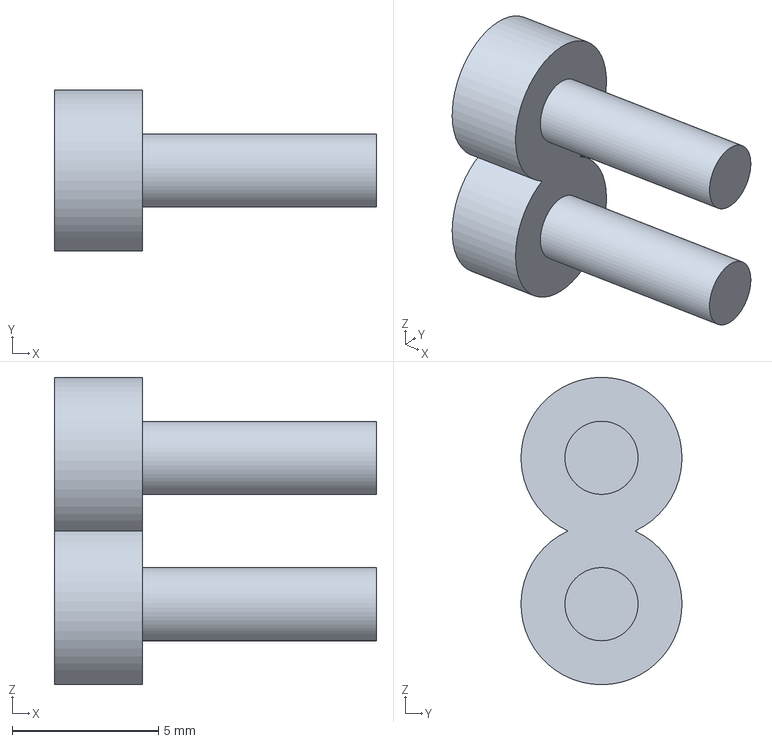
[picture p90: CAD file, 2026-10-20]
downloads/step/SCR-LWB-02.step
11.0 x 5.50 x 10.5 mm
