merlinwwu/voltra-i-ref-3d/downloads/drawings/EXIT-BASE-01.dxf

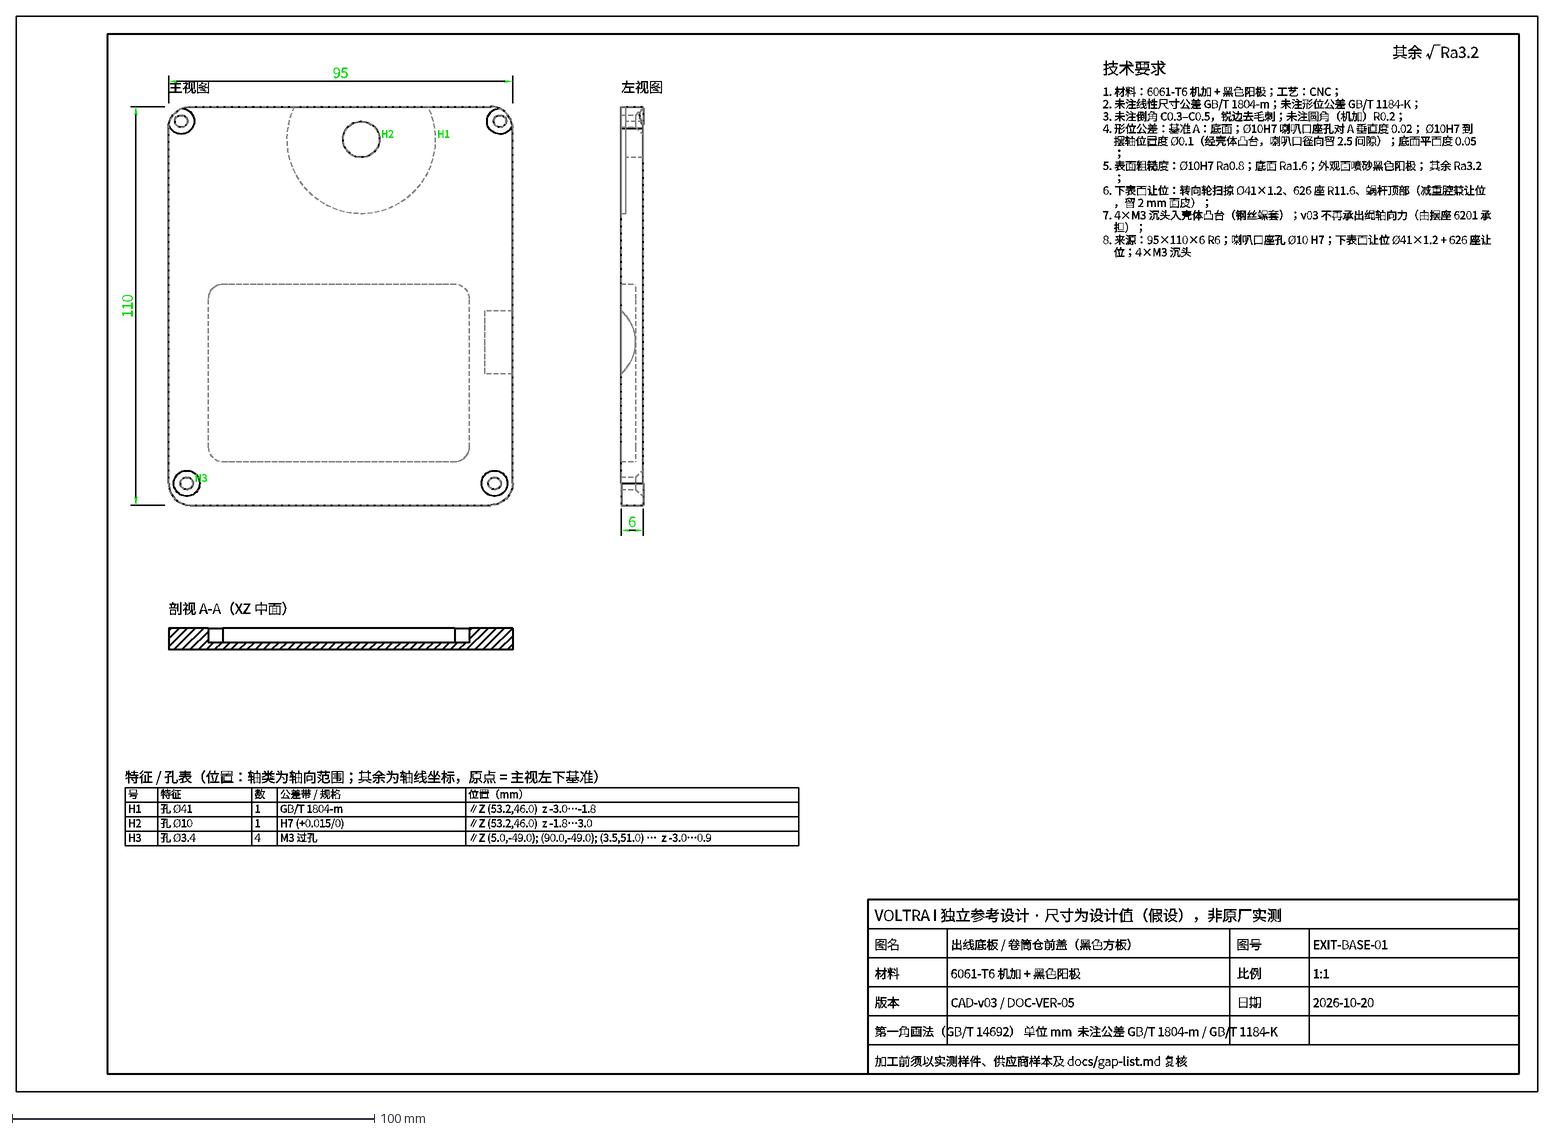
[picture p91: CAD file, 2026-10-20]
downloads/drawings/EXIT-BASE-01.dxf
主视图
左视图
剖视 A-A（XZ 中面）
95
110
6
H1
H2
H3
特征 / 孔表（位置：轴类为轴向范围；其余为轴线坐标，原点 = 主视左下基准）
号
特征
数
公差带 / 规格
位置（mm）
孔 Ø41
1
GB/T 1804-m
∥Z (53.2,46.0) z -3.0…-1.8
孔 Ø10
H7 (+0.015/0)
∥Z (53.2,46.0) z -1.8…3.0
孔 Ø3.4
4
M3 过孔
∥Z (5.0,-49.0); (90.0,-49.0); (3.5,51.0) … z -3.0…0.9
技术要求
1. 材料：6061-T6 机加 + 黑色阳极；工艺：CNC；
2. 未注线性尺寸公差 GB/T 1804-m；未注形位公差 GB/T 1184-K；
3. 未注倒角 C0.3–C0.5，锐边去毛刺；未注圆角（机加）R0.2；
4. 形位公差：基准 A：底面；Ø10H7 喇叭口座孔对 A 垂直度 0.02； Ø10H7 到
摆轴位置度 Ø0.1（经壳体凸台，喇叭口径向留 2.5 间隙）；底面平面度 0.05
；
5. 表面粗糙度：Ø10H7 Ra0.8；底面 Ra1.6；外观面喷砂黑色阳极； 其余 Ra3.2
6. 下表面让位：转向轮扫掠 Ø41×1.2、626 座 R11.6、蜗杆顶部（减重腔兼让位
，留 2 mm 面皮）；
7. 4×M3 沉头入壳体凸台（钢丝螺套）；v03 不再承出绳轴向力（由摆座 6201 承
担）；
8. 来源：95×110×6 R6；喇叭口座孔 Ø10 H7；下表面让位 Ø41×1.2 + 626 座让
位；4×M3 沉头
其余 √Ra3.2
VOLTRA I 独立参考设计 · 尺寸为设计值（假设），非原厂实测
图名
出线底板 / 卷筒仓前盖（黑色方板）
图号
EXIT-BASE-01
材料
6061-T6 机加 + 黑色阳极
比例
1:1
版本
CAD-v03 / DOC-VER-05
日期
2026-10-20
第一角画法（GB/T 14692） 单位 mm 未注公差 GB/T 1804-m / GB/T 1184-K
加工前须以实测样件、供应商样本及 docs/gap-list.md 复核
