merlinwwu/voltra-i-ref-3d/downloads/step/LW-BOX-01.step

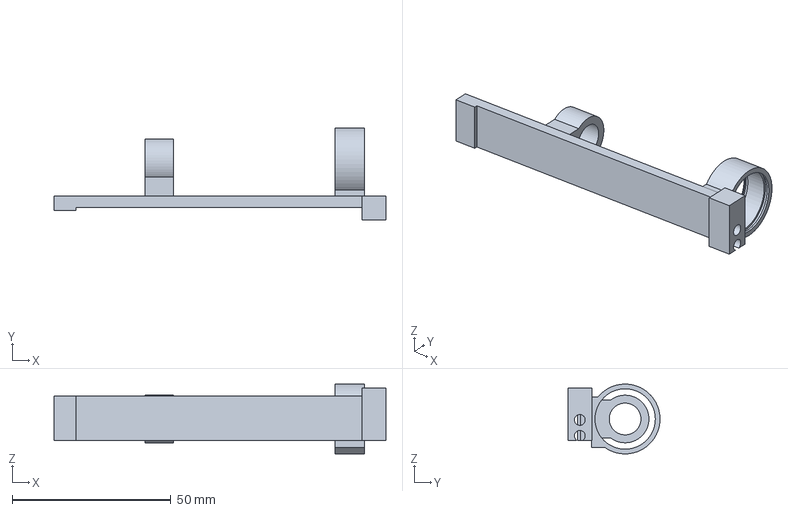
[picture p92: CAD file, 2026-10-20]
downloads/step/LW-BOX-01.step
104.5 x 29.0 x 22.0 mm
