merlinwwu/voltra-i-ref-3d/downloads/drawings/LW-IDL-PIN-01.dxf

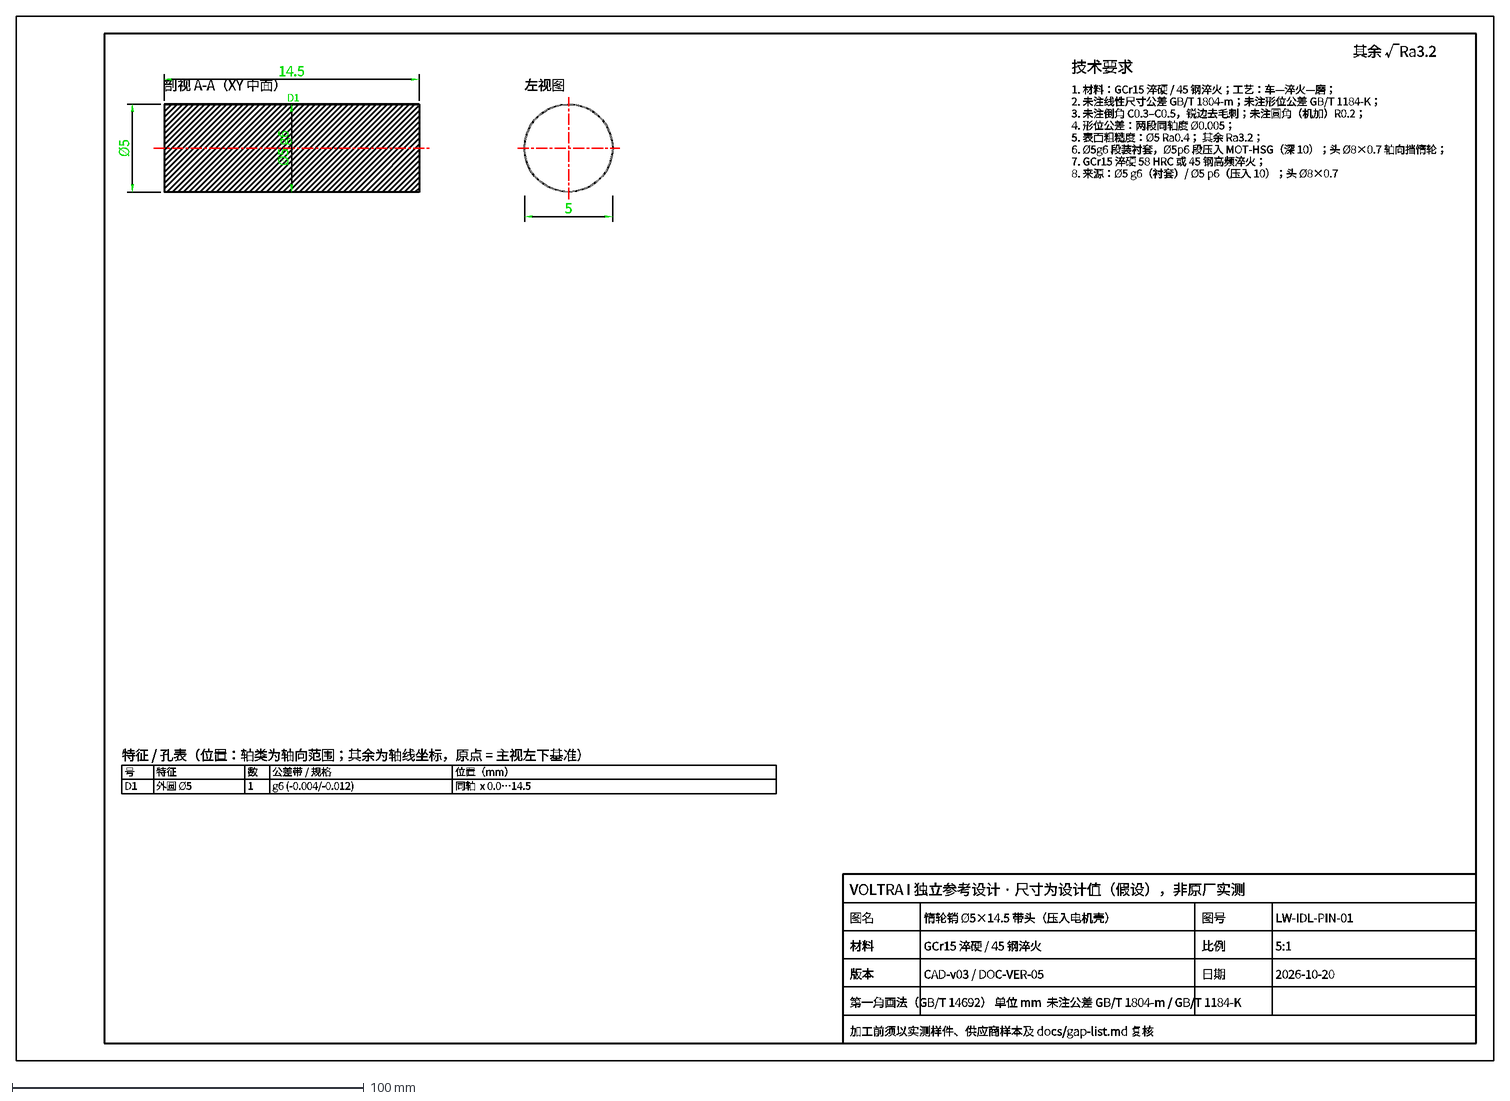
[picture p93: CAD file, 2026-10-20]
downloads/drawings/LW-IDL-PIN-01.dxf
剖视 A-A（XY 中面）
左视图
14.5
Ø5
5
D1
Ø5 g6
特征 / 孔表（位置：轴类为轴向范围；其余为轴线坐标，原点 = 主视左下基准）
号
特征
数
公差带 / 规格
位置（mm）
外圆 Ø5
1
g6 (-0.004/-0.012)
同轴 x 0.0…14.5
技术要求
1. 材料：GCr15 淬硬 / 45 钢淬火；工艺：车—淬火—磨；
2. 未注线性尺寸公差 GB/T 1804-m；未注形位公差 GB/T 1184-K；
3. 未注倒角 C0.3–C0.5，锐边去毛刺；未注圆角（机加）R0.2；
4. 形位公差：两段同轴度 Ø0.005；
5. 表面粗糙度：Ø5 Ra0.4； 其余 Ra3.2；
6. Ø5g6 段装衬套，Ø5p6 段压入 MOT-HSG（深 10）；头 Ø8×0.7 轴向挡惰轮；
7. GCr15 淬硬 58 HRC 或 45 钢高频淬火；
8. 来源：Ø5 g6（衬套）/ Ø5 p6（压入 10）；头 Ø8×0.7
其余 √Ra3.2
VOLTRA I 独立参考设计 · 尺寸为设计值（假设），非原厂实测
图名
惰轮销 Ø5×14.5 带头（压入电机壳）
图号
LW-IDL-PIN-01
材料
GCr15 淬硬 / 45 钢淬火
比例
5:1
版本
CAD-v03 / DOC-VER-05
日期
2026-10-20
第一角画法（GB/T 14692） 单位 mm 未注公差 GB/T 1804-m / GB/T 1184-K
加工前须以实测样件、供应商样本及 docs/gap-list.md 复核
