merlinwwu/voltra-i-ref-3d/downloads/step/PIN-DRUM-01.step

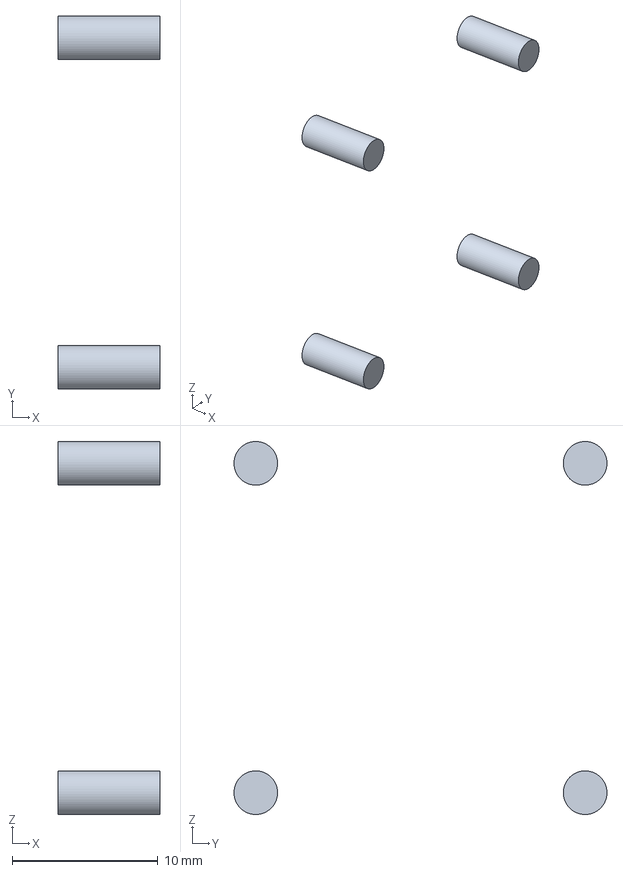
[picture p94: CAD file, 2026-10-20]
downloads/step/PIN-DRUM-01.step
7.00 x 25.6 x 25.6 mm
