merlinwwu/voltra-i-ref-3d/downloads/step/LW-NDL-01.step

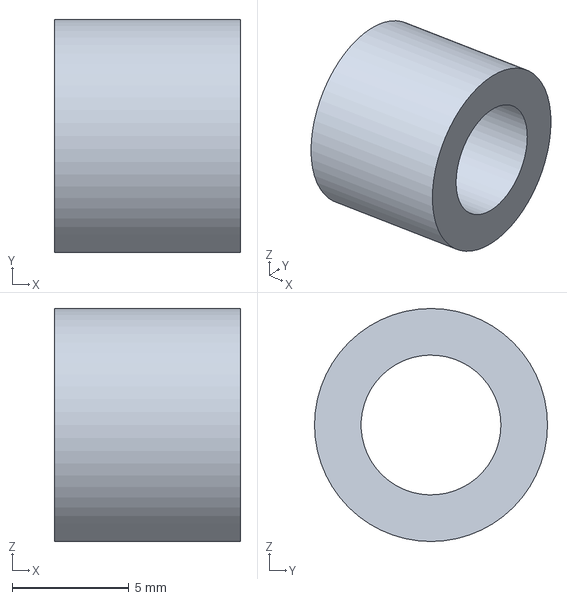
[picture p95: CAD file, 2026-10-20]
downloads/step/LW-NDL-01.step
8.00 x 10.0 x 10.0 mm
