merlinwwu/voltra-i-ref-3d/downloads/step/EXIT-AXL-01.step

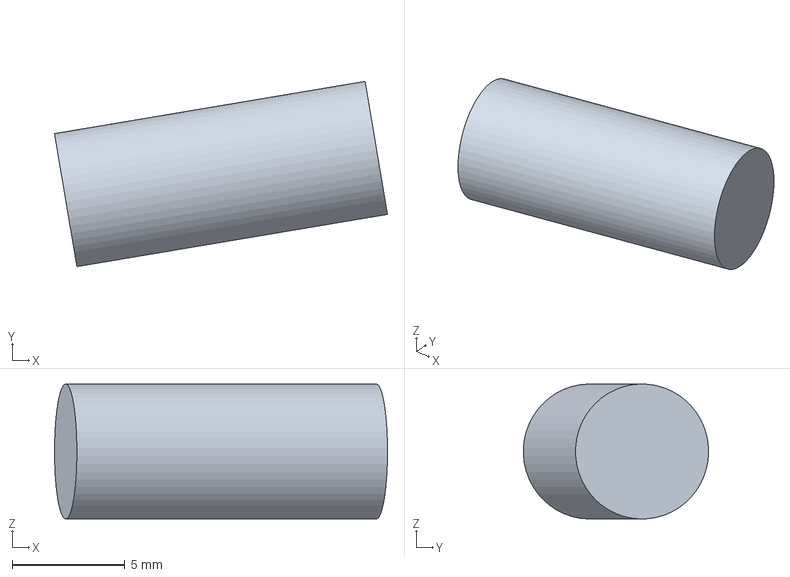
[picture p97: CAD file, 2026-10-20]
downloads/step/EXIT-AXL-01.step
14.8 x 8.23 x 6.00 mm
