merlinwwu/voltra-i-ref-3d/downloads/drawings/LW-BRIDGE-01.dxf

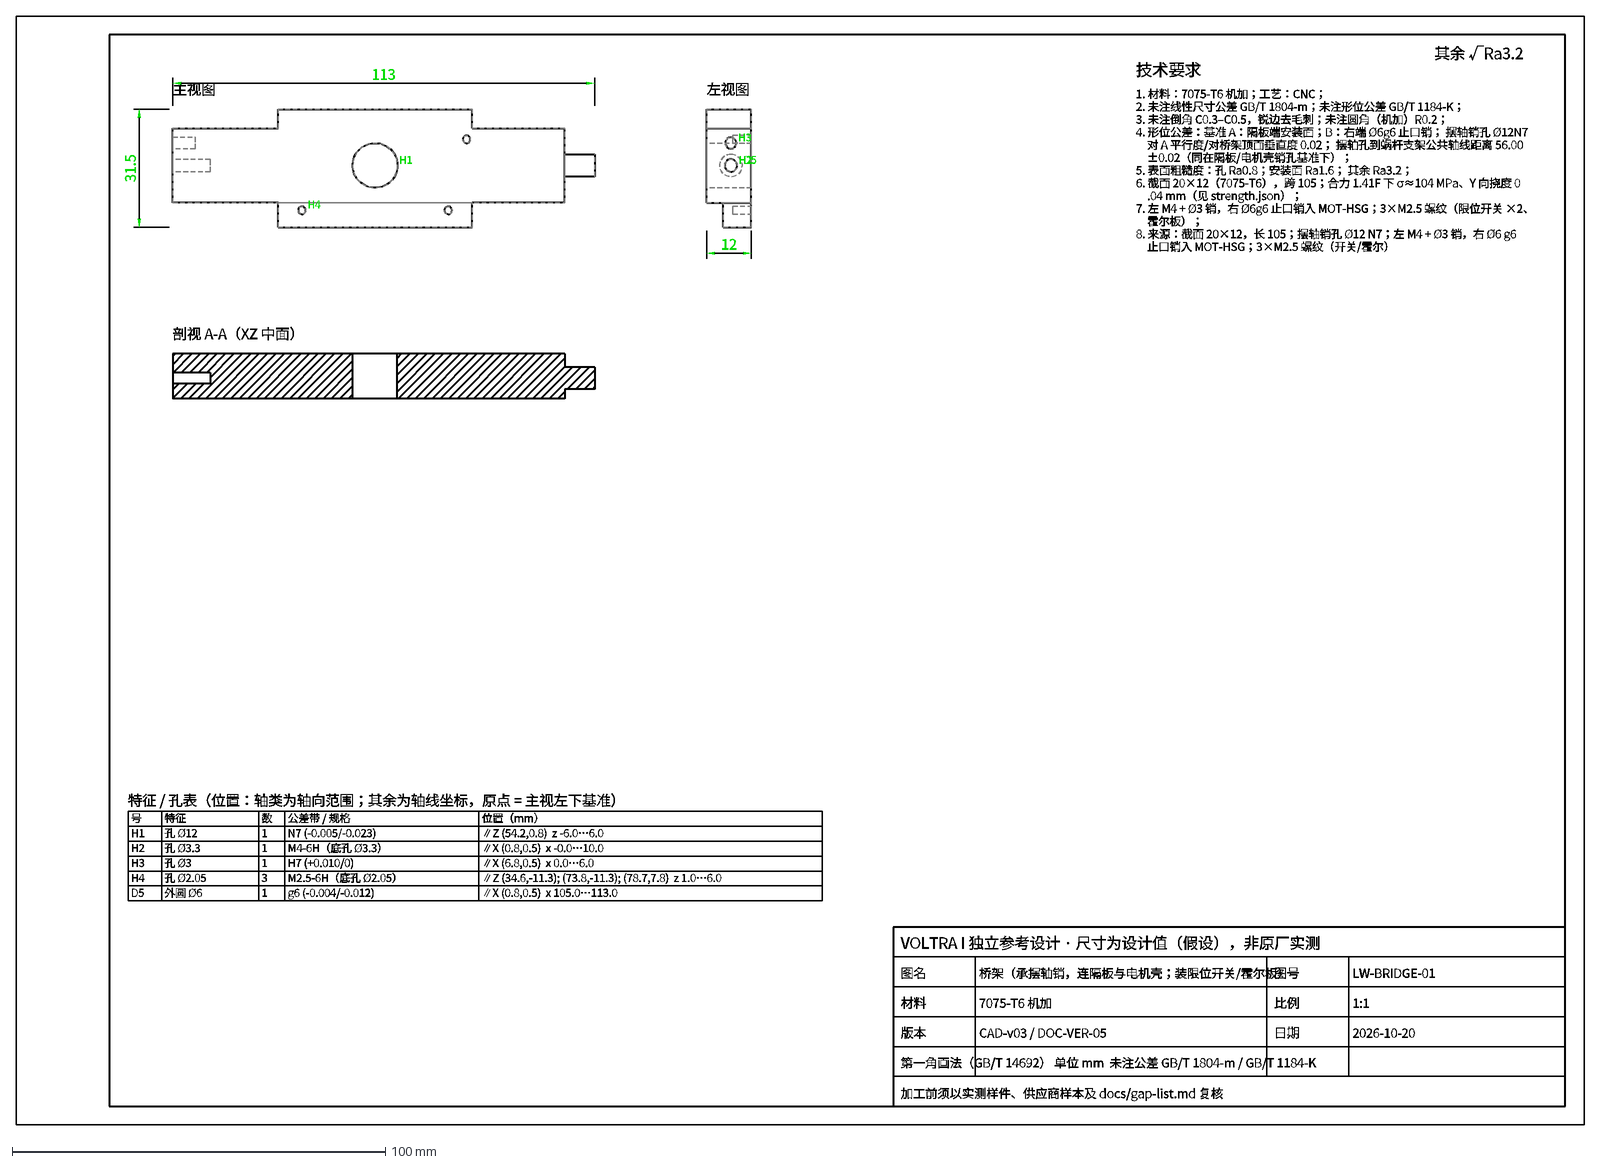
[picture p98: CAD file, 2026-10-20]
downloads/drawings/LW-BRIDGE-01.dxf
主视图
左视图
剖视 A-A（XZ 中面）
113
31.5
12
H1
H2
H3
H4
D5
特征 / 孔表（位置：轴类为轴向范围；其余为轴线坐标，原点 = 主视左下基准）
号
特征
数
公差带 / 规格
位置（mm）
孔 Ø12
1
N7 (-0.005/-0.023)
∥Z (54.2,0.8) z -6.0…6.0
孔 Ø3.3
M4-6H（底孔 Ø3.3）
∥X (0.8,0.5) x -0.0…10.0
孔 Ø3
H7 (+0.010/0)
∥X (6.8,0.5) x 0.0…6.0
孔 Ø2.05
3
M2.5-6H（底孔 Ø2.05）
∥Z (34.6,-11.3); (73.8,-11.3); (78.7,7.8) z 1.0…6.0
外圆 Ø6
g6 (-0.004/-0.012)
∥X (0.8,0.5) x 105.0…113.0
技术要求
1. 材料：7075-T6 机加；工艺：CNC；
2. 未注线性尺寸公差 GB/T 1804-m；未注形位公差 GB/T 1184-K；
3. 未注倒角 C0.3–C0.5，锐边去毛刺；未注圆角（机加）R0.2；
4. 形位公差：基准 A：隔板端安装面；B：右端 Ø6g6 止口销； 摆轴销孔 Ø12N7
对 A 平行度/对桥架顶面垂直度 0.02； 摆轴孔到蜗杆支架公共轴线距离 56.00
±0.02（同在隔板/电机壳销孔基准下）；
5. 表面粗糙度：孔 Ra0.8；安装面 Ra1.6； 其余 Ra3.2；
6. 截面 20×12（7075-T6），跨 105；合力 1.41F 下 σ≈104 MPa、Y 向挠度 0
.04 mm（见 strength.json）；
7. 左 M4 + Ø3 销，右 Ø6g6 止口销入 MOT-HSG；3×M2.5 螺纹（限位开关 ×2、
霍尔板）；
8. 来源：截面 20×12，长 105；摆轴销孔 Ø12 N7；左 M4 + Ø3 销，右 Ø6 g6
止口销入 MOT-HSG；3×M2.5 螺纹（开关/霍尔）
其余 √Ra3.2
VOLTRA I 独立参考设计 · 尺寸为设计值（假设），非原厂实测
图名
桥架（承摆轴销，连隔板与电机壳；装限位开关/霍尔板）
图号
LW-BRIDGE-01
材料
7075-T6 机加
比例
1:1
版本
CAD-v03 / DOC-VER-05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
