merlinwwu/voltra-i-ref-3d/downloads/step/LW-ROL-01.step

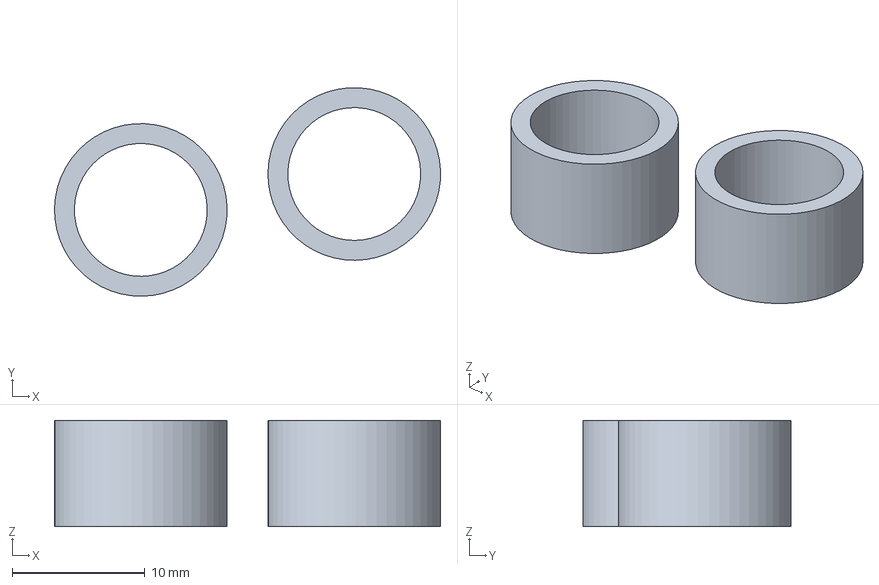
[picture p99: CAD file, 2026-10-20]
downloads/step/LW-ROL-01.step
29.1 x 15.7 x 8.00 mm
