merlinwwu/voltra-i-ref-3d/downloads/step/EXIT-BASE-01.step

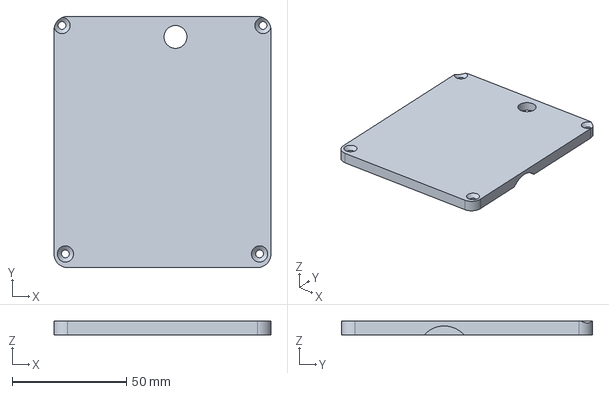
[picture p100: CAD file, 2026-10-20]
downloads/step/EXIT-BASE-01.step
95.0 x 110.0 x 6.00 mm
