merlinwwu/voltra-i-ref-3d/downloads/drawings/LW-ROL-01.dxf

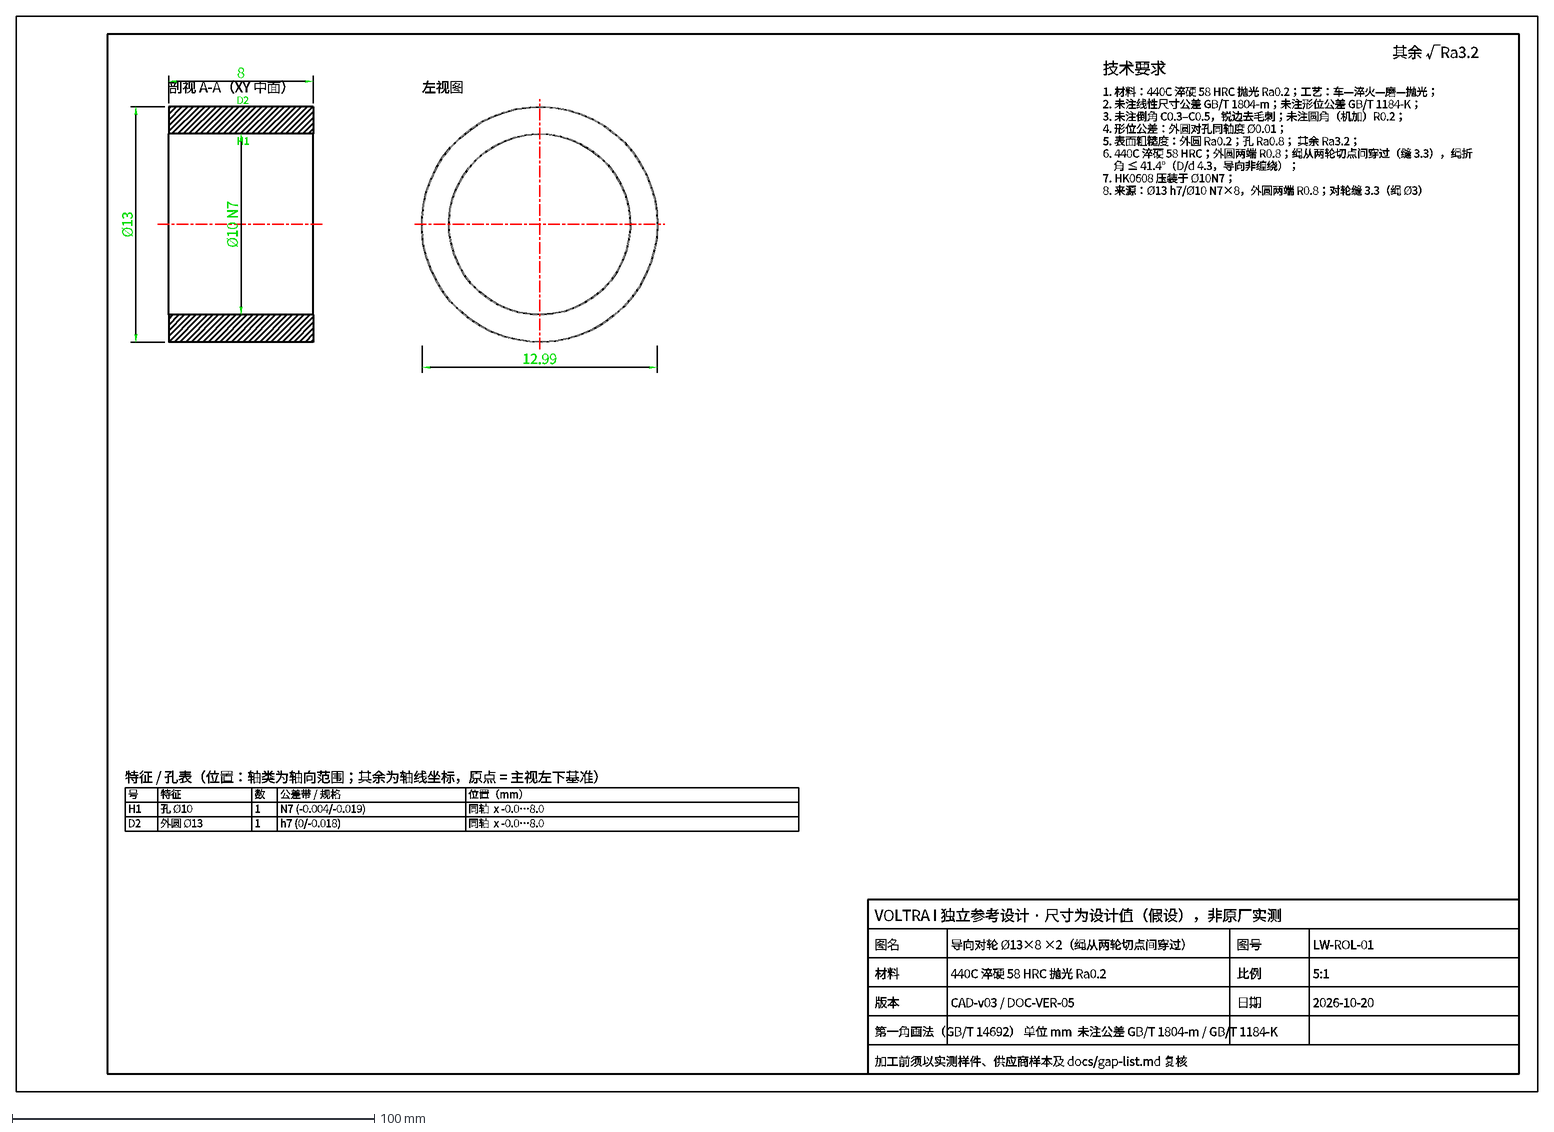
[picture p101: CAD file, 2026-10-20]
downloads/drawings/LW-ROL-01.dxf
剖视 A-A（XY 中面）
左视图
8
Ø13
12.99
H1
Ø10 N7
D2
特征 / 孔表（位置：轴类为轴向范围；其余为轴线坐标，原点 = 主视左下基准）
号
特征
数
公差带 / 规格
位置（mm）
孔 Ø10
1
N7 (-0.004/-0.019)
同轴 x -0.0…8.0
外圆 Ø13
h7 (0/-0.018)
技术要求
1. 材料：440C 淬硬 58 HRC 抛光 Ra0.2；工艺：车—淬火—磨—抛光；
2. 未注线性尺寸公差 GB/T 1804-m；未注形位公差 GB/T 1184-K；
3. 未注倒角 C0.3–C0.5，锐边去毛刺；未注圆角（机加）R0.2；
4. 形位公差：外圆对孔同轴度 Ø0.01；
5. 表面粗糙度：外圆 Ra0.2；孔 Ra0.8； 其余 Ra3.2；
6. 440C 淬硬 58 HRC；外圆两端 R0.8；绳从两轮切点间穿过（缝 3.3），绳折
角 ≤ 41.4°（D/d 4.3，导向非缠绕）；
7. HK0608 压装于 Ø10N7；
8. 来源：Ø13 h7/Ø10 N7×8，外圆两端 R0.8；对轮缝 3.3（绳 Ø3）
其余 √Ra3.2
VOLTRA I 独立参考设计 · 尺寸为设计值（假设），非原厂实测
图名
导向对轮 Ø13×8 ×2（绳从两轮切点间穿过）
图号
LW-ROL-01
材料
440C 淬硬 58 HRC 抛光 Ra0.2
比例
5:1
版本
CAD-v03 / DOC-VER-05
日期
2026-10-20
第一角画法（GB/T 14692） 单位 mm 未注公差 GB/T 1804-m / GB/T 1184-K
加工前须以实测样件、供应商样本及 docs/gap-list.md 复核
