merlinwwu/voltra-i-ref-3d/downloads/step/SCR-LWW-01.step

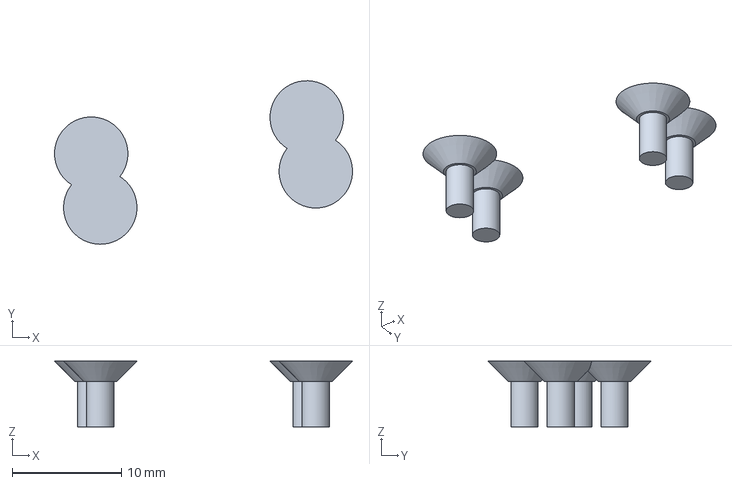
[picture p102: CAD file, 2026-10-20]
downloads/step/SCR-LWW-01.step
27.3 x 15.0 x 6.00 mm
