merlinwwu/voltra-i-ref-3d/downloads/drawings/DOCK-HOOK-01.dxf

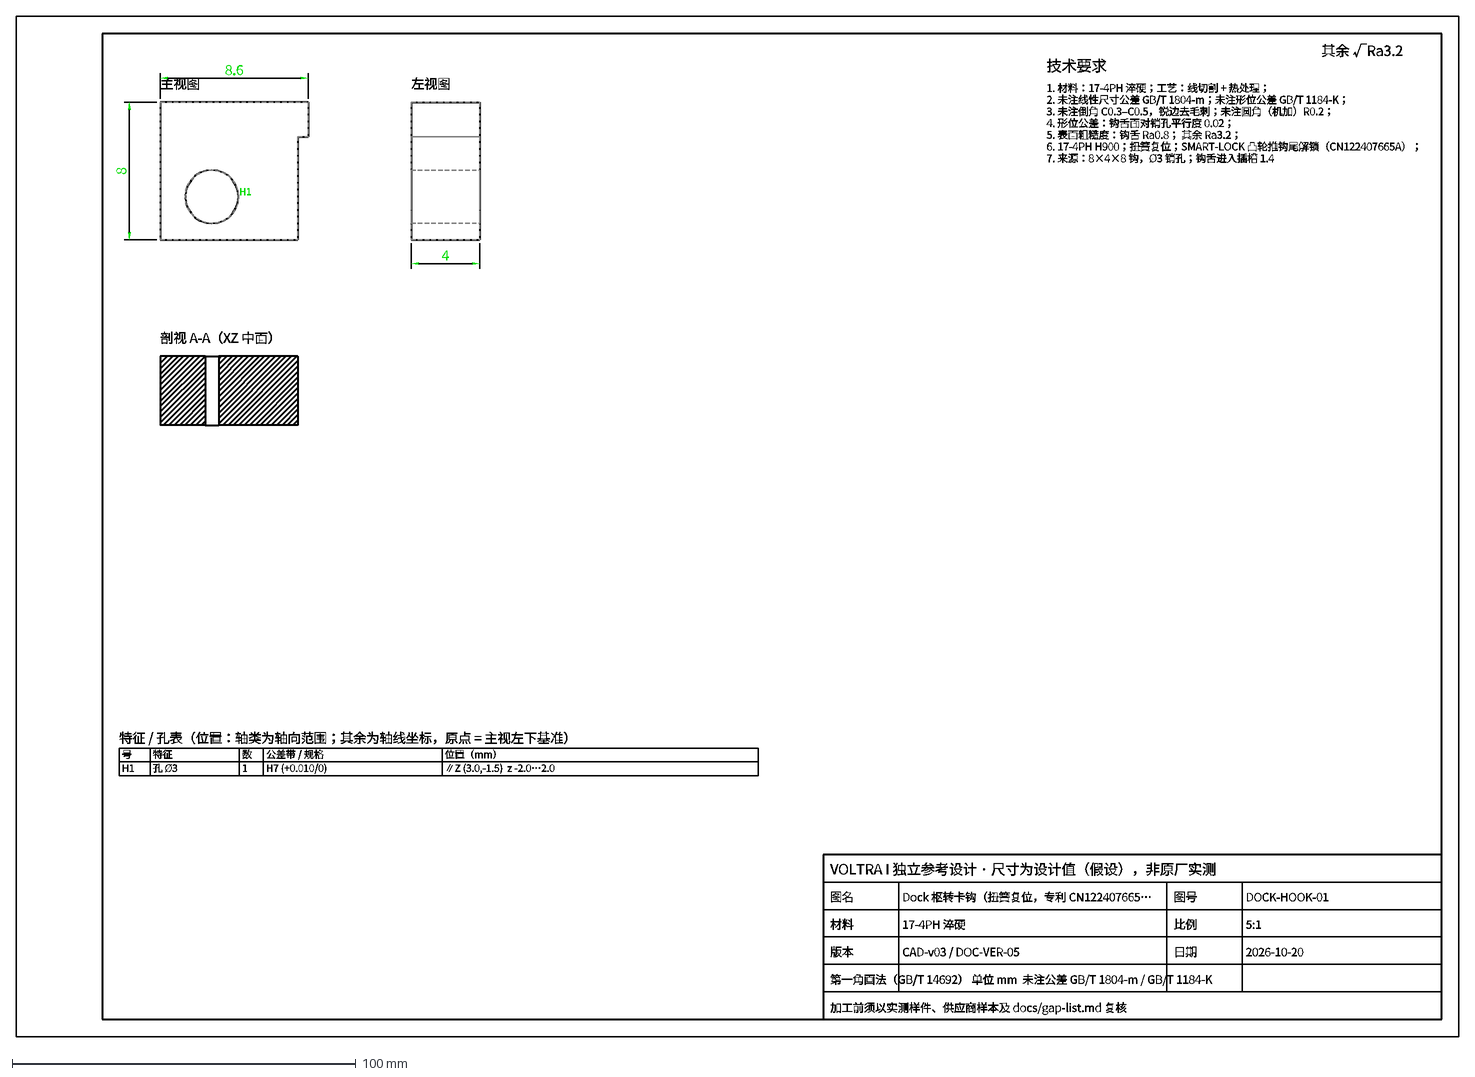
[picture p103: CAD file, 2026-10-20]
downloads/drawings/DOCK-HOOK-01.dxf
主视图
左视图
剖视 A-A（XZ 中面）
8.6
8
4
H1
特征 / 孔表（位置：轴类为轴向范围；其余为轴线坐标，原点 = 主视左下基准）
号
特征
数
公差带 / 规格
位置（mm）
孔 Ø3
1
H7 (+0.010/0)
∥Z (3.0,-1.5) z -2.0…2.0
技术要求
1. 材料：17-4PH 淬硬；工艺：线切割 + 热处理；
2. 未注线性尺寸公差 GB/T 1804-m；未注形位公差 GB/T 1184-K；
3. 未注倒角 C0.3–C0.5，锐边去毛刺；未注圆角（机加）R0.2；
4. 形位公差：钩舌面对销孔平行度 0.02；
5. 表面粗糙度：钩舌 Ra0.8； 其余 Ra3.2；
6. 17-4PH H900；扭簧复位；SMART-LOCK 凸轮推钩尾解锁（CN122407665A）；
7. 来源：8×4×8 钩，Ø3 销孔；钩舌进入插槽 1.4
其余 √Ra3.2
VOLTRA I 独立参考设计 · 尺寸为设计值（假设），非原厂实测
图名
Dock 枢转卡钩（扭簧复位，专利 CN122407665…
图号
DOCK-HOOK-01
材料
17-4PH 淬硬
比例
5:1
版本
CAD-v03 / DOC-VER-05
日期
2026-10-20
第一角画法（GB/T 14692） 单位 mm 未注公差 GB/T 1804-m / GB/T 1184-K
加工前须以实测样件、供应商样本及 docs/gap-list.md 复核
