merlinwwu/voltra-i-ref-3d/downloads/step/CLP-LW-01.step

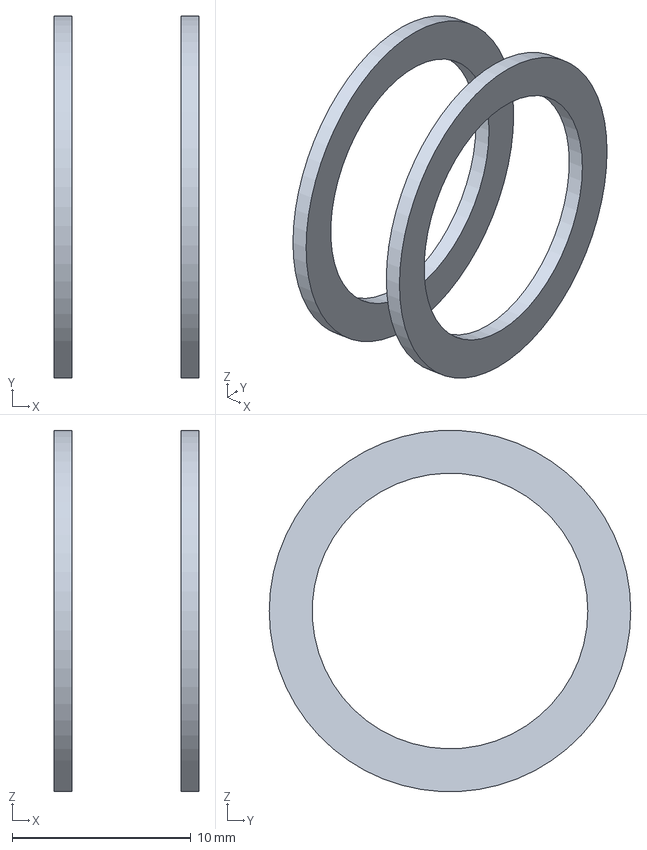
[picture p104: CAD file, 2026-10-20]
downloads/step/CLP-LW-01.step
8.10 x 20.2 x 20.2 mm
