merlinwwu/voltra-i-ref-3d/downloads/drawings/EXIT-GUIDE-01.dxf

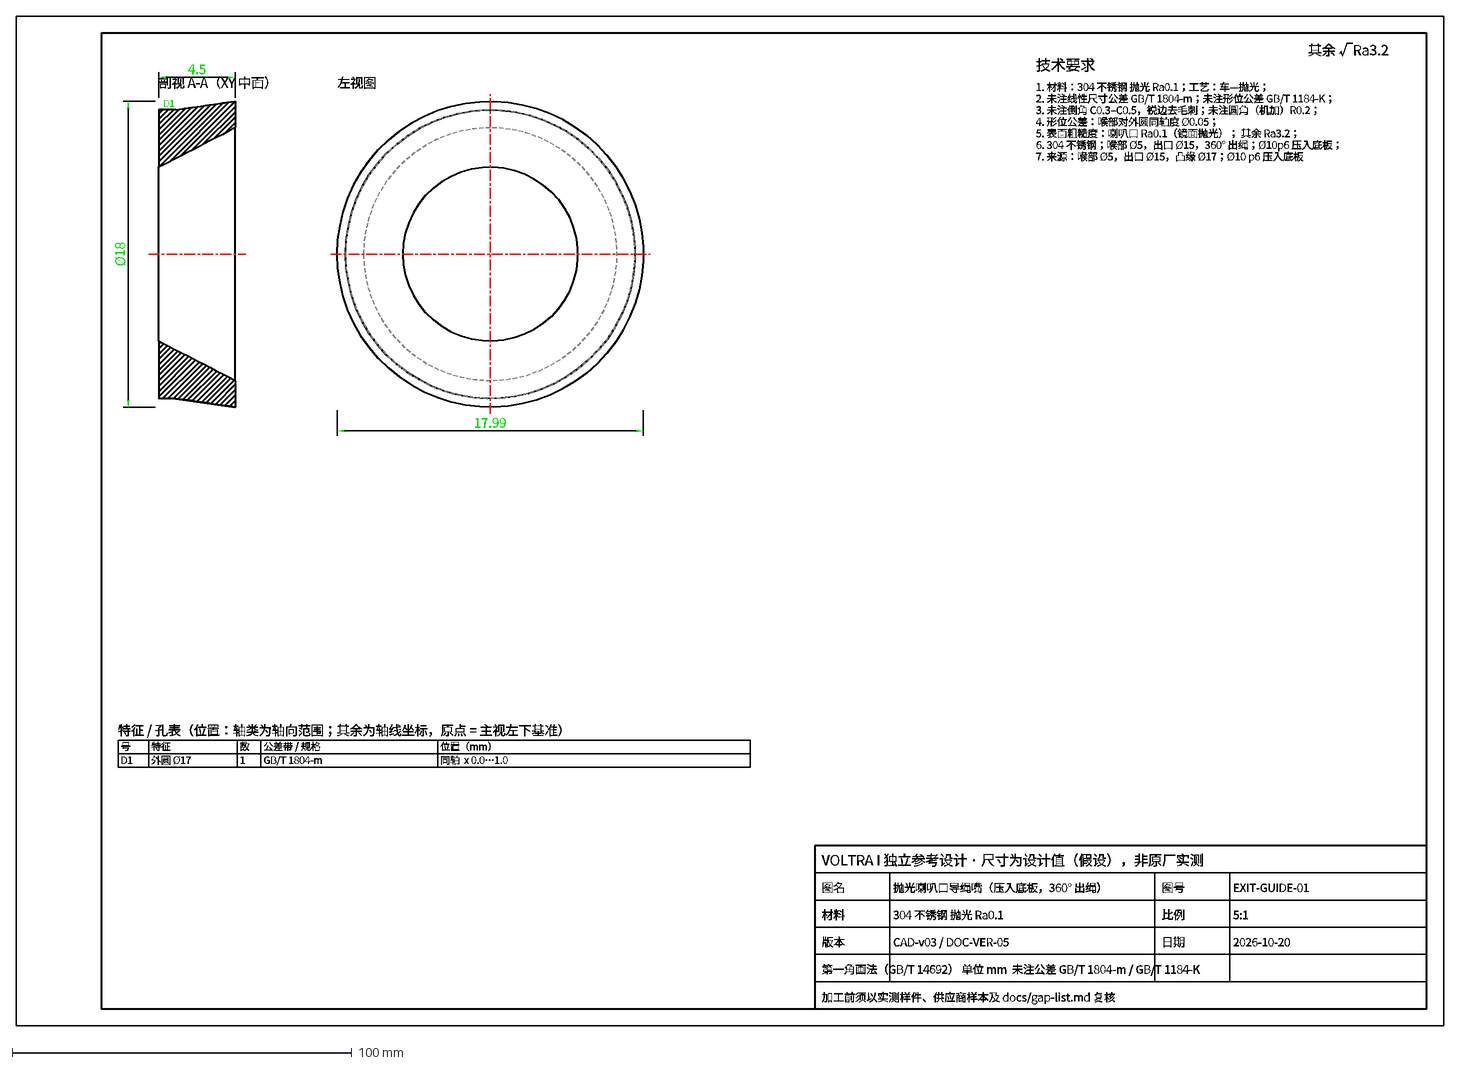
[picture p105: CAD file, 2026-10-20]
downloads/drawings/EXIT-GUIDE-01.dxf
剖视 A-A（XY 中面）
左视图
4.5
Ø18
17.99
D1
特征 / 孔表（位置：轴类为轴向范围；其余为轴线坐标，原点 = 主视左下基准）
号
特征
数
公差带 / 规格
位置（mm）
外圆 Ø17
1
GB/T 1804-m
同轴 x 0.0…1.0
技术要求
1. 材料：304 不锈钢 抛光 Ra0.1；工艺：车—抛光；
2. 未注线性尺寸公差 GB/T 1804-m；未注形位公差 GB/T 1184-K；
3. 未注倒角 C0.3–C0.5，锐边去毛刺；未注圆角（机加）R0.2；
4. 形位公差：喉部对外圆同轴度 Ø0.05；
5. 表面粗糙度：喇叭口 Ra0.1（镜面抛光）； 其余 Ra3.2；
6. 304 不锈钢；喉部 Ø5，出口 Ø15，360° 出绳；Ø10p6 压入底板；
7. 来源：喉部 Ø5，出口 Ø15，凸缘 Ø17；Ø10 p6 压入底板
其余 √Ra3.2
VOLTRA I 独立参考设计 · 尺寸为设计值（假设），非原厂实测
图名
抛光喇叭口导绳嘴（压入底板，360° 出绳）
图号
EXIT-GUIDE-01
材料
304 不锈钢 抛光 Ra0.1
比例
5:1
版本
CAD-v03 / DOC-VER-05
日期
2026-10-20
第一角画法（GB/T 14692） 单位 mm 未注公差 GB/T 1804-m / GB/T 1184-K
加工前须以实测样件、供应商样本及 docs/gap-list.md 复核
