merlinwwu/voltra-i-ref-3d/downloads/step/ROT-HUB-01.step

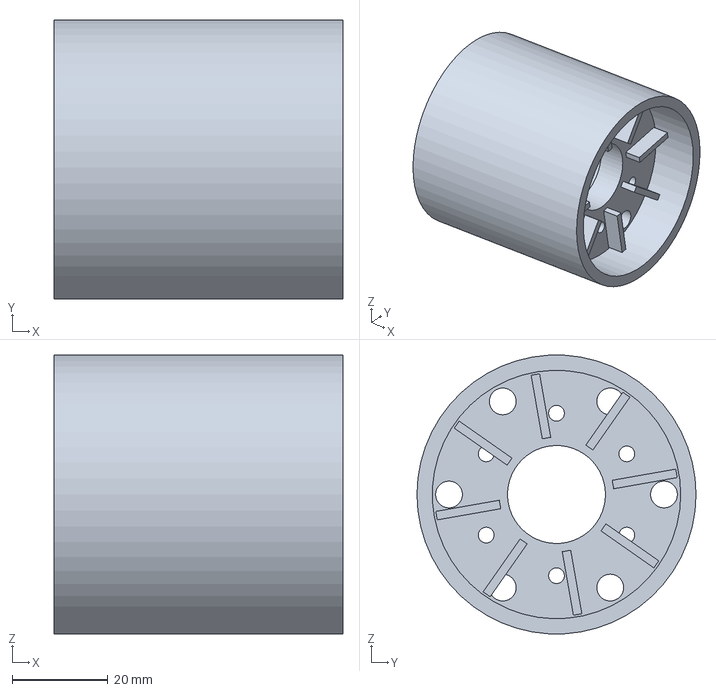
[picture p106: CAD file, 2026-10-20]
downloads/step/ROT-HUB-01.step
60.5 x 58.4 x 58.3 mm
