merlinwwu/voltra-i-ref-3d/downloads/drawings/LW-PIN-01.dxf

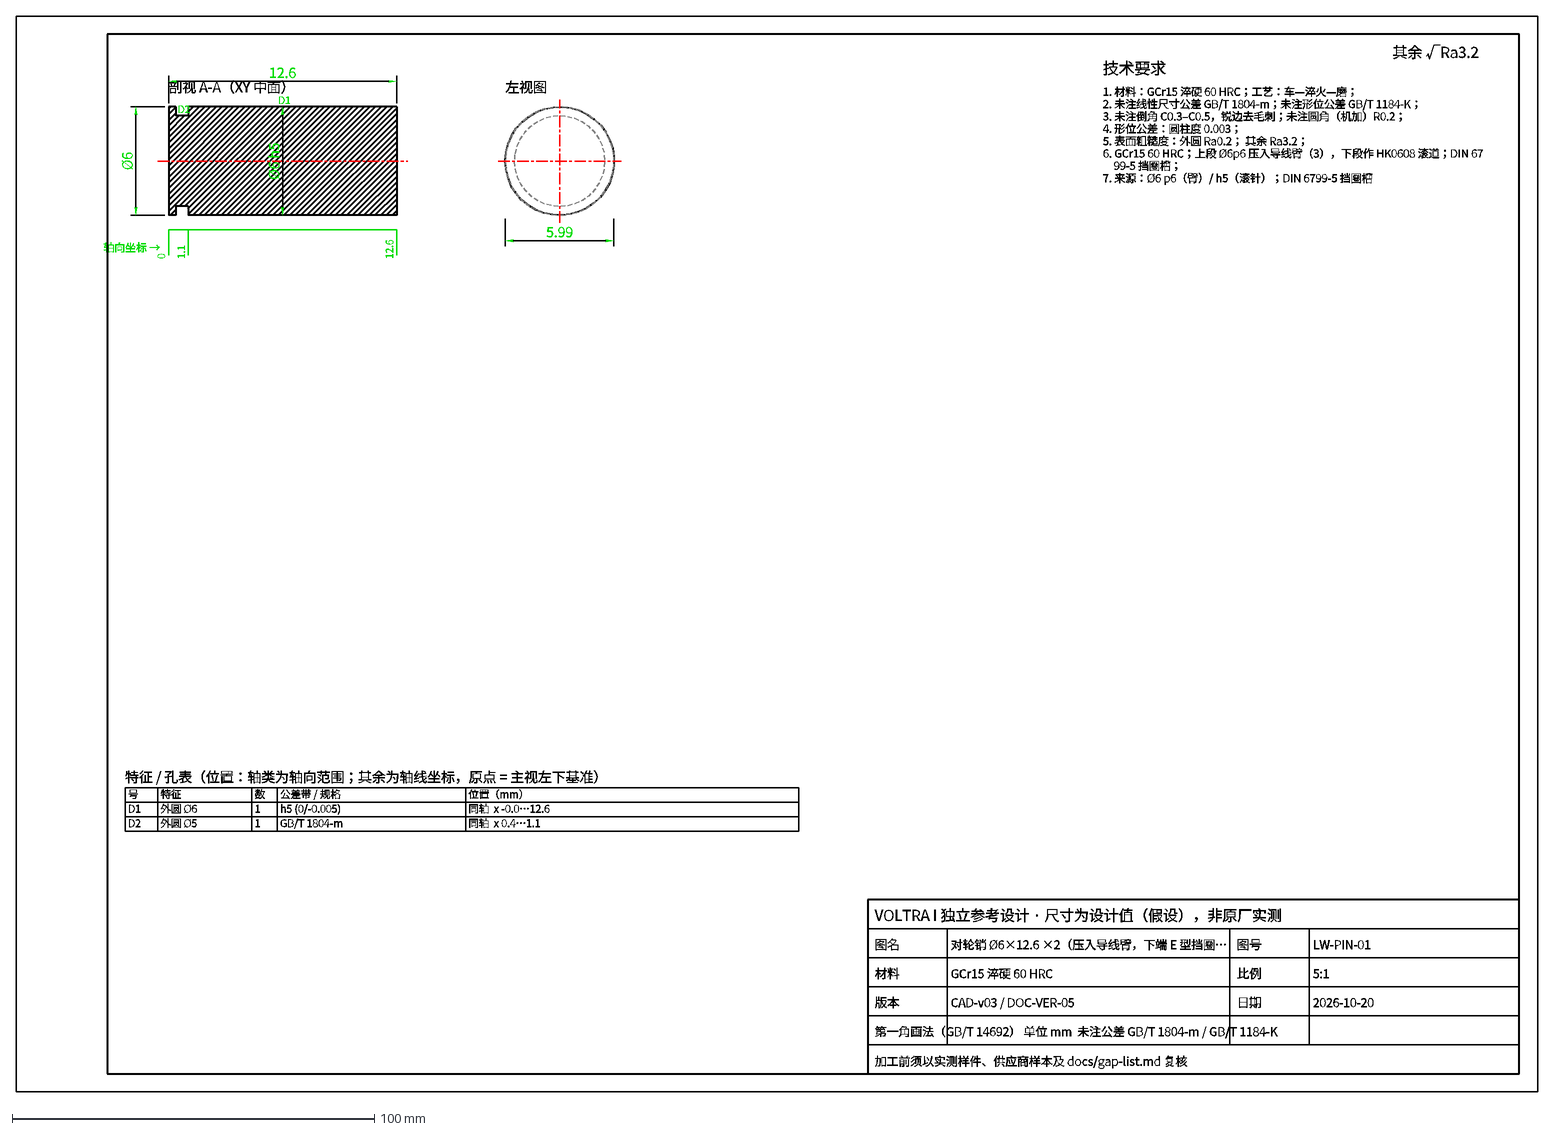
[picture p107: CAD file, 2026-10-20]
downloads/drawings/LW-PIN-01.dxf
剖视 A-A（XY 中面）
左视图
12.6
Ø6
5.99
0
1.1
轴向坐标 →
D1
Ø6 h5
D2
特征 / 孔表（位置：轴类为轴向范围；其余为轴线坐标，原点 = 主视左下基准）
号
特征
数
公差带 / 规格
位置（mm）
外圆 Ø6
1
h5 (0/-0.005)
同轴 x -0.0…12.6
外圆 Ø5
GB/T 1804-m
同轴 x 0.4…1.1
技术要求
1. 材料：GCr15 淬硬 60 HRC；工艺：车—淬火—磨；
2. 未注线性尺寸公差 GB/T 1804-m；未注形位公差 GB/T 1184-K；
3. 未注倒角 C0.3–C0.5，锐边去毛刺；未注圆角（机加）R0.2；
4. 形位公差：圆柱度 0.003；
5. 表面粗糙度：外圆 Ra0.2； 其余 Ra3.2；
6. GCr15 60 HRC；上段 Ø6p6 压入导线臂（3），下段作 HK0608 滚道；DIN 67
99-5 挡圈槽；
7. 来源：Ø6 p6（臂）/ h5（滚针）；DIN 6799-5 挡圈槽
其余 √Ra3.2
VOLTRA I 独立参考设计 · 尺寸为设计值（假设），非原厂实测
图名
对轮销 Ø6×12.6 ×2（压入导线臂，下端 E 型挡圈…
图号
LW-PIN-01
材料
GCr15 淬硬 60 HRC
比例
5:1
版本
CAD-v03 / DOC-VER-05
日期
2026-10-20
第一角画法（GB/T 14692） 单位 mm 未注公差 GB/T 1804-m / GB/T 1184-K
加工前须以实测样件、供应商样本及 docs/gap-list.md 复核
