merlinwwu/voltra-i-ref-3d/downloads/step/SCR-END-L-01.step

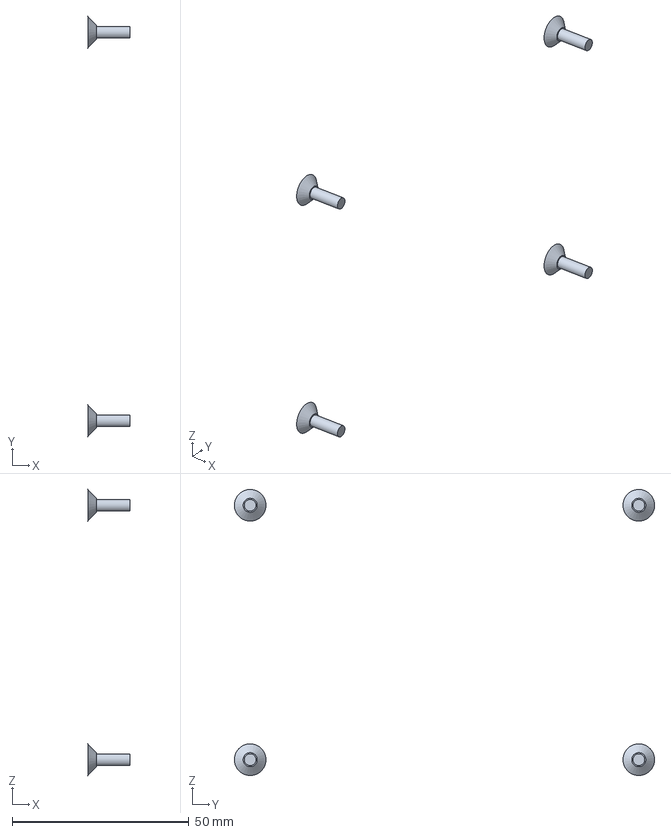
[picture p108: CAD file, 2026-10-20]
downloads/step/SCR-END-L-01.step
12.0 x 119.0 x 81.0 mm
