merlinwwu/voltra-i-ref-3d/downloads/drawings/EXIT-SHV-01.dxf

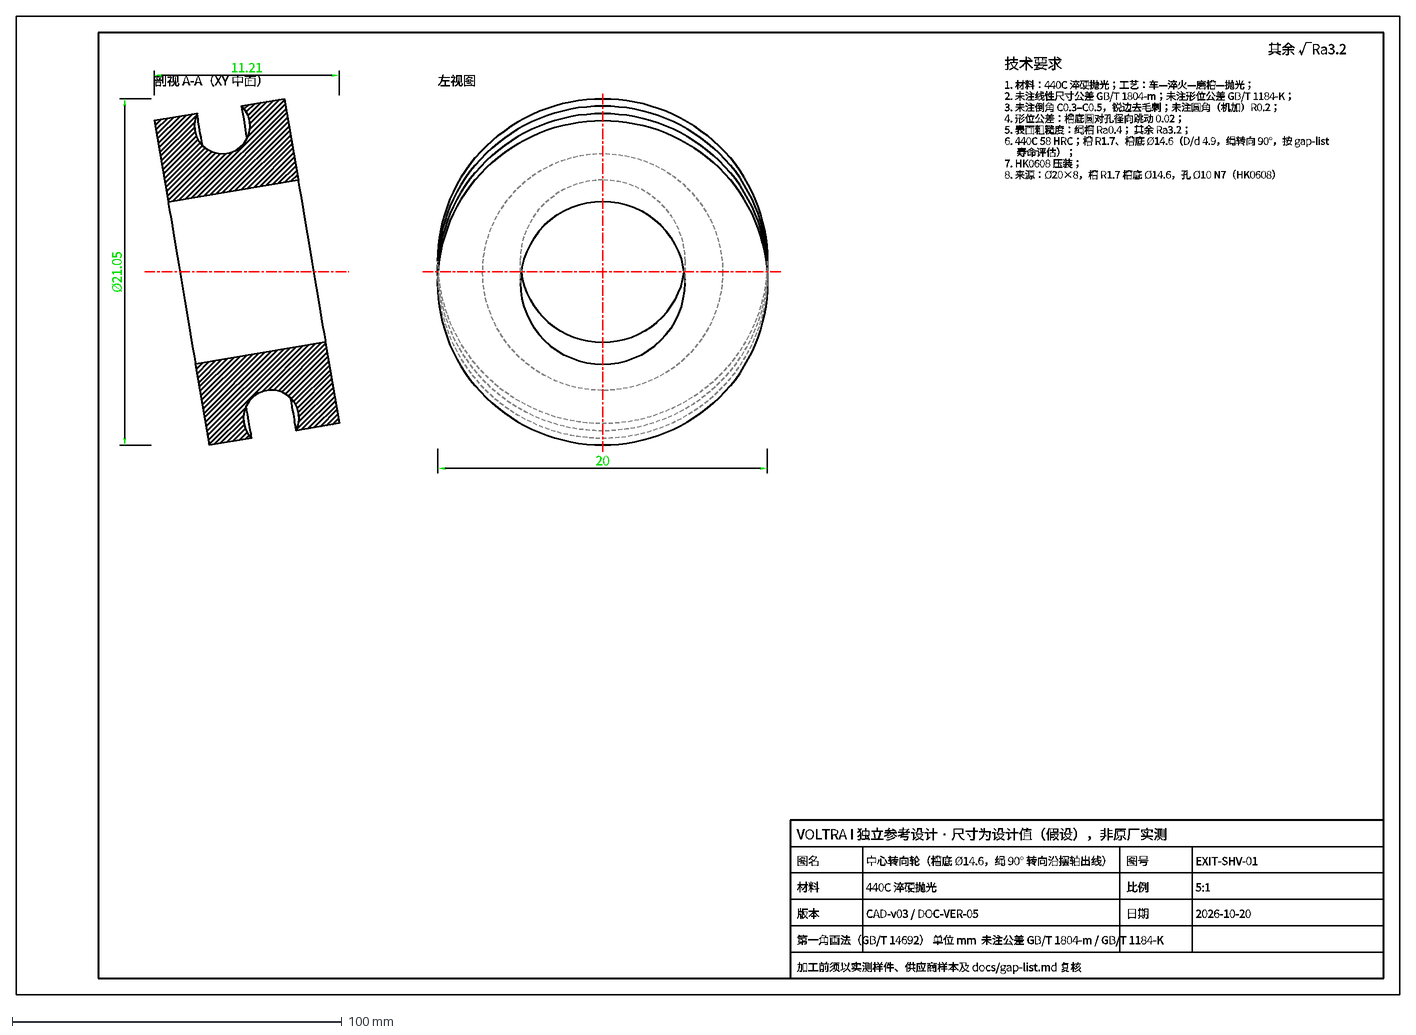
[picture p109: CAD file, 2026-10-20]
downloads/drawings/EXIT-SHV-01.dxf
剖视 A-A（XY 中面）
左视图
11.21
Ø21.05
20
技术要求
1. 材料：440C 淬硬抛光；工艺：车—淬火—磨槽—抛光；
2. 未注线性尺寸公差 GB/T 1804-m；未注形位公差 GB/T 1184-K；
3. 未注倒角 C0.3–C0.5，锐边去毛刺；未注圆角（机加）R0.2；
4. 形位公差：槽底圆对孔径向跳动 0.02；
5. 表面粗糙度：绳槽 Ra0.4； 其余 Ra3.2；
6. 440C 58 HRC；槽 R1.7、槽底 Ø14.6（D/d 4.9，绳转向 90°，按 gap-list
寿命评估）；
7. HK0608 压装；
8. 来源：Ø20×8，槽 R1.7 槽底 Ø14.6，孔 Ø10 N7（HK0608）
其余 √Ra3.2
VOLTRA I 独立参考设计 · 尺寸为设计值（假设），非原厂实测
图名
中心转向轮（槽底 Ø14.6，绳 90° 转向沿摆轴出线）
图号
EXIT-SHV-01
材料
440C 淬硬抛光
比例
5:1
版本
CAD-v03 / DOC-VER-05
日期
2026-10-20
第一角画法（GB/T 14692） 单位 mm 未注公差 GB/T 1804-m / GB/T 1184-K
加工前须以实测样件、供应商样本及 docs/gap-list.md 复核
