merlinwwu/voltra-i-ref-3d/downloads/step/SCR-HUB-01.step

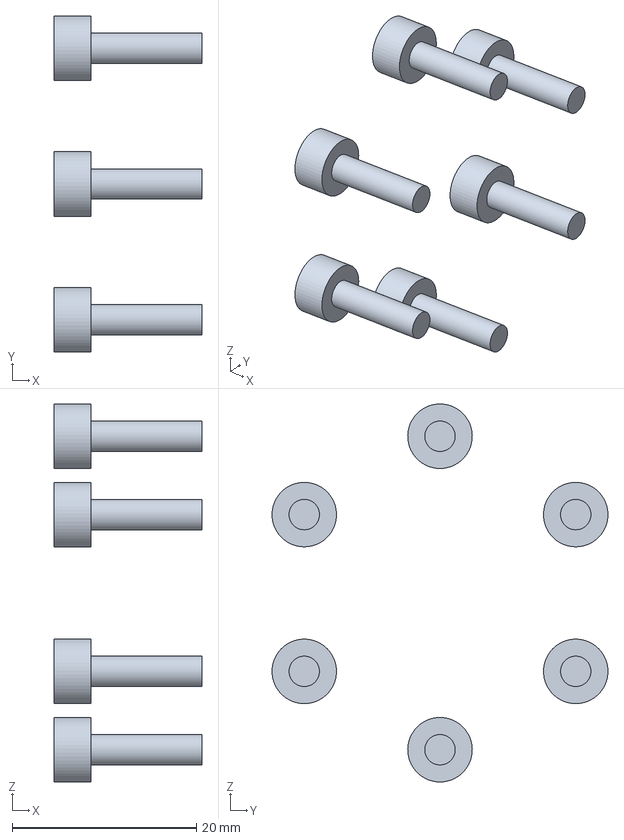
[picture p110: CAD file, 2026-10-20]
downloads/step/SCR-HUB-01.step
16.0 x 36.4 x 41.0 mm
