merlinwwu/voltra-i-ref-3d/downloads/drawings/HSG-END-L-01.dxf

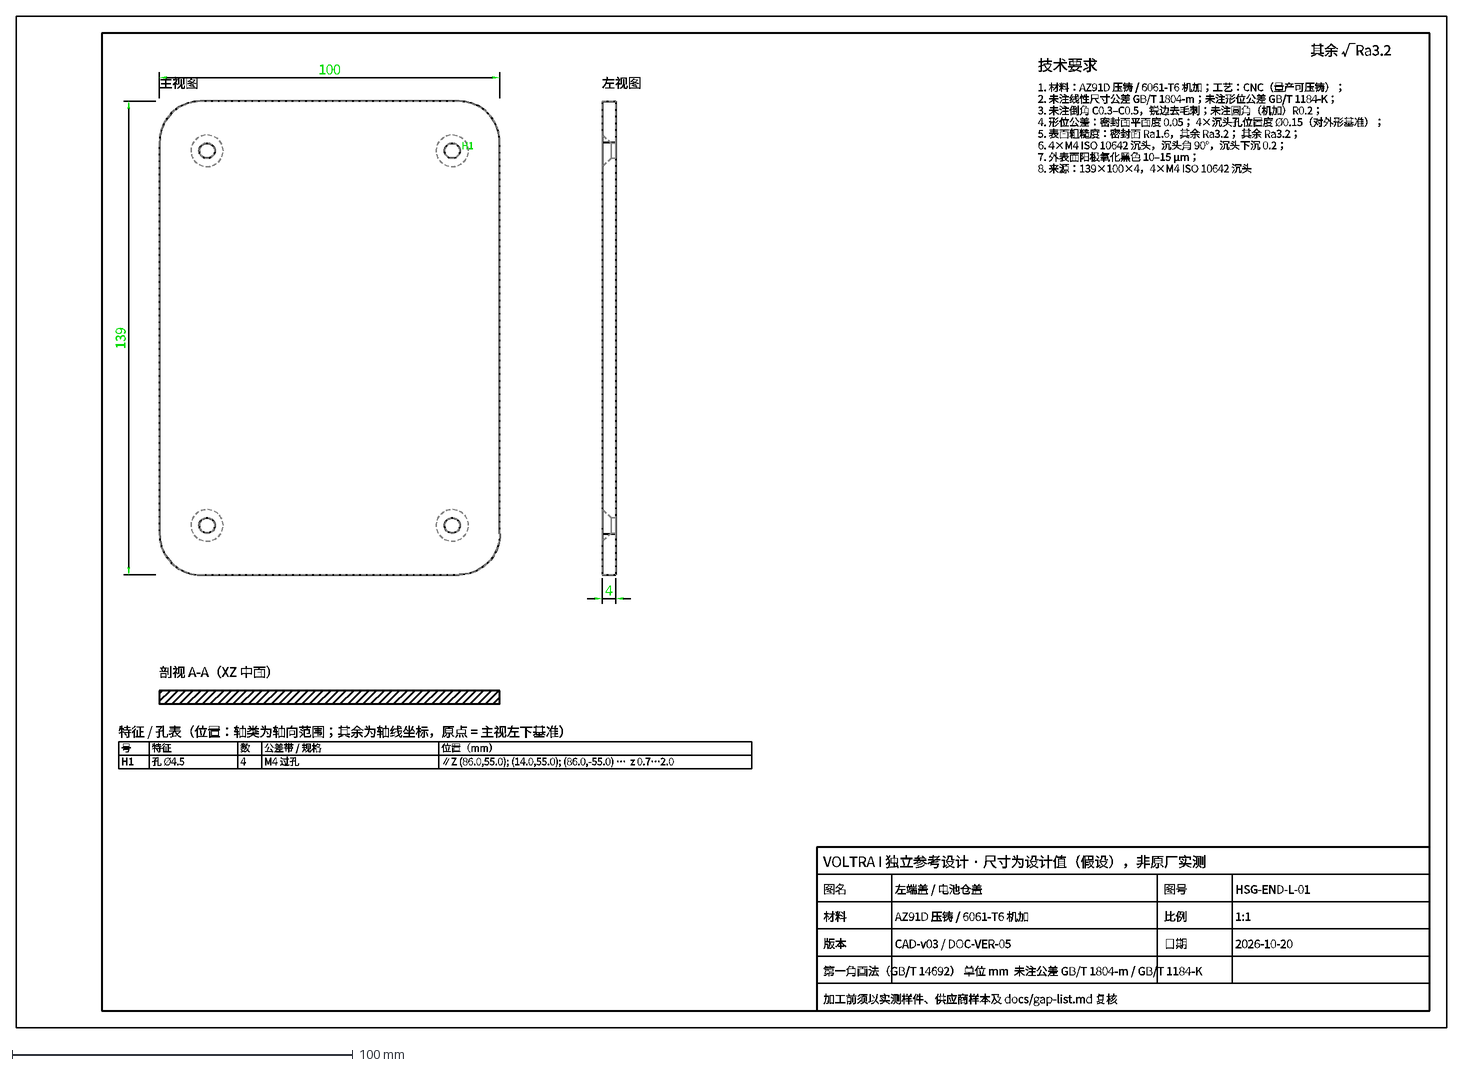
[picture p111: CAD file, 2026-10-20]
downloads/drawings/HSG-END-L-01.dxf
主视图
左视图
剖视 A-A（XZ 中面）
100
139
4
H1
特征 / 孔表（位置：轴类为轴向范围；其余为轴线坐标，原点 = 主视左下基准）
号
特征
数
公差带 / 规格
位置（mm）
孔 Ø4.5
M4 过孔
∥Z (86.0,55.0); (14.0,55.0); (86.0,-55.0) … z 0.7…2.0
技术要求
1. 材料：AZ91D 压铸 / 6061-T6 机加；工艺：CNC（量产可压铸）；
2. 未注线性尺寸公差 GB/T 1804-m；未注形位公差 GB/T 1184-K；
3. 未注倒角 C0.3–C0.5，锐边去毛刺；未注圆角（机加）R0.2；
4. 形位公差：密封面平面度 0.05； 4×沉头孔位置度 Ø0.15（对外形基准）；
5. 表面粗糙度：密封面 Ra1.6，其余 Ra3.2； 其余 Ra3.2；
6. 4×M4 ISO 10642 沉头，沉头角 90°，沉头下沉 0.2；
7. 外表面阳极氧化黑色 10–15 µm；
8. 来源：139×100×4，4×M4 ISO 10642 沉头
其余 √Ra3.2
VOLTRA I 独立参考设计 · 尺寸为设计值（假设），非原厂实测
图名
左端盖 / 电池仓盖
图号
HSG-END-L-01
材料
AZ91D 压铸 / 6061-T6 机加
比例
1:1
版本
CAD-v03 / DOC-VER-05
日期
2026-10-20
第一角画法（GB/T 14692） 单位 mm 未注公差 GB/T 1804-m / GB/T 1184-K
加工前须以实测样件、供应商样本及 docs/gap-list.md 复核
