merlinwwu/voltra-i-ref-3d/downloads/step/DOCK-IF-01.step

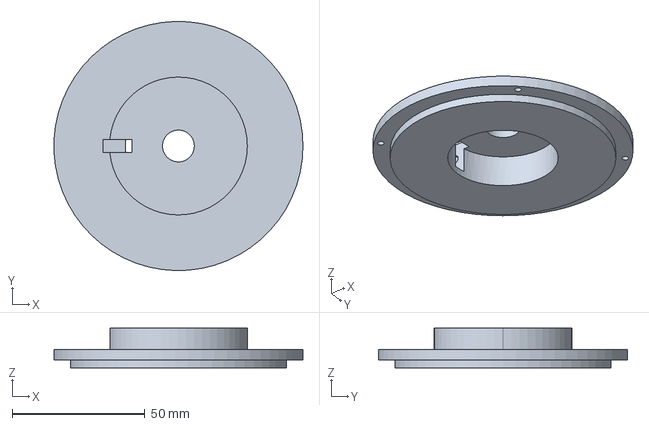
[picture p112: CAD file, 2026-10-20]
downloads/step/DOCK-IF-01.step
93.9 x 94.0 x 15.0 mm
