merlinwwu/voltra-i-ref-3d/downloads/drawings/EXIT-SWV-01.dxf

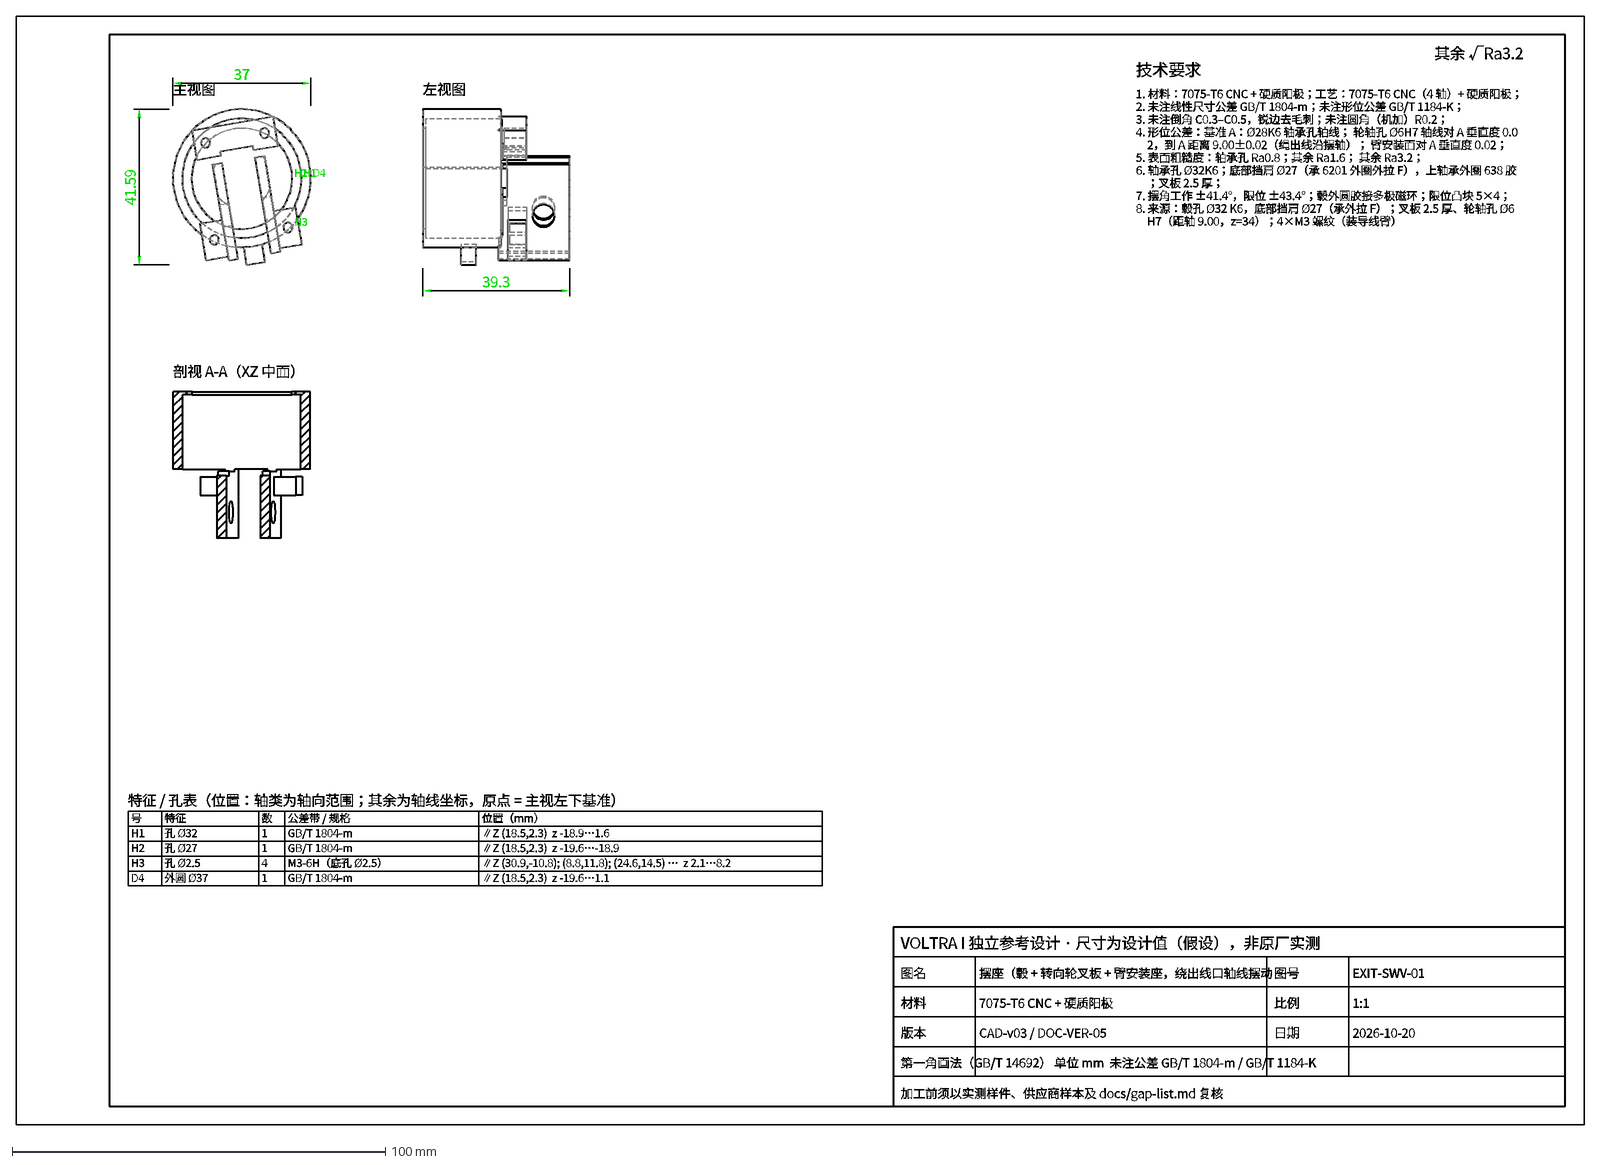
[picture p113: CAD file, 2026-10-20]
downloads/drawings/EXIT-SWV-01.dxf
主视图
左视图
剖视 A-A（XZ 中面）
37
41.59
39.3
H1
H2
H3
D4
特征 / 孔表（位置：轴类为轴向范围；其余为轴线坐标，原点 = 主视左下基准）
号
特征
数
公差带 / 规格
位置（mm）
孔 Ø32
1
GB/T 1804-m
∥Z (18.5,2.3) z -18.9…1.6
孔 Ø27
∥Z (18.5,2.3) z -19.6…-18.9
孔 Ø2.5
4
M3-6H（底孔 Ø2.5）
∥Z (30.9,-10.8); (8.8,11.8); (24.6,14.5) … z 2.1…8.2
外圆 Ø37
∥Z (18.5,2.3) z -19.6…1.1
技术要求
1. 材料：7075-T6 CNC + 硬质阳极；工艺：7075-T6 CNC（4 轴）+ 硬质阳极；
2. 未注线性尺寸公差 GB/T 1804-m；未注形位公差 GB/T 1184-K；
3. 未注倒角 C0.3–C0.5，锐边去毛刺；未注圆角（机加）R0.2；
4. 形位公差：基准 A：Ø28K6 轴承孔轴线； 轮轴孔 Ø6H7 轴线对 A 垂直度 0.0
2，到 A 距离 9.00±0.02（绳出线沿摆轴）； 臂安装面对 A 垂直度 0.02；
5. 表面粗糙度：轴承孔 Ra0.8；其余 Ra1.6； 其余 Ra3.2；
6. 轴承孔 Ø32K6；底部挡肩 Ø27（承 6201 外圈外拉 F），上轴承外圈 638 胶
；叉板 2.5 厚；
7. 摆角工作 ±41.4°，限位 ±43.4°；毂外圆胶接多极磁环；限位凸块 5×4；
8. 来源：毂孔 Ø32 K6，底部挡肩 Ø27（承外拉 F）；叉板 2.5 厚、轮轴孔 Ø6
H7（距轴 9.00，z=34）；4×M3 螺纹（装导线臂）
其余 √Ra3.2
VOLTRA I 独立参考设计 · 尺寸为设计值（假设），非原厂实测
图名
摆座（毂 + 转向轮叉板 + 臂安装座，绕出线口轴线摆动 …
图号
EXIT-SWV-01
材料
7075-T6 CNC + 硬质阳极
比例
1:1
版本
CAD-v03 / DOC-VER-05
日期
2026-10-20
第一角画法（GB/T 14692） 单位 mm 未注公差 GB/T 1804-m / GB/T 1184-K
加工前须以实测样件、供应商样本及 docs/gap-list.md 复核
