merlinwwu/voltra-i-ref-3d/downloads/step/LW-BRG-01.step

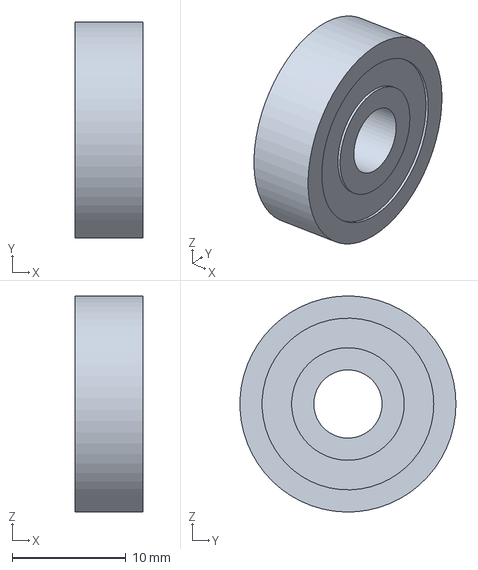
[picture p114: CAD file, 2026-10-20]
downloads/step/LW-BRG-01.step
6.00 x 19.0 x 19.0 mm
