merlinwwu/voltra-i-ref-3d/downloads/drawings/EXIT-PIN-01.dxf

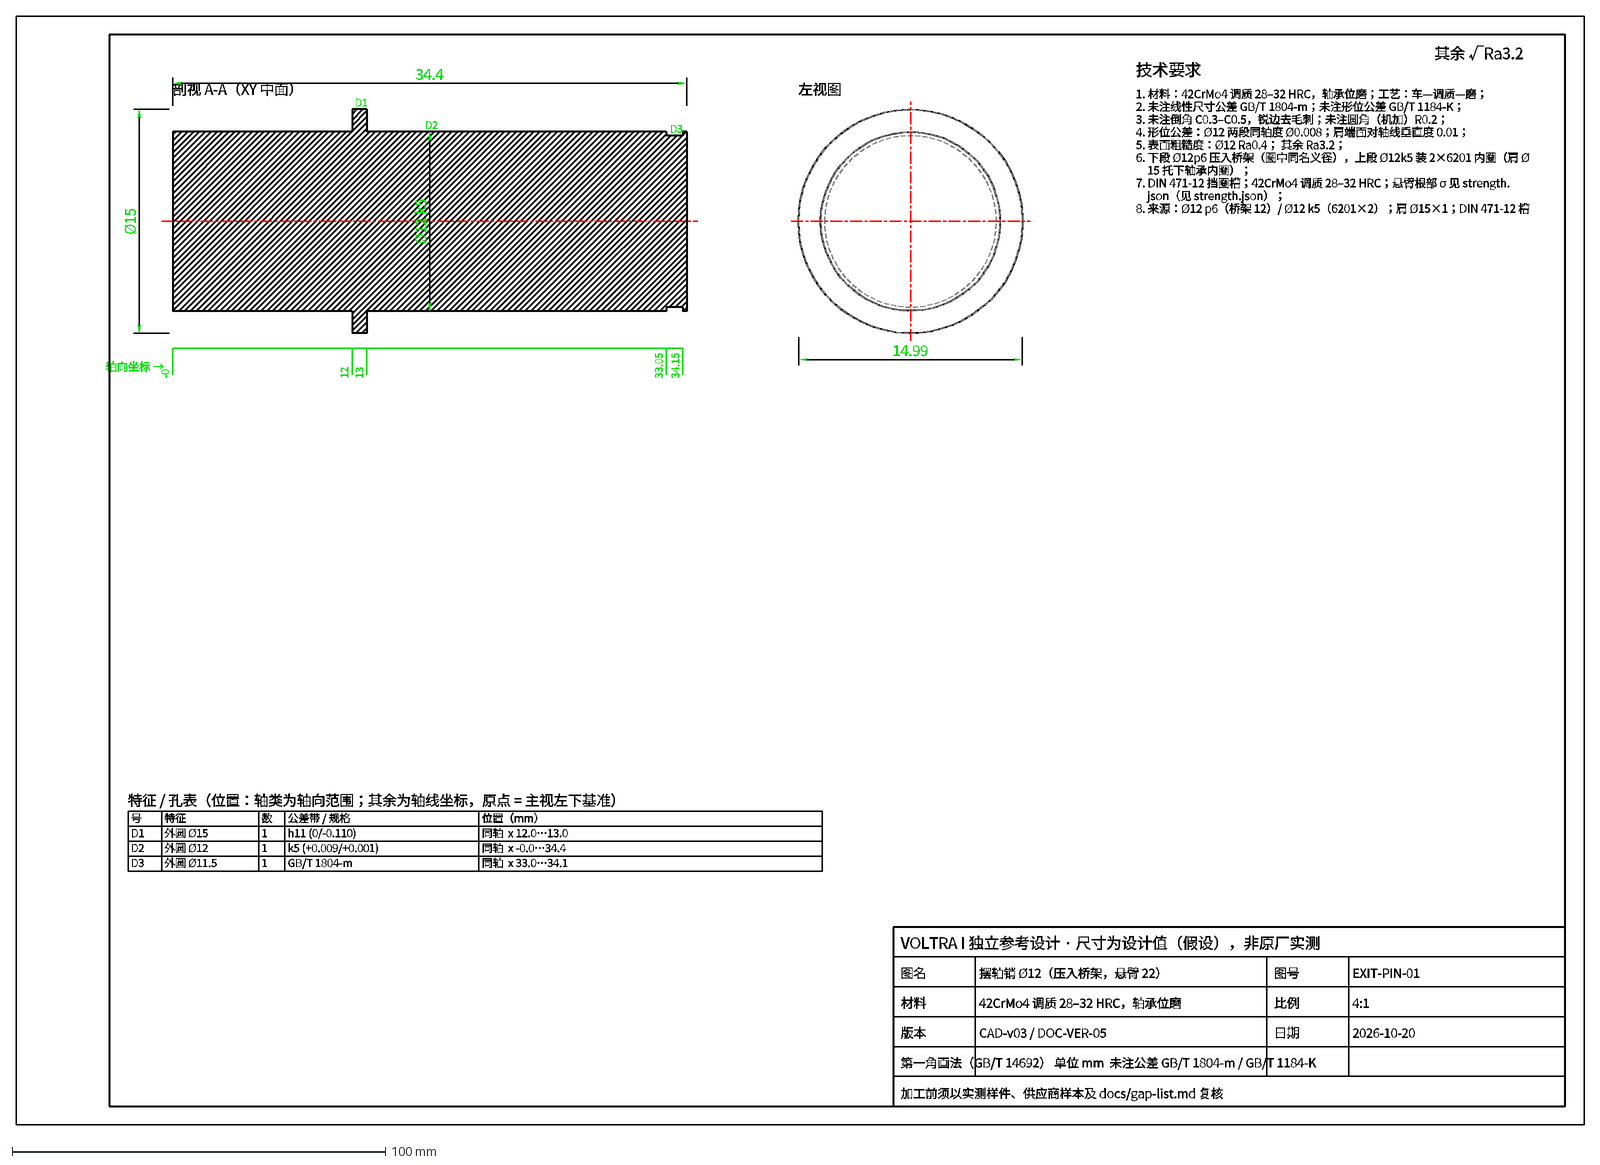
[picture p115: CAD file, 2026-10-20]
downloads/drawings/EXIT-PIN-01.dxf
剖视 A-A（XY 中面）
左视图
34.4
Ø15
14.99
-0
12
13
33.05
34.15
轴向坐标 →
D1
D2
Ø12 k5
D3
特征 / 孔表（位置：轴类为轴向范围；其余为轴线坐标，原点 = 主视左下基准）
号
特征
数
公差带 / 规格
位置（mm）
外圆 Ø15
1
h11 (0/-0.110)
同轴 x 12.0…13.0
外圆 Ø12
k5 (+0.009/+0.001)
同轴 x -0.0…34.4
外圆 Ø11.5
GB/T 1804-m
同轴 x 33.0…34.1
技术要求
1. 材料：42CrMo4 调质 28–32 HRC，轴承位磨；工艺：车—调质—磨；
2. 未注线性尺寸公差 GB/T 1804-m；未注形位公差 GB/T 1184-K；
3. 未注倒角 C0.3–C0.5，锐边去毛刺；未注圆角（机加）R0.2；
4. 形位公差：Ø12 两段同轴度 Ø0.008；肩端面对轴线垂直度 0.01；
5. 表面粗糙度：Ø12 Ra0.4； 其余 Ra3.2；
6. 下段 Ø12p6 压入桥架（图中同名义径），上段 Ø12k5 装 2×6201 内圈（肩 Ø
15 托下轴承内圈）；
7. DIN 471-12 挡圈槽；42CrMo4 调质 28–32 HRC；悬臂根部 σ 见 strength.
json（见 strength.json）；
8. 来源：Ø12 p6（桥架 12）/ Ø12 k5（6201×2）；肩 Ø15×1；DIN 471-12 槽
其余 √Ra3.2
VOLTRA I 独立参考设计 · 尺寸为设计值（假设），非原厂实测
图名
摆轴销 Ø12（压入桥架，悬臂 22）
图号
EXIT-PIN-01
材料
42CrMo4 调质 28–32 HRC，轴承位磨
比例
4:1
版本
CAD-v03 / DOC-VER-05
日期
2026-10-20
第一角画法（GB/T 14692） 单位 mm 未注公差 GB/T 1804-m / GB/T 1184-K
加工前须以实测样件、供应商样本及 docs/gap-list.md 复核
