merlinwwu/voltra-i-ref-3d/downloads/step/DRUM-HUB-01.step

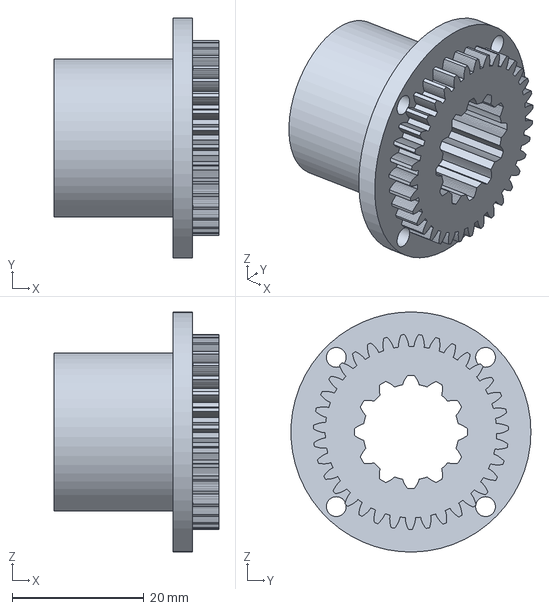
[picture p116: CAD file, 2026-10-20]
downloads/step/DRUM-HUB-01.step
25.0 x 36.4 x 36.4 mm
