merlinwwu/voltra-i-ref-3d/downloads/drawings/DRUM-CLAMP-01.dxf

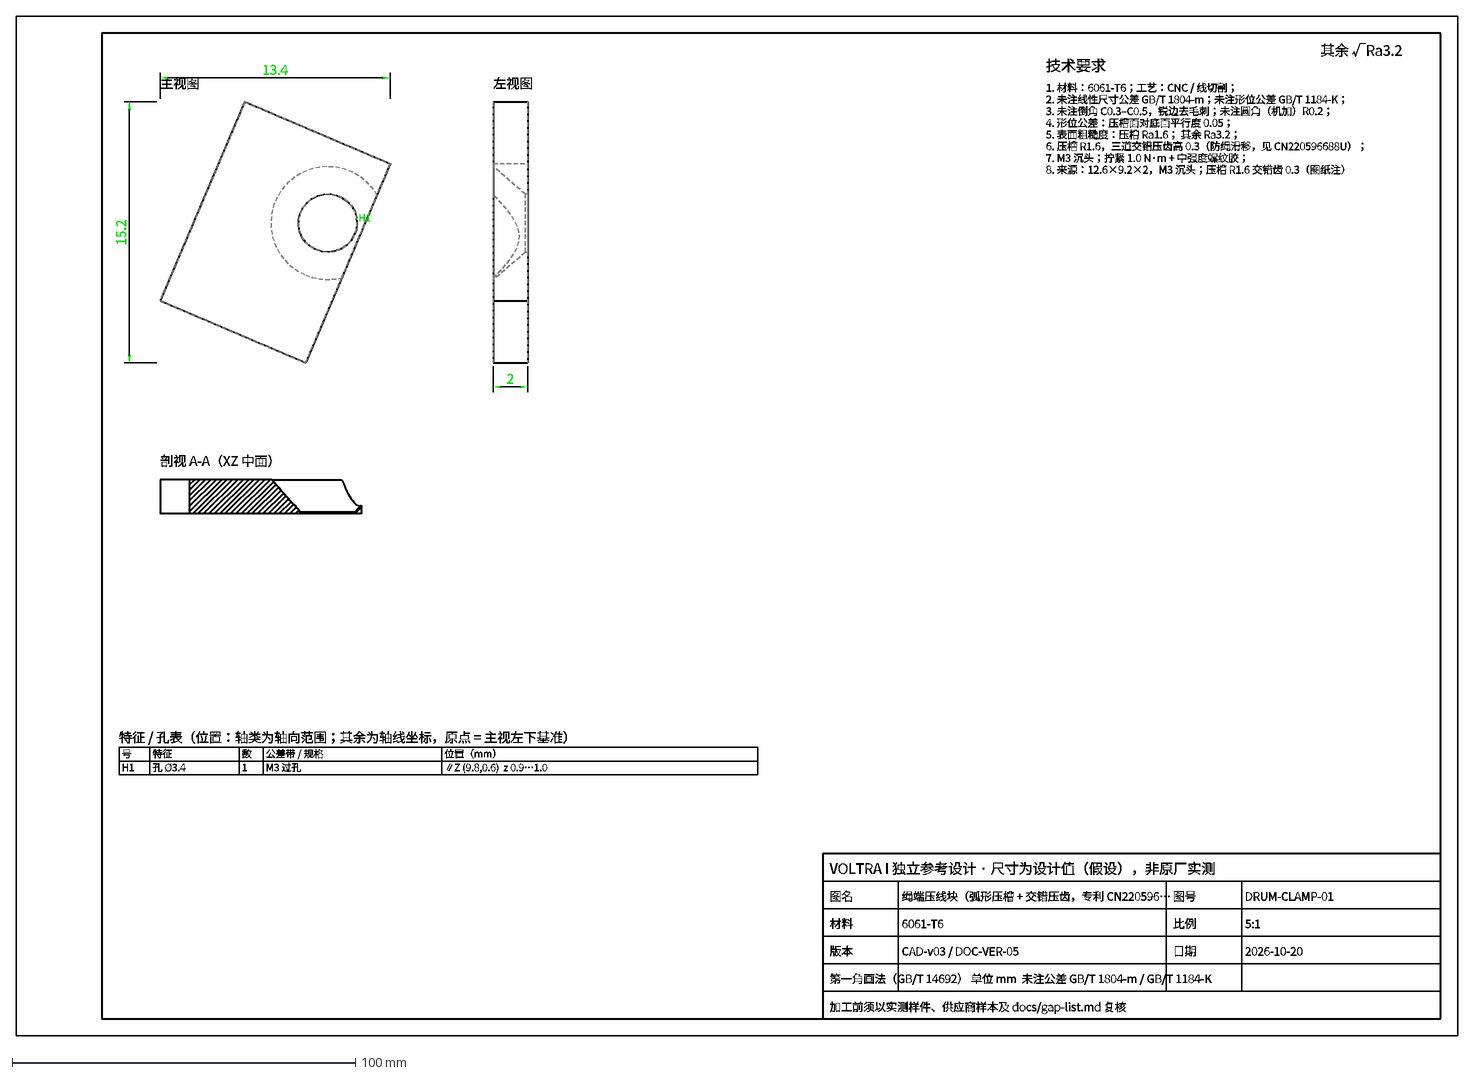
[picture p117: CAD file, 2026-10-20]
downloads/drawings/DRUM-CLAMP-01.dxf
主视图
左视图
剖视 A-A（XZ 中面）
13.4
15.2
2
H1
特征 / 孔表（位置：轴类为轴向范围；其余为轴线坐标，原点 = 主视左下基准）
号
特征
数
公差带 / 规格
位置（mm）
孔 Ø3.4
1
M3 过孔
∥Z (9.8,0.6) z 0.9…1.0
技术要求
1. 材料：6061-T6；工艺：CNC / 线切割；
2. 未注线性尺寸公差 GB/T 1804-m；未注形位公差 GB/T 1184-K；
3. 未注倒角 C0.3–C0.5，锐边去毛刺；未注圆角（机加）R0.2；
4. 形位公差：压槽面对底面平行度 0.05；
5. 表面粗糙度：压槽 Ra1.6； 其余 Ra3.2；
6. 压槽 R1.6，三道交错压齿高 0.3（防绳滑移，见 CN220596688U）；
7. M3 沉头；拧紧 1.0 N·m + 中强度螺纹胶；
8. 来源：12.6×9.2×2，M3 沉头；压槽 R1.6 交错齿 0.3（图纸注）
其余 √Ra3.2
VOLTRA I 独立参考设计 · 尺寸为设计值（假设），非原厂实测
图名
绳端压线块（弧形压槽 + 交错压齿，专利 CN220596…
图号
DRUM-CLAMP-01
材料
6061-T6
比例
5:1
版本
CAD-v03 / DOC-VER-05
日期
2026-10-20
第一角画法（GB/T 14692） 单位 mm 未注公差 GB/T 1804-m / GB/T 1184-K
加工前须以实测样件、供应商样本及 docs/gap-list.md 复核
