merlinwwu/voltra-i-ref-3d/downloads/step/CLP-BRG03.step

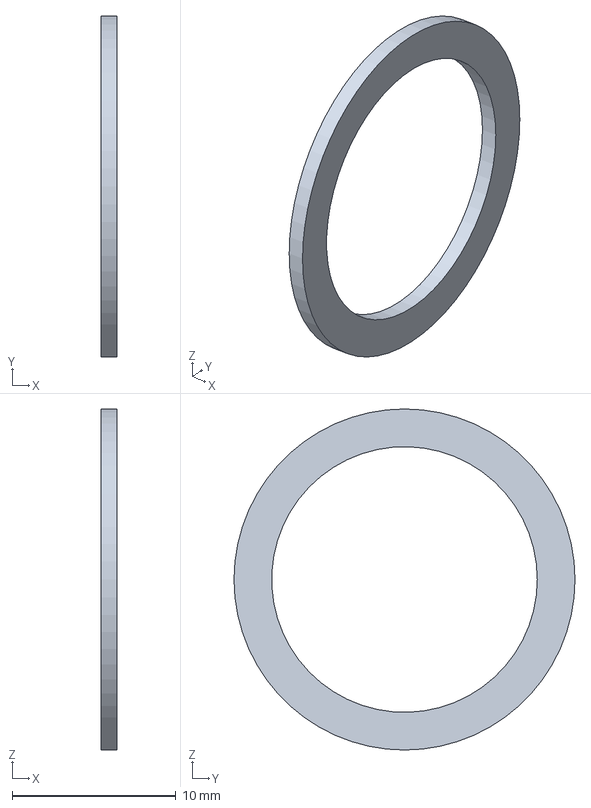
[picture p118: CAD file, 2026-10-20]
downloads/step/CLP-BRG03.step
1.00 x 20.8 x 20.8 mm
