merlinwwu/voltra-i-ref-3d/downloads/drawings/PCB-HS-01.dxf

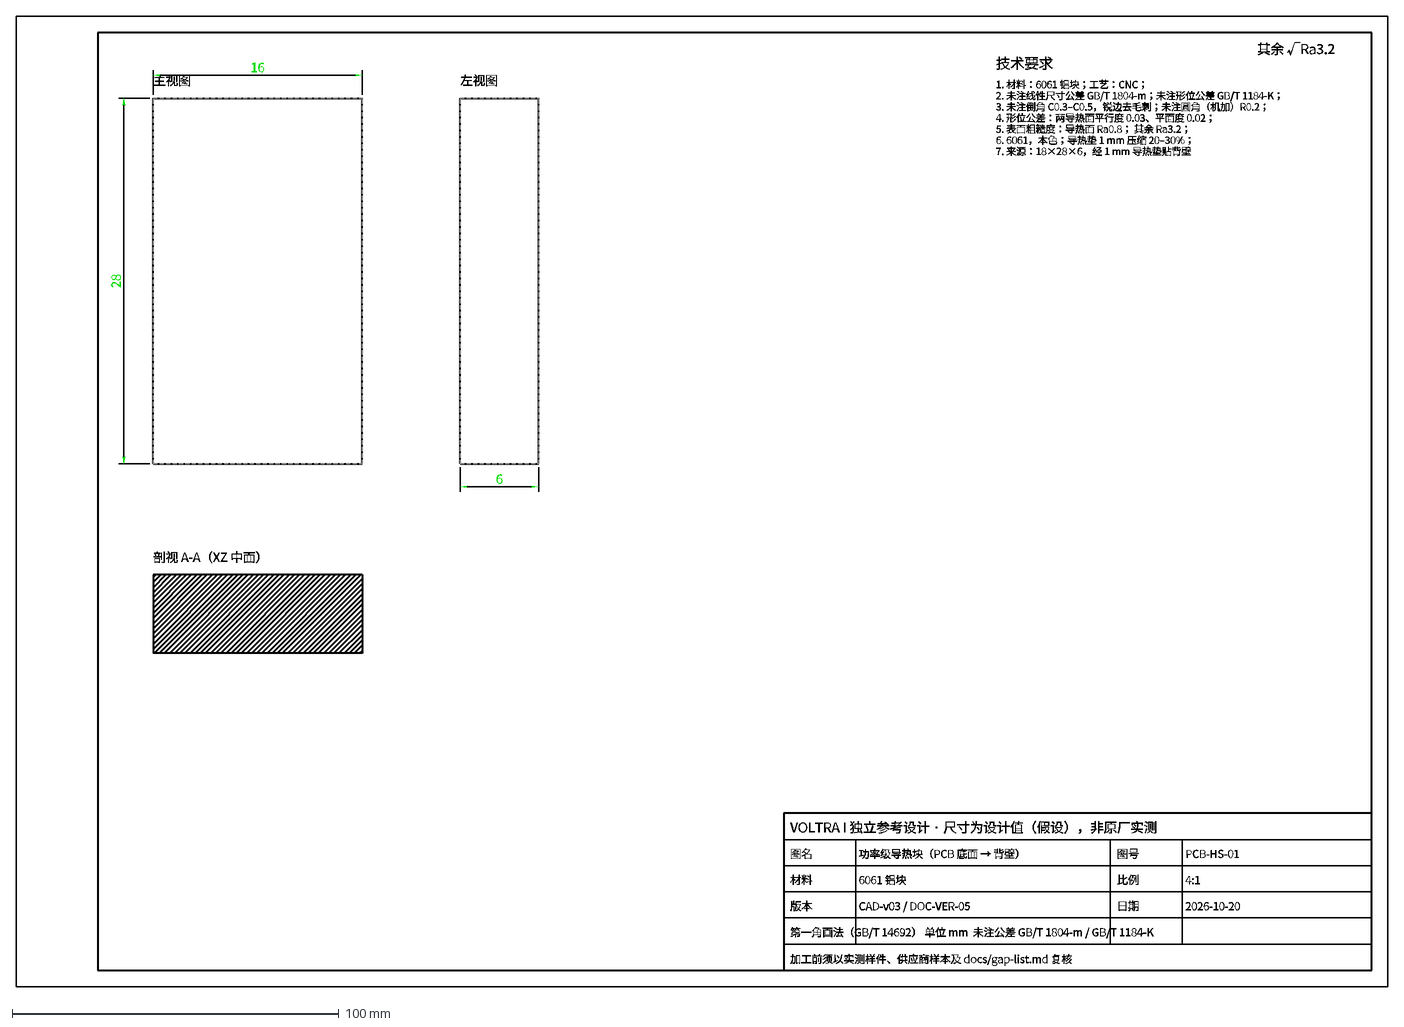
[picture p119: CAD file, 2026-10-20]
downloads/drawings/PCB-HS-01.dxf
主视图
左视图
剖视 A-A（XZ 中面）
16
28
6
技术要求
1. 材料：6061 铝块；工艺：CNC；
2. 未注线性尺寸公差 GB/T 1804-m；未注形位公差 GB/T 1184-K；
3. 未注倒角 C0.3–C0.5，锐边去毛刺；未注圆角（机加）R0.2；
4. 形位公差：两导热面平行度 0.03、平面度 0.02；
5. 表面粗糙度：导热面 Ra0.8； 其余 Ra3.2；
6. 6061，本色；导热垫 1 mm 压缩 20–30%；
7. 来源：18×28×6，经 1 mm 导热垫贴背壁
其余 √Ra3.2
VOLTRA I 独立参考设计 · 尺寸为设计值（假设），非原厂实测
图名
功率级导热块（PCB 底面 → 背壁）
图号
PCB-HS-01
材料
6061 铝块
比例
4:1
版本
CAD-v03 / DOC-VER-05
日期
2026-10-20
第一角画法（GB/T 14692） 单位 mm 未注公差 GB/T 1804-m / GB/T 1184-K
加工前须以实测样件、供应商样本及 docs/gap-list.md 复核
