merlinwwu/voltra-i-ref-3d/downloads/step/LW-BRIDGE-01.step

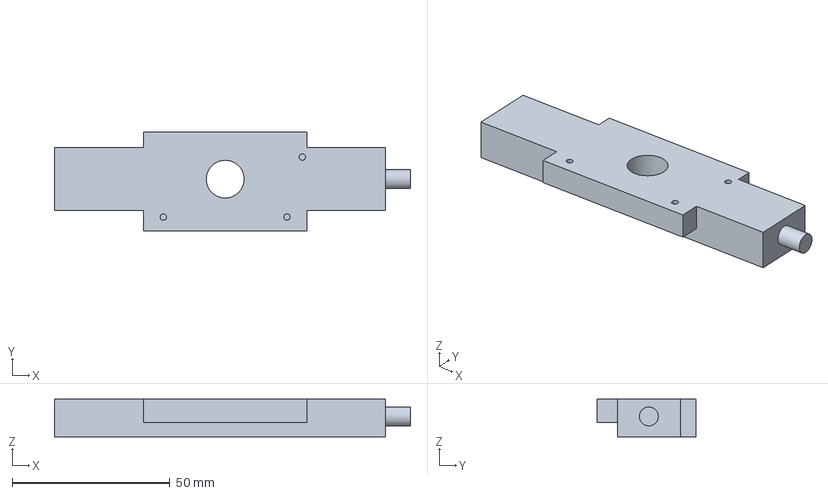
[picture p120: CAD file, 2026-10-20]
downloads/step/LW-BRIDGE-01.step
113.0 x 31.5 x 12.0 mm
