merlinwwu/voltra-i-ref-3d/downloads/step/DOCK-PIN-01.step

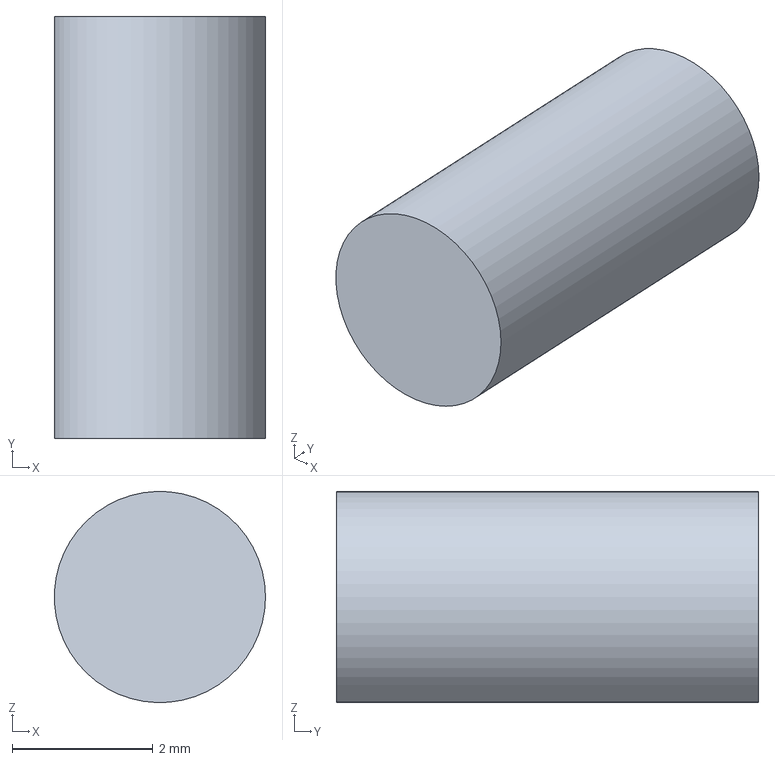
[picture p121: CAD file, 2026-10-20]
downloads/step/DOCK-PIN-01.step
3.00 x 6.00 x 3.00 mm
