merlinwwu/voltra-i-ref-3d/downloads/step/LW-SPC-01.step

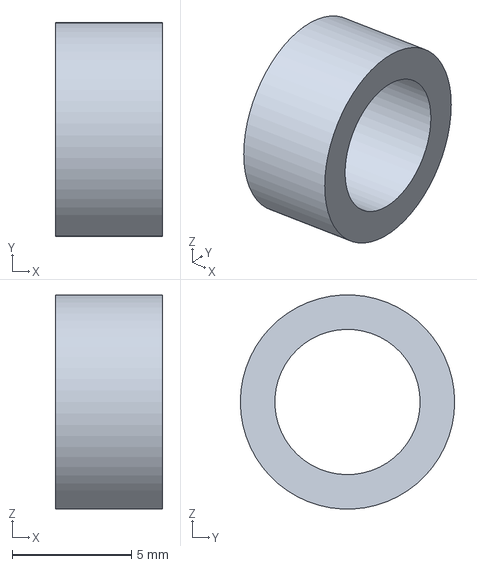
[picture p122: CAD file, 2026-10-20]
downloads/step/LW-SPC-01.step
4.50 x 9.00 x 8.99 mm
