merlinwwu/voltra-i-ref-3d/downloads/step/CLP-EXIT-01.step

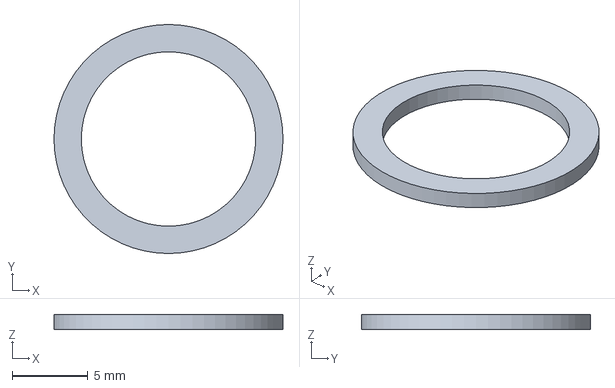
[picture p123: CAD file, 2026-10-20]
downloads/step/CLP-EXIT-01.step
15.1 x 15.1 x 1.00 mm
