merlinwwu/voltra-i-ref-3d/downloads/step/BAT-CONN-01.step

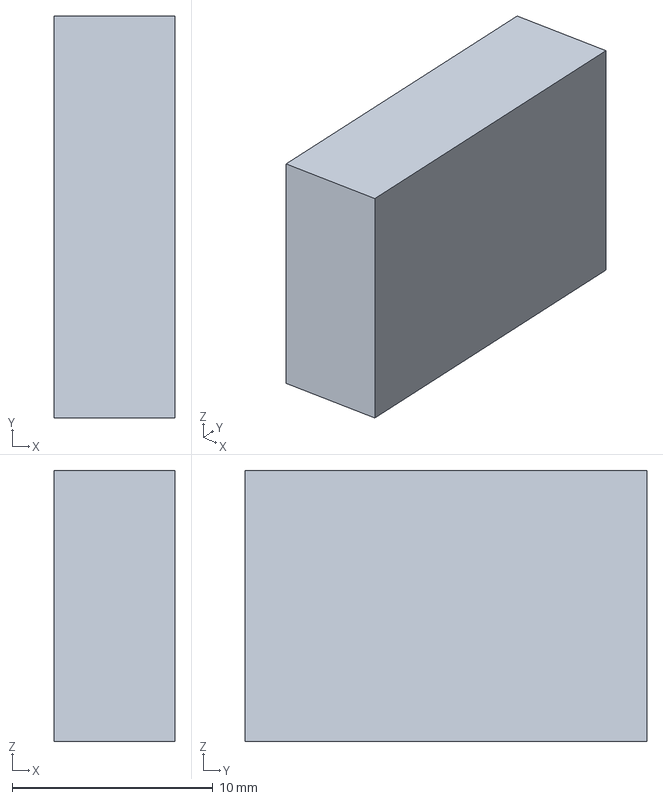
[picture p124: CAD file, 2026-10-20]
downloads/step/BAT-CONN-01.step
6.00 x 20.0 x 13.5 mm
