merlinwwu/voltra-i-ref-3d/downloads/step/BRK-TEMP-01.step

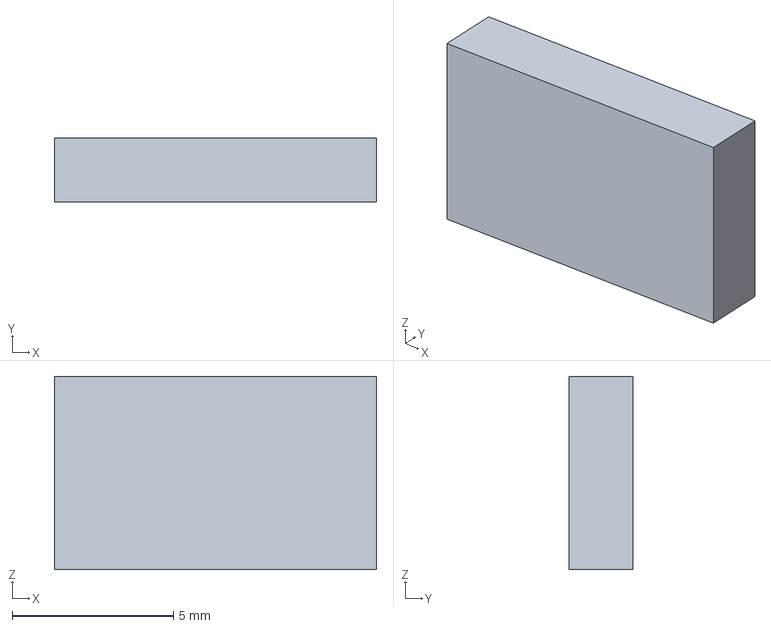
[picture p125: CAD file, 2026-10-20]
downloads/step/BRK-TEMP-01.step
10.0 x 2.00 x 6.00 mm
