merlinwwu/voltra-i-ref-3d/downloads/step/SCR-DRUM-01.step

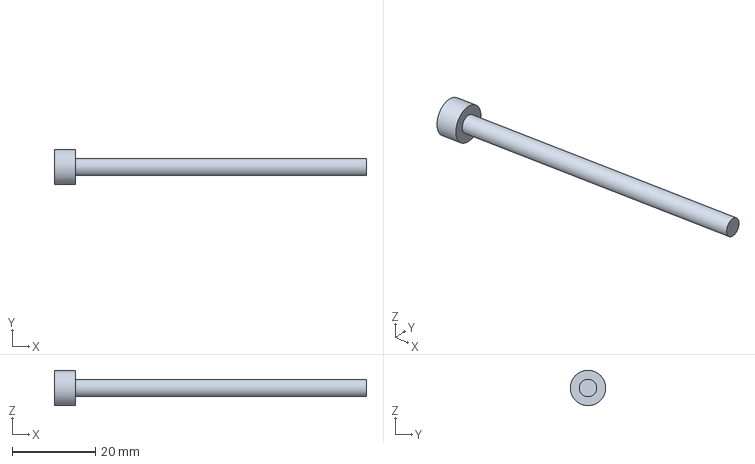
[picture p126: CAD file, 2026-10-20]
downloads/step/SCR-DRUM-01.step
75.0 x 8.50 x 8.49 mm
