merlinwwu/voltra-i-ref-3d/downloads/step/PIN-BRG-01.step

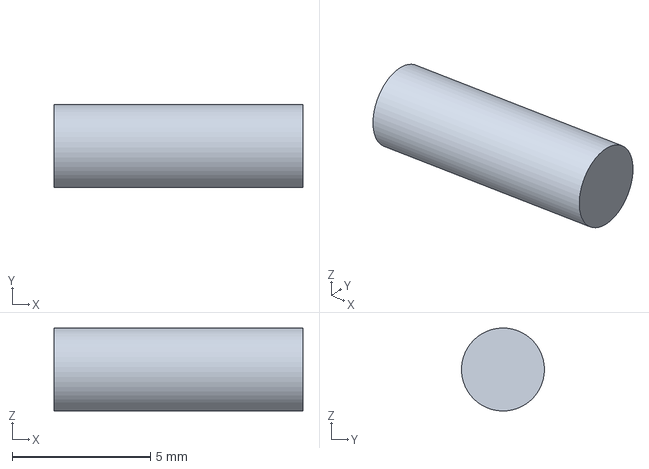
[picture p127: CAD file, 2026-10-20]
downloads/step/PIN-BRG-01.step
9.00 x 3.00 x 3.00 mm
