merlinwwu/voltra-i-ref-3d/downloads/step/EXIT-SHV-01.step

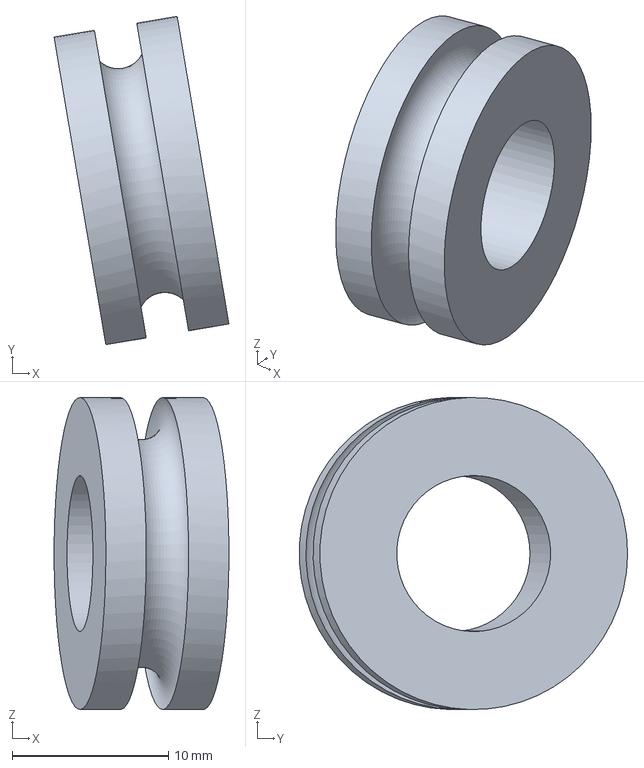
[picture p128: CAD file, 2026-10-20]
downloads/step/EXIT-SHV-01.step
11.2 x 21.0 x 20.0 mm
