merlinwwu/voltra-i-ref-3d/downloads/step/SCR-LWB-01.step

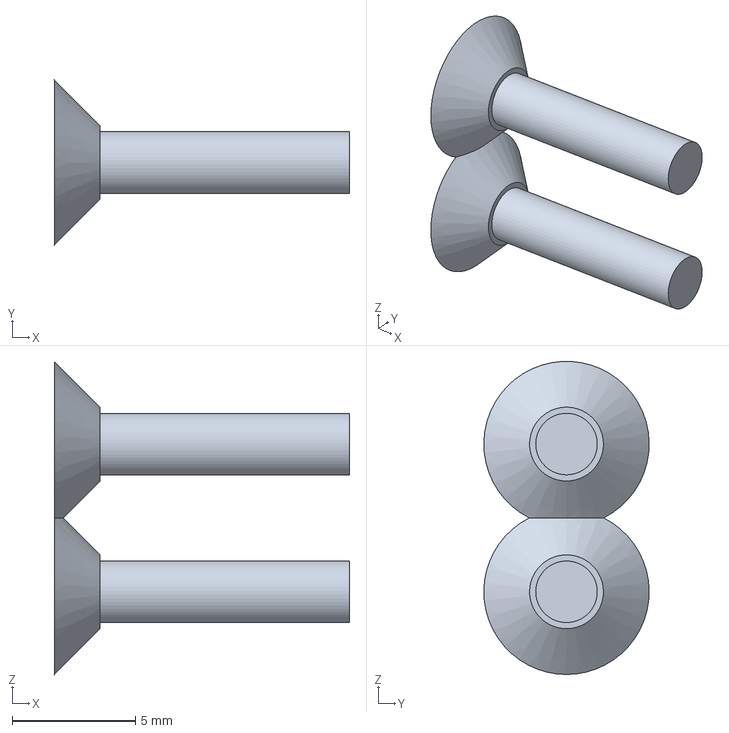
[picture p129: CAD file, 2026-10-20]
downloads/step/SCR-LWB-01.step
12.0 x 6.72 x 12.7 mm
