merlinwwu/voltra-i-ref-3d/downloads/step/LW-HALL-01.step

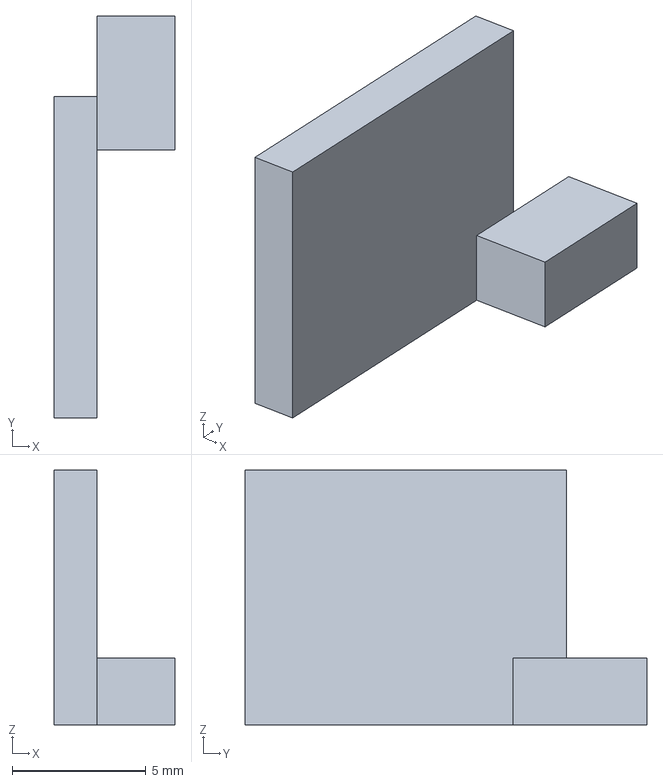
[picture p130: CAD file, 2026-10-20]
downloads/step/LW-HALL-01.step
4.50 x 15.0 x 9.50 mm
