merlinwwu/voltra-i-ref-3d/downloads/step/PCB-HS-01.step

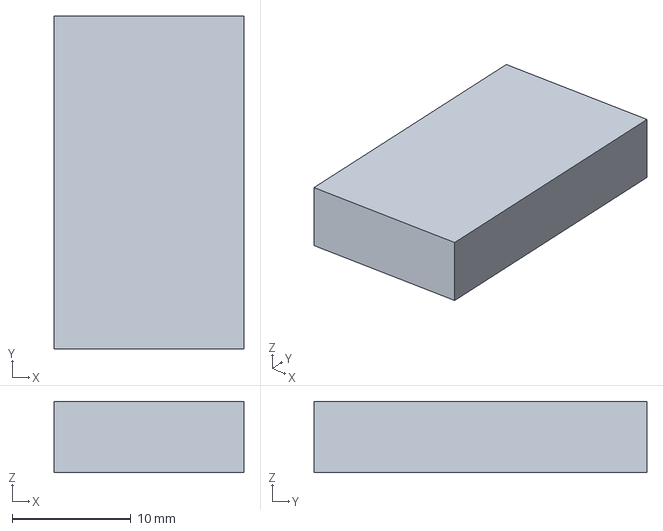
[picture p131: CAD file, 2026-10-20]
downloads/step/PCB-HS-01.step
16.0 x 28.0 x 6.00 mm
