merlinwwu/voltra-i-ref-3d/downloads/step/LW-WHEEL-01.step

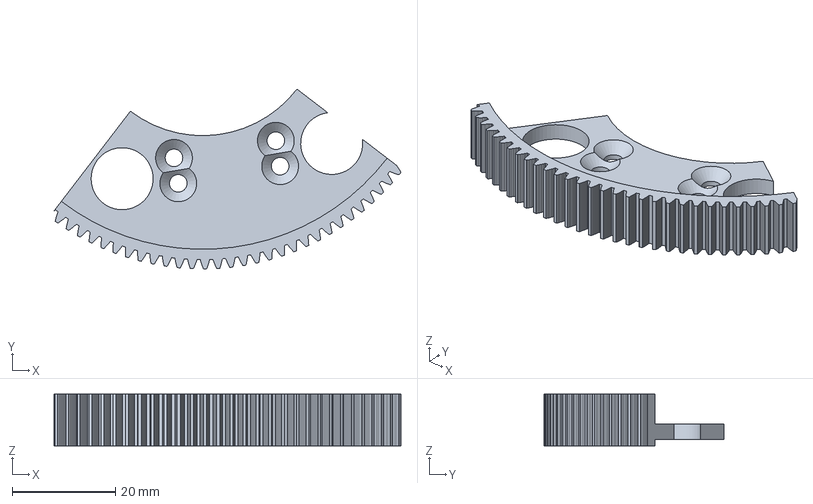
[picture p132: CAD file, 2026-10-20]
downloads/step/LW-WHEEL-01.step
67.2 x 34.8 x 10.00 mm
