merlinwwu/voltra-i-ref-3d/downloads/step/BAT-MOD-01.step

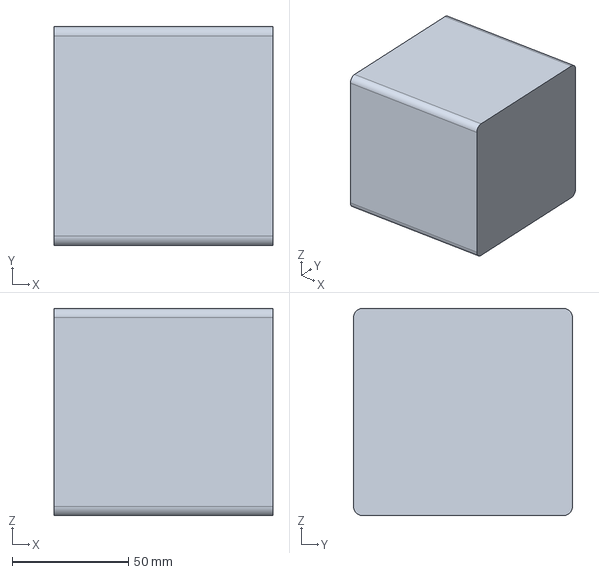
[picture p133: CAD file, 2026-10-20]
downloads/step/BAT-MOD-01.step
94.0 x 94.0 x 89.0 mm
