merlinwwu/voltra-i-ref-3d/downloads/step/SCR-PCB-01.step

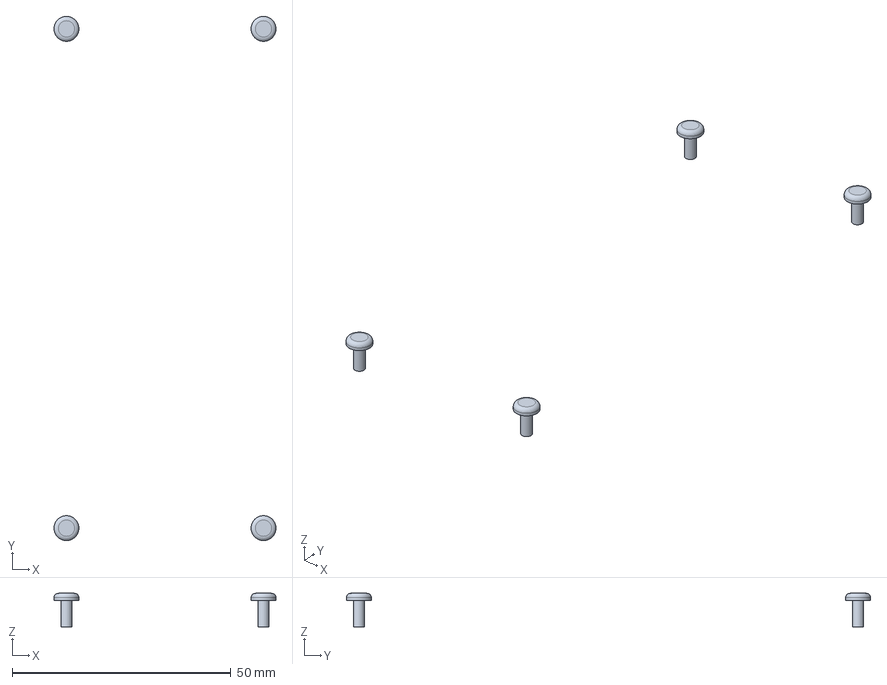
[picture p134: CAD file, 2026-10-20]
downloads/step/SCR-PCB-01.step
50.7 x 119.7 x 7.65 mm
