merlinwwu/voltra-i-ref-3d/downloads/step/PIN-HUB-01.step

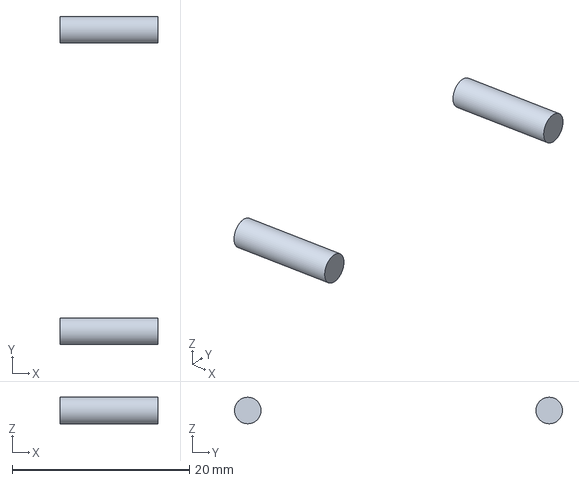
[picture p135: CAD file, 2026-10-20]
downloads/step/PIN-HUB-01.step
11.0 x 37.0 x 3.00 mm
