merlinwwu/voltra-i-ref-3d/downloads/step/EXIT-PIN-01.step

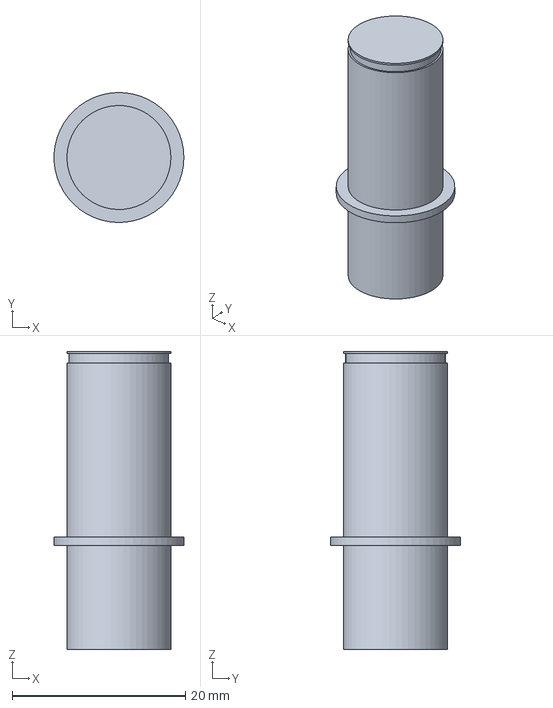
[picture p136: CAD file, 2026-10-20]
downloads/step/EXIT-PIN-01.step
15.0 x 15.0 x 34.4 mm
