merlinwwu/voltra-i-ref-3d/downloads/step/HSG-END-R-01.step

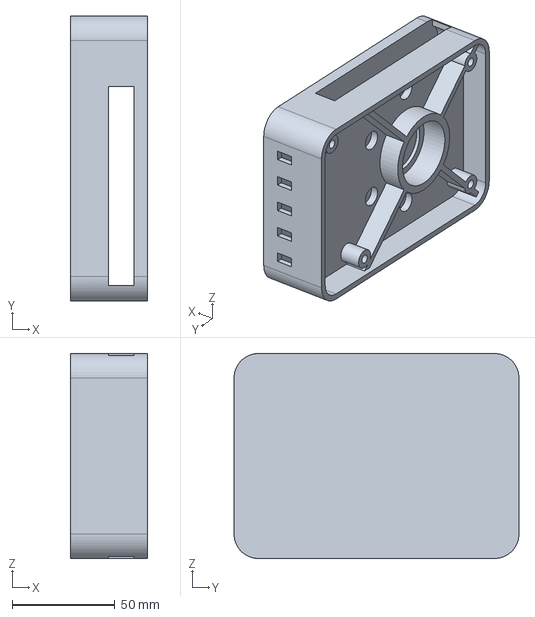
[picture p137: CAD file, 2026-10-20]
downloads/step/HSG-END-R-01.step
37.5 x 139.0 x 100.0 mm
