merlinwwu/voltra-i-ref-3d/downloads/step/LW-PIN-01.step

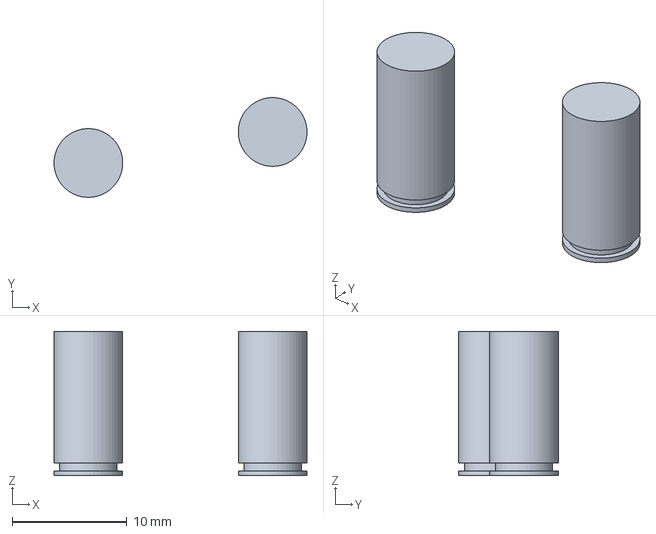
[picture p138: CAD file, 2026-10-20]
downloads/step/LW-PIN-01.step
22.1 x 8.70 x 12.6 mm
