merlinwwu/voltra-i-ref-3d/downloads/step/LW-WORM-01.step

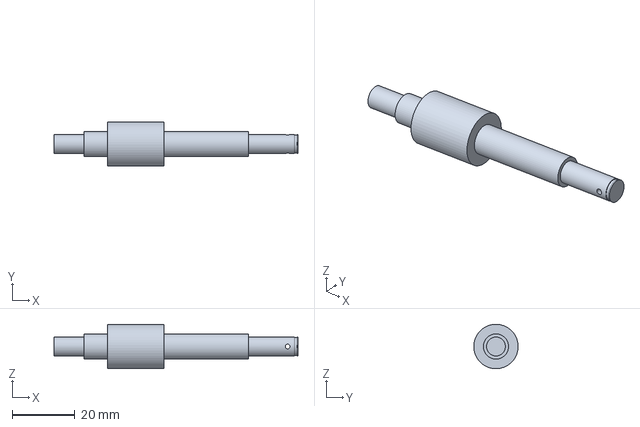
[picture p139: CAD file, 2026-10-20]
downloads/step/LW-WORM-01.step
77.6 x 14.1 x 14.1 mm
