merlinwwu/voltra-i-ref-3d/downloads/step/HSG-END-L-01.step

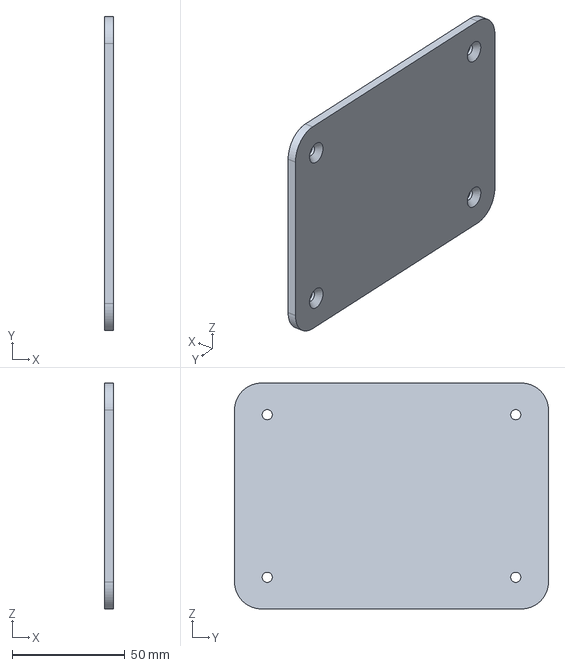
[picture p140: CAD file, 2026-10-20]
downloads/step/HSG-END-L-01.step
4.00 x 139.0 x 100.0 mm
