merlinwwu/voltra-i-ref-3d/downloads/step/SCR-BRK-01.step

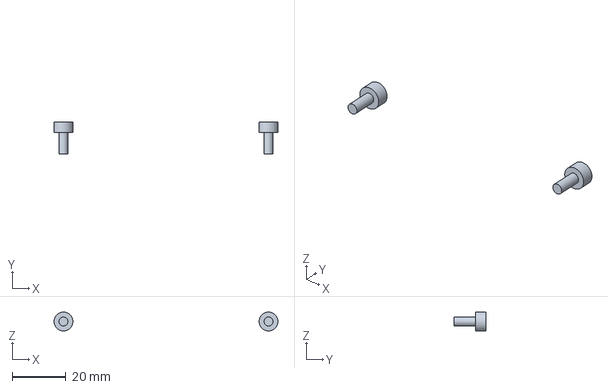
[picture p141: CAD file, 2026-10-20]
downloads/step/SCR-BRK-01.step
83.0 x 12.0 x 7.00 mm
