merlinwwu/voltra-i-ref-3d/downloads/step/SMART-LOCK-01.step

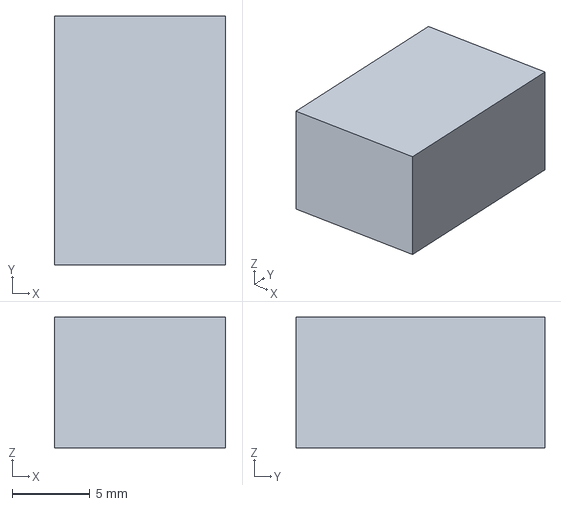
[picture p142: CAD file, 2026-10-20]
downloads/step/SMART-LOCK-01.step
11.0 x 16.0 x 8.40 mm
