merlinwwu/voltra-i-ref-3d/downloads/step/PIN-LWG-01.step

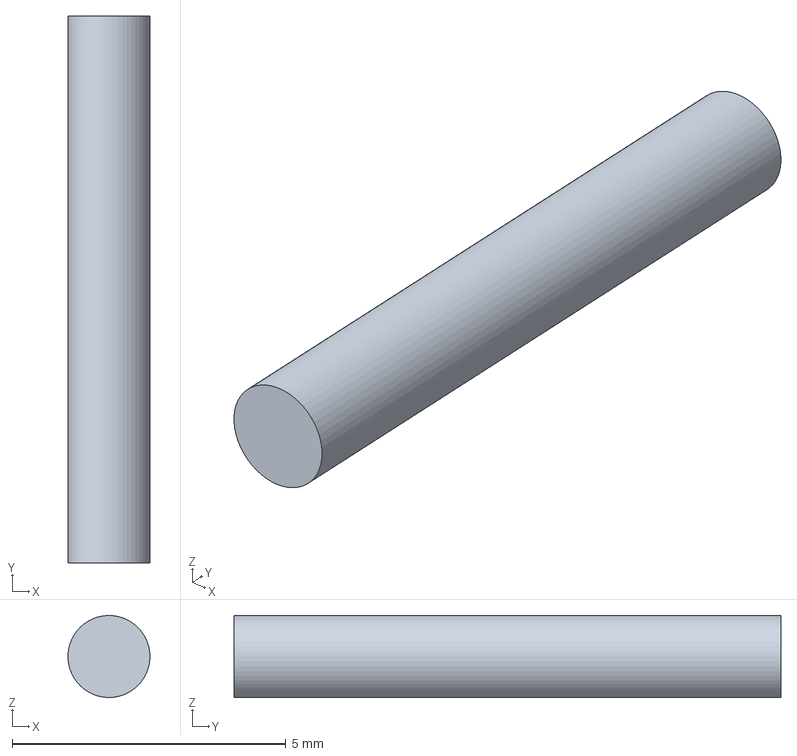
[picture p143: CAD file, 2026-10-20]
downloads/step/PIN-LWG-01.step
1.50 x 10.0 x 1.50 mm
