merlinwwu/voltra-i-ref-3d/downloads/step/BRK-PAD-01.step

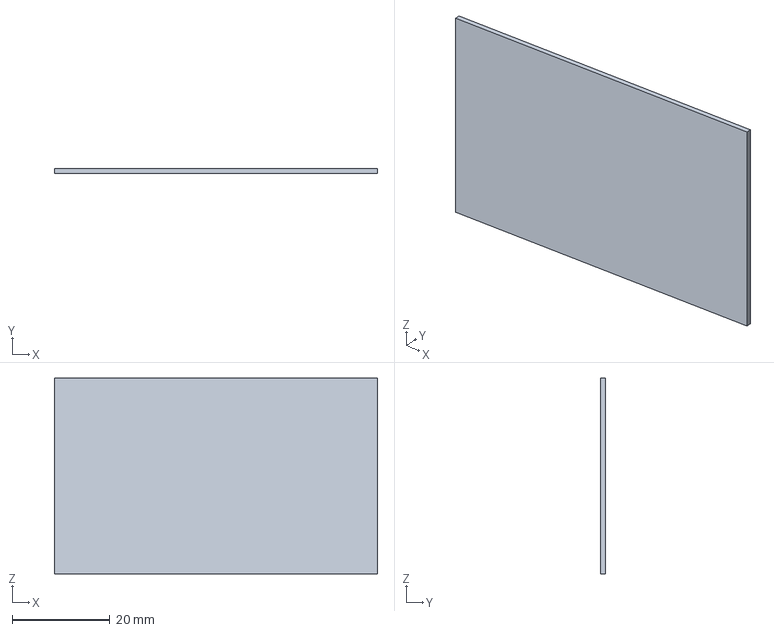
[picture p144: CAD file, 2026-10-20]
downloads/step/BRK-PAD-01.step
66.0 x 1.00 x 40.0 mm
