merlinwwu/voltra-i-ref-3d/downloads/step/BRG-03-HSG.step

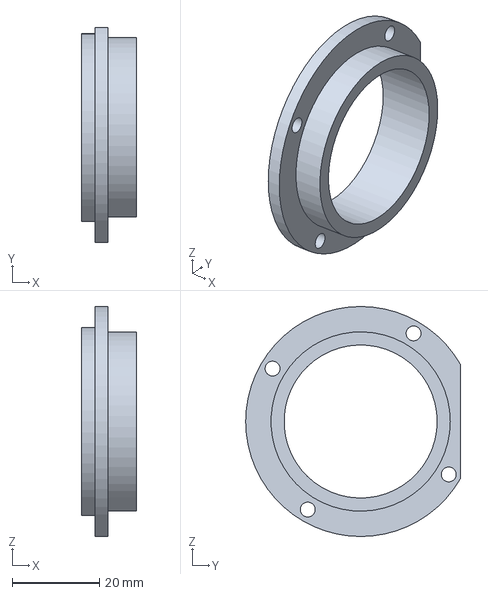
[picture p145: CAD file, 2026-10-20]
downloads/step/BRG-03-HSG.step
12.5 x 49.1 x 52.6 mm
