merlinwwu/voltra-i-ref-3d/downloads/step/MOT-STAT-01.step

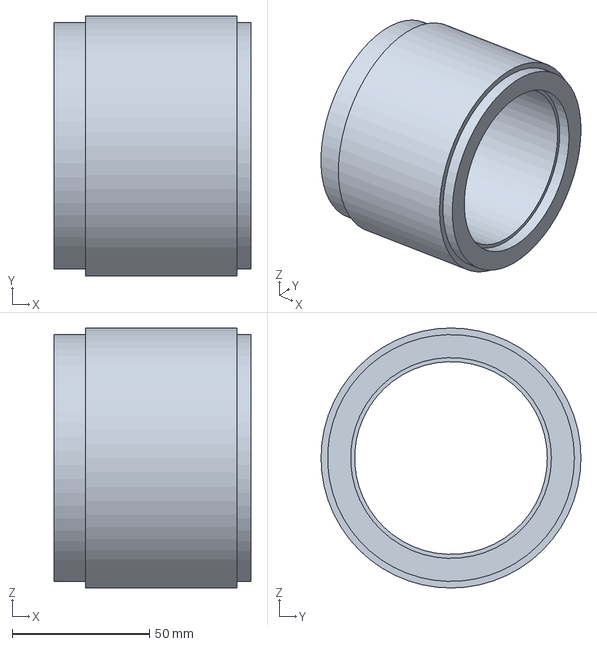
[picture p146: CAD file, 2026-10-20]
downloads/step/MOT-STAT-01.step
71.7 x 94.7 x 94.7 mm
