merlinwwu/voltra-i-ref-3d/downloads/step/CONN-01.step

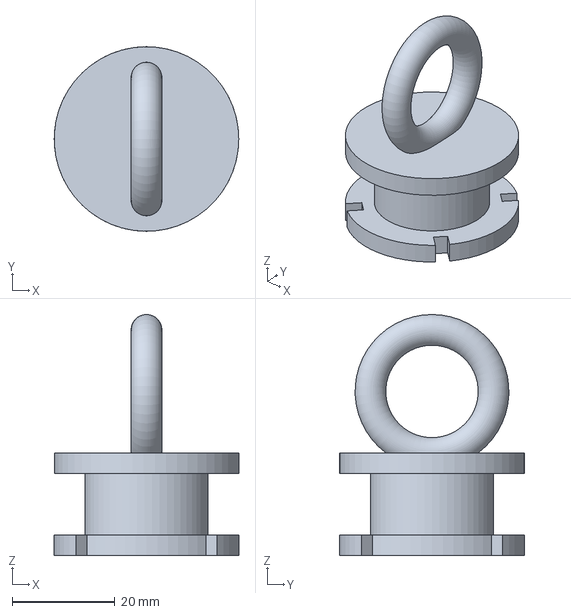
[picture p147: CAD file, 2026-10-20]
downloads/step/CONN-01.step
36.0 x 36.0 x 47.0 mm
