merlinwwu/voltra-i-ref-3d/downloads/step/ENC-MAG-01.step

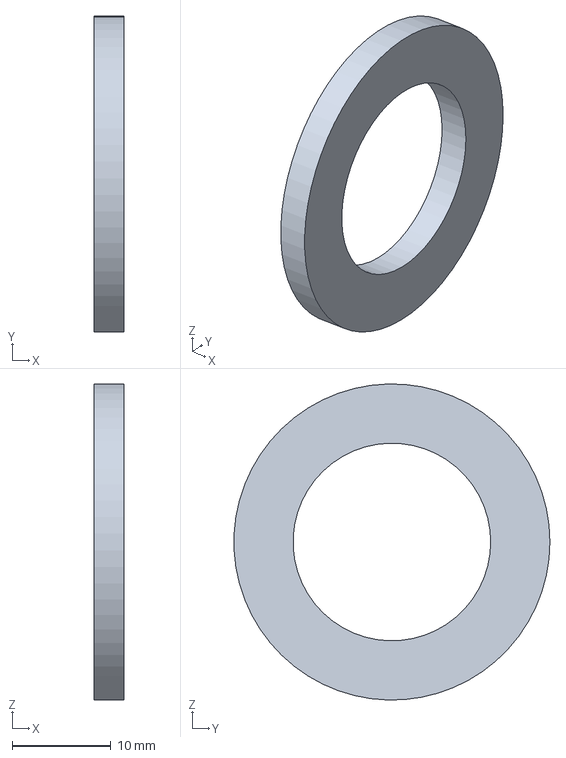
[picture p148: CAD file, 2026-10-20]
downloads/step/ENC-MAG-01.step
3.00 x 32.0 x 32.0 mm
