merlinwwu/voltra-i-ref-3d/downloads/step/LW-MAG-01.step

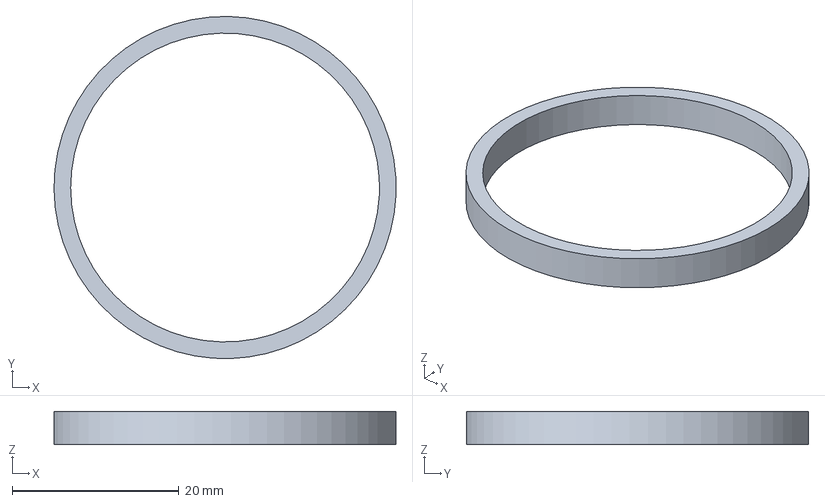
[picture p149: CAD file, 2026-10-20]
downloads/step/LW-MAG-01.step
41.0 x 41.0 x 4.00 mm
