merlinwwu/voltra-i-ref-3d/downloads/step/LW-IDL-BUSH-01.step

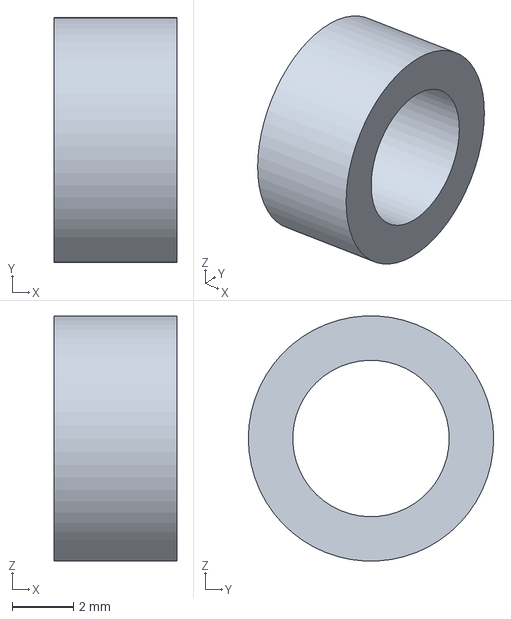
[picture p150: CAD file, 2026-10-20]
downloads/step/LW-IDL-BUSH-01.step
4.00 x 8.00 x 7.99 mm
