merlinwwu/voltra-i-ref-3d/downloads/step/CABLE-01.step

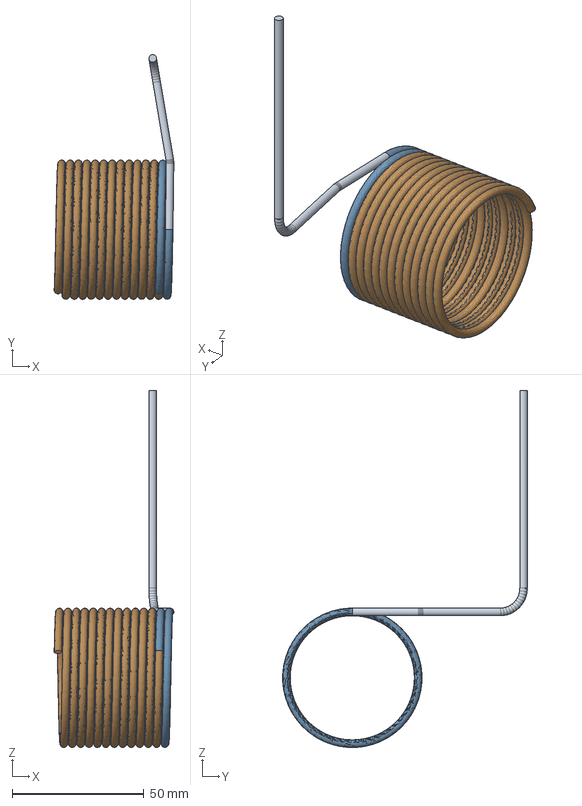
[picture p151: CAD file, 2026-10-20]
downloads/step/CABLE-01.step
45.4 x 92.9 x 135.4 mm
