merlinwwu/voltra-i-ref-3d/downloads/step/LW-GEAR-01.step

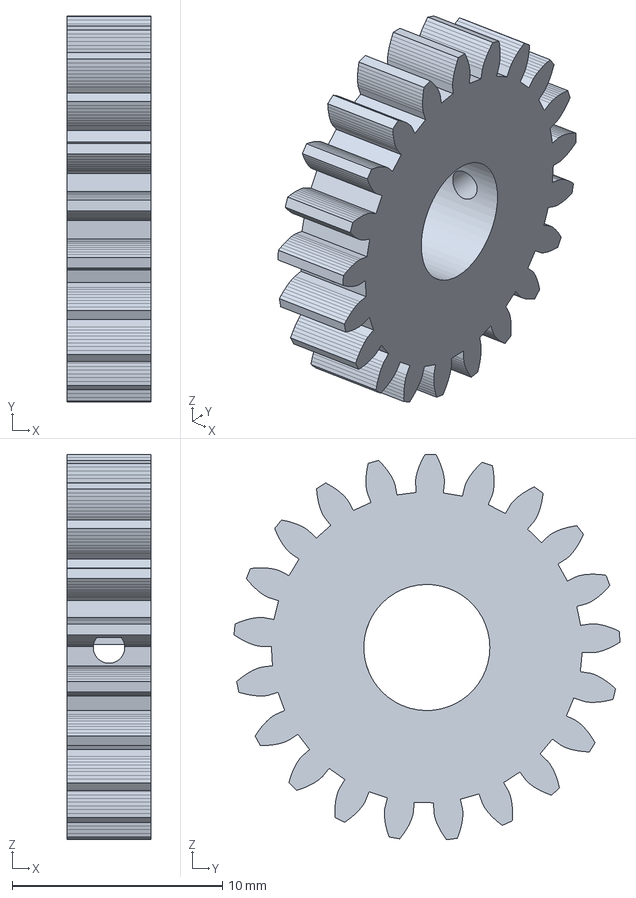
[picture p152: CAD file, 2026-10-20]
downloads/step/LW-GEAR-01.step
4.00 x 18.4 x 18.4 mm
