merlinwwu/voltra-i-ref-3d/downloads/step/SCR-CLAMP-01.step

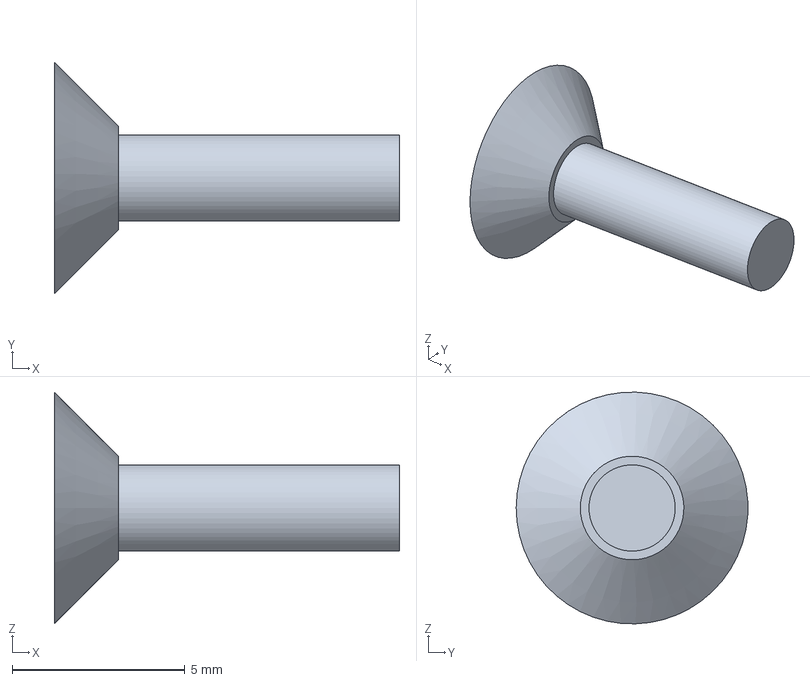
[picture p153: CAD file, 2026-10-20]
downloads/step/SCR-CLAMP-01.step
10.0 x 6.71 x 6.72 mm
