merlinwwu/voltra-i-ref-3d/downloads/step/BRK-R-01.step

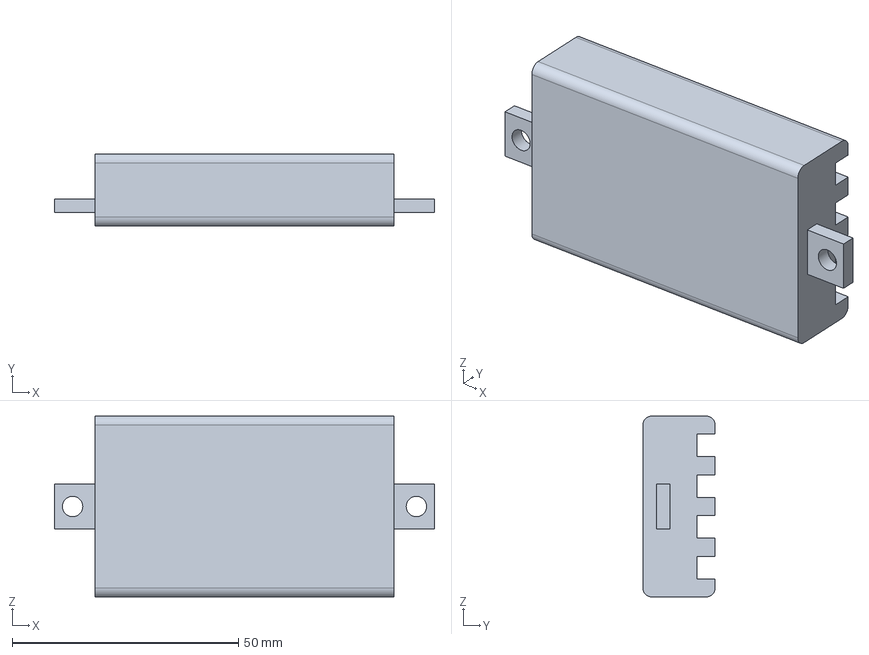
[picture p154: CAD file, 2026-10-20]
downloads/step/BRK-R-01.step
84.0 x 16.0 x 40.0 mm
