merlinwwu/voltra-i-ref-3d/downloads/step/EXIT-UNI-01.step

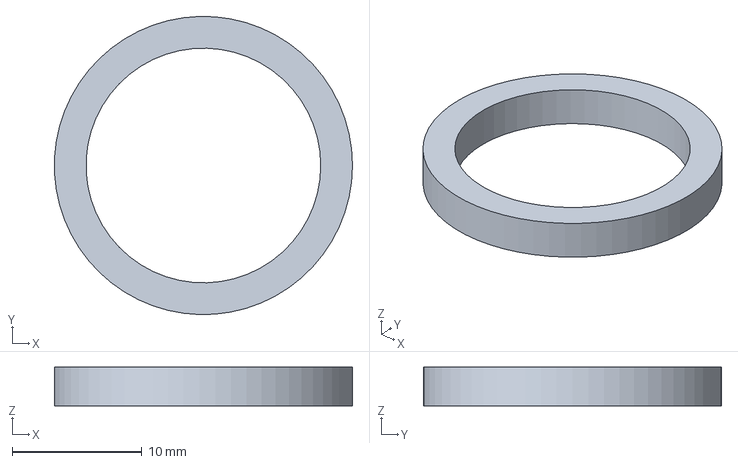
[picture p155: CAD file, 2026-10-20]
downloads/step/EXIT-UNI-01.step
23.0 x 23.0 x 3.00 mm
