merlinwwu/voltra-i-ref-3d/downloads/step/EXIT-SWV-01.step

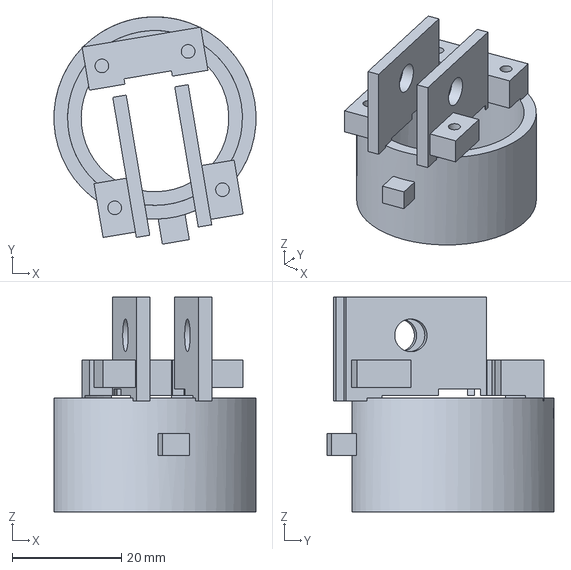
[picture p156: CAD file, 2026-10-20]
downloads/step/EXIT-SWV-01.step
37.0 x 41.6 x 39.3 mm
