merlinwwu/voltra-i-ref-3d/downloads/step/PCB-TIM-01.step

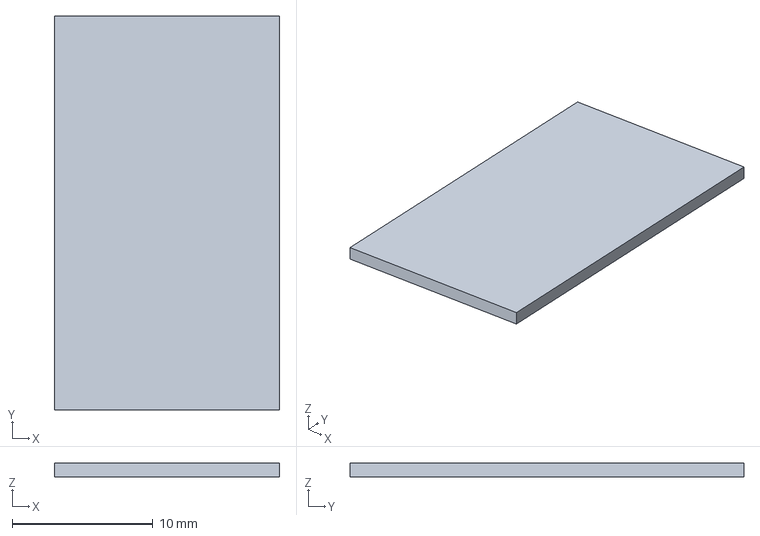
[picture p157: CAD file, 2026-10-20]
downloads/step/PCB-TIM-01.step
16.0 x 28.0 x 1.00 mm
