merlinwwu/voltra-i-ref-3d/downloads/step/LW-IDL-PIN-01.step

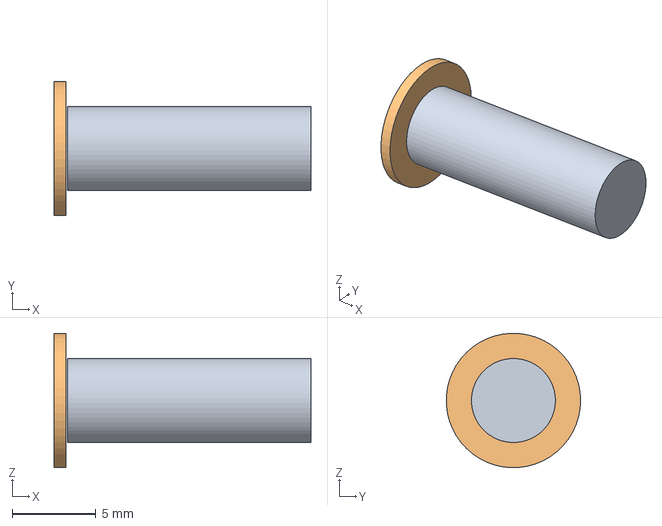
[picture p158: CAD file, 2026-10-20]
downloads/step/LW-IDL-PIN-01.step
15.3 x 7.99 x 8.00 mm
