merlinwwu/voltra-i-ref-3d/downloads/step/CLP-BRG01.step

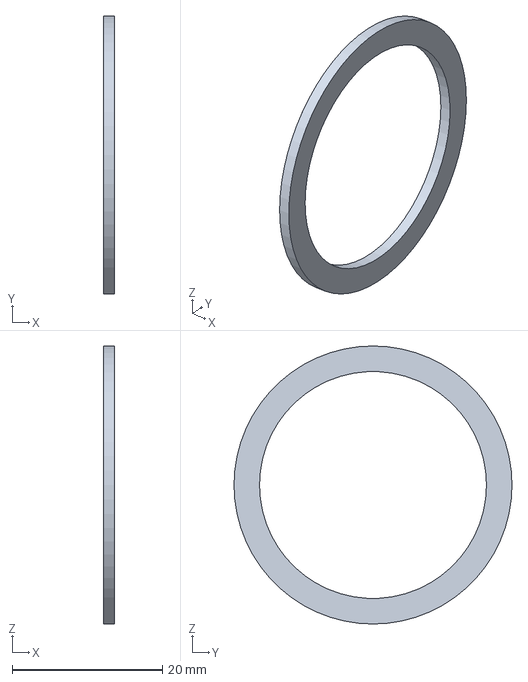
[picture p159: CAD file, 2026-10-20]
downloads/step/CLP-BRG01.step
1.50 x 37.0 x 37.0 mm
