merlinwwu/voltra-i-ref-3d/downloads/step/LW-NDL-02.step

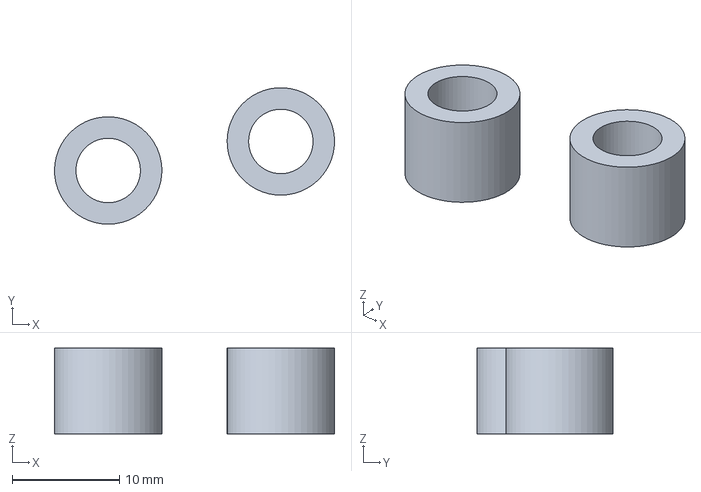
[picture p160: CAD file, 2026-10-20]
downloads/step/LW-NDL-02.step
26.1 x 12.7 x 8.00 mm
