merlinwwu/voltra-i-ref-3d/downloads/step/DRUM-CLAMP-01.step

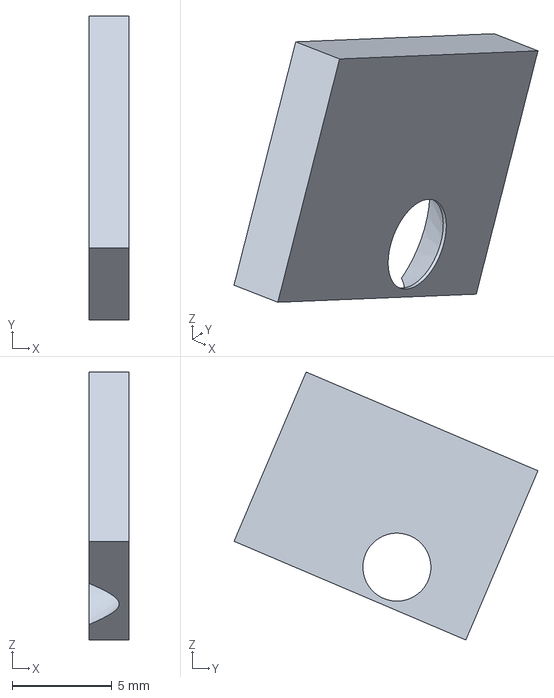
[picture p161: CAD file, 2026-10-20]
downloads/step/DRUM-CLAMP-01.step
2.00 x 15.2 x 13.4 mm
