merlinwwu/voltra-i-ref-3d/downloads/step/DOCK-HOOK-01.step

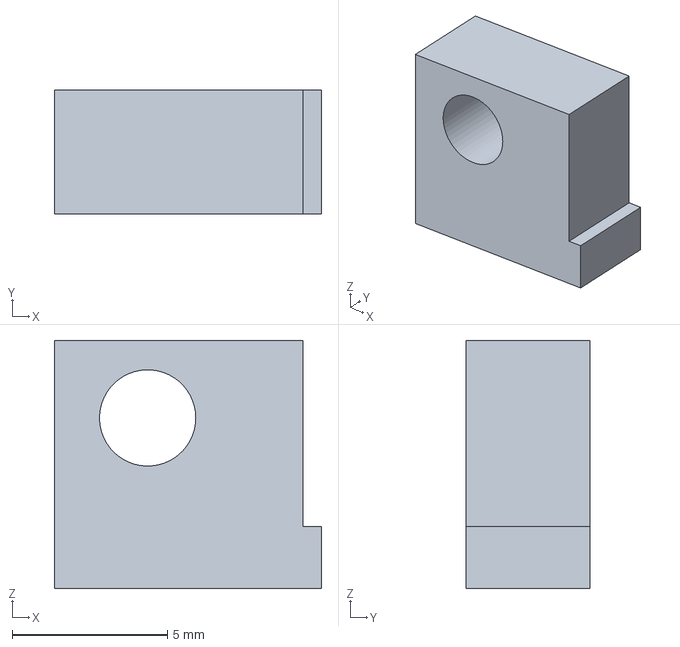
[picture p162: CAD file, 2026-10-20]
downloads/step/DOCK-HOOK-01.step
8.60 x 4.00 x 8.00 mm
