merlinwwu/voltra-i-ref-3d/downloads/step/CLP-LW-02.step

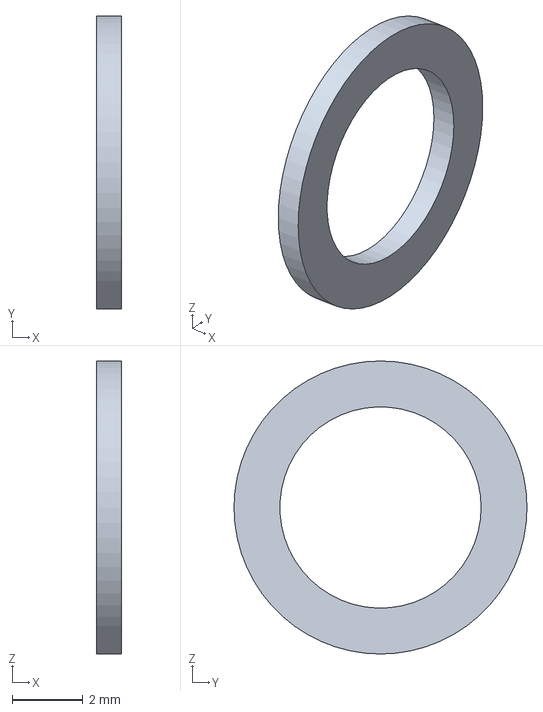
[picture p163: CAD file, 2026-10-20]
downloads/step/CLP-LW-02.step
0.7 x 8.30 x 8.30 mm
