merlinwwu/voltra-i-ref-3d/downloads/step/LW-ARM-01.step

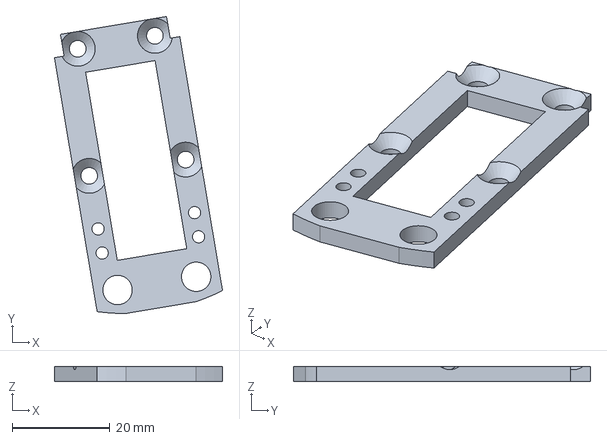
[picture p164: CAD file, 2026-10-20]
downloads/step/LW-ARM-01.step
34.4 x 60.7 x 3.00 mm
