merlinwwu/voltra-i-ref-3d/downloads/step/MOT-HSG-01.step

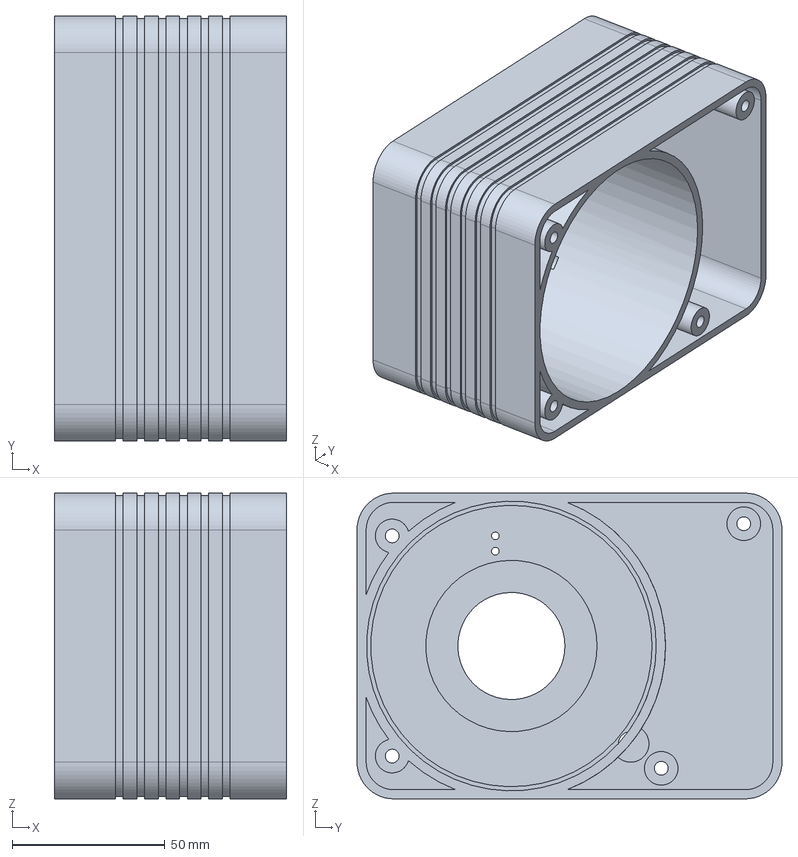
[picture p165: CAD file, 2026-10-20]
downloads/step/MOT-HSG-01.step
76.0 x 139.0 x 100.0 mm
