merlinwwu/voltra-i-ref-3d/downloads/step/LW-IDL-01.step

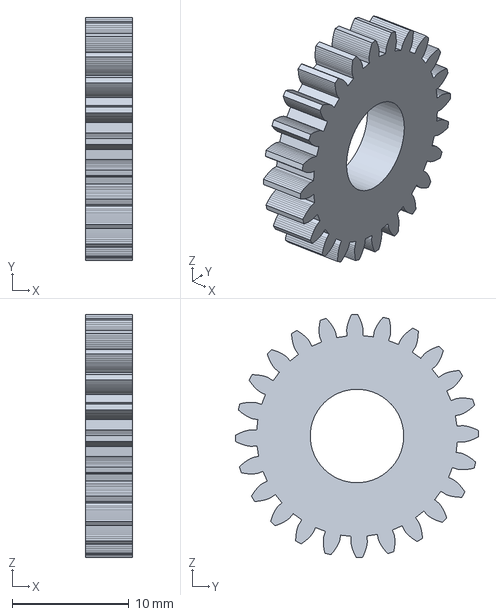
[picture p166: CAD file, 2026-10-20]
downloads/step/LW-IDL-01.step
4.00 x 20.8 x 20.8 mm
