merlinwwu/voltra-i-ref-3d/downloads/step/SPC-BRG01.step

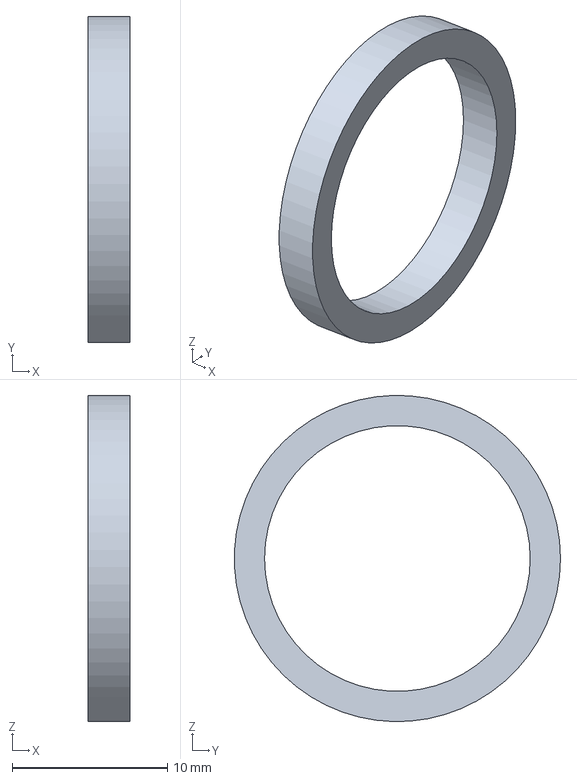
[picture p167: CAD file, 2026-10-20]
downloads/step/SPC-BRG01.step
2.70 x 21.0 x 21.0 mm
