merlinwwu/voltra-i-ref-3d/(list of files, cad)

Other CAD files:
downloads/step/BRG-03.step
downloads/step/BRG-02.step
downloads/step/EXIT-BRG-02.step
downloads/step/CLP-BRG02.step
downloads/step/MOT-GROM-01.step
downloads/step/BOLT-TIE-01.step
downloads/stl/BAT-CONN-01.stl
downloads/stl/BAT-MOD-01.stl
downloads/stl/BOLT-TIE-01.stl
downloads/stl/BRG-01.stl
downloads/stl/BRG-02.stl
downloads/stl/BRG-03-HSG.stl
downloads/stl/BRG-03.stl
downloads/stl/BRK-PAD-01.stl
downloads/stl/BRK-R-01.stl
downloads/stl/BRK-TEMP-01.stl
downloads/stl/CABLE-01.stl
downloads/stl/CLP-BRG01.stl
downloads/stl/CLP-BRG02.stl
downloads/stl/CLP-BRG03.stl
downloads/stl/CLP-EXIT-01.stl
downloads/stl/CLP-LW-01.stl
downloads/stl/CLP-LW-02.stl
downloads/stl/CONN-01.stl
downloads/stl/DOCK-HOOK-01.stl
downloads/stl/DOCK-IF-01.stl
downloads/stl/DOCK-PIN-01.stl
downloads/stl/DRUM-01.stl
downloads/stl/DRUM-CLAMP-01.stl
downloads/stl/DRUM-HUB-01.stl
downloads/stl/ENC-MAG-01.stl
downloads/stl/ENC-PCB-01.stl
downloads/stl/EXIT-AXL-01.stl
downloads/stl/EXIT-BASE-01.stl
downloads/stl/EXIT-BRG-01.stl
downloads/stl/EXIT-BRG-02.stl
downloads/stl/EXIT-GUIDE-01.stl
downloads/stl/EXIT-NDL-01.stl
downloads/stl/EXIT-PIN-01.stl
downloads/stl/EXIT-SHV-01.stl
downloads/stl/EXIT-SWV-01.stl
downloads/stl/EXIT-UNI-01.stl
downloads/stl/HSG-END-L-01.stl
downloads/stl/HSG-END-R-01.stl
downloads/stl/HSG-FRAME-01.stl
downloads/stl/HSG-MAIN-01-LWR.stl
downloads/stl/HSG-MAIN-01-UPR.stl
downloads/stl/LBL-SAFETY-01.stl
downloads/stl/LCD-01.stl
downloads/stl/LW-ARM-01.stl
downloads/stl/LW-BOX-01.stl
downloads/stl/LW-BRG-01.stl
downloads/stl/LW-BRIDGE-01.stl
downloads/stl/LW-GEAR-01.stl
downloads/stl/LW-HALL-01.stl
downloads/stl/LW-IDL-01.stl
downloads/stl/LW-IDL-BUSH-01.stl
downloads/stl/LW-IDL-PIN-01.stl
downloads/stl/LW-LIMIT-01.stl
downloads/stl/LW-MAG-01.stl
downloads/stl/LW-NDL-01.stl
downloads/stl/LW-NDL-02.stl
downloads/stl/LW-PIN-01.stl
downloads/stl/LW-ROL-01.stl
downloads/stl/LW-SPC-01.stl
downloads/stl/LW-WHEEL-01.stl
downloads/stl/LW-WORM-01.stl
downloads/stl/MOD-UNK-01.stl
downloads/stl/MOT-GROM-01.stl
downloads/stl/MOT-HSG-01.stl
downloads/stl/MOT-SHAFT-01.stl
downloads/stl/MOT-STAT-01.stl
downloads/stl/PCB-HS-01.stl
downloads/stl/PCB-MAIN-01.stl
downloads/stl/PCB-TIM-01.stl
downloads/stl/PIN-BRG-01.stl
downloads/stl/PIN-DRUM-01.stl
downloads/stl/PIN-HUB-01.stl
downloads/stl/PIN-LWB-01.stl
downloads/stl/PIN-LWG-01.stl
downloads/stl/ROT-01.stl
downloads/stl/ROT-HUB-01.stl
downloads/stl/SCR-BRG03-01.stl
downloads/stl/SCR-BRIDGE-01.stl
downloads/stl/SCR-BRK-01.stl
downloads/stl/SCR-CLAMP-01.stl
downloads/stl/SCR-DOCK-01.stl
downloads/stl/SCR-DRUM-01.stl
downloads/stl/SCR-END-L-01.stl
downloads/stl/SCR-EXIT-01.stl
downloads/stl/SCR-HUB-01.stl
downloads/stl/SCR-LWA-01.stl
downloads/stl/SCR-LWB-01.stl
downloads/stl/SCR-LWB-02.stl
downloads/stl/SCR-LWW-01.stl
downloads/stl/SCR-PCB-01.stl
downloads/stl/SMART-LOCK-01.stl
downloads/stl/SPC-BRG01.stl
downloads/stl/WSPR-BRG02.stl
