merlinwwu/voltra-i-ref-3d/downloads/drawings/ASSY-01-BOM-1.pdf

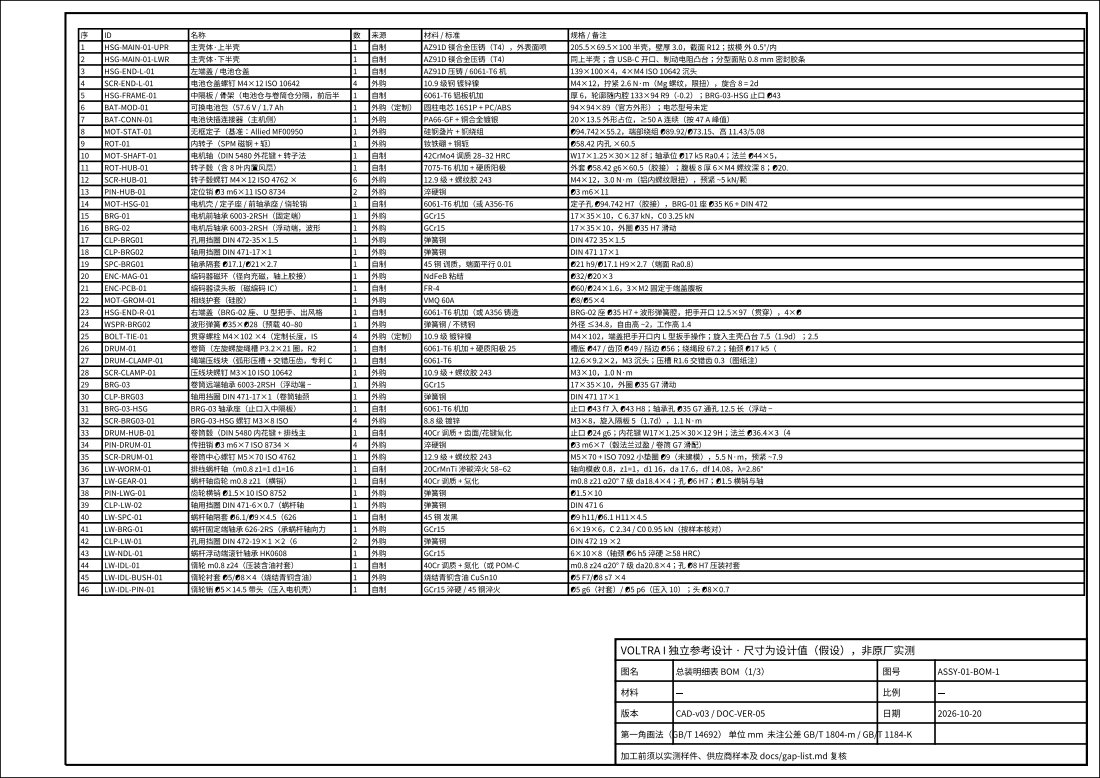
[picture p168: page 1]
