merlinwwu/voltra-i-ref-3d/downloads/drawings/ASSY-01-BOM-2.pdf

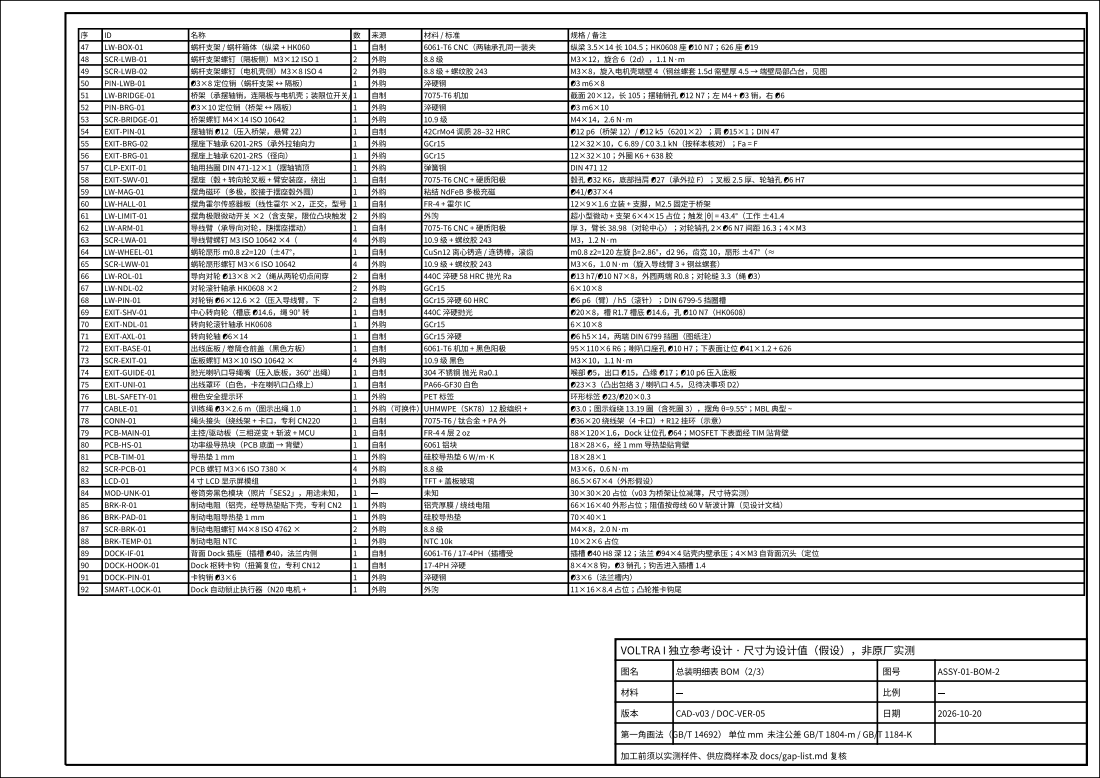
[picture p169: page 1]
