merlinwwu/voltra-i-ref-3d/downloads/drawings/ASSY-01-BOM-3.pdf

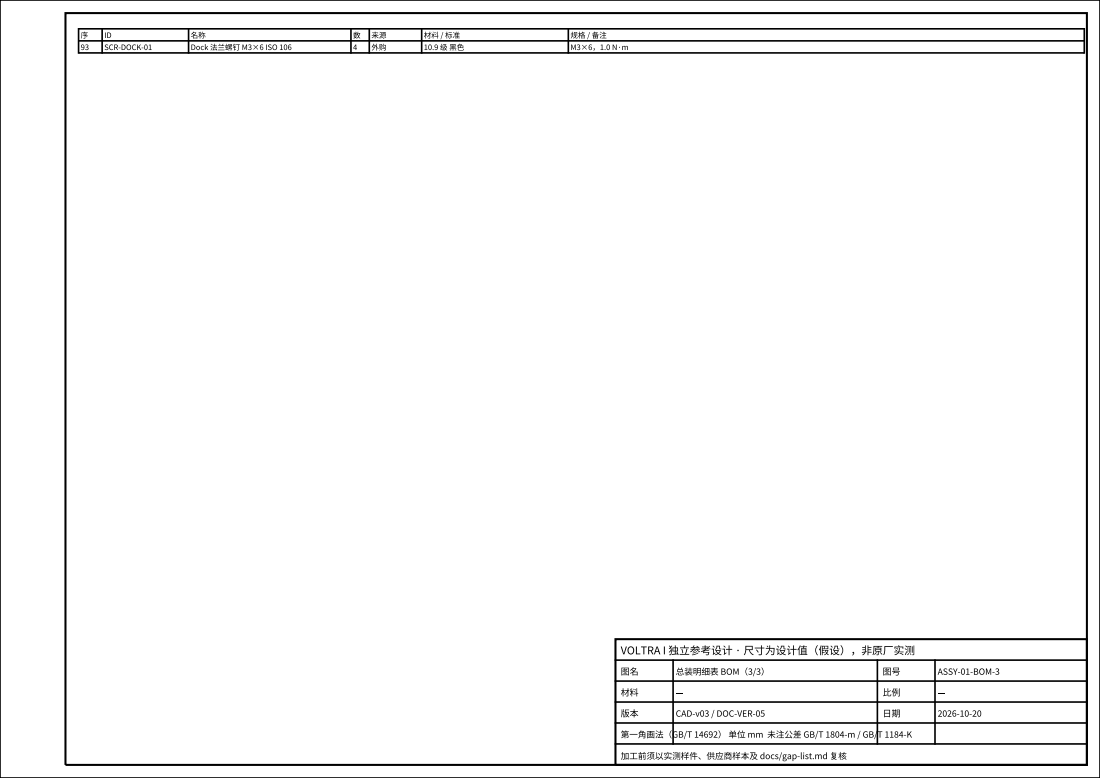
[picture p170: page 1]
