merlinwwu/voltra-i-ref-3d/downloads/drawings/EXIT-GUIDE-01.pdf

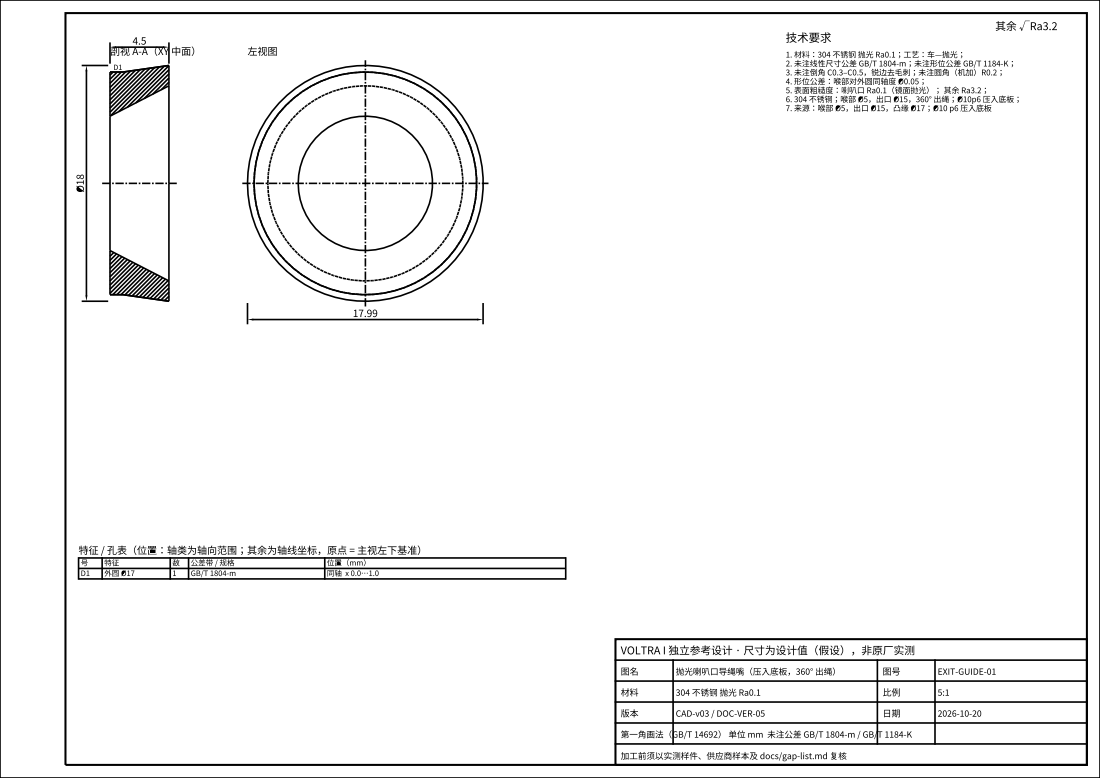
[picture p171: page 1]
