merlinwwu/voltra-i-ref-3d/downloads/drawings/ASSY-01-A.pdf

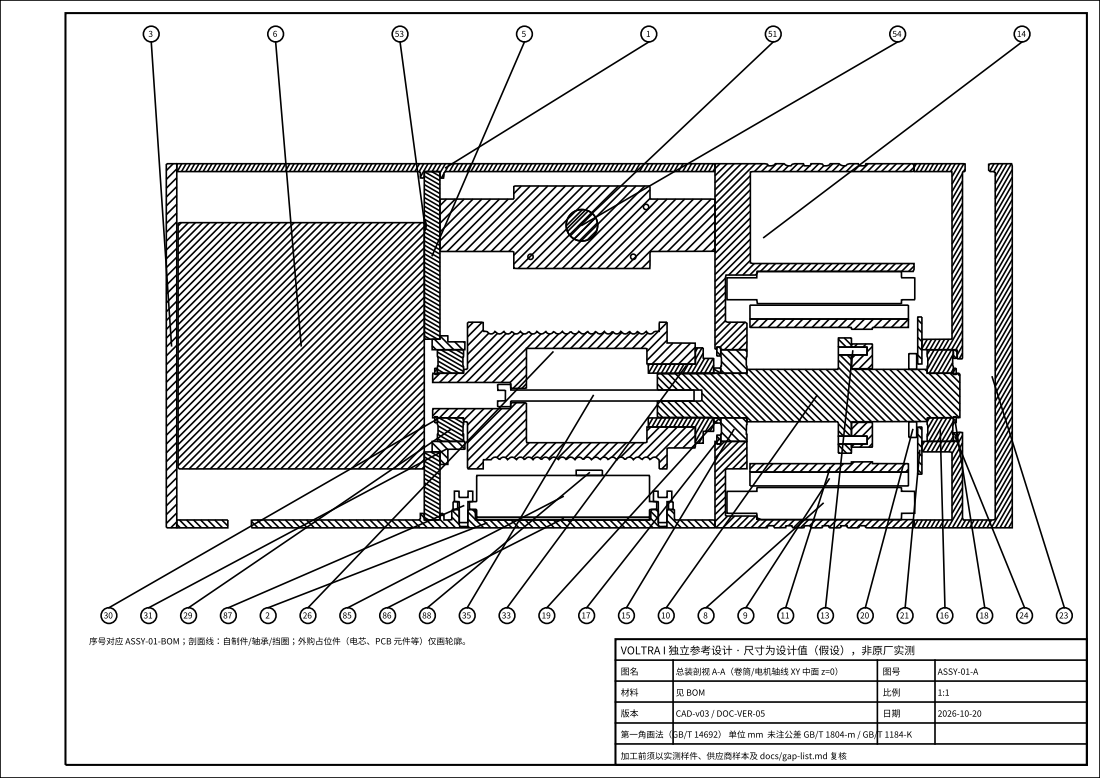
[picture p172: page 1]
