merlinwwu/voltra-i-ref-3d/downloads/drawings/ASSY-01-B.pdf

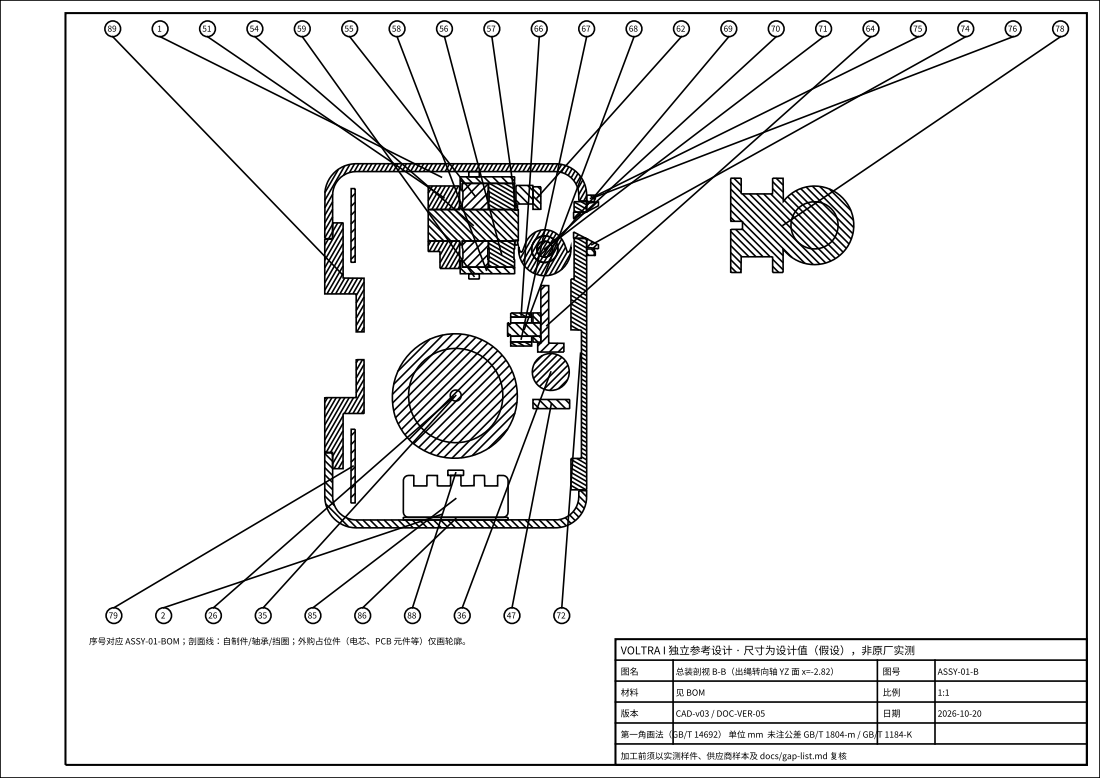
[picture p173: page 1]
