merlinwwu/voltra-i-ref-3d/downloads/drawings/BRG-03-HSG.pdf

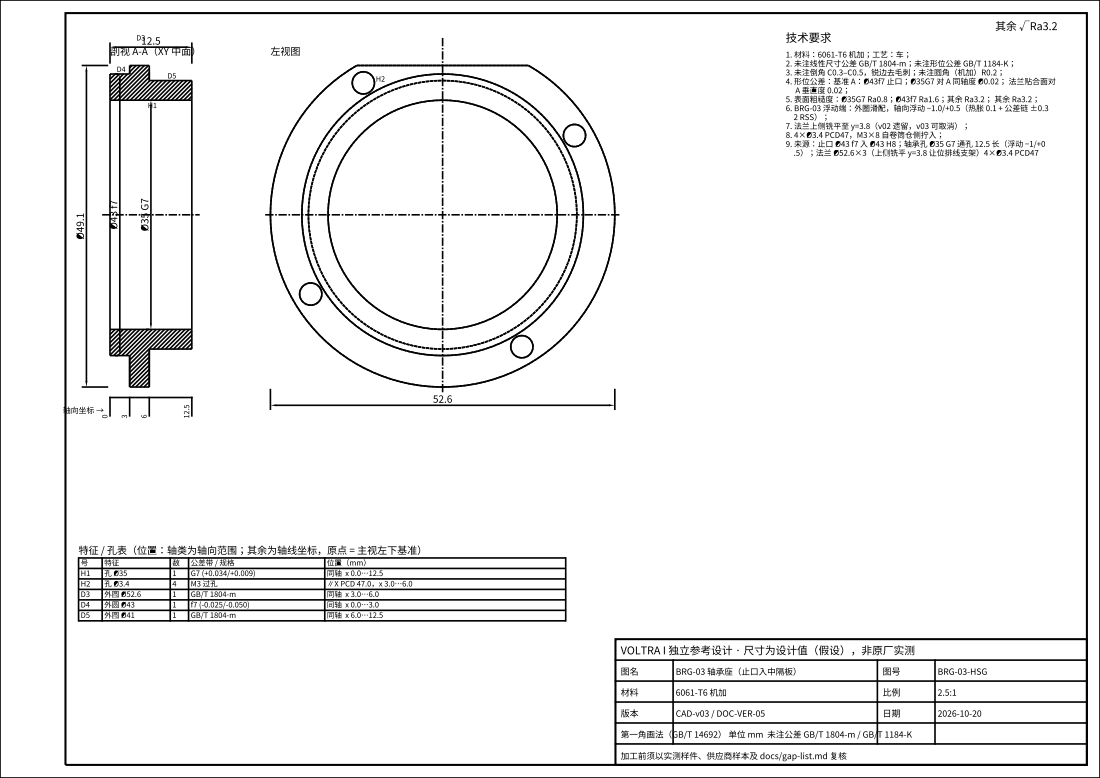
[picture p174: page 1]
