merlinwwu/voltra-i-ref-3d/downloads/drawings/CONN-01.pdf

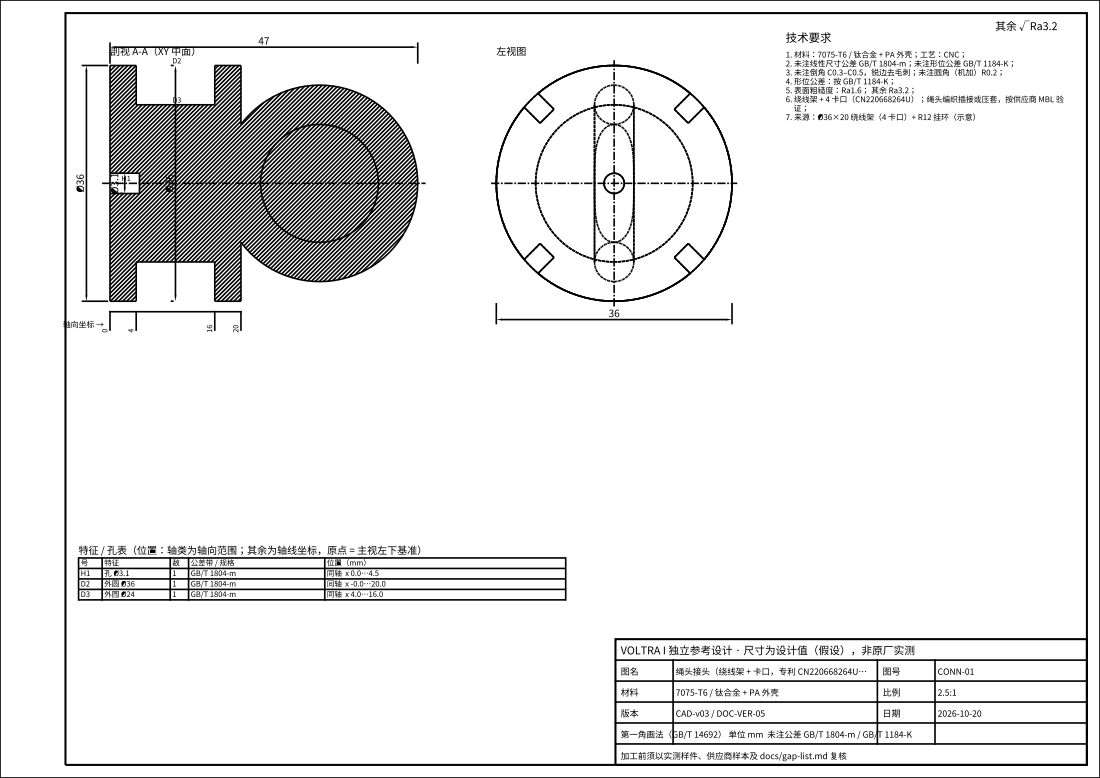
[picture p175: page 1]
