merlinwwu/voltra-i-ref-3d/downloads/drawings/DOCK-HOOK-01.pdf

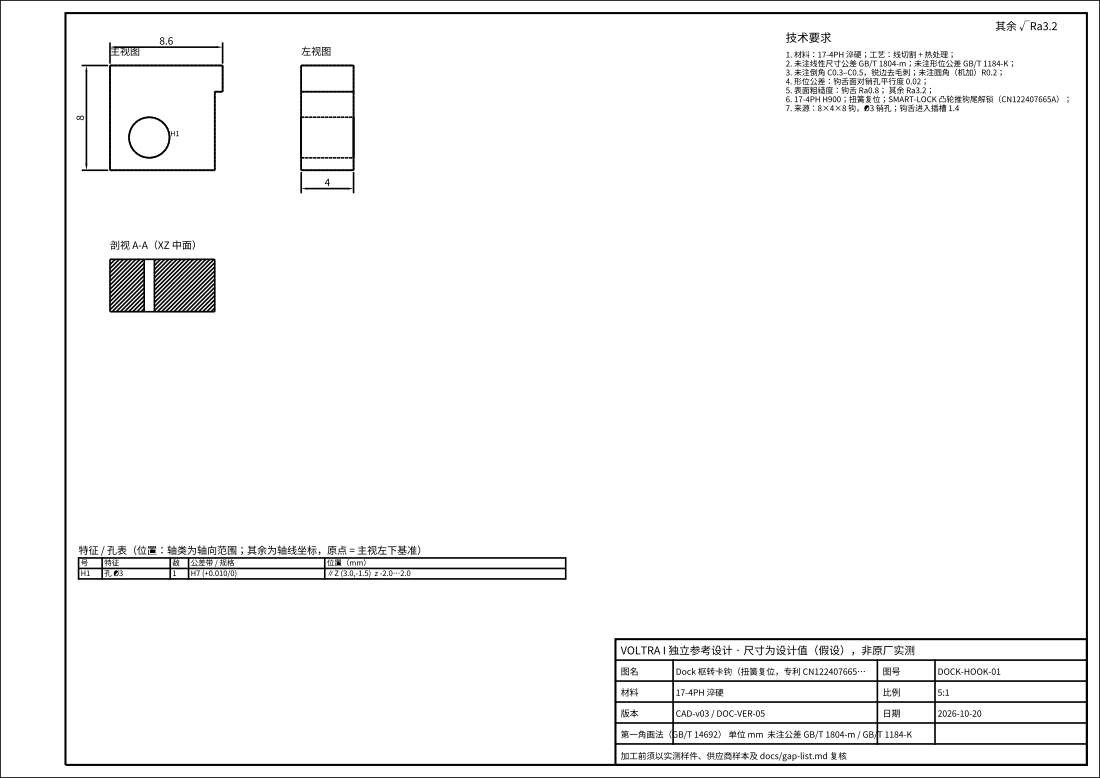
[picture p176: page 1]
