merlinwwu/voltra-i-ref-3d/downloads/drawings/DOCK-IF-01.pdf

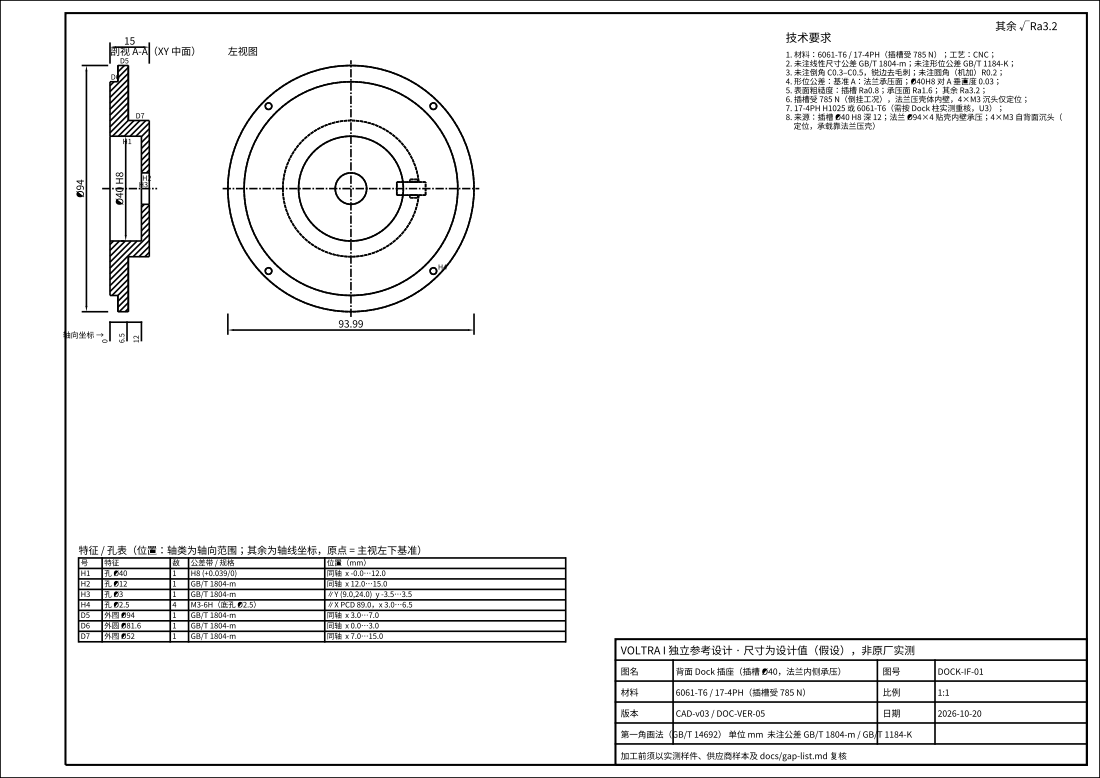
[picture p177: page 1]
