merlinwwu/voltra-i-ref-3d/downloads/drawings/DRUM-01.pdf

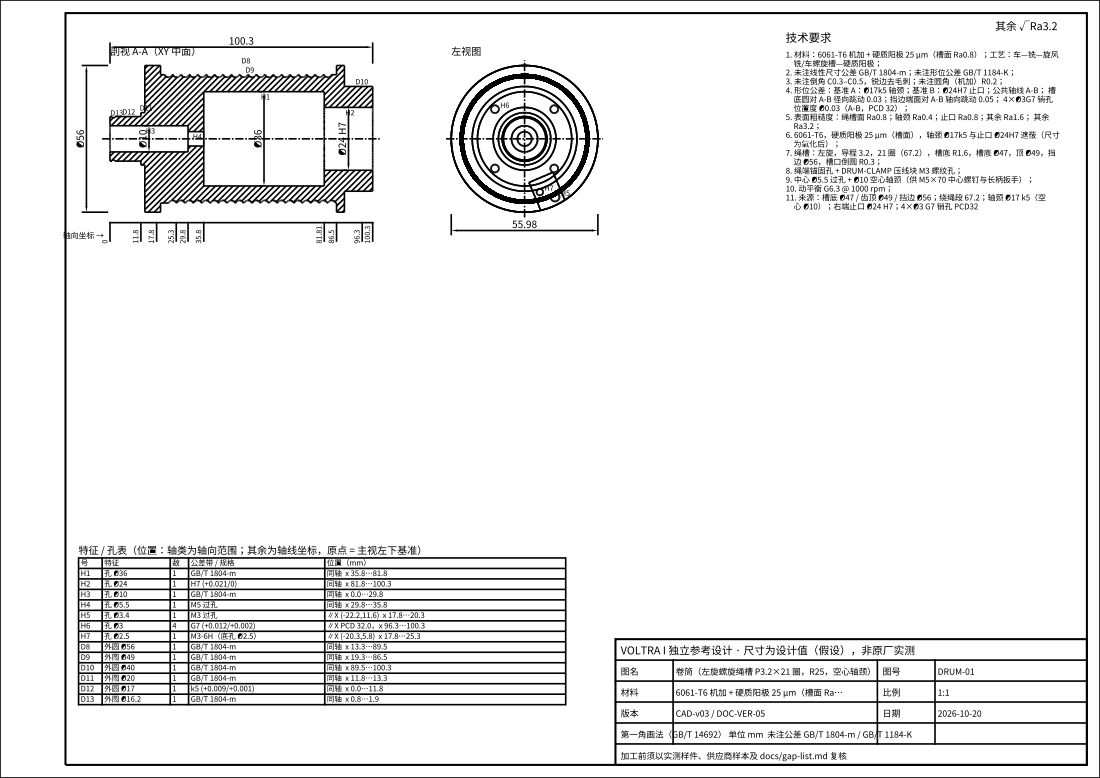
[picture p178: page 1]
