merlinwwu/voltra-i-ref-3d/downloads/drawings/DRUM-CLAMP-01.pdf

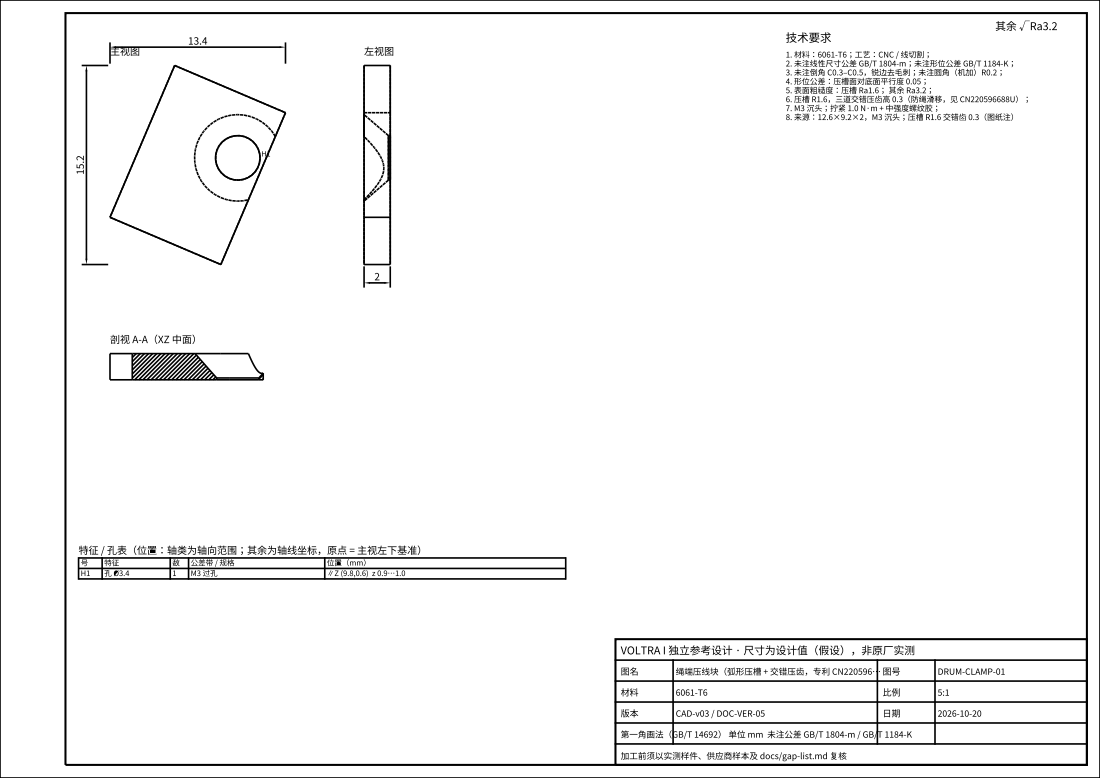
[picture p179: page 1]
