merlinwwu/voltra-i-ref-3d/downloads/drawings/DRUM-HUB-01.pdf

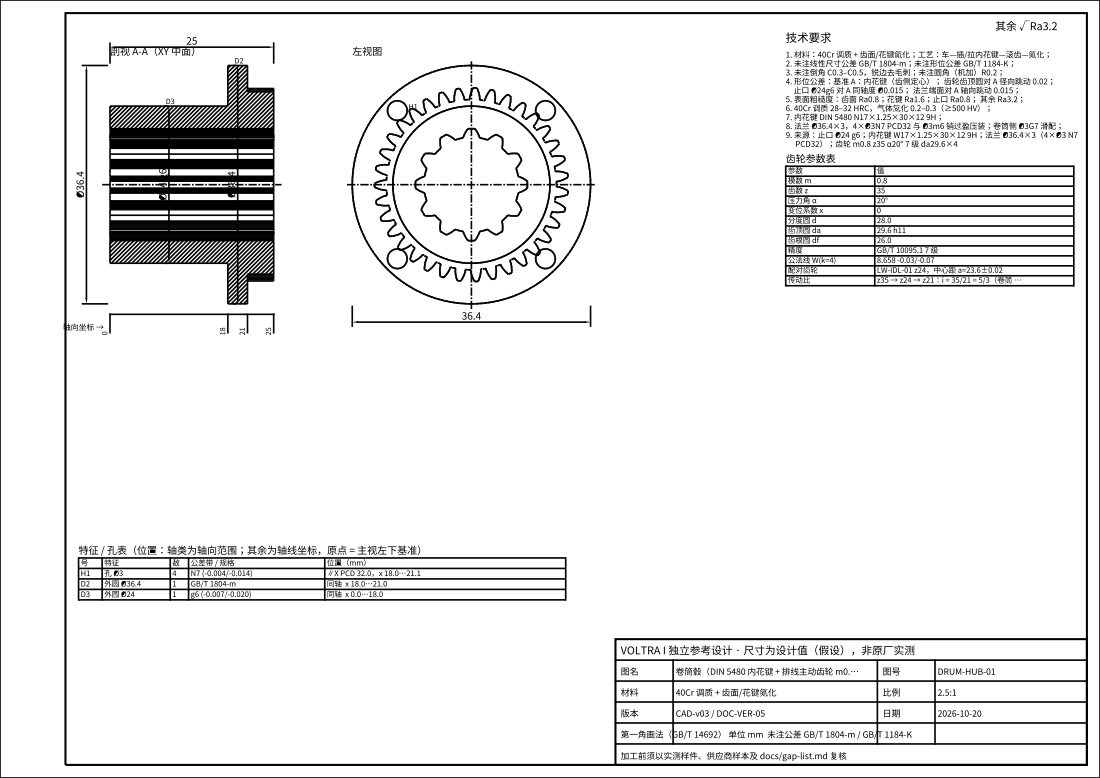
[picture p180: page 1]
