merlinwwu/voltra-i-ref-3d/downloads/drawings/EXIT-AXL-01.pdf

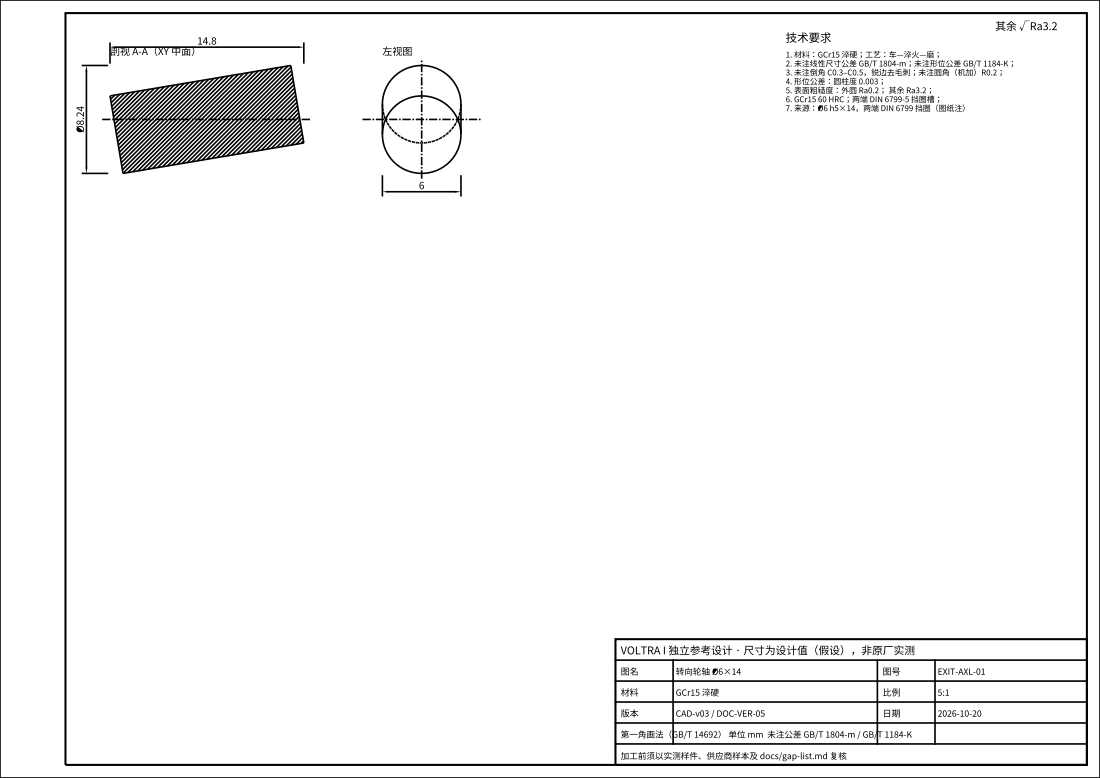
[picture p181: page 1]
