merlinwwu/voltra-i-ref-3d/downloads/drawings/EXIT-BASE-01.pdf

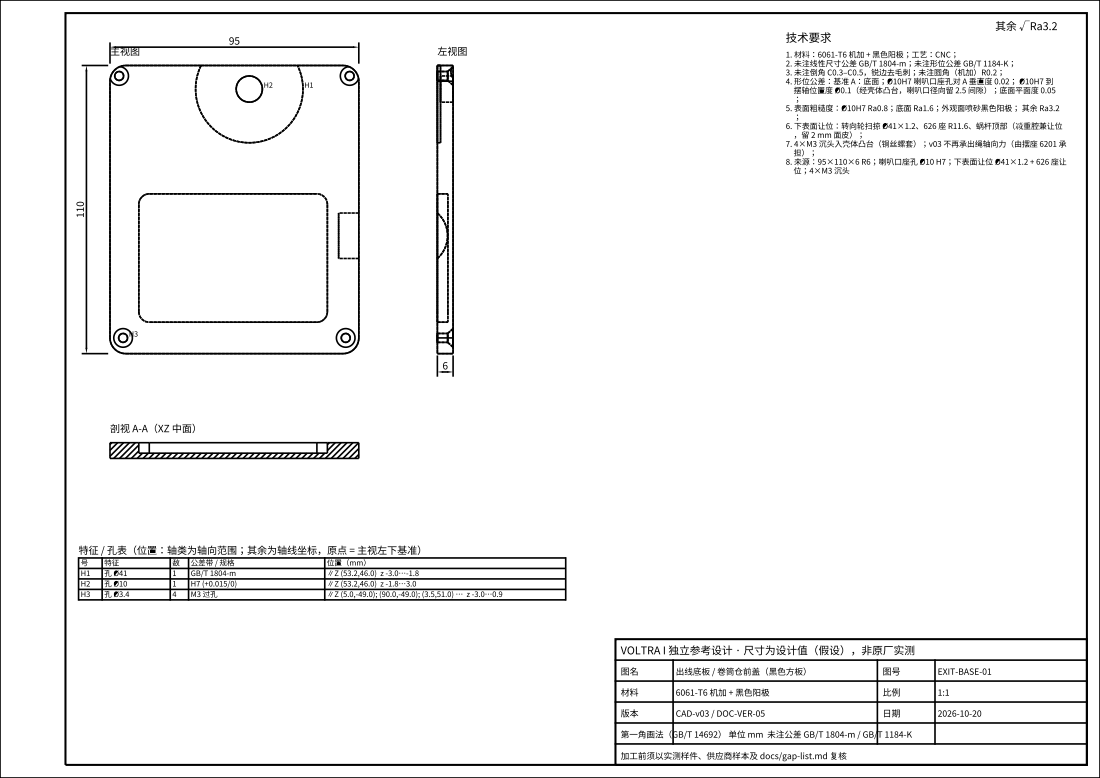
[picture p182: page 1]
