merlinwwu/voltra-i-ref-3d/downloads/drawings/EXIT-PIN-01.pdf

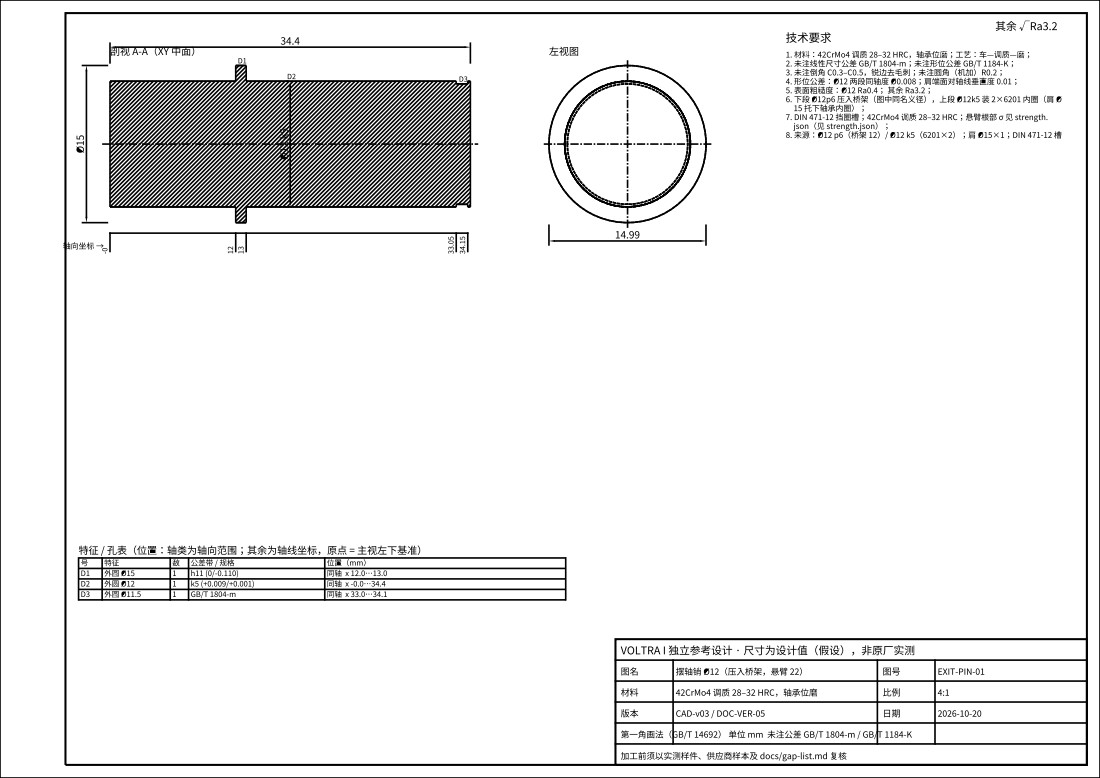
[picture p183: page 1]
