merlinwwu/voltra-i-ref-3d/downloads/drawings/EXIT-SHV-01.pdf

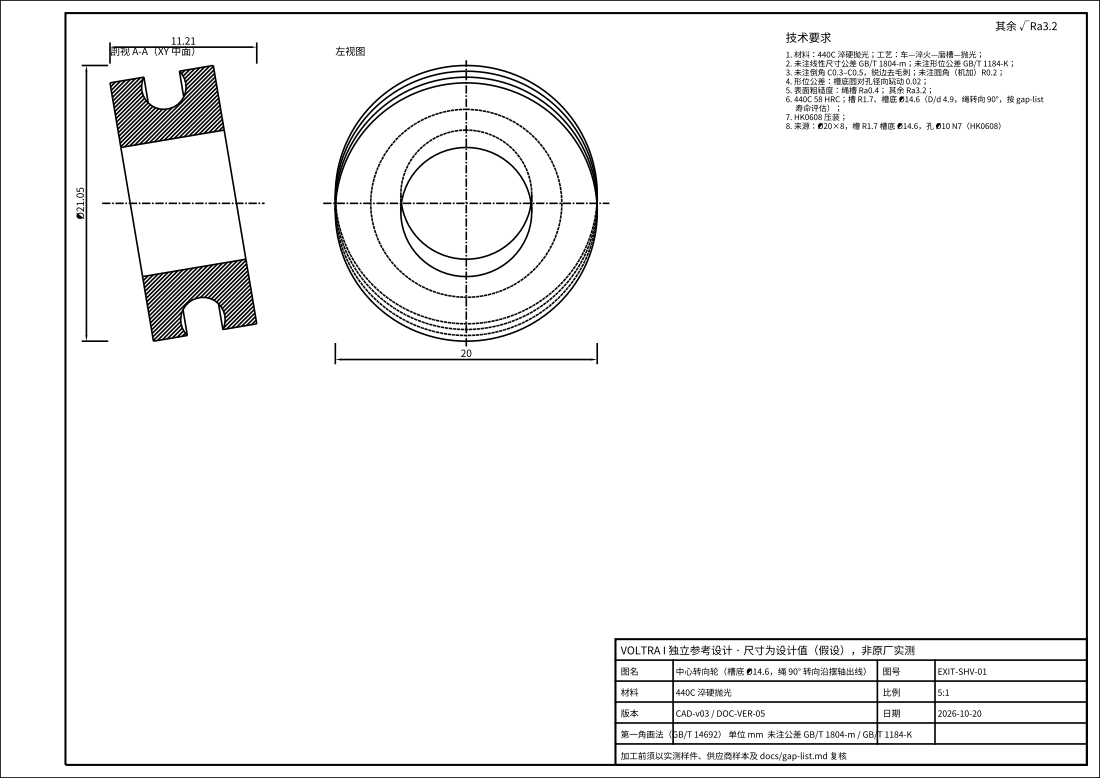
[picture p184: page 1]
