merlinwwu/voltra-i-ref-3d/downloads/drawings/EXIT-SWV-01.pdf

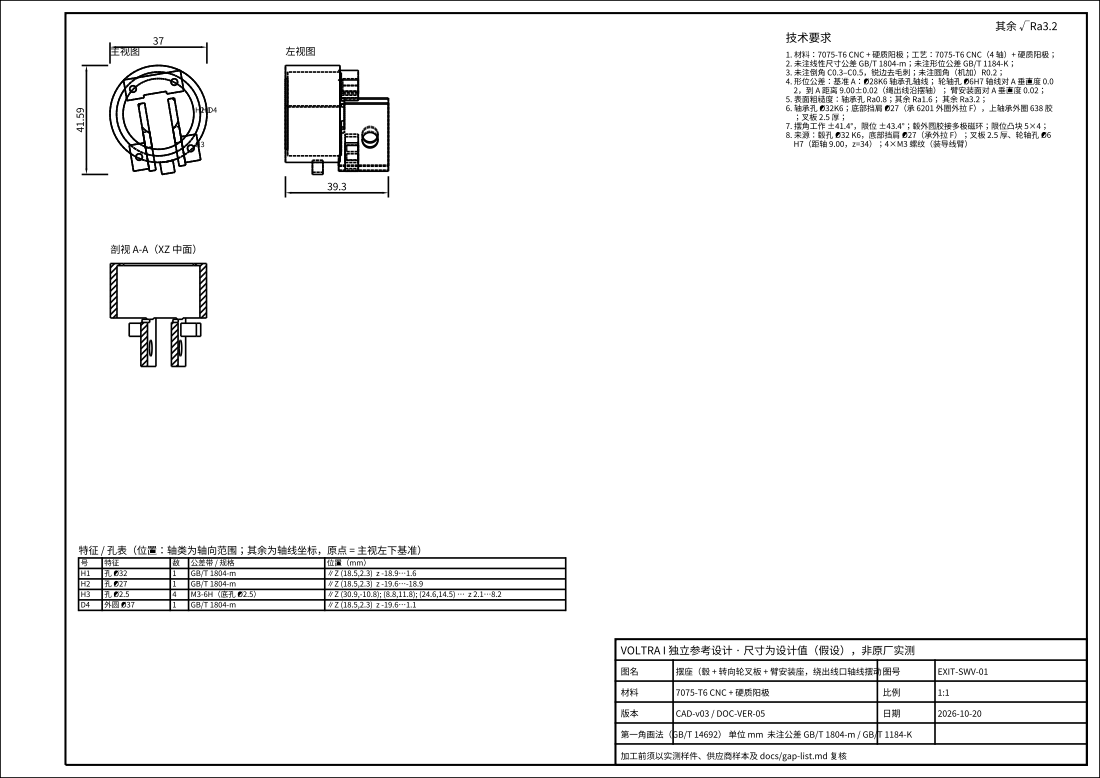
[picture p185: page 1]
