merlinwwu/voltra-i-ref-3d/downloads/drawings/EXIT-UNI-01.pdf

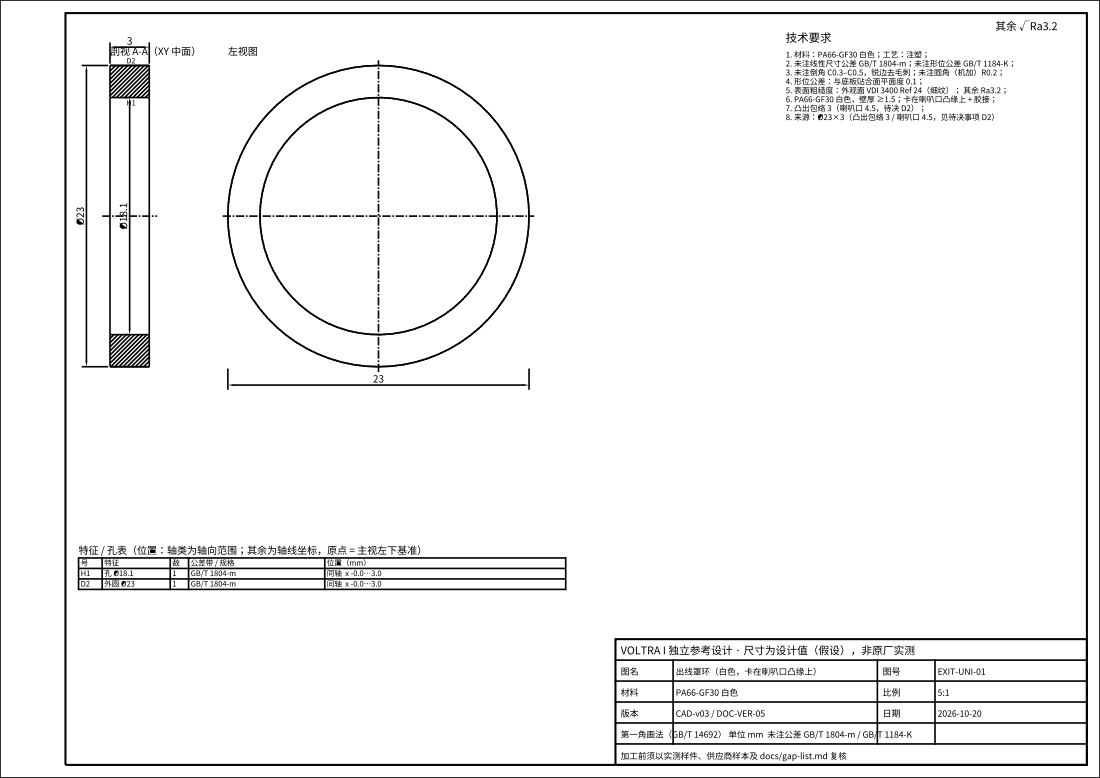
[picture p186: page 1]
