merlinwwu/voltra-i-ref-3d/downloads/drawings/HSG-END-L-01.pdf

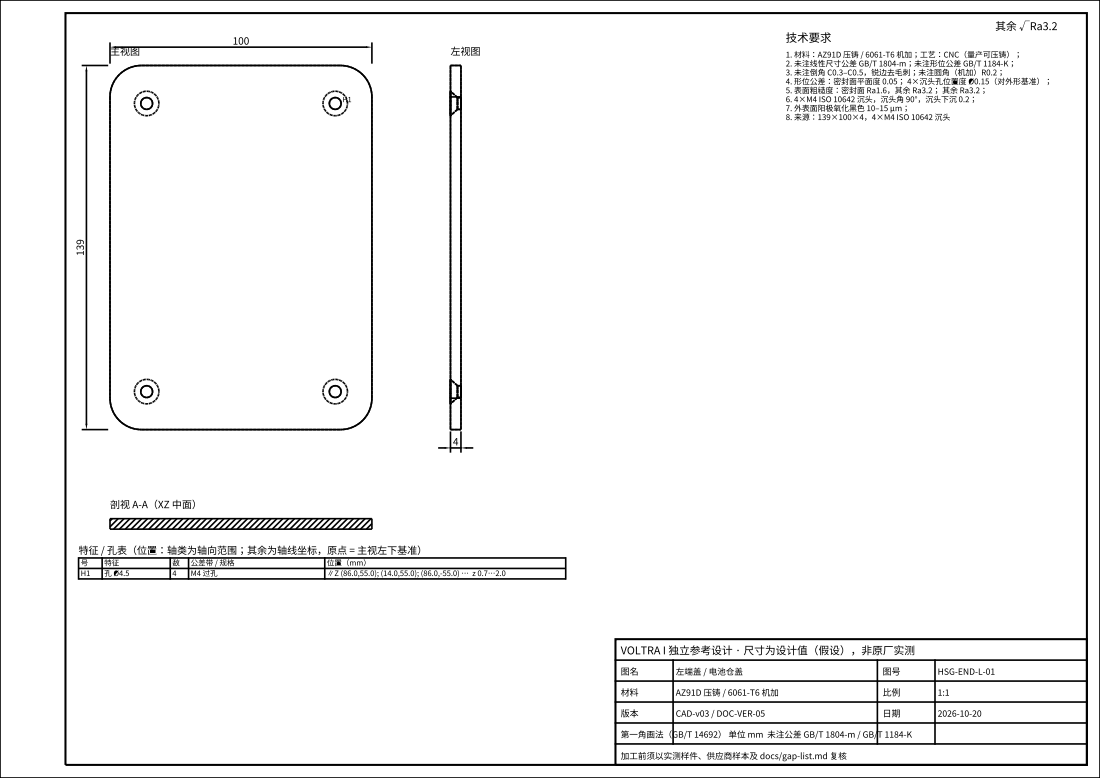
[picture p187: page 1]
