merlinwwu/voltra-i-ref-3d/downloads/drawings/HSG-END-R-01.pdf

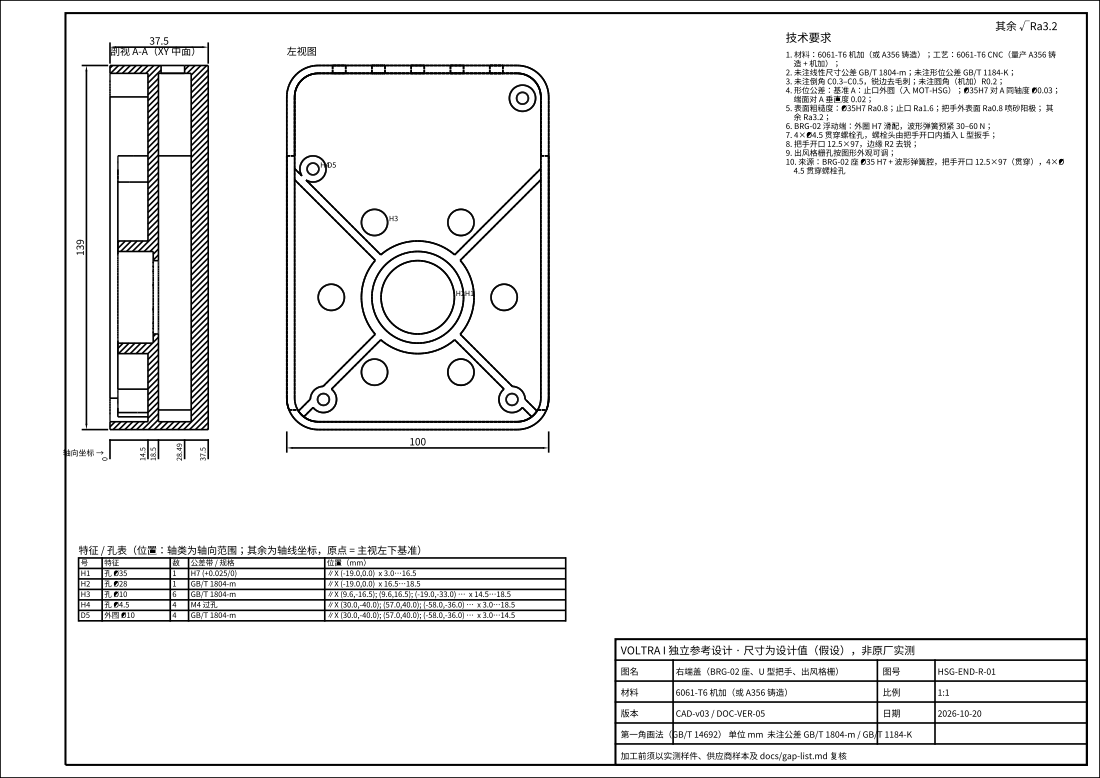
[picture p188: page 1]
