merlinwwu/voltra-i-ref-3d/downloads/drawings/HSG-FRAME-01.pdf

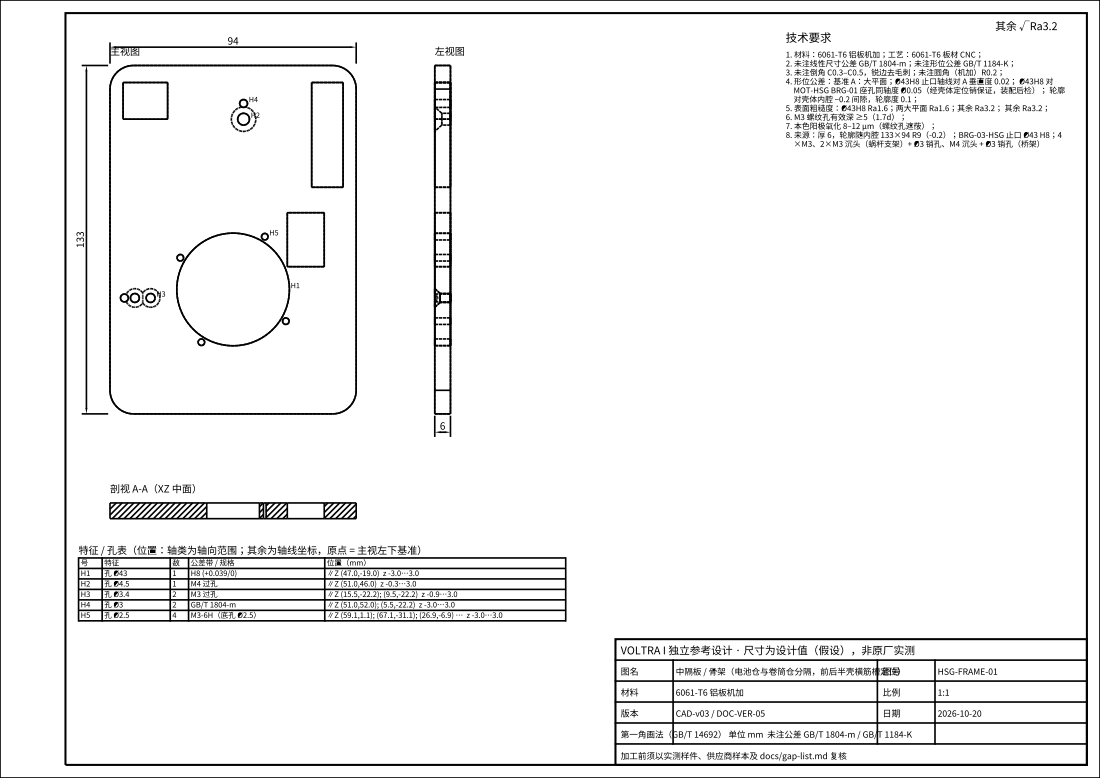
[picture p189: page 1]
