merlinwwu/voltra-i-ref-3d/downloads/drawings/HSG-MAIN-01-LWR.pdf

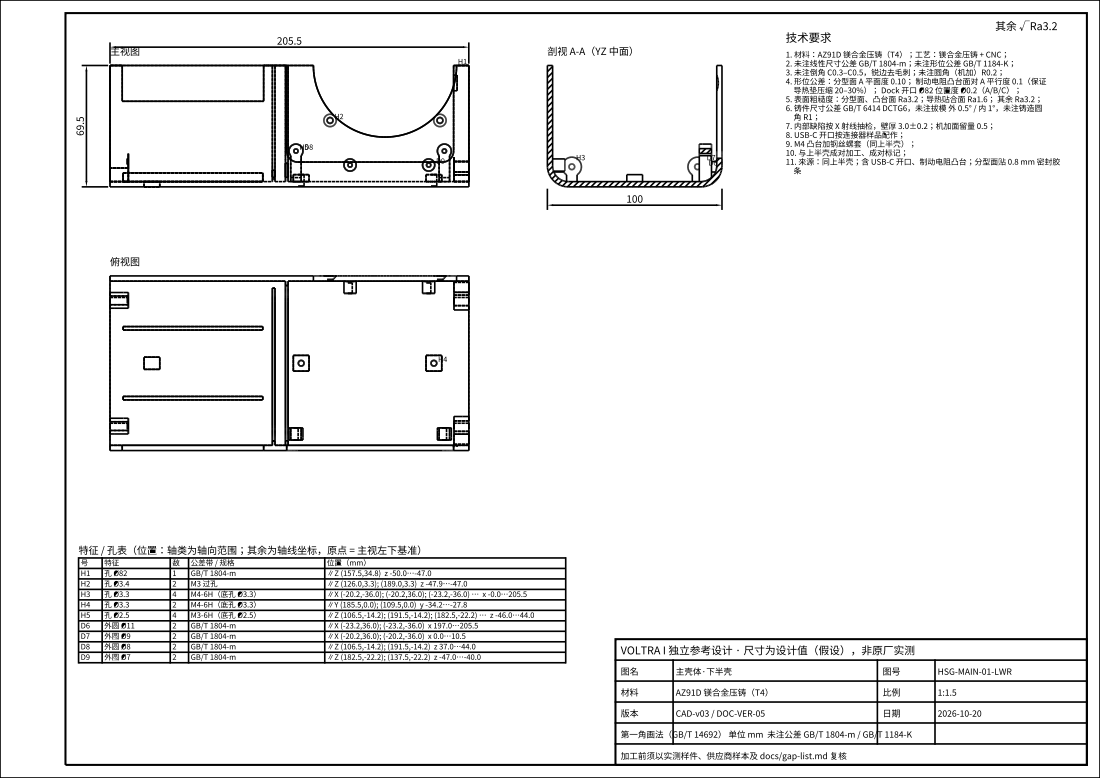
[picture p190: page 1]
