merlinwwu/voltra-i-ref-3d/downloads/drawings/HSG-MAIN-01-UPR.pdf

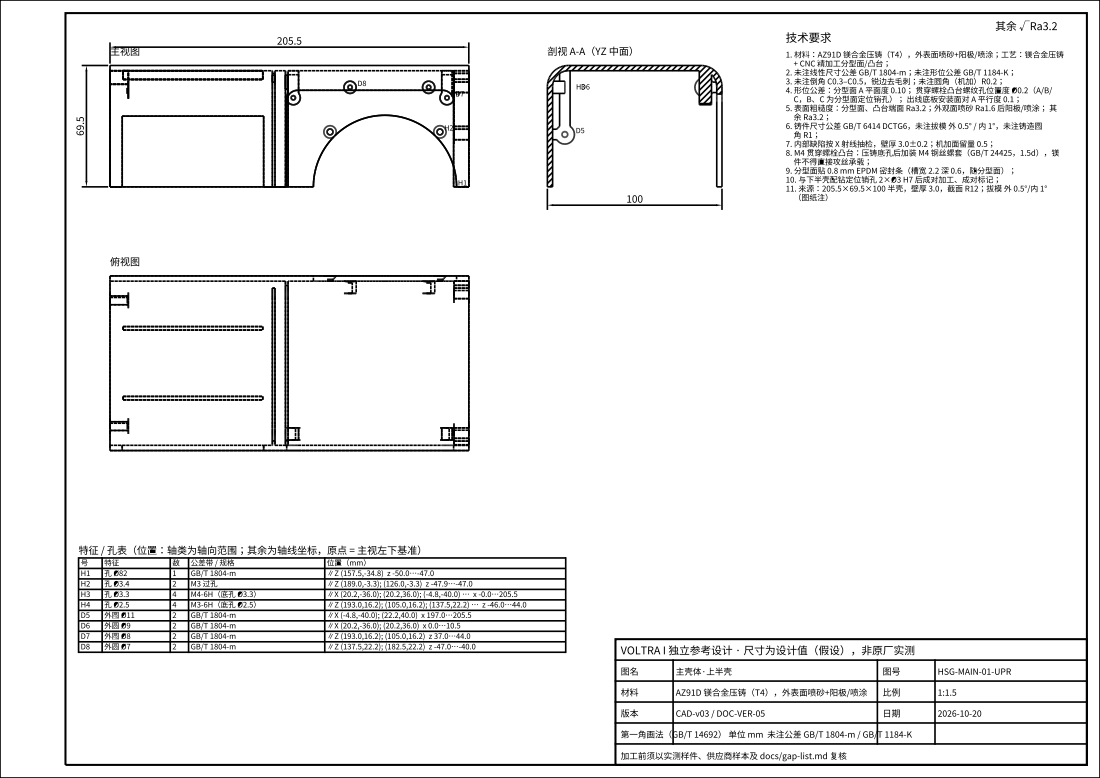
[picture p191: page 1]
