merlinwwu/voltra-i-ref-3d/downloads/drawings/LW-ARM-01.pdf

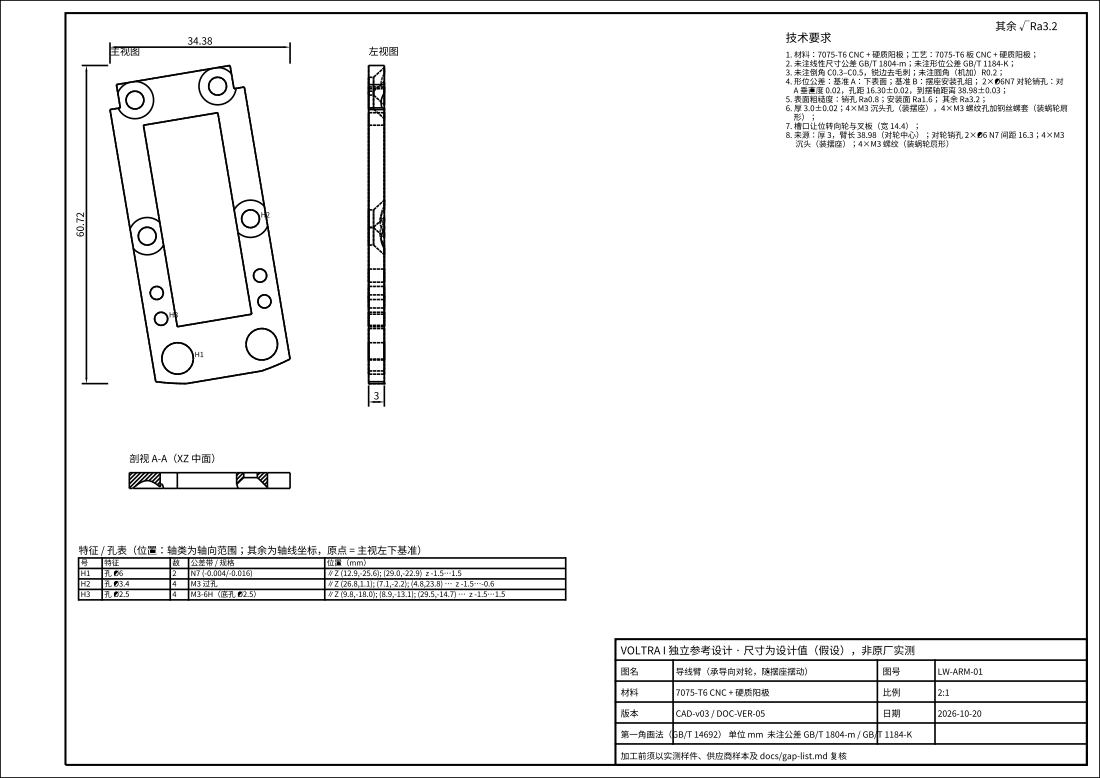
[picture p192: page 1]
