merlinwwu/voltra-i-ref-3d/downloads/drawings/LW-BOX-01.pdf

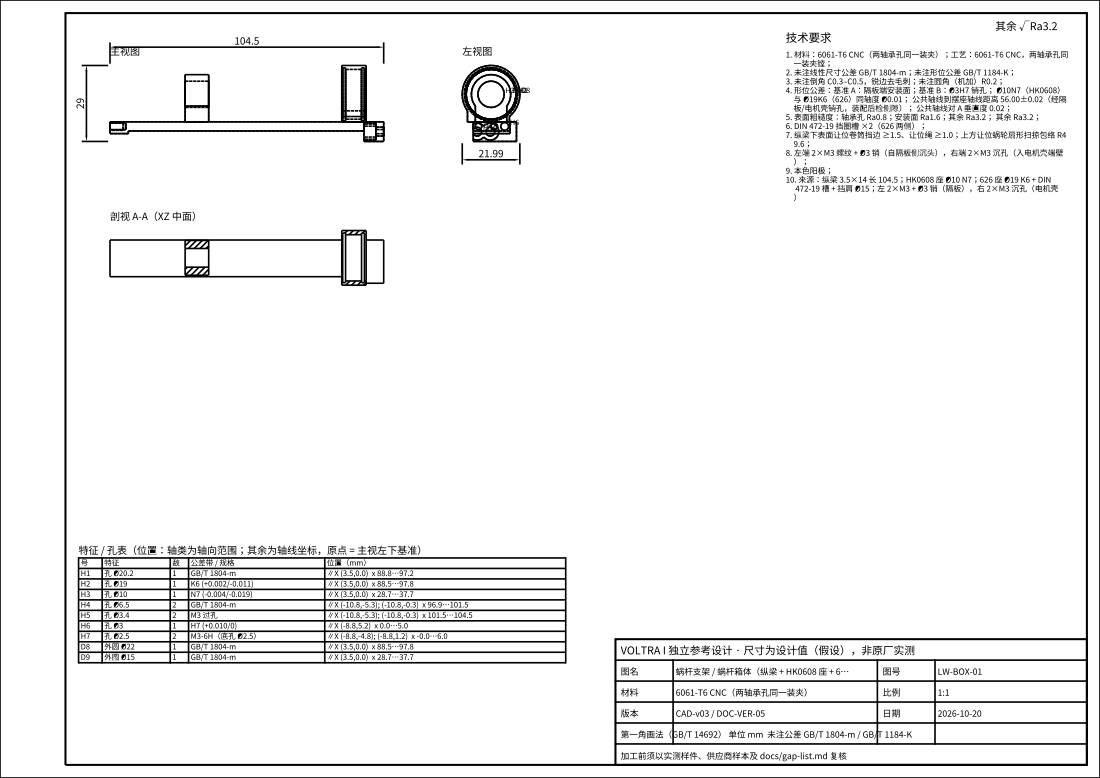
[picture p193: page 1]
