merlinwwu/voltra-i-ref-3d/downloads/drawings/LW-BRIDGE-01.pdf

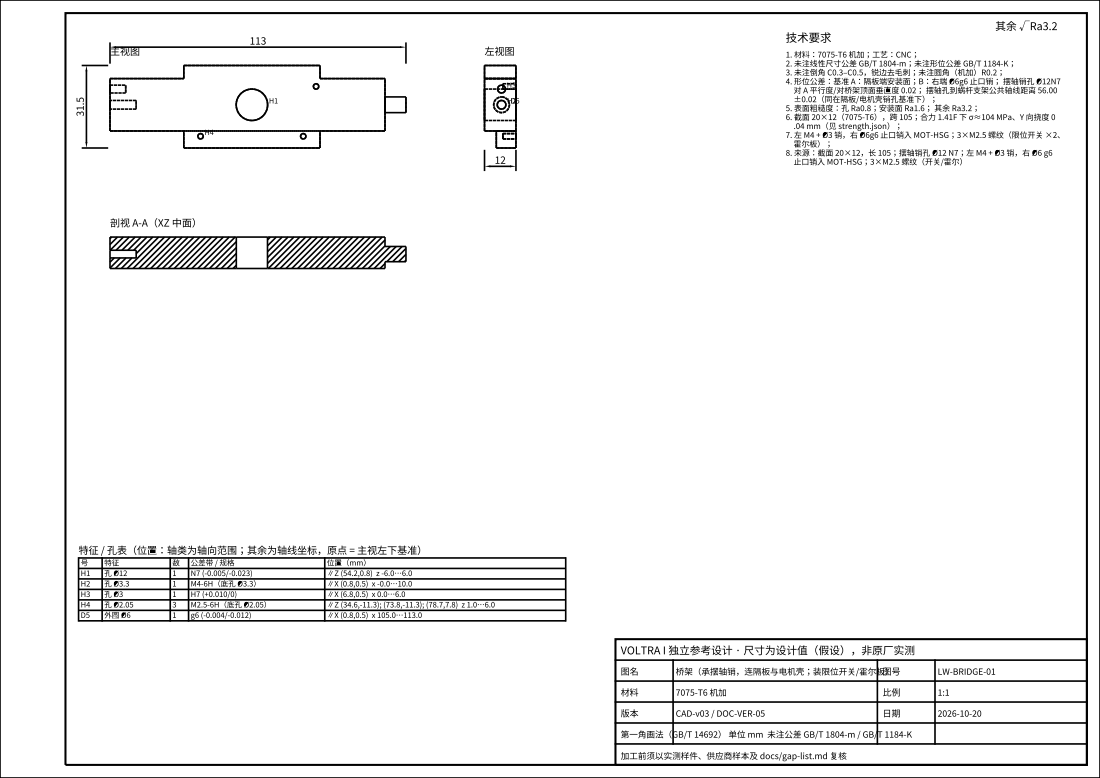
[picture p194: page 1]
