merlinwwu/voltra-i-ref-3d/downloads/drawings/LW-GEAR-01.pdf

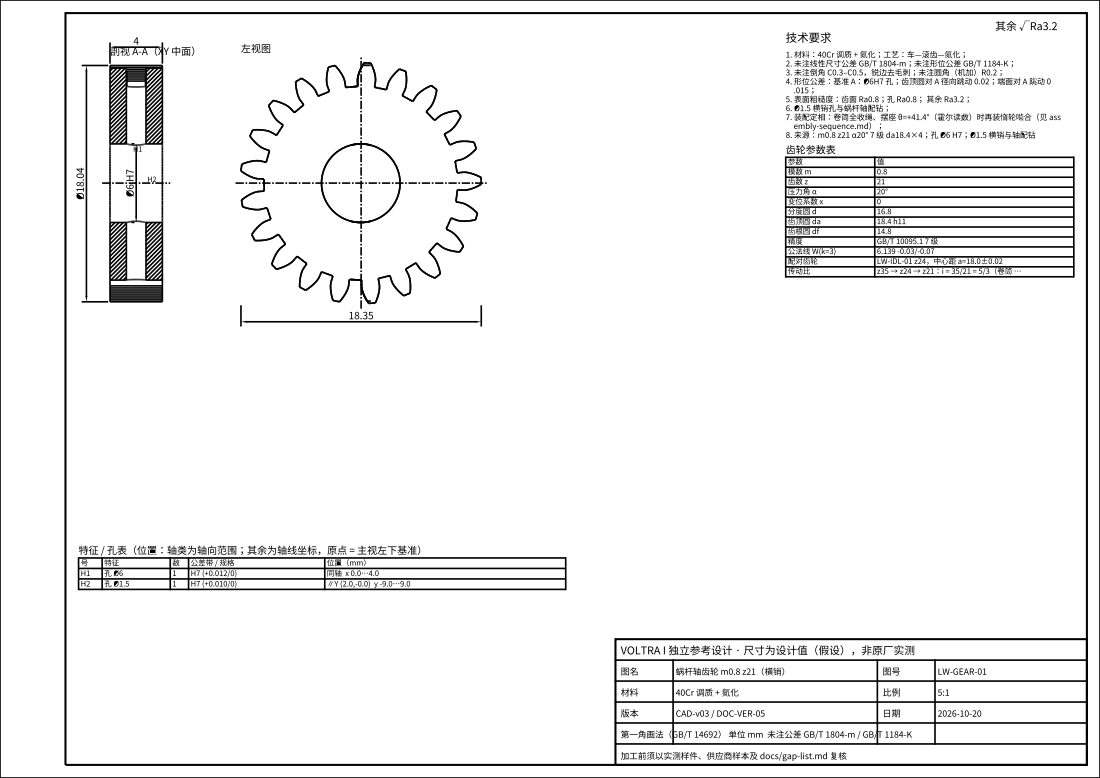
[picture p195: page 1]
