merlinwwu/voltra-i-ref-3d/downloads/drawings/LW-IDL-01.pdf

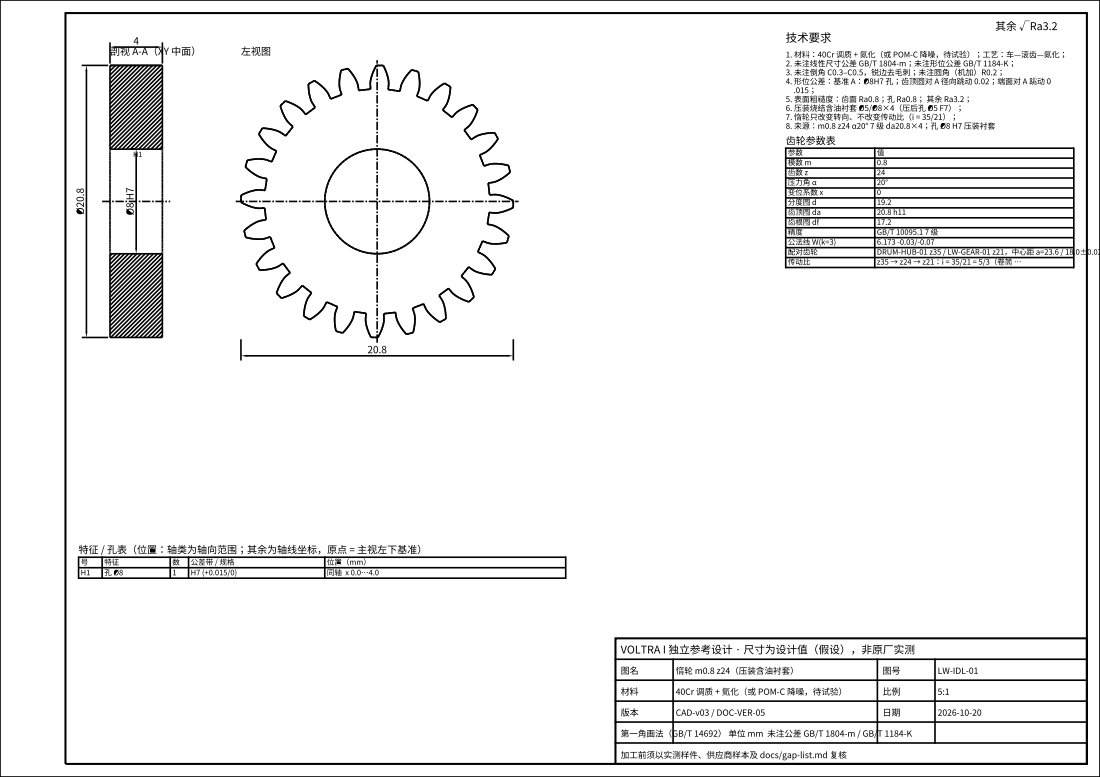
[picture p196: page 1]
