merlinwwu/voltra-i-ref-3d/downloads/drawings/LW-IDL-PIN-01.pdf

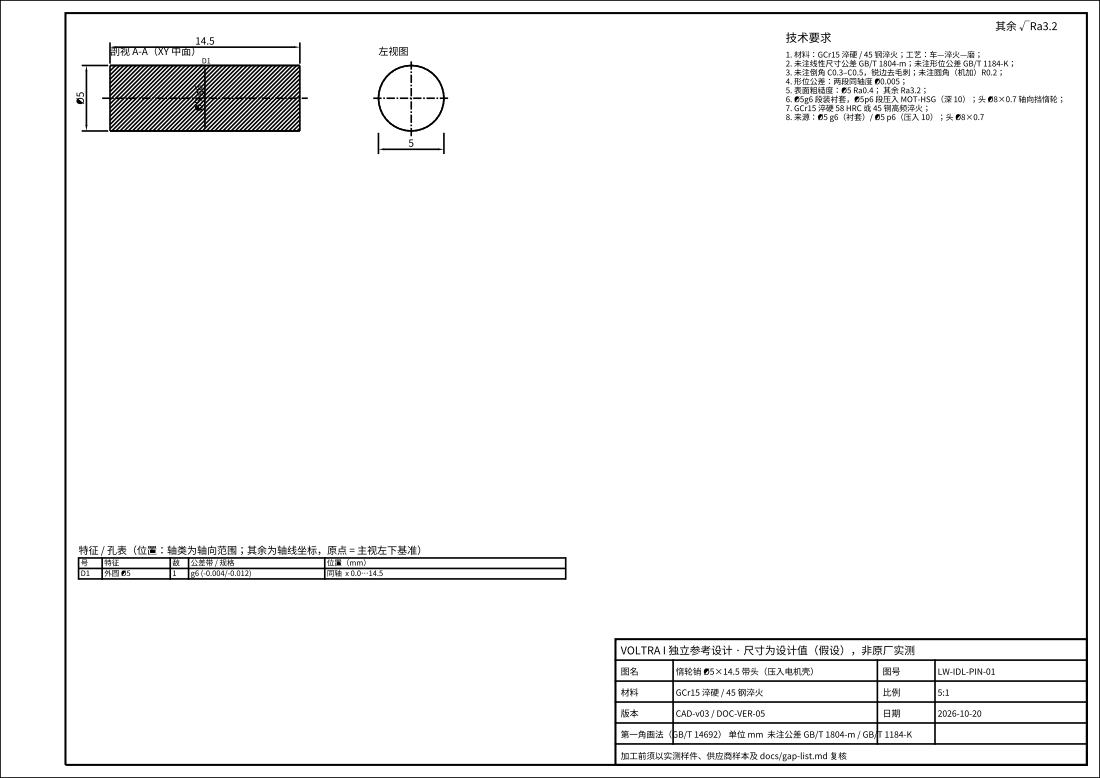
[picture p197: page 1]
