merlinwwu/voltra-i-ref-3d/downloads/drawings/LW-PIN-01.pdf

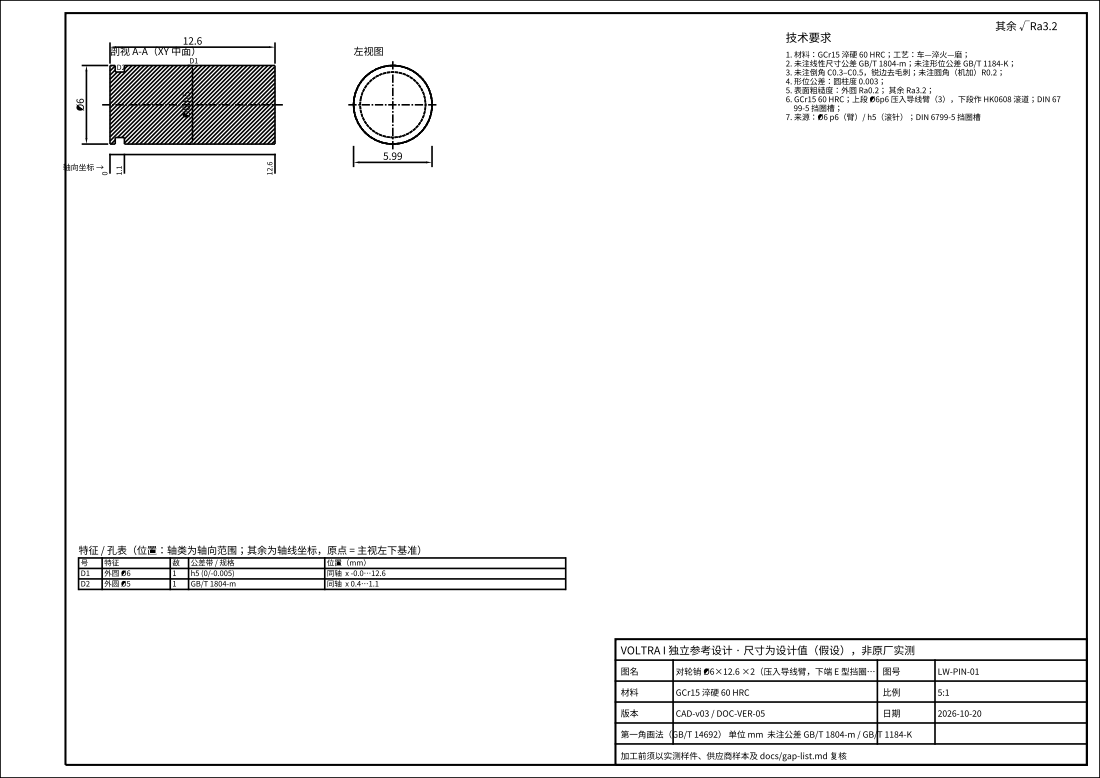
[picture p198: page 1]
