merlinwwu/voltra-i-ref-3d/downloads/drawings/LW-ROL-01.pdf

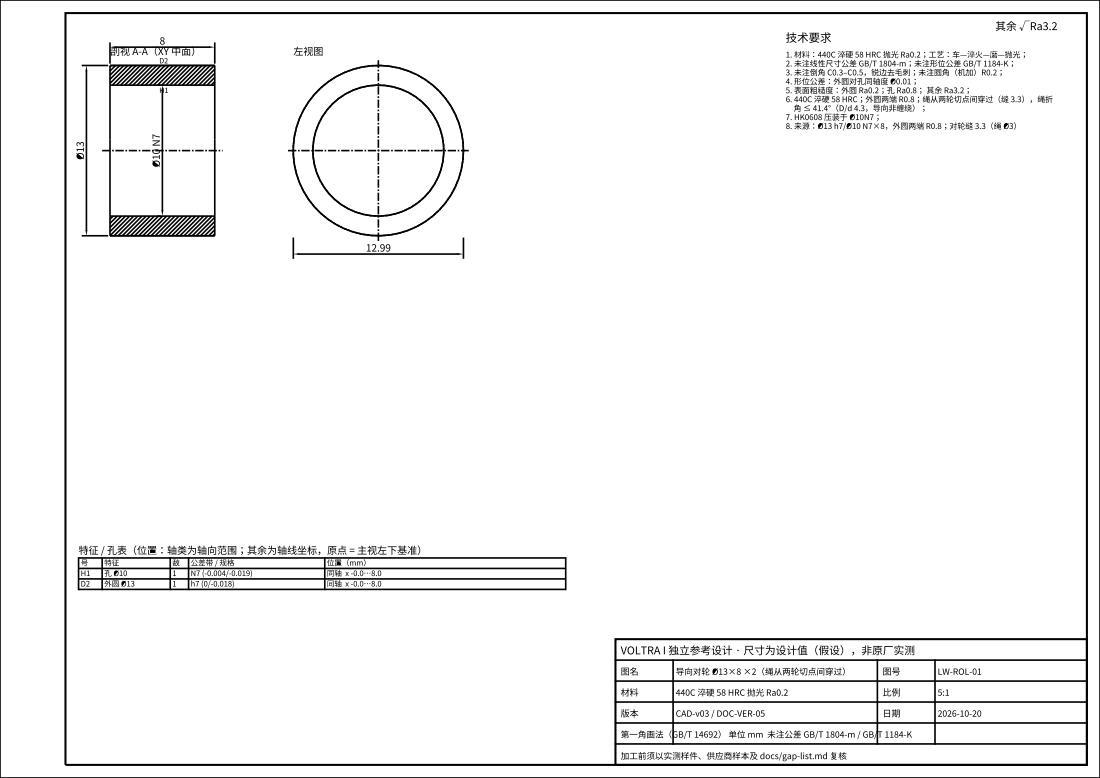
[picture p199: page 1]
