merlinwwu/voltra-i-ref-3d/downloads/drawings/LW-SPC-01.pdf

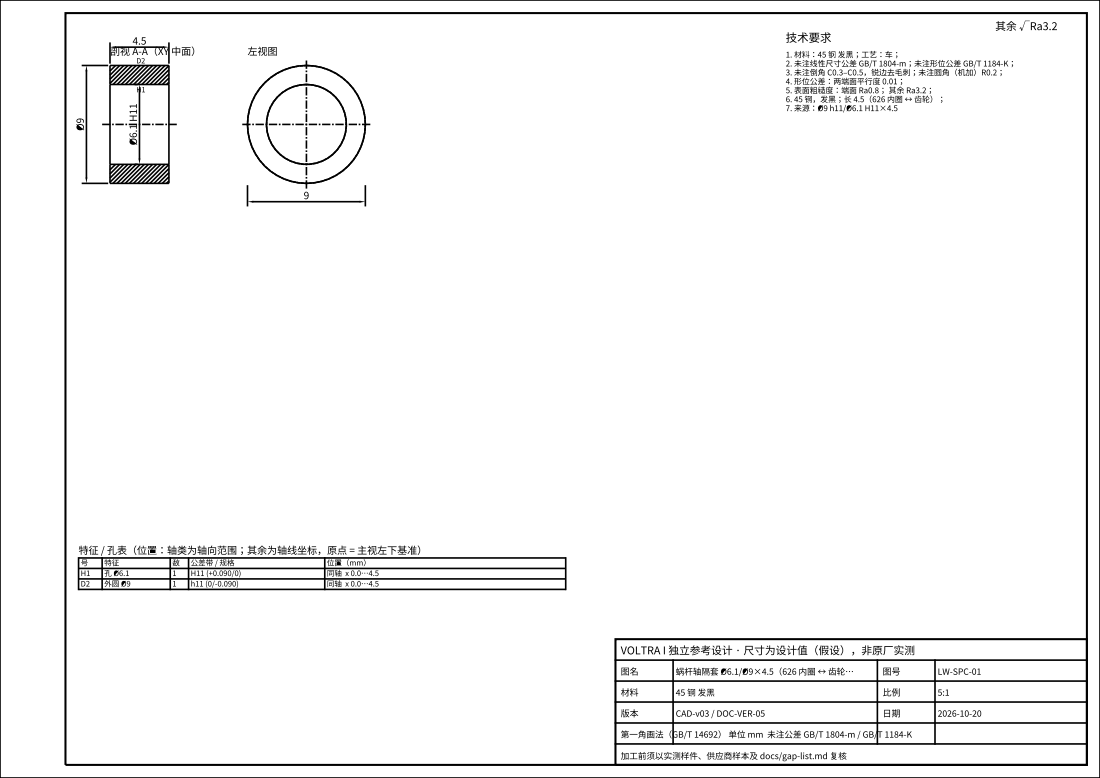
[picture p200: page 1]
