merlinwwu/voltra-i-ref-3d/downloads/drawings/LW-WHEEL-01.pdf

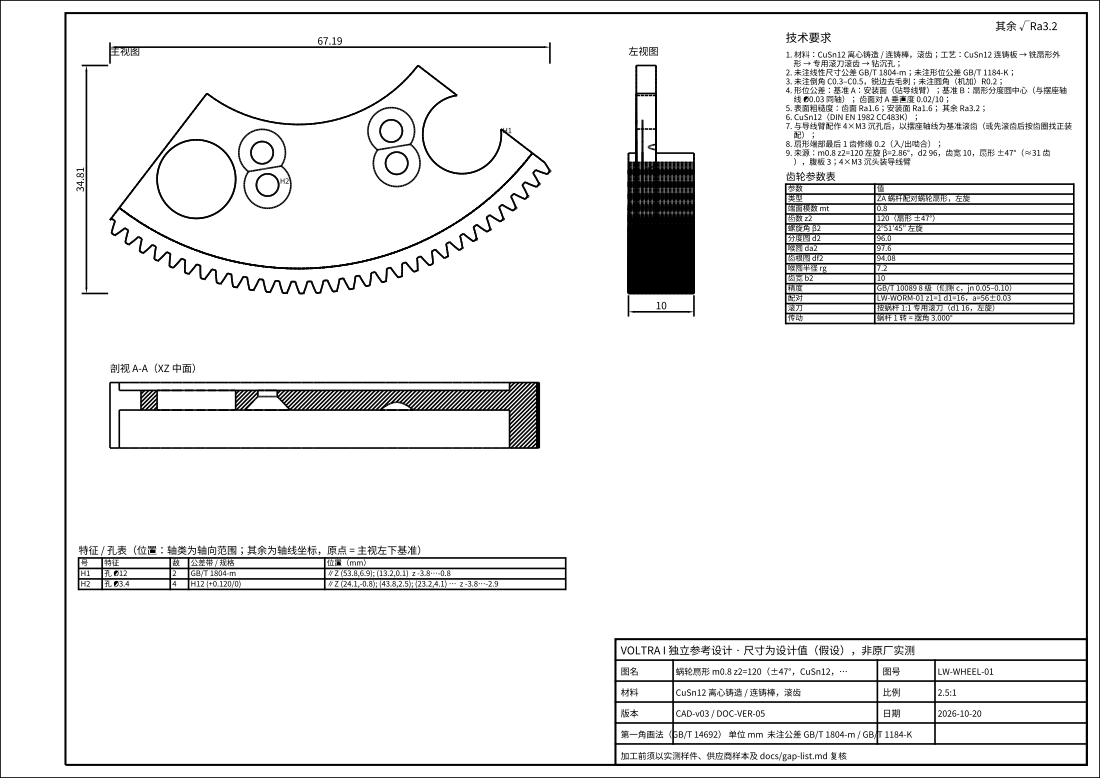
[picture p201: page 1]
