merlinwwu/voltra-i-ref-3d/downloads/drawings/LW-WORM-01.pdf

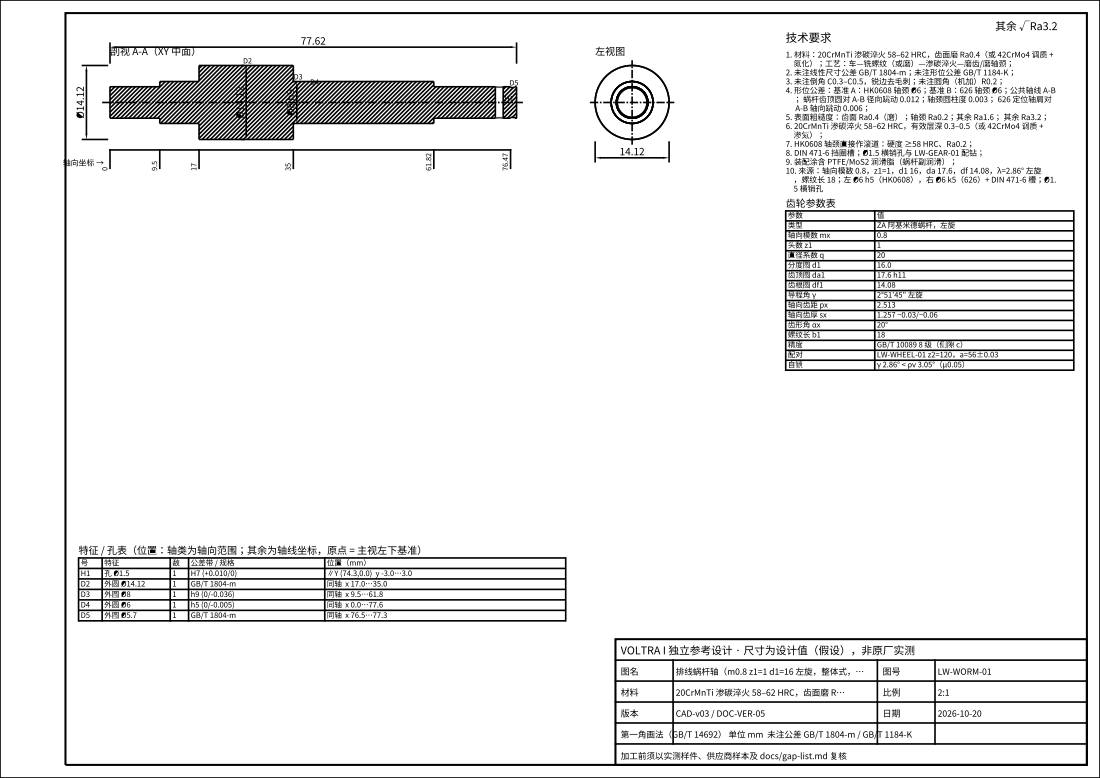
[picture p202: page 1]
