merlinwwu/voltra-i-ref-3d/downloads/drawings/MOT-HSG-01.pdf

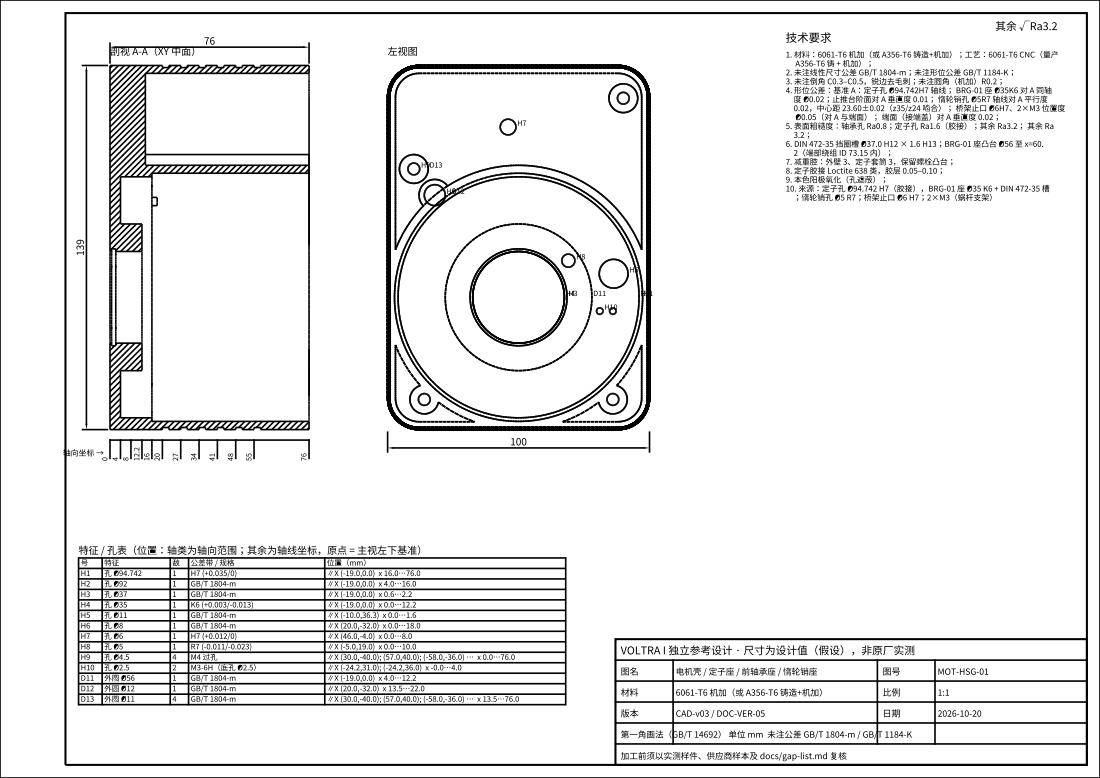
[picture p203: page 1]
