merlinwwu/voltra-i-ref-3d/downloads/drawings/MOT-SHAFT-01.pdf

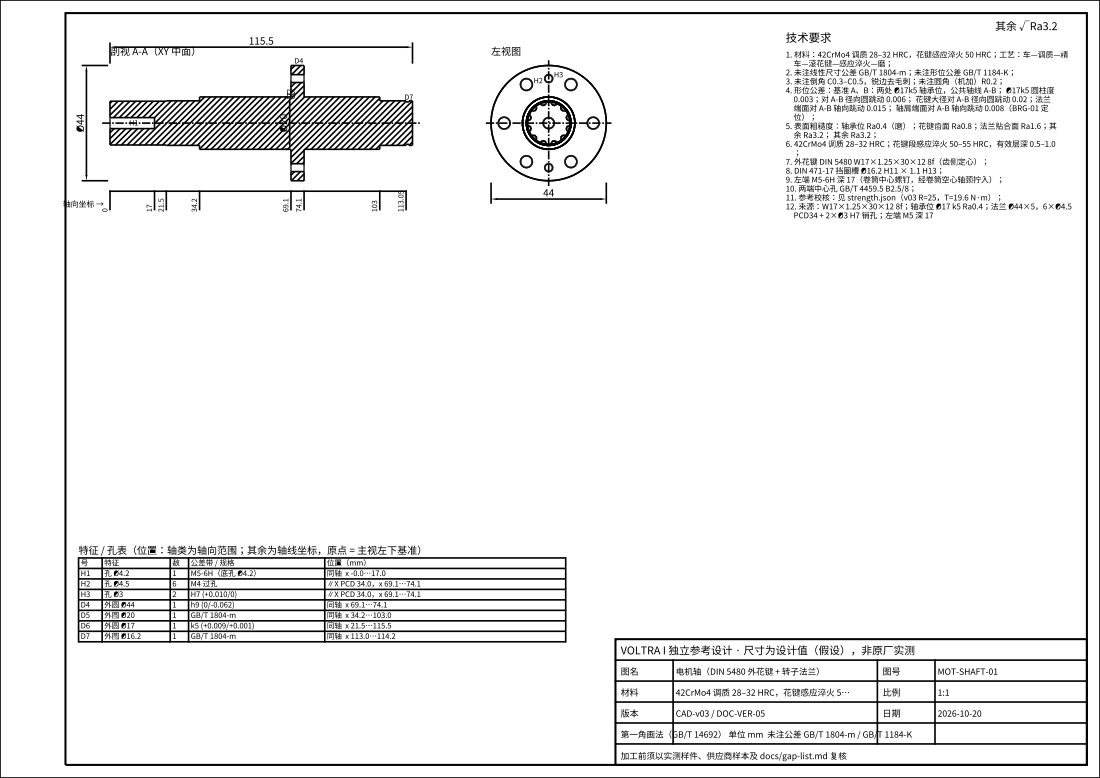
[picture p204: page 1]
