merlinwwu/voltra-i-ref-3d/downloads/drawings/PCB-HS-01.pdf

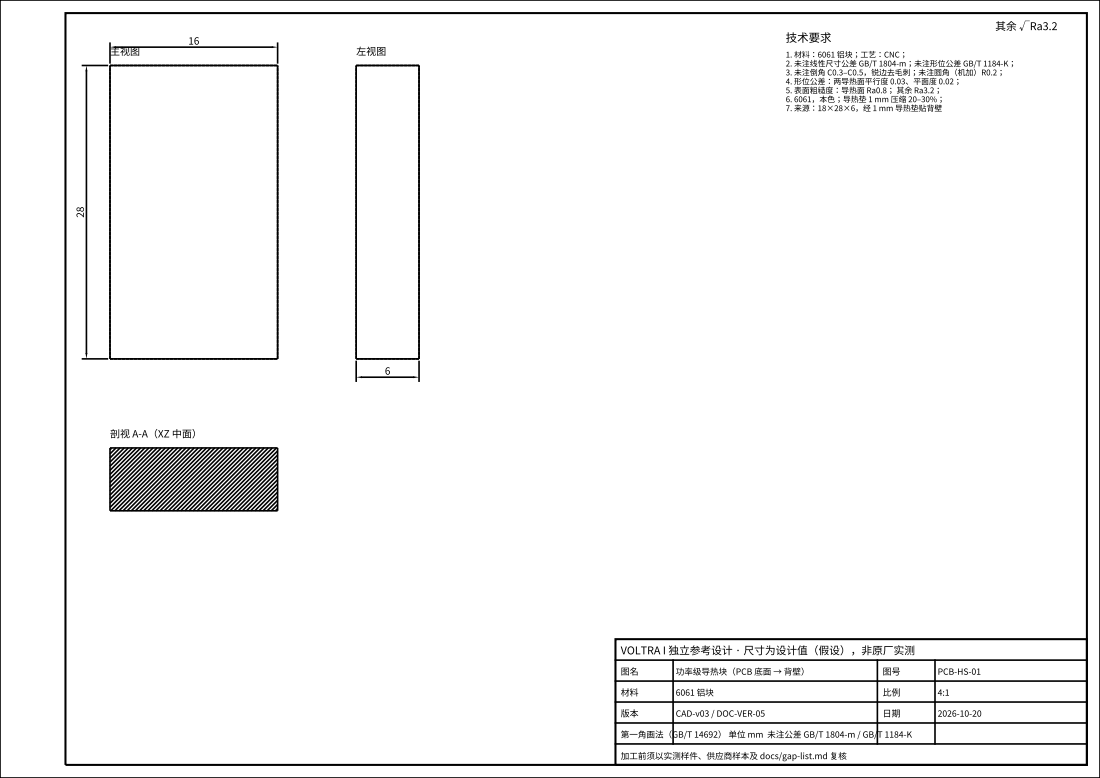
[picture p205: page 1]
