merlinwwu/voltra-i-ref-3d/downloads/drawings/ROT-HUB-01.pdf

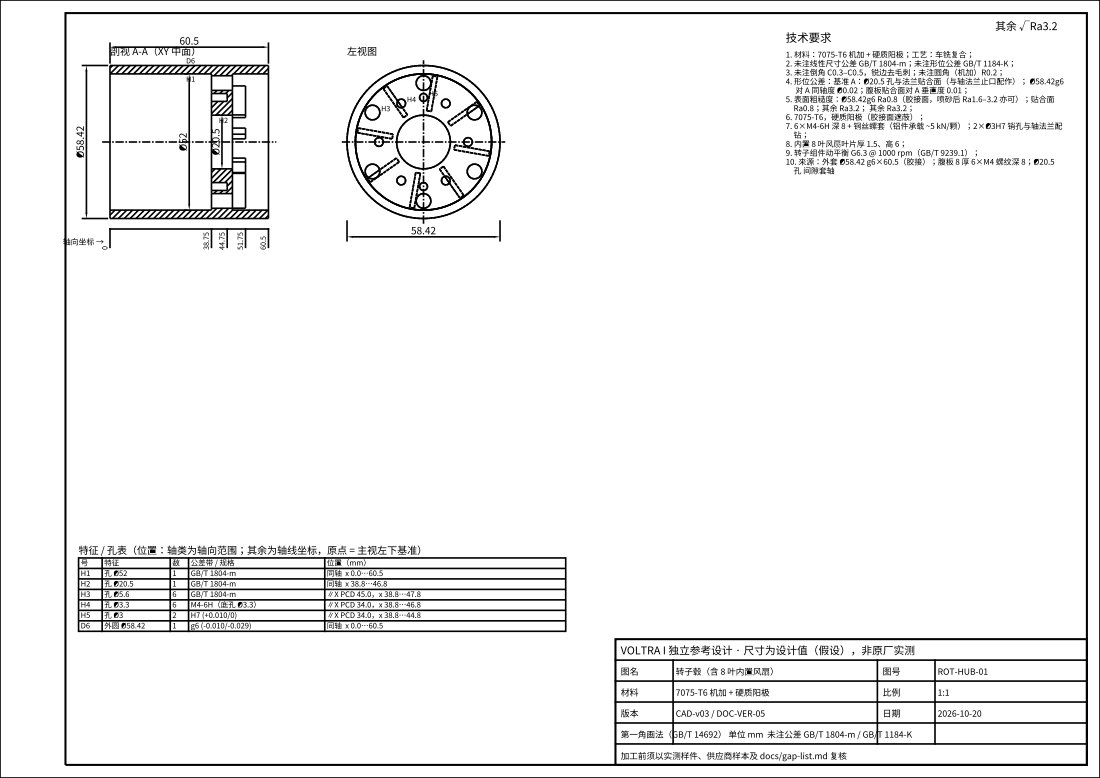
[picture p206: page 1]
