merlinwwu/voltra-i-ref-3d/downloads/drawings/SPC-BRG01.pdf

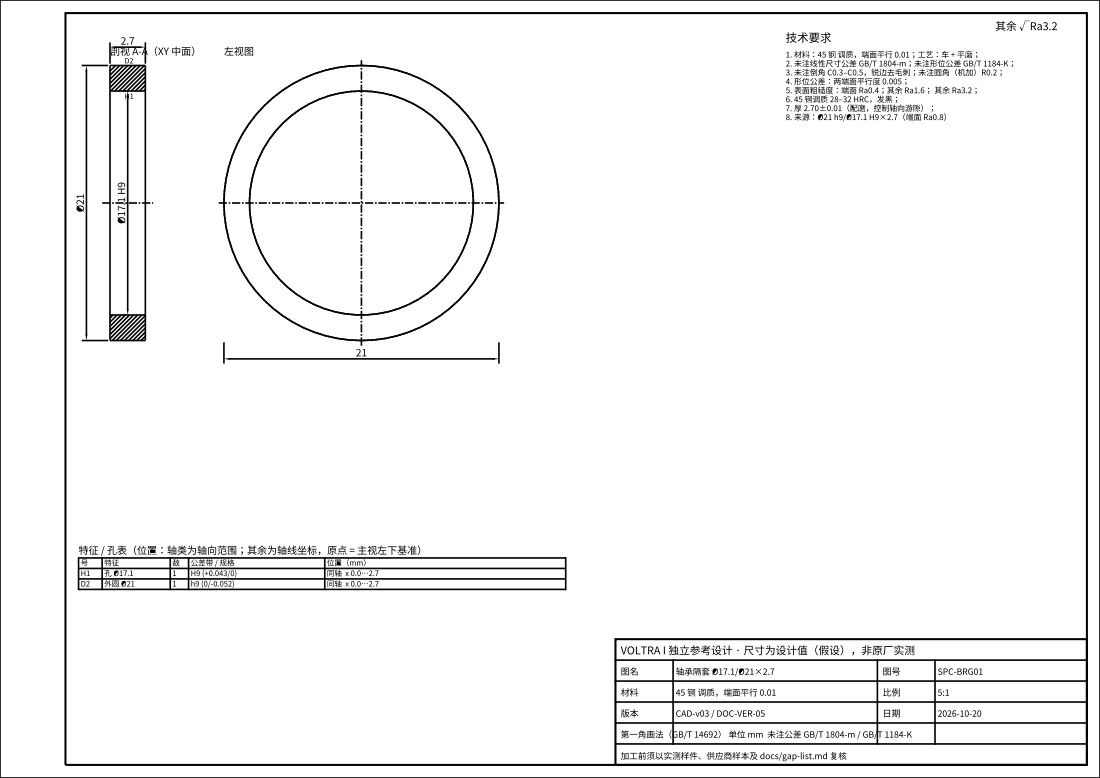
[picture p207: page 1]
