merlinwwu/voltra-i-ref-3d/(commit log)

2026-10-20 VOLTRA I ref design 3D viewer CAD-v01 (DOC-VER-03 r2)
    [BAT-CONN-01.step, BAT-CONN-01.stl, BAT-MOD-01.step, BAT-MOD-01.stl, BOLT-TIE-01.step, BOLT-TIE-01.stl, BOM_VOLTRA-I-REF_CAD-v01.csv, BRG-01.step]
2026-10-20 CAD-v02 / DOC-VER-04: patent review, sliding level-wind, full drawings (36 sheets), assembly sequence, v02 BOM
    [ASSY-01-A.dxf, ASSY-01-B.dxf, ASSY-01-BOM-1.dxf, ASSY-01-BOM-2.dxf, BAT-CONN-01.step, BAT-CONN-01.stl, BAT-MOD-01.step, BOLT-TIE-01.step]
2026-10-20 CAD-v03 / DOC-VER-05: self-locking worm + swinging worm-wheel level-wind (R25, MF0095056), full drawings (40 sheets), interference/motion 0 unexpected, strength 58 checks FAIL 0
    [ASSY-01-A.dxf, ASSY-01-B.dxf, ASSY-01-BOM-1.dxf, ASSY-01-BOM-2.dxf, ASSY-01-BOM-3.dxf, BAT-CONN-01.step, BAT-MOD-01.step, BOLT-TIE-01.step]
